Ryan365Apps/spotify-knob/design/Inspo/moodboard/README.md

# Moodboard — aesthetic references (2026-09-01)

What each reference contributes is captured in `../VISION.md` → "Aesthetic direction".

## In this folder ✔

| File | Reference | What it contributes |
|---|---|---|
| `kef-ls50-wireless-ii.jpg` | KEF LS50 Wireless II, mineral white ([source](https://www.richersounds.com/kef-ls50-wireless-ii-mineral-white/)) | Concentric machined ribs radiating from a circle (→ underside / speaker aperture); circle-in-a-box reads hi-fi, not gadget; luminous copper accent on mono body |
| `totem-machined-caps.jpg` | Totem Automobili GT Super — knurled machined reservoir caps ([source](https://totemautomobili.com/gt-super)) | The knurl + engraved-function attitude: machined jewellery that is all function-shapes. Closest stand-in for the pasted central-lock shot |
| `totem-steering-hub.jpg` | Totem GT Super — machined steering hub + gauges | Castellated/radial machining on a circular hub (→ top trim ring option) |
| `totem-gt-super-rear.jpg` | Totem GT Super rear, deep blue over black ([source](https://www.carscoops.com/2025/03/totems-alfa-romeo-gt-super-restomod-has-a-twin-turbo-670-hp-v6/)) | Restomod attitude: dark mass, minimal graphics, circular red lamp rings = luminous accent on monochrome body |
| `knurling-closeup.jpg`, `knurling-examples.jpg` | Knurling reference photos (Wikimedia Commons, free licence) | Diamond knurl pitch/depth reference for the knob's grip band |
| `saab-900-restomod.png` | Matt-black Saab 900 turbo restomod render, front + rear ("ETW" watermark) | **The attitude anchor.** Matt black mass, minimal graphics, one continuous red light bar = the halo ring, wrapped into a circle |
| `watch-chunky-bevel.png` | Skeleton watch, drilled chunky bezel, rose-gold dial accents | The wide 45° chamfer between texture and glass; drilled/castellated function-shapes; luminous warm accent on black |

## Still to drop in (originals not findable online — likely Instagram/AI renders)

| File | Reference | What it contributes |
|---|---|---|
| `knurled-thumb-nut.jpg` | Knurled aluminium thread protector (Amazon listing) | The knob's diamond knurl — watch-bezel coarseness, grip without aggression |
| `blue-spiral-puck.jpg` | Round-display desk gadget, blue anodise, spiral fluting | Proof of the round-screen-in-metal-ring form — and a warning: fluting + colour reads toy; we go knurl + monochrome |
| `watch-knurled-bezel.jpg` | Skeleton watch, knurled/clous-de-Paris bezel | Bezel texture + rose-gold accents living against matt black |
| `totem-alfa-central-lock.jpg` | Totem central-lock with Alfa badge (their Instagram) | Castellated radial machining; the exact "machined knob" hero shot |
