Ryan365Apps/spotify-knob/docs/v16/the60_v16/docs/V16-SPECIFICATION.md

# the 60 — version 16 specification

**Status: as-built specification for the v16 CAD.** This document describes every component and mechanism the v15 model contains, says which numbers are measured and which are assumed, grades every requirement, and separates what is true of the v10/v11 prototype only (Raspberry Pi 5) from what carries to production.

Revision: 8 September 2026 — **v16 = v15 plus the extra 5 mm of radius (Ø185.4, the rim 25 flat), bought V-groove bearings on a male V-ridge in the bore with the third wheel on a spring-loaded block (no eccentric bushes; the knob is fitted 2.4 off-centre and slid home), the halo as `HALO-OPTICS.md` (a 4 mm strip face down at a white floor behind a 3.9 mm machined opal ring standing 2 proud), a printed drive collar on the bell (the bell would otherwise cross the halo channel), the motion board replaced by bought breakouts on the plate and an ESP32-S3-Zero-class microcontroller on a tray over the audio board, every board on countersunk M2 studs from below with nuts above (Ryan's rule), the Pi powered through its header, the small parts of `SMALL-PARTS-SOURCING.md` (panel jack, Adafruit light-sensor breakout in a 56-wide port slot, Mill-Max spring-pin block, MT6701 module, Pololu converter), and the plate's ribs deleted.** v15 = v14 plus **the v15 brief** (`DESIGN-CHANGES.md` items 1–6, `THERMAL-PLAN.md` rules 5/7/8/10/11 as rewritten) and Ryan's rulings of 6 September: the plate re-proportioned to 2 web / 5 duct / 1 closing plate on piers; fins 5 tall; the stainless rim ring with 92 obround openings into an underside groove; **the blower fitted as a required part** (Delta BFB0305HA-C on the plate, the motion board on its saddle, a hood and a trench into the rear exhaust groove); the internal structure printed inverted on its flat seat, with dowel pins, a separate encoder shim and the bleed foot flat. Height unchanged. v14 = v13 plus **the design-changes list** (`the60-design-changes.md`): Pico-Lock connectors at 2.0 mm, the core's internal faces bare, the grounding features (chassis bond, rim-ring bond screw, motor bond lead, the knob's 1 MΩ bleed, the USB-C shell wire, the port face stated as an insulator), the halo current from the strip as built, the plain rim edge with the intake grooves opened to 514 mm², the vibration actuator's pogo-pin board and the rotor sensor lead's service loop. v13 was v12 plus **the encoder facing up at a code ring on the crown's underside** (Ryan, 6 Sep): no code band on the bore, no tower, the bell band back to its full contact, the wheels straight above it, the seat set by the adapter's HDMI socket at 26.0, height 35.9. v12 was v11 plus Ryan's deck-less layout: no mezzanine deck, every board on the plate, the display adapter's driver board on the Pi's standoffs, the code band and the wheels dropped to the bell band's limit, the seat 2.4 lower. Two facts from the adapter's datasheet (fetched this revision) are folded in: its holes are the Pi's 58 × 49 pattern, and the adapter is three parts (driver board, 150 mm flat cable, display connect board) — v10 and v11 wrongly had the panel flex reaching the driver board. Superseded text has been removed, not struck through. The v11 to v14 documents stay in `docs/v11/` to `docs/v14/` as delivered.

Tags, as in v9:

- **MEASURED** — taken from a CAD file by measuring it.
- **PUBLISHED** — stated by the manufacturer but not modelled here.
- **ASSUMED** — a number somebody chose. Reasonable or not, it is unverified.
- **GAP** — something the design needs that nothing currently provides.
- **v10-ONLY** — true of the desk prototype, not of the product. **PRODUCTION** — carries to the product.
- **MUST / SHOULD / COULD** — as v9.

---

## 0. What was measured for v10, and the three findings that shape it

New vendor files, now in `design/cad/bought-parts/vendor/`: the DisplayModule DM-TFTR50-413 panel STEP and datasheet, the Raspberry Pi 5 STEP and mechanical drawing, the Raspberry Pi Active Cooler product brief, the Raspberry Pi Compute Module 5 datasheet. Parts still **without a CAD body** (Ryan's rule: nothing is laid out around a part without one): the Active Cooler, the DisplayModule HDMI-to-DSI adapter board, the barrel jack, the internal HDMI ribbon cable and its plugs, the 12 V-to-5 V converter board, the cover lens, and the three boards the 60 makes (audio, motion, power). Each is drawn as a named `_ENVELOPE` body until its file exists.

**Finding 1 — the panel is not a circle, and that sets the diameter.** The DM-TFTR50-413 glass is a Ø132.2 disc with a **driver chin** at one edge: a 31.0 mm wide flat extension whose corners sit at **r 72.05 from the picture centre** (MEASURED from the STEP: the outline's furthest points are (±15.52, −70.36)). The knob rotates around the fixed panel, so the knob's bore must clear r 72.05 at every angle. With 0.45 mm clearance the bore is **Ø145.0**, and with the v9 knob wall of 4.5 mm the knob would be Ø154 (not Ø150; Ø150 needs an internal undercut, question 1, not recommended). **Ryan's ruling, 6 Sep: the knob's top must be a flat rim of at least 20 mm**, so the outside is set by the rim, not the wall; **8 Sep: the rim is 25** (the layout study: the plate needed the room, the display is fixed, so the whole 5 goes into the bezel): lip edge r 64.2 + 1.0 inner chamfer + 25.0 flat + 2.5 outer chamfer = **r 92.7, Ø185.4**. **This specification is written for Ø185.4**; the halo band stands 2.0 proud of it (Ø189.4). The top ring is 28.5 mm of metal, 29.2 mm from the picture edge to the knob edge.

**Finding 2 (v10) — superseded in v12.** v10 found that the Pi 5, the display adapter and the motor sector could not share one floor inside a Ø145 bore and built a mezzanine deck. Two things changed: the bore is Ø166.4 (finding 1), and the adapter's datasheet shows its mounting holes are the Pi's own 58 × 49 pattern, so **the driver board stands on the Pi on standoffs** and needs no floor of its own. v12 is **one level** (Ryan, 6 Sep): everything bolts to the plate; the adapter is the one part off that plane, on the Pi.

**Finding 3 (v10) — what still holds.** The Pi's tallest features are its stacked USB-A sockets at 16.2 above the board (MEASURED) and standing the Pi through a window in the plate is what removes height. **The cooler's fan is not fitted**; in v12 the adapter's underside is 1.2 mm over the heatsink's fins, so a fan has no room at all — the first print measures the passive Pi (section 6.9). **What sets v13's height is the adapter's HDMI socket** (23.68 + 0.3 + the 2.0 seat flange = 26.0). In v12 it was the wheels: their groove had to sit above the code band on the bore, and the code band above the bell band's contact zone, which starts at the knob skirt's bottom (14.9, over the halo's lip) — seat 28.0. With the code ring on the crown's underside the groove only has to clear the band, which would allow 24.2. Seat 26.0, knob top 34.4 — 4.8 below v11 (section 8.3).

---

## 1. What v10 is for

v10 is a printable object that lives on Ryan's desk while the software is written. It must hold the real DM-TFTR50-413 panel, a real Raspberry Pi 5 with its Active Cooler, the real knob mechanism from v9 (MY-3514C motor on its carriage, three 623ZZ wheels, AGFRC servo, AEDR-8300 encoder, LRA (linear resonant actuator, the click motor), speaker, halo), plug into a wall socket and into a PC by cable, and come apart again. It is not the product: the product runs a Compute Module 5 on a custom carrier, and every dimension that exists only to hold a full Pi 5, its cooler, the HDMI adapter and their cables is tagged v10-ONLY.

The first v10 print must prove (Ryan, brief): every part fits; everything can be secured; the knob turns; the Pi's heat has somewhere to go; the cables reach without fouling the mechanism.

---

## 2. Frame of reference and standing rules

**Coordinates.** Millimetres. **z** is height above the underside of the steel base plate; the rubber pad is below zero. **r** is radius from the picture centre. Azimuth is anticlockwise seen from above; **0° is the rear centre of the base, where the three sockets are, facing away from the user.**

**Standing rules carried from v9 unchanged:** the knob clears every static part by at least 0.40; running clearances 0.30; static fits 0.15; minimum printed wall 1.6; no overhang beyond 45° on a functional surface; M2.5 heat-set inserts; no glue but the pad; everything re-openable; connectors, never solder, between assemblies; every dimension in one parameter block, every number tagged; every check automated; the checker proves the assembly order. The part determines the design: nothing is laid out around a part that has no CAD body.

**Withdrawn by the v10 brief:** the 40 mm height limit (height is derived, section 8); the Ø135 diameter limit; the halo brightness cap.

---

## 3. The object — requirements in force

| Requirement | Value | Grade | Origin |
|---|---|---|---|
| Diameter | **Ø185.4** knob and plate (Ø189.4 at the halo band): the outside is set by the 25 mm top rim (Ryan, 8 Sep: the extra 5 mm bought the plate its room); Ø150 was the nominal and is not reached | MUST (ruling) | brief; 6 Sep; 8 Sep |
| Height | derived: **35.9** v13 with the pad (knob top 34.4; v12 37.9, v11 40.7); **34.1** production with the CM5 (the wheels' floor); the stack and what decides it are in section 8 | report | brief |
| Mass | more is better; the three-piece plate ≈ 498 g (steel rim ring 334 g at the largest radius) — see 4.16 | SHOULD | brief; 4.16 |
| Knob | one piece, no seam or screw; the majority of the visible side (v10: 62 % — the 5.5 mm halo band and the 8 mm plate both come out of the knob); diamond knurl; wide smooth 45° chamfer at the top outer edge; small smooth chamfer at the lens; touches nothing but its three wheels, never the display | MUST | brief; v9 |
| Top ring | a flat rim of **at least 20 mm** on the knob's top (Ryan, 6 Sep): 23.5 of metal from the lip edge — 1.0 inner chamfer, 20.0 flat, 2.5 outer chamfer — 24.2 from the picture edge to the knob edge; `v11_top_ring.png` | MUST | 6 Sep |
| Display | DM-TFTR50-413 bare panel, picture Ø127.0, behind a round cover lens carrying a bonded 10-point capacitive sensor, specified separately (4.2, 4.3) | MUST | brief |
| Computer | v10: Raspberry Pi 5 + the Active Cooler's heatsink (fan off, finding 3), powered through its 5 V header pins, its USB-C free for the PC. Production: Compute Module 5 on a custom carrier | MUST | brief |
| Sockets | three openings in the base wall at the rear, at plate level, below the halo: **12 V barrel inlet, USB-C data to the PC, 3.5 mm line out**; plug bodies drawn, not just sockets (section 6.8) | MUST | brief |
| Audio | own board (XMOS + converter, ~25 × 40); 3.5 mm is line out to powered speakers, no amplifier; speaker carried from v9 | MUST | brief |
| Motion | motor, encoder, LRA, servo and LED ring on their own microcontroller board (size proposed in 4.13) | MUST | brief |
| Halo | full 360°, on the fixed base, its bottom edge the plate edge; a bought LED strip face down under a ledge (HALO-OPTICS, 8 Sep) lighting a white floor in a 4.4 channel behind a 3.9 machined opal ring standing 2.0 proud of the Ø185.4 edge (4.8, 5.3); driven hard — see 4.8 for the watts | MUST | v9; brief |
| Perimeter port ring | stays; must also vent the computer's heat — adequacy in 6.9 | MUST (acoustic) / SHOULD (vent) | brief |
| Power | dedicated mains supply, external brick; proposal in 6.8 | MUST | brief |
| Assembly | upside down, knob → display → structure → plate → pad; no glue but the pad and the display's bonding tape (Ryan, 5 Sep); re-openable; connectors not solder | MUST | brief |
| Bench display | the Waveshare 5-inch HDMI round touch display (150 × 150 × 7) stays on the bench, not enclosed | — | brief |

---

## 4. Bought components

One entry per part: the body, where it sits, what the made parts must provide, gaps. Parts carried from v9 unchanged are listed with only what changes.

### 4.1 DisplayModule DM-TFTR50-413 — the panel (PRODUCTION)

Body: `vendor/DM-TFTR50-413.STEP`, MEASURED: a 1.98 mm glass, Ø132.2 disc, active picture Ø127.0 centred, borders 2.6 at the sides, 2.67 at the top; **driver chin** at the bottom: 31.0 wide flat at r 70.36, corners at r 72.05; **FPC tab** at the top: the outline is 20.0 wide there, and the flexible printed circuit (13.99 wide, 0.15 thick, PUBLISHED from the drawing) runs from the back-side component area up the back of the glass, over the top edge, and 45.84 mm beyond the outline to a 45-way 0.3 mm pitch gold-finger end with a 4.28 mm stiffener. Small 5 mm locating ears at the two side extremes of the horizontal centreline. Back-side component area 60.0 × 68.4, components up to **1.5 mm** proud of the glass back (PUBLISHED, drawing). Weight 70 g. No mounting holes; no touch. Controller HX8399-C, 4-lane MIPI-DSI (a serial display interface with four data lanes), 1.8 V logic, ±5 V analogue rails, backlight 12 white LEDs in series at 37.2 V, 20 mA (0.75 W) — all PUBLISHED.

Where it sits: glass back at **z 31.3** (section 8), picture centre on the axis, the chin at **180°** (toward the user, under the knob wall — invisible) and the FPC tab at **0°** (rear), ASSUMED, so the flex reaches the adapter over the rear crescent. Picture orientation is software.

What the made parts must provide:

| Provision | So what | Grade |
|---|---|---|
| A **seat** on top of the structure wall (r 62–82.8, top face z 26.0) that the display module **bonds to** with a 0.5 mm double-sided foam tape (ASSUMED) under the glass edge at r 62.5–65.6 — the glass never rests on a hard edge; the module comes off by peeling the tape | the panel has no holes; the knob must not hold it; glue is allowed for the display (Ryan, 5 Sep). A screwed carrier ring was designed and dropped: under the glass it can only be 1.5 mm thick and outside the glass the wall is 0.2 mm away, so it has nowhere for threads | MUST |
| A **32 × 2.5 mm slot** through the seat at 0° (offset 4 mm) for the panel flex and the touch tail, edges radiused 1.0 | the flex runs out past the glass edge and drops through here to the display connect board under it | MUST |
| Centring: three Ø2 nubs on the seat at 60/210/330° locate the Ø132.2 glass to ±0.15, under the lens overhang | the picture must be concentric with the knob within the 0.7 mm the lip hides | MUST |
| The knob's bore clears the chin corners by 0.45 (Ø145.0) | finding 1 | MUST |

**Gaps:** the exact chin outline is the STEP's; the datasheet's 66.10 dimension at the bottom does not match the STEP's 31.04 flat — the STEP is used, verify on the real glass (GAP). Whether the panel can be bought bare in ones (Ryan's question — see 4.4 for the fallback).

### 4.2 Cover lens with bonded touch sensor — specified separately (PRODUCTION)

**No CAD body. ASSUMED throughout:** round, **Ø140.0**, 2.5 mm thick, black-printed border from the picture edge outward, bonded to the panel's front face by its supplier (a perimeter adhesive gasket or full optical bonding — that bonding is part of a bought sub-assembly, not glue in the 60's assembly). The touch sensor's tail is a second FPC, ASSUMED 8 mm wide, exiting at the same edge as the panel's tab. The lens overhangs the Ø132.2 glass by 3.9 all round except at the chin, which stays exposed.

Why Ø140 and not 135: the seat's locating nubs sit under the lens overhang, and The lip hides everything outside Ø128.4, so the lens border (r 64.2 to 70) is invisible. Range acceptable: Ø135 to Ø140.5 (the structure wall's inner face is r 70.5).

**Gaps:** every number above. The lens is a question for its supplier; this specification only fixes what the knob and the structure need from it: outside diameter, thickness, border width, tail position.

### 4.3 DisplayModule HDMI-to-DSI adapter DM-ADTTR-014 (v10-ONLY)

**No CAD body; drawn from its datasheet** (`DM-ADTTR-014_datasheet.pdf`, section 1.5.1, fetched 6 Sep). PUBLISHED: a **kit of three parts** — "one driver board, one FPC cable, one display connect board". Driver board 65.0 × 64.0; four Ø2.8 holes 3.5 from the HDMI edge and from both sides, 11.5 from the flex-connector edge — **the Raspberry Pi's 58 × 49 pattern**; HDMI-A socket 15.7 wide × 10.5 deep, centred 0.5 off the board's middle on the HDMI edge, 0.8 proud of it, **7.3 tall**; micro-USB 5.5 × 5.7 beside it (20.25 over); 60-pin 0.5 mm flex connector 35 wide × 4.5 deep, 1.2 inside the opposite edge; two 3.6 × 6 buttons on the left edge (4.1 tall); 4.5–5.5 V supply. Flat cable 150 × 30.6 × 0.34. Connect board: photographed, not dimensioned — ASSUMED 30 × 46 × 1.2 with corner holes, CN2 for the panel's flex on one long edge, CN1 for the 60-pin cable on the other. ASSUMED on the driver board: 1.6 board, 2.5 of general parts, 1.0 of underside parts, the connector 2.0 tall.

Where: **the driver board on four M2.5 × 12 hex standoffs on the Pi's holes**, its left edge on the Pi's SD end (x −52..13), its HDMI edge over the Pi's HDMI edge (y −38, both sockets facing 270°), its flex-connector edge toward 90° overhanging the Pi's header edge by 8 (y 18–26, 0.28 above the servo's frame). Board 14.78–16.38; underside 1.2 over the heatsink's fins; HDMI socket top 23.68 — the tallest thing under the seat and, in v13, what sets it (26.0). The touch controller stacks on it at (−33, −17) on 3 mm standoffs. **The connect board** lies on a printed bracket over the port slot at (60.5, −4), r 45.5–75.5, z 13.0–14.2, its CN2 opening outward 8 mm from the panel flex's drop line at t −12 (the flex comes down at r 67.9, passes 1 mm over CN2, folds down at r 77 and enters it) and its CN1 opening inward; the flat cable runs inward at 15.2, up beside the Pi's USB-A shells, over them at 19.5, folds 45° toward 90° over the servo, Z-folds back toward 270° one width across and drops onto the driver board's connector — about 95 of the 150 mm used, the rest slack. **Why not flipped** (Ryan's suggestion): the socket would hang into the space over the Pi's SD end and the cable would have to enter a downward-facing connector. In v13 the socket does set the seat, so a flip would now buy 1.2 mm (the touch board on the adapter becomes the ceiling at 22.4, seat 24.8) — question 19, not built. **Gap:** measure the connect board and confirm its CN2 mates with this panel's 45-way 0.3 mm flex (GAP; the bracket's bosses move to its real holes).

### 4.4 If the bare panel cannot be bought

State it plainly rather than enlarge the object: v10 is built with a **dummy display disc** — a printed Ø132.2 × 1.98 plate with the same chin and FPC tab (from the STEP) and a Ø140 × 2.5 clear acrylic lens — so every mechanical proof in section 7 still happens, and software runs on the Waveshare bench display. The dummy is one line in the parameter block. Nothing else changes.

### 4.5 Raspberry Pi 5 (v10-ONLY)

Body: `vendor/rpi5/rpi-5b_no_graphics.step`, MEASURED: board 85 × 56 × 1.28; four Ø2.7 holes at (3.5, 3.5), (61.5, 3.5), (3.5, 52.5), (61.5, 52.5); two stacked USB-A pairs 16.2 above the board top at x 70–88 (overhanging the board edge by 3.1); Ethernet 13.3; SoC 16.9 × 16.9 at x 24.7–41.6, y 14.3–31.2, top 2.34 above the board; USB-C at x 6.7–15.7 on the y = 0 edge, 3.29 tall; two micro-HDMI on the same edge; 40-pin header along y 50–55, x 7–58, 8.5 tall; micro-SD slot 1.45 below the board. Where: in the plate window, long axis along 0°–180°, USB-A/Ethernet end toward **the rear (0°)**, USB-C/HDMI edge toward **270°**, header edge toward 90° (the motor side); **at (−52, −38)** — v12: 9.5 further from the ports and 10 toward 270° (Ryan's layout; his picture had it ~35 over, which puts its corner outside the wall), its far corner at r 64 inside the duct; board 1.5–2.78, **carried by four lands of the closing plate** (4.16) on 0.5 washers, M2.5 × 6 countersunk from below into the standoffs that carry the adapter (4.3).

Provisions: the plate window (with notches for the USB-C receptacle's own body — v16: no plug, the Pi is powered through its header — the HDMI plug and the audio board's USB-A plug in the **lower socket of the USB 3.0 stack**); the closing plate's four lands; four M2.5 × 12 standoffs (PUBLISHED, 5 across flats); a 2 × 5 crimp housing on header pins 1–10 (5 V, GND, UART — a plain two-wire serial link) for the microcontroller's tray (4.13) and the Pi's 5 V in, 9 tall on the header — the adapter's underside is 0.5 above it; the internal USB-C lead to its USB-C socket (6.8) — **an up-angled plug** (ASSUMED head 12 × 12.5 × 6.5 beyond the edge, lead straight up): a straight plug reaches r 75 through the ring at the new position and a right-angled one collides with the HDMI plug; the HDMI ribbon from its **HDMI1** socket (4.15; HDMI0 sits behind the USB-C plug's head); the audio board's USB in the upper rear USB-A socket through a right-angle plug (ASSUMED 9 mm protrusion). **Gap:** feeding 5 V on the header while the PC's USB-C is plugged in parallels two 5 V sources — see question 6 (VBUS (the USB cable's 5 V wire) cut in the internal cable, or an ideal-diode on the header feed).

### 4.6 Raspberry Pi Active Cooler — heatsink fitted, fan not (v10-ONLY)

**No CAD body.** PUBLISHED (product brief, verified this revision): 63.50 × 42.50 footprint, **13.70 total height** from the heatsink's underside to the fan's top, fan 30 × 30, 1.09 CFM (cubic feet per minute) (0.51 L/s) maximum, 8000 rpm, temperature-controlled from the Pi's fan header, push-pin mounted, not designed for removal. The brief's "30" that read as a height is the fan's footprint. ASSUMED: the heatsink underside sits 2.8 above the board (SoC 2.34 plus pad); the fins' top 7.0 above that (ASSUMED split of the 13.7) = **z 12.6**; the footprint from Pi x 2.5 to 66, between the USB-C edge region and the USB-A shells. **The heatsink is fitted and the fan is not** (finding 3): in v12 the adapter's underside is 1.2 mm above the fins (with 1.0 of underside parts assumed), so the fins' air leaves sideways under the board; the SoC cools by the fins into the cavity. Adequacy: V12.md bench item 1 — if it throttles, 15 mm standoffs (the seat allows 2.3 more) or option B (8.4).

### 4.7 Motor, drive collar, carriage, servo, wheels, sprung block, encoder, LRA, speaker

MY-3514C on its 4.2 mm carriage through the plate (motor z 4.2–18.2, bell from z 8.5 ASSUMED); AGFRC servo pushing the carriage, 2.4 mm lift; **three V623ZZ-class V-groove bearings on Ø3 dowel pins** (v16); AEDR-8300 on a 0.15 recessed code ring under the crown; Vybronics LRA with the Mill-Max contact block; Soberton SP-4005-1 cone-up; the **MT6701 module** (15 × 17, `SMALL-PARTS-SOURCING.md`) in the carriage's 17.4 × 15.4 pocket. What v16 changes with the bore at r 88.2:

| Item | v15 | v16 |
|---|---|---|
| Drive | the bell's own surface with a 0.6 band, motor at r 65.7 | **a printed drive collar** — ID 35 (0.05 interference) pressed on the bell's top 3.5, OD 39.4, PETG (POM in production), 0.3 lead-in — carries the band at z 14.9–17.8 and meets the bore over all of it; motor centre **r 68.5** engaged, 66.1 released. The bell itself reaches r 86.0: inside the wall's outer face (86.4) and 0.5 inside the halo channel's liner. Why: at the Ø176.4 bore a Ø35 bell on the bore reaches r 88.8 over z 8.5–18.2 — through the halo channel (r 86.4–90.8, z 8–13.5). Ratio bore/collar **4.48 : 1** (v15 4.75) |
| Wheels | 623ZZ in printed V-collars on eccentric bushes, a 90° V-groove in the bore | **V623ZZ class 3 × 12 × 4** (PUBLISHED class; the V's depth 1.2, root flat 0.4 and 90° ASSUMED until Ryan's listing is measured — question 36) straddling a **male V-ridge on the bore**: crest r 87.3 × 0.8 flat, 90° flanks to a 3.2 base on a 0.3 relief band (r 88.5, z 19.3–23.7), the ridge z 19.9–23.1; the crest is narrower than the V's root by 0.4 so the flanks meet with 0.2 between crest and root; the bearings' Ø12 rims run 0.2 inside the relief band and never touch the bore. Axis r 82.3, z 19.5–23.5. Two on **fixed Ø8 posts at 30 / 150** with Ø3 m6 × 10 pins pressed 5.5 deep and an M3 × 0.5 washer under the inner ring; the third on the block below. The wall gets a 14-wide window above each, open to the top; the seat flange is cut away above each |
| The third wheel | eccentric bush, hex-adjusted from below | **a sliding block at 270** (RULING 8 Sep, a slot rather than an arm): 13 × 8 × 5 printed, on the plate top in a printed channel that is part of the structure (walls 2, roof 0.8 with a 3.2 slot for the Ø3 × 16 axle pin — its ends are the stops, 4.0 in / 0.5 out — and an end wall at r 58–60), a Ø4 × 16 spring (ASSUMED 0.8 N/mm: **4.0 N seated**, 7.2 parked, 3.6 at the outer stop) on a **captive M2 × 18 release screw** through the end wall into an M2 nut in the block. Wound in, the screw pulls the block 4.0 toward the centre (the wheel then reaches r 84.3); backed off, the spring pushes the block home and the thread stays in the nut at every position. The screw's head is on the centre side of the end wall at r 56.7, reached with an L-key through the display opening before the display goes on — the crown covers everything at r > 64.2 once the knob is fitted, which is why the release cannot be from above (checker: a Ø4 lane) |
| Fitting the knob | bushes retracted 1.8 | **the knob goes on 2.4 off-centre toward az 90** (the fixed wheels' bisector: each is 60° off it, so the ridge moves 1.2 outward at both — 0.2 past their rims), descends to its final height, and slides to centre with the ridge entering the grooves flank on flank; the block is released last. On the far side the ridge's crest comes in to r 84.9 and the bore to 85.8, which is why the wall steps in above the halo ledge (5.2). Checked at five heights and three offsets |
| Motor azimuth | 90° | 90°; the servo lies on the plate at r 21.8–43.2 inboard of the carriage, in its floorless frame, pushing the 3 × 10 × 14.5 tab; 2.4 mm lift, 2.4 N |
| Code ring | r 72.5–79.5 under the crown, read at 310° | unchanged, read at **335°** (310 sat over the MCU tray's studs); 6,000 lines per turn |
| Speaker | (−36, 47) | unchanged |
| LRA | 258°, pogo board 7 × 8 in a clip at 252.5° | 258° on a pad from the upper wall's inner face (r 81.55) to the wall; **the Mill-Max 867-22-002-70-501010 two-position spring-pin block** on a 7 × 8 × 1 carrier in the v15 clip at 252.5° (ribs from r 74.5), its two pins (ASSUMED Ø1.5, 2.2 compressed) on the flex tail's pads at r 81.2, z 11.75 and 14.35 |
| Rotor sensor lead | to the motion board | as v15 out of the carriage, up beside the tab, its 12 mm loop over the servo frame — then a harness lead to the tray (no motion board) |

### 4.8 Halo — a bought addressable LED strip face down under a ledge, a machined opal ring (PRODUCTION; `HALO-OPTICS.md`, accepted 8 Sep)

**The v15 arrangement (a strip on the wall 0.2 from the diffuser) showed the LEDs as dots and the diffuser was 0.9 thick at its foot; HALO-OPTICS replaces it.** The strip (ASSUMED **4 mm wide, 1.2 thick**, 2020 top-firing parts, ~100 LEDs per metre) is stuck **face down to the underside of a ledge on the structure** at r 86.6–90.6, its emitting face at z 12.0, and fires at a **white floor** 3.6 below: a printed white PETG L-liner (0.4 floor on the ring's top, 0.6 wall up the structure's wall to z 11.4 — the channel's floor and inner wall are then white and diffuse; bare stainless is specular) in a **4.4-wide channel** (r 86.4–90.8, z 8–13.5). The diffuser is lit only by light returning from the floor; no LED is in its direct view (the ledge is between). The **opal ring** (5.3): r 90.8–94.7, **3.9 thick**, z 7.5–13.2, standing in a 0.5 rebate on a 0.8 shelf on the rim ring that stands **2.0 proud of the knob and plate (Ø189.4)**, clamped axially by the lip (z 13.5–14.3, out to r 92.7) through a 0.3 foam gasket, with **0.3 radial clearance** to the ledge (PMMA's expansion over Ø189 and 20 K is 0.2 on diameter — never an interference fit). The throw is 3.6 to the liner's floor (HALO-OPTICS asked 4.0 to a coated ring top — the coating is the alternative; bench). The motor's bell passes through the wall's window inside the channel 0.5 from the liner's wall (4.7). **The strip's two feeds** through notches in the wall's foot: the three-wire tail at its joint at **az 325** straight inward to the level shifter beside it (4.13); a two-wire 5 V feed for the far end at **az 190** from the converter 10° away (question 32 closed: nothing passes through a board).

**Driven hard, in watts** (`HALO-BRIGHTNESS.md`): 48 mA per LED at full white. As drawn, 557 mm at r 88.6 at 100/m = **55 LEDs, 2.64 A / 13.2 W** — HALO-OPTICS §5 wants 60 or 120 settled on the bench (120 = 5.76 A; the Pololu's 9 A covers it). No sustained cap: firmware limits a ten-minute rolling mean. The heat now lands on the printed ledge (HALO-OPTICS: an aluminium ledge or firing up at the stainless ring are the fallbacks if the bench objects).

### 4.9 Perimeter ports, port face, light sensor, USB-C receptacle, 3.5 mm jack, DAC (digital-to-analogue converter) — carried

Vents: **vertical slits** 1.0 wide × 4.5 tall (z 18.5–23.0, between the drive band and the seat) on a 2.5° grid all round the upper wall, 98 of 144 positions cut (the motor's relief, the pillars' and posts' webs, the block channel and the LRA pad take the rest): 441 mm², passive (6.9). Ryan's review, 5 Sep: slits, not round holes. GCT USB4520 mid-mount USB-C receptacle (CAD body exists) on its small board — **its shell goes to the chassis bond by a short wire** (modelled; `GROUNDING.md` 6); it is the **microcontroller's host link** (the Pi's USB-C carries no data). v16: a **panel-mount 3.5 mm jack** (`SMALL-PARTS-SOURCING.md`; bushing through a Ø6.3 hole in a 3 mm boss on the face's inner side, its nut outside, body ASSUMED Ø9 × 14; no jack board) — **its shell MUST stay isolated from the chassis**, which is why **the port face is, and must remain, an insulator — a printed plastic part; a metal port face is not permitted** (`GROUNDING.md` 6, a stated requirement). v16: the **Adafruit 4162 VEML7700 breakout** (PUBLISHED 16.6 × 16.5) standing vertically in a 5.3 mm slot holder on the face's inner side, its sensor (ASSUMED 3.0 from its bottom edge, from Ryan's photograph) at the face's Ø4.8 hole at z 4.0, the board rising free to z 17.5; a pocket through the holder takes the 6.8 × 2.4 × 3.0 package. For it the **port slot is 56 wide** (v15 44): barrel at t −18, USB-C −6, jack +6.5, light +19.5; the exhaust arcs and the two ring screws beside the slot moved with it (4.16).

### 4.10 Barrel power jack — CUI PJ-063AH (PRODUCTION, part proposed)

**No CAD body yet** (Same Sky offers one — fetch it before CAD). PUBLISHED: 2.0 mm centre pin (5.5 × 2.1 plug), **24 V 8 A** rated, right-angle through-hole. ASSUMED body 14.4 × 9.0 × 11.0, socket axis 6.5 above its board. Where: rear port slot, at 0° −15 mm tangential, on a small **vertical** board (tangential plane) so the barrel's axis height is free — axis at **z 3.5**, the plug body from z −0.75 to 7.75, under the halo's bottom edge (z 8.0) by 0.25 and into a through-pocket in the pad. Why a barrel and why 12 V: section 6.8. Plug body: a **right-angle 5.5 × 2.1 plug, Ø8.5 body** (ASSUMED) — a straight moulded plug on a 12 V brick is Ø10–11 and does not fit under an 8 mm plate's top edge; the cable leaves the object sideways along the rear wall.

### 4.11 12 V → 5 V converter — Pololu D24V90F5 (PRODUCTION as a function; v16 as the bought module)

**Pololu D24V90F5** (`SMALL-PARTS-SOURCING.md`): PUBLISHED 40.6 × 20.3; height ASSUMED 7.6 (its inductor); 9 A. **On the plate** (thermal plan rule 15) in the front crescent at az 180°, tangential (40.6 along the arc), r 57.35–77.65 — its inner edge 5.3 clear of the adapter's edge at x −52, its outer edge 7.2 inside the wall — on a 0.5 thermal gap pad (the one adhesive besides the pad and the display tape), **two countersunk M2 studs from below** through its holes (ASSUMED at ±16 on its centre line) with nuts above; r 67.5 puts the studs' islands at r 69.4, inside the intake tunnels. Feeds: the Pi's header (5 A peak; the header's 5 V pins are the input), the halo (2.64 A as drawn, up to 5.76 at 120 LEDs), the adapter, the audio board, the breakouts and the MCU. The motor driver stays on 5 V.

### 4.12 Audio board — XMOS USB audio + ES9219Q (PRODUCTION as a function)

**No CAD body.** Ryan's envelope: **25 × 40**; 1.6 board + **2.0 mm Molex Pico-Lock 1.50 right-angle connectors** (`CONNECTORS.md`) and the 4.0 mm moulded plug of its pre-made USB lead. Where (v16): **on the plate at az 297°, r 62**, tangential (40 along the arc), on 1.0 printed spacers over **four countersunk M2 studs** (its holes ASSUMED at ±12 × ±6.5 — 8 in from the short edges, 6 from the long: **the pattern is what keeps its outer studs at r 69.5, inside the intake tunnels' radius**, and its west edge 1.9 clear of the block channel's wall at 270, its inner edge 1.5 clear of the Pi's Ethernet shell; lay the board out to it), nuts above; **the MCU tray stands on the same four studs** (4.13). Connections: USB to the lower socket of the Pi's USB 3.0 stack (the plug on the board's west end); line out to the panel jack (three leads); the speaker (two). The lens's touch controller board stacks on the adapter at (−33, −17) on 3 mm standoffs, 4.12a: ASSUMED 30 × 20 × 3, USB to the Pi.

### 4.13 Motion electronics — bought breakouts on the plate, the microcontroller on a tray (v16; `FUNCTION-ALLOCATION.md`, `SMALL-PARTS-SOURCING.md`)

**The motion board is gone.** Its jobs: **TMC6300-BOB** motor-driver breakout (PUBLISHED 25.4 × 20.3; two M2 holes ASSUMED at its short ends — if the real board has none it goes in a pocket under a keeper like the MCU; 2.0 of parts, right-angle header strips 3.0 tall with the housings lying flat along both long edges) **on the plate** — it is the heat part — at az 250°, r 57, its long axis along y, centred (−19.5, −53.6): 3.1 from the block channel's wall, 3.3 from the haptic breakout, its outer end 1.9 inside the LRA clip's ribs, the HDMI ribbon 0.8 over its headers. **DRV2605L haptic breakout** (Adafruit 2305 class, 20 × 15 and two holes ASSUMED) on the plate at az 228°, r 64, its long axis along x, centred (−43, −47.5): 2.0 south of the adapter's edge, 2.6 off the Pi's corner standoff. **74AHCT125 level shifter** (Adafruit 1787 class, 20 × 15 ASSUMED; its two holes drawn across the board near its inner end — what keeps both studs inside r 69.8) on the plate at az 322°, r 69.5, parallel to the audio board's east edge: 1.5 from the audio board, 1.6 from the connect bracket's foot, 1.5 from the structure (the pillar moved from 320 to 328 to make its room); it takes the LED data from the Pi's header and the halo's tail comes to it through the notch at az 325. Each on 3.0 printed spacers over countersunk M2 studs from below, nuts above. **The microcontroller**: an **ESP32-S3-Zero-class board** (PUBLISHED 25 × 18, no mounting holes; USB-C ASSUMED 3.2 tall) lying across a printed **tray** (40 × 30 × 1.2 at z 16.6–17.8) that stands on the audio board's four studs on 4.4 tube spacers above the audio's nuts; the board sits in a 0.6 pocket between the four stud nuts and a printed **keeper** frame (1.2) clamped by the studs' top nuts holds it by its edges — no screw touches it; its USB-C faces inboard through the keeper's open end, top at z 21.3 (the seat flange is at 24). **RULING pending (question 33)**: Ryan has a Pico 2 with headers; the layout study's tray over the adapter is where the flat cable's Z-fold lives, and a bare Pico 2 (51 × 21, connectors 3.2 tall) over the audio board reaches the flange. Talks to the Pi over UART on the header; the external USB-C is its host link. The motor phases (about 100 mm), the rotor sensor lead, the servo, the encoder, the haptic breakout's I²C and the level shifter's data are harness leads (`SMALL-PARTS-SOURCING.md`: whatever is easy, cheap and fits).

### 4.14 Mezzanine deck — gone in v12 (Ryan, 6 Sep). See 5.4 for what replaced it.

### 4.15 Internal HDMI ribbon (v10-ONLY)

**No CAD body.** ASSUMED: a 20-way 0.5 mm pitch flat flexible HDMI cable, 200 mm, with a micro-HDMI **up-angle** plug board at the Pi end (12 × 8 × 5) and an HDMI-A plug board at the adapter end (21 × 12 × 6). Route as built (v12): from the Pi's **HDMI1** socket at z 2.8–7.8 on the 270° edge, up out of the micro plug, outward along 1 mm over the plate top to 3.5 beyond the A plug's tail, up to the adapter's socket height (20.0), and back into the A plug's tail — the two sockets face the same way 9 mm apart, so the ribbon is a loop of about 60 mm; three folds, all static, all modelled. A round moulded micro-HDMI cable needs a 25 mm bend radius and 12 mm plug bodies and does not route in this height; the ribbon is the design.

### 4.16 Base plate — the heatsink: aluminium core, stainless rim ring, closing plate (PRODUCTION; `THERMAL-PLAN.md` section 14 as rewritten for v15; Ryan's rulings: stainless ring, the blower required)

Three machined pieces, Ø185.4 flush with the knob (the ring's 0.8 shelf under the opal ring stands 2.0 proud at z 6.7–7.5), 8 mm at the rim, the object's height unchanged (rule 6).

**The aluminium core**, r < 78.8 (v15 75.2: +3.6 with the wall), 6082, **external faces black hard anodised; every internal face chromate-conversion coated or bare — no masked pads anywhere**; the closing plate's outer face stays black. In section (v15, rule 5): a **2 mm web** (z 6–8), a **5 mm duct** (z 1–6) and a **1 mm closing plate** flush in a recess (z 0–1) on a **0.2 die-cut gasket** (ASSUMED) in a groove of the recess floor — on the duct's outer wall and the walls round the three through-cuts — screwed on with **nine** M2.5 countersunk screws on full-depth Ø7 islands (the two in the channel bands, at (0, 45) and (0, −57), have cross-cuts either side so the channels they block are joined to their neighbours); the free span of the 1 mm plate is about 30 mm (v14: 60). **Every screw from the top lands on a Ø7 pier hanging 2.5 into the duct** (z 3.5–6): 4.5 of metal for a 3.5 tapped blind hole, 2.5 of duct left under it so the channel it stands in runs on — the thickening goes downward only, nothing above the web moves (rule 5): 6 × M2.5 (servo frame 2, connect bracket 2, speaker cradle 2 — v16: the boards no longer thread into the plate), 2 × M2 (the blower's through-bolts) and THE chassis bond's M2.5 at (48, 27) (`GROUNDING.md` 3; star washer, ring terminal; the production carrier's star point). A rebate r 75.8–78.8, z 5–8 takes the ring's flange on a 5 mm shoulder; seven M2.5 countersunk screws from below through the shoulder hold the ring at r 77.3 (v16: the two beside the port slot at 26 and 334 — the 56-wide slot's walls broke into the 22.5 / 337.5 heads); **the rim ring's dedicated bond screw** (`GROUNDING.md` 4.1) is tapped M2.5 3.0 into the shoulder's top face at az 67.5, r 77.3. **v16: twelve Ø2.2 holes through full-depth Ø7 islands for the boards' countersunk M2 studs from below** (audio 4, driver breakout 2, haptic breakout 2, level shifter 2, converter 2), the fin channels cross-linked round every island; every island lies inside r 73.3, where the intake tunnels start (the lands between tunnels are too narrow for one — this is what placed the boards). Through it: the Pi window (with notches for the USB-C receptacle's own body, the HDMI plug and the USB-A plug — v16: no plug-head notch, the Pi is powered through its header), the carriage hole, the port slot (56 wide) from r 55 — each with a 2.5 mm solid wall round it. **Its top face is flat: the two v15 ribs are deleted** (Ryan, 8 Sep: negligible stiffness, and they stopped the part being flipped). **Deflection under knob load: nil** — the knob's load never crosses the web: the knob rides on the wheels on the structure's wall, the structure stands on the plate at its wall foot and its pillars at r 80.8, all inside the solid rim (r ≥ 78.8); the web carries the boards and the servo. Mass: core ≈ 122 g + ring ≈ 251 g + closing plate ≈ 29 g ≈ **402 g** (v15 341: the 5 mm of radius).

**The duct** (rules 7–12): air enters through the ring's **92 edge-face openings and the 0.8 undercut** (below) into the ring's underside groove; from the groove through **18 intake passages 9 wide × 3.5** on the v14 grid at 11.25° (567 mm² of throat, inside the asked 500–700; the ring screws stay on the grid's lands; the two that would land on the motor's through-hole are omitted — v16 has no USB-C notch to avoid) — grooves across the ring's inner land closed by the pad, then **closed tunnels z 1–4.5 through the core's shoulder and the duct wall** (v14 cut them open to the underside, which joined the intake to the space under the plate); into a **collector** r 69.6–73.8 round the front and sides (az 61–310); through **21 straight fin channels 3 wide × 5 tall on a 4 mm pitch**, finned end to end — thirteen on the +y side and eight on the −y side of the off-centre Pi window, front to rear (item 2 asked for fins only over the compute module and the converter; neither sits over a channel: the Pi is in a window through the duct, the converter over the front collector; with a blower fitted the 8 Pa the full fins cost is not the constraint); into the **rear plenums** (r 58.6–73.8, az 22–66 and 308–338). **The +y side is fanned**: the plenum feeds the blower's inlet through a Ø22 hole in the web, and the blower discharges through the hood and a **trench cut from the top** — 18 wide, z 1–8 (126 mm²), from r 70.4 out through the duct wall and the shoulder, widening between az 37 and 56 through a notch in the ring's flange and its inner land into the ring's 21–60 exhaust groove (to r 83.0, 0.5 into the groove) — walled off from the suction side by 2 mm at r 68.4–70.4, every vertical corner of the trench rounded R2.5 (a Ø5 cutter's own corner — the turns cost less); a clear Ø26 pocket in the duct under the blower's inlet, no fins across it (Ryan's review: fins there earned about 5% of the surface and throttled the inlet); the duct is solid outside r 68.4 between az 40 and 61 so no channel end or the collector meets the trench, and the channels that ended there stop at r 68.4 in the plenum. **The −y side is pulled in reverse**: its two exhaust passages 10 wide at 310/318 (v15 three at 311/320/329: the pillar screw at 328 and the ring screw at 334 took the third's room) and the 300–339 openings become an intake under the blower's suction, so its eight channels see forced flow too. The checker requires the air to be exactly two bodies — suction and discharge — with the discharge never touching the inlet. No opening through the plate's top face but the two under the hood, both gasketed (rule 9).

**The stainless rim ring**, r 78.8–92.7 × 8 (with the 0.8 shelf to r 94.7 at z 6.7–7.5 and the 0.5 rebate from r 90.5 for the opal ring — HALO-OPTICS; the shelf sits 0.35 above the openings' chamfered tops and does not shadow them), 304 or 316, **finished bare — electropolished after machining (which gives every opening mouth and both edges their 0.3 × 45° polished chamfer), then brushed axially on the edge face** (design-changes item 5; `GROUNDING.md` 4.1 closed: no masking, the star washer cuts through). Its outer wall is 3.7 thick (r 89–92.7) and carries the decoration, which is the venting (item 3): **120 positions on 3°, az 1.5 + 3k, mirrored about 0–180 by construction**, with an obround opening 2.0 × 4.5 (z 1.55–6.05) at every position that has the groove behind it — **64 intake over 60–300 (521 mm²) and 26 exhaust over 21–60 and 300–339 (212 mm²)** — the exhaust arcs pulled in 3° at the port face for the 56-wide slot. Not cut: the twelve across the port face (342–18); the eight over the motor's carriage hole (79–101: the shoe's hole reaches r 85 and cuts through the groove, so openings there would look into the cavity — the groove and undercut are walled off either side of it); and the eight opposite (259–281) so the two side views are identical. No opening is blind. Behind them an **underside groove** — r 84.5–89 on the intake arc (two arcs, interrupted over the carriage hole), r 82.5–89 on the exhaust arcs (wider: they are fed from one end; v15 7.5 wide, 6.5 now so its end clears the slot's wall by 1.6), z 0–6.55, with 1.2° walls at 60 and 300, open at the bottom and closed by the pad; a Ø9 land stands in it round each of the structure's three plate screws (r 80.8, az 160/240/328) so their countersunk heads bear on metal — the brief's "optional plenum", which is what makes 120 openings machinable (1.8 wide plunges through a 3.7 wall instead of 12.5 mm of ring). The **0.8 undercut** under the outer wall (r 89–92.7) opens straight into the groove all round both arcs: the supplementary intake and the downward exhaust in one (rule 7 and 10); the pad needs no voids. The upper land above the openings is plain (no reeding — Ryan's review, 7 Sep: the brief's three grooves left 0.15 mm lands). The inner land r 78.8–84.5 carries the passages (above); an inward flange r 75.8–78.8, z 5–8 onto the core with seven M2.5 tapped holes, the Ø2.8 clearance for the bond screw at az 67.5, and two M2 taps 3 deep at az 35 and 58, r 78.1 for the hood lid; the blower trench's notch through the flange and the inner land between az 37 and 56 out to r 83, where the exhaust groove's roof is open under the lid (the lid to r 84.5, 0.3 inside the wall's foot); the structure's three plate screws at r 80.8 (countersunk from below); two Ø1.6 holes tapped M2 at r 81.8, t ±32 for the port face's rail; the 56-wide port slot.

**The closing plate**, 1 mm aluminium, laser-cut, its outer face anodised: a disc r 75.7 with the same three windows as the core, nine countersunk holes, **twelve Ø2.2 holes countersunk from below for the boards' M2 studs (DIN 7991 heads 0.2 proud — the core stands 1.5 off the desk on its pad)**, and the four 9.5 mm square lands reaching into the Pi window at the Pi's holes with Ø2.7 countersunk holes (the Pi and the adapter stack screw to these from below).

Why 8 mm at the rim: the plug bodies at the rear must sit between the pad's underside (z −1.5) and the halo's bottom edge (the plate top). Why the ring is stainless: Ryan, 6 September — heft traded for heat management, no masking, no corrosion at the bond.

### 4.17 Compute Module 5 (PRODUCTION only — not in v10)

PUBLISHED (datasheet, verified): 55 × 40, bare module 4.6 deep, PCB 1.24, SoC 2.2 tall, four M2.5 holes inset 3.5; mounted height 4.94 with the 1.5 mm Amphenol stacking connector or 7.44 with the 4.0 mm one; idle 0.4 A, load 0.9 A at 5 V; "less passive heat-sinking than a Pi 5 — any thermal solution must be designed". Section 8.5 uses it SoC-down on a plate boss with the 4.0 mm stacking.

### 4.18 Rubber pad — a **plain 1.5 mm ring under the rim ring**, r 78.6–89.7 (0.5 lean to the desk), cut away at the port slot and pocketed under the barrel plug only; it closes the ring's underside groove and the passages across the inner land from below. Screws, inserts, washers, standoffs, cables, code strip, display bonding tape, the LED strip's own adhesive, the converter's thermal gap pad, the four foam gaskets — the pad, the display tape and the gap pad are the only adhesives (Ryan, 5 Sep); the gaskets are compressed, not stuck. Hardware as built (v16): 4 × M2.5 × 12 hex standoffs and 4 × 0.5 washers (the Pi stack), 4 × M2.5 × 6 csk from below (Pi), 4 × M2.5 × 5 (adapter), 4 × 3 mm standoffs (touch board), 4 × M2 inserts + 4 × M2 × 4 (connect board on its bracket), **12 × DIN 7991 M2 countersunk studs from below** (4 × M2 × 22 for the audio board and its tray, 8 × M2 × 16 for the driver, haptic and level-shifter breakouts and the converter) with **16 × DIN 934 M2 nuts** and **14 printed spacers** (6 × 3.0, 4 × 1.0, 4 × 4.4 tubes), 6 × M2.5 × 4 into tapped blind holes on the plate's piers (servo frame 2, connect bracket 2 csk, speaker cradle 2), **2 × M2 × 16 pan** (saddle + blower into the piers), 2 × M2 × 5 (hood lid into the ring), 2 × M2 × 4 (port face rail into the rim ring), 3 × ISO 8734 Ø2 m6 × 8 dowel pins (display locating), **2 × ISO 8734 Ø3 m6 × 10 and 1 × Ø3 m6 × 16 dowel pins + 2 × M3 × 0.5 washers (the wheels), 3 × V623ZZ V-groove bearings, a Ø4 × 16 compression spring, 1 × M2 × 18 pan + 1 × M2 nut (the block's release)**, 2 × M2 inserts + 2 × M2 × 6 (encoder board through its shim), 1 × M2 insert + 1 × M2 × 4 + ring terminal (bleed foot), **3 × M2.5 inserts (Ø3.5 × 4.0) in the structure's pillars + 3 × DIN 7991 M2.5 × 8 csk (plate to the pillars), 7 × DIN 7991 M2.5 × 8 csk (rim ring to the core), 1 × DIN 7985 M2.5 × 8 pan + DIN 6798 star washer (ring bond, thread-locked), 1 × M2.5 × 6 pan + star washer + ring terminal (chassis bond)** (Ryan, 8 Sep: every M3 became M2.5 — one screw size with the Pi's; the Ø3 dowels and their washers are not screws), 9 × M2.5 × 4 csk (closing plate), the panel jack's nut; a JST SH 4-way housing + 2 crimps (the blower's leads); foam gaskets: OD 30 / ID 25 × 0.3 (blower inlet), the hood's die-cut 0.3, the closing plate's die-cut 0.2 (two pieces), **the opal ring's 0.3 ring under the lip**.

---

## 5. Made components

### 5.1 Knob (PETG prototype; CNC 6082 production)

One piece, v10's shape scaled to the rim. **Ø185.4** outside, a **4.5 wall** (1.0 knurl + 3.5 under the root), the **3 mm lip** 28.5 wide from its edge at r 64.2 to the bore; top rim 1.0 inner chamfer + **25.0 flat** + 2.5 outer chamfer. ≈ 82 cm³ (knurled 75): ≈ 104 g in PETG, ≈ 222 g in aluminium; inertia ≈ 2× v10's — re-tune the detents on the bench (section 7). Bore **Ø176.4** (the chin at r 72.05 is 16 mm inside it) straight from the skirt's bottom (z 14.9) to the lens level, with **the v16 V-ridge**: a 0.3 relief band cut into the bore (r 88.5, z 19.3–23.7) and, standing on it, a 90° ridge from a 3.2 base (z 19.9–23.1) to a 0.8 crest at r 87.3 — the three V-groove bearings straddle it (4.7); the 0.15 code ring's recess in the crown's underside at r 72.5–79.5; the lip on top: inner edge Ø128.4 (0.7 outside the picture), 3.0 thick, underside at z 31.38, top at **z 34.38**; skirt bottom at z 14.9; outer chamfer 2.5 at 45°, inner chamfer 1.0, skirt chamfer 1.2. Knurl: diamond, 1.0 deep, three whole rows (helix 33°), **82 starts** at Ø185.4 to keep the v9 7.1 mm pitch (question 13); the grooves run out downward through the skirt's 1.2 chamfer and stop 0.8 under the top chamfer. Wall under the knurl root 3.5. The knob touches only its three wheels (the ridge's flanks on the V's flanks) and the drive band: 0.4 to the lens and the structure, 0.45 to the chin. Printed top face down: the ridge's lower flank is a 45° overhang, the relief band's edges are 0.3 steps — no support.

### 5.2 Internal structure (printed; PA12 production)

One part, scaled to the bore, **with a wall in two radii (v16)**: r 84.8–86.4 from the plate top to z 13.8 (the halo ledge's top is 14.3), a 50° ramp inward to r 82.8–84.4 at 16.2, then up to the **seat flange** (r 62–84.4, z 24.0–26.0 — a 22 mm shelf; the glass bonds at r 62.5–65.6) with the 32 × 2.5 flex slot at 0°. The step exists because the knob is fitted 2.4 off-centre (4.7): on the far side its ridge crest comes in to r 84.9 and its bore to 85.8, and the wall above the ledge must be inside them; below the ledge the wall must be 4.4 inside the opal ring for the strip's channel. The flange's top face is flat — it is the print bed (v15): the three locating nubs are Ø2 H7 through-holes at 70/210/330°, r 67.25, in Ø5 bosses under the flange, with ISO 8734 Ø2 m6 × 8 dowels pressed from below; the encoder's two M2 inserts in bosses under the flange at **335°** (v15 310°: the MCU tray's studs are there now), r 76, the flange's holes radial slots ±0.5, its platform the separate shim; the bleed leaf's insert in a boss under the flange at 200°, r 74.5. **The halo ledge and lip** (HALO-OPTICS): a ring from the wall out to r 90.5 at z 13.2–14.3 whose underside carries the strip, stepping up to r 92.7 at z 13.5–14.3 as the lip that clamps the opal ring through its gasket. **Two fixed wheel posts** Ø8 at r 82.3, az 30/150, to z 19.0, with Ø2.9 press holes 5.5 deep for the Ø3 pins, webbed to the wall; **the sprung wheel's channel at 270** — two 2 mm walls at t ±4.2–6.2 from r 58 to the wall, z 8–14, a 0.8 roof at z 13.2–14.0 with a 3.2 × 7.7 slot for the axle pin (the block's stops), an end wall at r 58–60 with a Ø2.4 hole at z 10.5 for the release screw; a 14-wide window through the wall above each wheel from z 19.0, open to the top, the seat flange cut away entirely above each. The motor's window in the wall: 1.0 clear of the bell, 2.0 clear of the collar and band, open up to the flange. The LRA pad at 258° from the upper wall's inner face (r 81.55) to the wall, and the contact carrier's clip at 252.5° (ribs from r 74.5, 45° tops). **Three Ø7 pillars at r 80.8, az 160/240/328** (320 → 328 for the level shifter), webbed to the wall, M2.5 inserts at the bottom, 45° cones and webs on top. The perimeter slits 1.0 × 4.5 at z 18.5–23.0 on a 2.5° grid (98 cut). The halo's two notches through the wall's foot at az 325 (the tail, 4 wide) and 190 (the far-end feed, 3 wide). Every web, pad and rib that reaches the wall is trimmed to the wall's outer face so nothing pokes out through the ramp. **Printing**: inverted on the seat flange's top face; supports only under the halo ledge + lip (a 6.3 ring at 11.7–12.8 mm up, outside the wall — the face it marks is under the knob skirt) and the two Ø8 fixed-post tops (7 mm up); the channel's roof is an 8.4 mm bridge and its walls and end wall print up from it; the ramp is a 50° overhang on both faces; everything else is open at the bed, a cone, a web or steeper than 45° (`src/printcheck.py`).

### 5.3 Halo ring — machined opal acrylic (HALO-OPTICS §6), and the white liner

**The opal ring**: r 90.8–94.7 (3.9 wall), z 7.5–13.2, vertical faces, 0.3 chamfers on all four edges; CNC-routed from **6 mm cast opal sheet** — Perspex Opal 030 (~68 %) or PLEXIGLAS Satinice 0D010 DF (83 % at 3 mm, bulk-diffusing beads) — **annealed** 80 °C for two hours and slow-cooled after machining; **no isopropyl alcohol or acetone** in assembly or in the care instructions (crazing). It stands in the rim ring's 0.5 rebate (from r 90.5 outward, floor z 7.5) on the 0.8 shelf that stands 2.0 proud of the knob and plate, with 0.3 radial clearance to the rebate's wall and the ledge, and is clamped axially by the structure's lip through a 0.3 closed-cell foam ring (r 90.8–92.7) — never hard between two machined faces. Its outer 2.0 stands uncovered (Ø189.4). Not printed (the v15 print was 0.9 thick at its foot, and HALO-OPTICS §1 says why no print or material fixes a 0.2 mm LED gap). **The liner** (printed, white PETG): an L-section ring in the channel — a 0.4 floor on the ring's top from the wall to r 90.5 and a 0.6 wall up the structure's wall to z 11.4, cut at the two tail notches; it makes the channel's floor and inner wall white and diffuse and it is removable. A white coating on the ring instead gives 4.0 of throw (bench).

### 5.4 Connect-board bracket, and the Pi stack that replaced the deck (v10-ONLY)

The deck is gone (Ryan, 6 Sep). Two things do its jobs. **The Pi stack**: four lands of the closing plate (4.16) → 0.5 washers → the Pi → four M2.5 × 12 hex standoffs on its holes → the adapter driver board (4.3) → M2.5 × 5 pan heads; M2.5 × 6 countersunk screws from below through the lands into the standoffs. Every other board stands on printed spacers over countersunk M2 studs from below (4.11–4.13). **The connect-board bracket** (printed): a 1.5 mm slab at z 9.5–11 from r 49.6 to 81.6, t −29..+21, bridging the port slot; it rests on the port face's rail (z 9.5) at its outer end and stands on a 1.5 mm foot strip (r 49.6–51.6) and two countersunk ears (49.6, 17) and (49.6, −20) at its inner end (M2.5 × 4 into the web); four Ø6 bosses 2 mm tall with M2 inserts carry the connect board; its −y inner corner is cut back because the audio board's USB-A plug sits there. Prints standing on its straight −y edge (slab vertical, feet and bosses sideways), no supports.

### 5.5 Display seat (PRODUCTION) — the display module's interface to the structure

The seat flange of 5.2, with the bonding tape (4.1). No separate part. The display module (lens bonded to the panel by its supplier) is placed lens-down in the inverted knob and the structure is lowered onto it with the tape on its seat; the three dowel pins centre the glass. Cost in the stack: 0.5 mm of tape. Replacing the display means peeling it off the seat — acceptable for v10; production can revisit a clamp ring if a tool-free swap is wanted.

### 5.6 Carriage, drive collar, servo frame, speaker cradle, port face, sprung block, MCU tray and keeper, spacers — printed

The carriage as v15 with the **17.4 × 15.4 pocket for the MT6701 module**; its push tab 3 × 10 × 14.5 (PETG, 4 perimeters). **The drive collar** (4.7): ID 35 −0.05 × OD 39.4 × 3.5 with a 0.3 lead-in, pressed on the bell's top, the band on it; axis vertical, 0.12 layers; POM turned in production. The servo's floorless frame and the speaker cradle as v15 (M2.5 into the web). **The port face**: **56 wide** (v15 44), 1.5 thick at r 83.3–84.8, z −1.5 to 8; the USB-C shelf; a **5.3 mm slot holder** on its inner side for the Adafruit 4162 breakout (slot 1.8 × 17 from z 1.0, open under the board's middle for its pin rows, a pocket through to the face for the sensor package); a 3 mm boss round the panel jack's Ø6.3 hole; the 1.5 mm rail along its top screwed to the ring at t ±32 (cut away round the sensor's slot); prints lying on its outer face. **The sprung block** (4.7): 13 × 8 × 5, Ø2.9 press hole 1.7 from its outer end, a Ø2.2 hole from its inner face at z 10.5 with an M2 nut in a 4.2 slot from the top 3.0–4.6 behind the face; flat, 0.12 layers, 4 perimeters. **The MCU tray**: 40 × 30 × 1.2 on the audio board's stud pattern, a 0.6 pocket for the microcontroller across it; **the keeper**: the same outline 1.2 thick with a window over the board's parts and its USB-C end open, clamped by the top nuts. **The spacers**: Ø5 tubes, bore 2.2 — 3.0 × 6 under the breakouts, 1.0 × 4 under the audio board, 4.4 × 4 between the audio's nuts and the tray; axis vertical. The eccentric bushes and the V-collars are gone (bought bearings on pins).

### 5.9 Blower unit — saddle, hood lid, encoder shim (printed)

**Blower saddle** (PETG, one part): a 30 × 30 × 1.2 plate on the blower's top (z 18.3–19.5), its top flat (the print bed) — **v16: a plain clamp plate, no board on it** — with two Ø2.2 through-holes on the blower's 24 × 24 diagonal: M2 × 16 pan heads through the plate, the blower's own holes and the inlet gasket into the plate's piers (plate 1.2 + blower 10 + gasket 0.3 + 3.5 of thread). Joined to it, **the hood's neck**: a shell 24 wide × 1.2 walls from the blower's outer face (r 66) to r 73.2, from the plate top to the saddle's top, open at the bottom over the trench and toward the blower's 21 × 7 outlet, with a **turning vane** in its top outer corner (a concave R5.9 sweep from the roof at the blower's face down to the outer wall) so the outlet's horizontal jet is turned down into the trench rather than hitting a square corner — about 10 Pa saved at 0.5 L/s. Prints on its top face, no supports. **Hood lid** (PETG): a flat 2.5 mm lid over the trench's foot, az 33.5–59.5, r 75.8–84.5 (0.3 inside the wall's foot), butting the neck's outer wall with 0.15 clearance, two M2 × 5 into the ring's flange at az 35 and 58, r 78.1. Both sit on 0.3 closed-cell foam gaskets (ASSUMED) die-cut to their footprints; the blower's inlet face sits on a foam ring OD 30 / ID 25 × 0.3 over the Ø22 hole in the web. **Encoder shim** (PETG, 0.10 layers): 8.4 × 12.4 × 0.9 nominal with two Ø2.2 holes, between the seat flange and the encoder board; printed as a family 0.7 / 0.8 / 0.9 / 1.0 / 1.1 so the 2.0 optical gap is chosen on the bench (the checker verifies the gap for the fitted height). The bleed leaf's preload is its own bend; the same shims serve under its foot if the bench asks.

### 5.7 SoC boss (option B only, and production)

Aluminium, Ø26, height from the plate top to 0.5 below the SoC's face (v10 option B: 5.4; production: set by the CM5 stack), two M2.5 countersunk from below the plate, a 0.5 mm thermal pad on top. Not in v10 as built (A″); it is the fallback if the fanless heatsink runs hot (V10.md bench item 1).

### 5.8 Boards — 4.12 (audio), the USB-C board, the barrel jack's vertical board, the encoder breakout — outlines exported to `boards/`; the bought breakouts (4.11, 4.13), the light-sensor breakout and the MT6701 module are exported as their envelopes.

---

## 6. Mechanisms

### 6.1 Knob suspension — v16: the knob rides on three bought V-groove bearings straddling the ridge on its bore (4.7); two fixed, the third pressed home by the sprung block's 4.0 N, so the knob is located by the two fixed wheels and the ridge's flanks take its weight and any axial push — there is no adjustment and nothing to lock. 6.2 detent and drive, 6.3 clutch, 6.4 angle sensing, 6.5 commutation — as v9 with the radii in 4.7 and the drive on the collar. The drive ratio **4.48 : 1**: a 2.4 N band grip at r 88.2 is 0.21 N·m at the knob. The band's slip limit against the sprung wheel's preload (4 N × 0.2 × r 88) is about 70 mN·m — question 38 asks the bench whether the detent target (60–150 mN·m) wants a stiffer spring.

### 6.6 Display — how the panel is held and driven

Held: bonded to the structure's seat (4.1, 5.5), centred by the seat's three dowel pins; the knob never touches any of it. Driven (v10): Pi HDMI1 → ribbon (4.15) → adapter driver board (4.3) → 150 mm flat cable → display connect board → the panel's 45-way flex, which runs on the glass back to the tab edge at 0°, out 1 mm past it, down through the seat slot to z 15.7, 1 mm over the connect board's CN2 to r 77, down and back into it (bend radius 1.0, four static folds, total run about 27 of the 45.8 mm available; the slack loops in the cavity). Touch: the lens's sensor tail → its controller board on the adapter → Pi USB. Production: the CM5 carrier's DSI output straight to the flex, ±5 V and the 37 V backlight driver on the carrier, no adapter, no HDMI — that carrier needs a Linux panel driver with the HX8399-C initialisation sequence from DisplayModule (a software task that must happen for production regardless; question 3 asks whether to do it now and skip the adapter, which would take the mezzanine out of v10 and about 2 mm off its height — the fan's intake plenum then sets the height, not the boards).

### 6.7 Audio — speaker on the audio board's amplifier; 3.5 mm line out unamplified; both on the audio board; the jack carrier at the rear is passive.

### 6.8 Power and the three rear openings

**Proposal: a 12 V, 5 A external brick (**Class II, two-pin, double insulated**, with a stated leakage figure — `GROUNDING.md` 3: an earthed brick would give the object a second earth reference through the audio cable) into a 5.5 × 2.1 barrel jack, and a 5 V step-down inside sized from the measured budget. Preferred over a USB-C inlet feeding the Pi's 5 V pins.** Why:

1. The 5 V budget. Pi 5 up to 5 A (PUBLISHED supply rating; the board alone ~2.4 A under stress, ASSUMED), halo 2.54 A at full white (4.8, computed from the strip as built), adapter + panel 0.6 A, motor up to 2 A through the TMC6300 (PUBLISHED driver limit), servo 0.5 A, audio 0.3 A: **8–10 A worst case, ~2 A typical**. A 5 V 5 A USB-C brick (the 27 W one Ryan has) cannot cover the worst case, and a barrel pin is rated 5 A at any voltage, so 5 V cannot come in through a barrel either. 12 V in at 5 A is 60 W and covers everything with margin.
2. Two USB-C sockets side by side at the rear invite the wrong cable in the wrong hole; a barrel is unambiguous. A USB-C power inlet at 12–20 V needs a power-delivery negotiator board and still needs the step-down; it saves nothing.
3. A 12 V rail is available for anything that wants it later; the TMC6300 motor driver is not one of them (PUBLISHED maximum 11 V), so the motor stays on 5 V as in v9.

The Pi is fed on header pins 2/4/6 from the converter (v10-ONLY; production feeds the CM5 carrier directly). The Pi's USB-C stays for the PC (USB gadget mode). **Gap:** the PC's 5 V on that USB-C parallels the header feed — question 6.

The three openings, in the 44 × 30 slot through the plate at the rear, left to right seen from behind, all with their plug bodies drawn: **barrel** at −14 mm (right-angle plug, Ø8.5 body, cable leaving sideways along the wall), **USB-C** at 0 (GCT receptacle on its horizontal board; plug body 8.3 wide × 6.5 tall × 25 long, cable straight back), **3.5 mm** at +12 (Switchcraft jack; plug Ø6–8, straight). Plug axes at z 3.5 (barrel), 4.5 (USB-C), 4.0 (jack). Every plug body must lie between the desk (z −1.5) and the halo's bottom edge (z 8.0) where it passes under the diffuser at r 74.5–77: the barrel body spans −0.75 to 7.75 and needs a **15 × 20 through-pocket in the pad** under it (the plug hangs 0.75 above the desk); the USB-C body 1.25–7.75; the jack body 0–8.0 with a Ø8 plug, comfortable with Ø6. On a 5 mm plate none of the three closes without a notch in the halo. Alternatives to the pad pocket: notch the halo over ±8° at the barrel, or a 10 mm plate (1.4 kg). Question 5.

### 6.9 Cooling — the base plate is the heatsink, the blower is fitted; the perimeter slits are acoustic only

Replaces the v10 vent analysis (`THERMAL-PLAN.md`). The sustained load is 12–14 W; IEC 62368-1 caps a bare-metal knob at 48–51 °C in a 25 °C room; the knob is the largest surface and the one that may not be made hot, and it sits close to cavity temperature whatever the structure does. So the heat goes down, into the plate, and out under it — and v15 moves it with a blower (Ryan, 6 Sep: required).

**The forced path, entirely below the plate's web** (4.16): room air → the ring's 64 intake openings and its undercut → the underside groove (60–300) → 17 passages → the collector → the 12 +y channels → the +y plenum → up through the Ø22 hole into the blower → its outlet, the hood, down the trench → the 18–60 exhaust groove → 14 openings and the undercut, out at the rear. The −y side (7 channels, its 300–342 openings) is pulled in reverse by the same suction. The web has no opening except the two under the hood, both gasketed; the forced stream never enters the cavity, never passes the panel or the encoder. **The perimeter slits stay the speaker's acoustic port and nothing else**; the cavity breathes through them by buoyancy only. **The blower**: Delta BFB0305HA-C, 0.68 L/s free air and 71 Pa at no flow (datasheet P-Q curve in `vendor/`); through this duct — about 8 Pa in the fins, 3 in the intake, 7 in the trench and the blower's outlet, 5 in the groove and openings at 0.5 L/s — it lands near **0.5 L/s at ~25 Pa**: 0.6 W/K of air on top of the passive 0.5, about **1.0 W/K** — 13 W sustained is 13 K over room, **38 °C skin at 25 °C** (passive: 51). The plan's 1.1 W/K at 1 L/s is not reachable with one 30 mm blower through this duct; a second blower on the −y side was costed at ~2 K of margin for double the noise and another 0.65 W, and not taken. PWM from the Pi's fan header, so it idles unless the load calls for it; 0.65 W at full speed; 29 dB(A) free-field — the acoustic question (a moving part in a silent object with microphones) is decided on the bench, not here.

What the first print measures: the real load at the 12 V inlet through an hour of use; plate, knob and cavity temperatures with the blower at the PWM the Pi uses and at full; the pressure at the trench; noise at 1 m with the object closed; whether the reverse-flowing −y arc re-ingests the 18–60 exhaust (40 mm apart across the port face). The Pi keeps its heatsink (fan off; the adapter 1.2 mm over its fins is bench item 1).

### 6.10 Assembly order — every step reachable, proven by the checker

The knob side, upside down: 1. Knob upside down, lip down, the code ring stuck into the recess in its crown's underside; a 0.4 shim ring on the lip. 2. Display module (lens + panel, bonded by its supplier) lens-down onto the shim, chin at 180°, flex tab at 0° — a straight drop through the bore (checker). 3. Internal structure prepared: its three Ø2 dowels pressed from below; the two fixed wheels' Ø3 × 10 pins pressed into the posts with their washers and bearings on; **the block with its nut, its Ø3 × 16 pin and bearing slid into the channel from the wall end, the spring on the release screw, the screw through the end wall into the block's nut and wound in** (the wheel now reaches r 84.3); bonding tape on the seat; the encoder board on its chosen shim screwed to the flange from above; the bleed leaf's foot; the Mill-Max carrier dropped into its clip. **The structure enters the knob 2.4 off-centre toward az 90** (the ridge passes outside the two fixed wheels' rims) until its ridge is level with the wheels, then slides to centre — the ridge enters the fixed wheels' grooves flank on flank — with the flex and the touch tail led through the seat slot; the seat pressed onto the glass. 4. **The release screw backed off** with an L-key reached from the display opening (before the display goes in — in this order the display is already bonded, so this step is done with the structure held off the display; alternatively fit the structure to the knob first and bond the display through the bore afterwards: the checker proves the straight drop); the spring pushes the block home; shim out through the rim gap. 5. LRA onto its pad, the liner into the channel, the LED strip stuck face-down under the ledge with its tails through the notches, the opal ring with its gasket under the lip.

The plate side, the right way up: 6. The closing plate's gaskets into their grooves; rim ring to the core (7 × M2.5 csk), its bond screw from the top with its star washer, thread-locked; **the twelve M2 studs dropped through the closing plate's countersinks**, the closing plate into its recess (9 × M2.5 csk) — the studs stand up through the core; the chassis bond screw at (48, 27). 7. Pi with its heatsink onto the four lands on 0.5 washers, standoffs on, 4 × M2.5 csk driven from below. 8. Adapter driver board with the touch board stacked on it onto the standoffs, 4 × M2.5 × 5; header housing with the Pi's 5 V and UART; the ribbon from HDMI1 up to z 16.4, out and back into the adapter's socket; the audio board's right-angle USB-A plug. 9. Spacers over the studs: the converter on its gap pad (2 nuts); the audio board on its 1.0 spacers (4 nuts); the driver breakout, the haptic breakout and the level shifter on 3.0 spacers (2 nuts each); the tray's 4.4 tubes over the audio's nuts, the tray, the MCU into its pocket, the keeper, the 4 top nuts; speaker into its cradle; the servo into its frame with the carriage + motor (its collar pressed on, the band on the collar, the MT6701 module in the pocket) through the plate; the port face with the USB-C board, the barrel jack's board, the panel jack and the light-sensor breakout in its slot, its rail screwed (2 × M2); the connect bracket over the slot (2 × M2.5 csk) with the connect board on it (4 × M2); the flat cable from CN1 over the USB-A shells and the servo to the adapter's connector. 9b. The blower unit as v15 (inlet gasket, blower, hood gasket, saddle, 2 × M2 × 16 into the piers, the lid on its gasket, the fan lead to the Pi). 9c. The harness: motor phases and the sensor lead to the driver breakout and the tray, the haptic breakout to the LRA's carrier, the servo and the light sensor to the Pi's header, the halo's two feeds.

Together: 10. The plate assembly lowered onto the structure, the panel flex into the connect board's CN2; 3 × M2.5 countersunk into the pillars at 160/240/328°. 11. Pad ring on (its pocket at the barrel). Turn over.

Nothing is glued but the pad, the display's bonding tape, the converter's gap pad, the code strip and the LED strip's own backing; the four gaskets are compressed, not stuck. Everything reverses: the display by peeling, the opal ring by lifting the structure's lip off it, the knob by winding the block in again.

---

## 7. What the first v10 print must prove

Every part fits — the panel (or its dummy), the Pi on the closing plate's lands through the plate window with the adapter on its standoffs, the boards on the plate, the servo in its frame beside the carriage, the connect board on its bracket over the port slot, the motor mechanism, the three sockets — with nothing touching that should not (checker); the display module and the structure go in on straight paths; the Pi's screws from below and the adapter's from above are reachable; the flat cable and the ribbon route as drawn.

---

## 8. Diameter and height — derived, and what each part costs

### 8.1 Diameter

| Layer, from the axis outward | r | Why |
|---|---|---|
| Picture | 63.5 | panel |
| Lip inner edge | 64.2 | 0.7 hidden border, ASSUMED |
| Lens edge | 70.0 | ASSUMED Ø140 |
| Chin corners | 72.05 | MEASURED — 16 mm inside the bore |
| Core / ring joint | 75.8–78.8 | the ring's flange on the core's rebate; the duct and closing plate end at 75.8 |
| Rim ring | 78.8–92.7 | 3 inboard of the port face's holes (rule 4); the 0.8 shelf to 94.7 |
| Pillars, wheel posts | 80.8, 82.3 | 4 inside the wall; the bearings' axes |
| Port face | 83.3–84.8 | at the wall's inner face |
| Structure wall, lower | 84.8–86.4 | 1.6 printed wall, 4.4 inside the opal ring (the strip's channel) |
| Structure wall, upper (from z 16.2) | 82.8–84.4 | stepped in 2.0 so the knob can be fitted 2.4 off-centre |
| Bore ridge crest / relief band | 87.3 / 88.5 | the V-ridge the bearings straddle |
| Knob bore | 88.2 | **R_KNOB − 4.5**: the knob's wall sets it |
| Strip (face down under the ledge) | 86.6–90.6 | in the 4.4 channel |
| Ledge / lip | to 90.5 / 92.7 | 0.3 inside the opal ring / clamps it |
| Opal ring | 90.8–94.7 | 3.9 machined, standing 2.0 proud |
| Knurl root / outside | 91.7 / 92.7 | 3.5 under the root, 1.0 knurl |
| Top rim | 64.2 → 92.7 | 1.0 chamfer + **25.0 flat** + 2.5 chamfer (Ryan, 8 Sep) |
| Plate edge | 92.7 (shelf 94.7) | flush with the knob; 0.3 chamfers |

**Knob Ø185.4, plate Ø185.4, halo band Ø189.4** — set by the 25 mm rim; everything inside is derived from the bore by v10's rules. The wall gained 3.6 mm on its inner face, not 5: the halo channel takes 1.4 of it (HALO-OPTICS), which is why the layout study's margins shrank in the build.

### 8.2 Why one level now

v10's deck existed because the Pi, the adapter and the motor sector could not share a Ø141 floor. In v16 the floor inside the wall is r 84.8 (22,600 mm²), the adapter stands on the Pi (its holes are the Pi's), and the plate takes the Pi, the motor sector with the servo inboard of it, the speaker, the converter, the audio board, the three breakouts, the connect board over the port slot and the sockets. Above the plate: the adapter on the Pi, the touch board on the adapter, and the MCU tray on the audio board's studs. Nothing overlaps (checker); the nearest neighbours are 1.5–3.3 mm apart (`checks.txt` names them).

### 8.3 v16 stack as built — one level, adapter on the Pi, the MCU tray on the audio board, encoder reading the crown, display bonded to the seat

| z | What | Cost driver |
|---|---|---|
| −1.5–0 | pad ring | |
| 0–8.0 | plate (closing plate 0–1 with the Pi's lands, duct 1–6, web 6–8); the opal ring 7.5–13.2 on the shelf; the channel 8–13.5 with the strip face down at 12.0–13.2 under the ledge (13.2–14.3); lip to 14.3; skirt from 14.9 | plate 8 (4.16); the halo band (4.8) |
| 1.5–2.78 | Pi board on 0.5 washers on the lands | |
| 4.2–18.2 | motor on its carriage; the drive collar on its top 14.7–18.2 with the band 14.9–17.8, all of it on the bore | v9 case B, the collar (4.7) |
| 8–19.0 | on the plate: servo 8–14 (frame 14.5); the block 8–13 in its channel (roof to 14); the breakouts 11–12.6 with parts to 15.6; the audio board 9–10.6 with its nuts to 12.2; the converter to 16.1; the speaker to 17.05; the connect board 13.0–14.7 on its bracket; the HDMI ribbon 16.4; **the MCU tray 16.6–17.8, keeper to 19.0, top nuts to 20.6, the MCU's USB-C to 21.3** | |
| 14.78–16.38 | adapter on 12 mm standoffs; its parts to 18.9, flex connector 18.4, buttons 20.5, **HDMI socket to 23.68**; touch board on it to 22.4; flat cable to 20.8 | **the deciding part**: 23.68 + 0.3 + the 2.0 flange = 26.0 |
| 19.5–23.5 bearings on the bore's ridge (19.9–23.1); **24.0–26.0 seat flange** | the wheels alone would allow 25.2 | |
| 26.0–26.5 | bonding tape under the glass edge; the encoder's boss, board and sensor on the flange outside the lens (26.0–29.53, 2.0 under the crown's code ring) | +0.5 |
| 26.5–28.48 | panel glass 1.98 (its back components hang 1.5 below it inside r 34) | |
| 28.48–30.98 | lens 2.5 (ASSUMED) | |
| 31.38–34.38 | lip 3.0 after the 0.4 rim gap; the code ring's face 0.15 up in its underside | |
| **35.9** | **overall with the pad** (v12 37.9, v11 40.7) | |

What each part costs against the wheels' floor of 25.2: the adapter's HDMI socket **+0.8**; the bonding tape **+0.5**; the 8 mm plate and the 5.5 halo band **0** in height. Below the wheels' floor the limit is the motor stack: the band on the collar meets the bore from the skirt's bottom (14.9, over the lip) to 17.8, and the relief band starts 1.5 above it.

### 8.4 Option B — cooler deleted, Pi inverted, SoC on a boss to the plate

Pi inverted with its USB-A and Ethernet stacks standing on the pad through the plate window: component face at z 16.2, board 16.2–17.48, its back-side parts to 18.93; SoC face at 13.86; boss 5.4 tall on the 8 mm plate, 0.5 pad. Everything above is as built: **35.9 with the pad**, the same as v13 (the adapter sets the seat either way).

Thermal credibility at ~4 W (ASSUMED coefficients): pad 0.3 K/W, boss negligible, plate spreading 0.65 K/W (8 mm; 1.0 at 5 mm) → SoC ~4 K above the plate; the plate is ~10 K above the room at 4 W total (6.9) → **SoC ≈ room + 15 K: credible, and silent.** At 12 W stress the Pi throttles at 85 °C long before the object does; acceptable for a desk prototype. Cost: a machined boss, two plate holes, the Pi's sockets facing down (the micro-SD slot is then on the visible back face — convenient), and a thermal-pad thickness that must absorb the boss-to-SoC tolerance (use 1.0 mm, ASSUMED). Gain in height: **none**. A″ (the heatsink without its fan) is built because it needs no new parts; B is the fallback if the first print's temperature log says so, and production's principle.

### 8.5 Production — the same object with a Compute Module 5

CM5 SoC-down on a plate boss (4.17 numbers): plate top 8.0 → pad 0.5 → SoC 2.2 → module PCB 1.24 → 4.0 stacking connector → carrier 1.6 → carrier top-side parts 4.0 (ASSUMED) → carrier top at 21.5. No adapter, no ribbon, no Pi window; the boards mount to the plate as they already do in v12 (carrier flat to the aluminium with the compute module's boss through a masked pad, the converter and the motor driver on gap pads — thermal plan rule 15), and the structure gains the lid of rule 14. The carrier top at 21.5 would allow a seat at 23.8, but **the wheels set the floor at 24.2** (their groove over the drive band, 8.3): seat 24.2 → knob top 32.6, **overall 34.1 mm** — 1.8 below the Pi 5 prototype, which is the adapter's socket. A thinner carrier does not lower it; going under about 33.3 needs a narrower halo strip or the motor lower in the plate.

---

## 9. What is v10-only and what is production

| v10-ONLY | PRODUCTION |
|---|---|
| Raspberry Pi 5, the Active Cooler's heatsink, the plate window, the closing plate's lands and the Pi's standoffs, the HDMI adapter kit (driver board, flat cable, connect board and its bracket), the HDMI ribbon, the internal USB-C and USB-A cables, the header power housing, the bought converter module, the bought breakouts and the MCU tray (production: one carrier board), the touch-controller board as a separate item, height 35.9 | Ø185.4 knob and its lip/chamfers/knurl, bore Ø176.4, the panel and lens bonded to the seat, the wheel/motor/servo/encoder radii, the halo at r 86.6–94.7, the 8 mm plate and its rear slot, the three rear openings and the 12 V barrel choice, the perimeter ports and the vent answer, the audio and motion functions (on the carrier), the CM5 boss principle, height ≈ 34 |

---

## 10. Rules for building the v10 CAD once agreed — v9's ten rules, plus

11. Every plug body (barrel, USB-C, 3.5 mm, micro-HDMI, HDMI-A, USB-A, header housing) is a named `_ENVELOPE` body in the assembly, in its inserted position.
12. Every cable is a swept body along its modelled route with its bend radius as a parameter, and the checker tests it against the carriage sweep, the bell and the wheels at knob angles 0/17/45/73° and both clutch states.
13. The checker proves the display module's insertion path (a straight drop through the bore), the structure's entry from below, the encoder board's drop into its slot, the Ø6 driver paths to the Pi's screws from below and the adapter's from above, every top-face screw hole landing in the plate, every body under the seat below its underside, and both air circuits having an intake and an exhaust.
14. The parameter block carries `PLATE_T` and `COOLER_FAN_FITTED` as switches; the boards' placements are azimuth/radius pairs or (x, y) centres; the adapter follows the Pi (`ADAPTER_X0 = PI_X0`).
15. Drawings: A3, one sheet per made part, the first sheet listing every ASSUMED number.
