Ryan365Apps/spotify-knob/docs/BoughtPartDimensions.md

# Bought part dimensions

Envelope dimensions for every bought-in part, in millimetres. Envelope means the
space the part actually needs in the enclosure, including clearances called out
per part.

## A. Knob and support

| Part | Envelope (mm) |
| --- | --- |
| 623ZZ bearing ×3 | Ø10 × 4 — bore Ø3, chamfer 0.15 |

## B. Haptics

| Part | Envelope (mm) |
| --- | --- |
| iPower GM3506 gimbal motor | Ø40 × 17.8 — hollow shaft Ø12 outside, Ø8.6 bore, full height |
| TMC6300-LA-T driver | 3.0 × 3.0 × 0.85 — thermal pad 1.7 sq |
| MT6701CT-STD encoder | body 4.9 × 3.9, 6.0 across the leads, 1.62 tall |
| its diametric magnet | Ø6 × 2.5, sitting 0.5–2.0 above the chip |

## C. Clutch

| Part | Envelope (mm) |
| --- | --- |
| AGFRC C1.5CLS PRO servo | 21.4 × 15.2 × 6.0 — plus 9.0 of stroke clearance off one end |

## D. Display

| Part | Envelope (mm) |
| --- | --- |
| Waveshare ESP32-P4 3.4C | Ø115 disc × 6.0; 15.5 total front glass to the tallest rear part; board 85.5 × 65 × 1.6, offset 4.5 from the disc centre |

## E. Audio

| Part | Envelope (mm) |
| --- | --- |
| Soberton SP-4005-1 speaker | Ø40 × 9.05 — flange Ø40, front ring Ø38 with a Ø35.5 opening, rear boss Ø16.2 |
| ESS ES9219Q | 5.0 × 5.0 × 0.75 — thermal pad 3.79 sq |
| Switchcraft 35RAPC4BH3 jack | body 14.0 × 11.5 × 6.0; 17.5 long with the bushing; 8.5 tall with the pins below the board; bushing M6 × 0.5 out 3.5, axis 3.0 above the board |

## F. Feedback

| Part | Envelope (mm) |
| --- | --- |
| Vybronics VLV101040A | can 10 × 10 × 4.05; 4.37 installed with the cushion and tape; 13.9 long including the flex tail |
| TI DRV2605L | 3.0 × 3.0 body, 4.9 across the leads, 1.10 tall (ten-pin) — or 1.44 × 1.44 × 0.625 (nine-ball) |

## G. Sensing

| Part | Envelope (mm) |
| --- | --- |
| Broadcom AEDR-8300-1K2 | 5.12 × 3.96 × 1.63 — plus a 2.0 air gap to the code strip (range 1.0–2.5) |
| Vishay VEML7700-TR | 6.8 × 2.35 × 3.0 body, 3.2 across the leads — sensitive area 1.95 above the board, not mid-height |

## H. Power and ports

| Part | Envelope (mm) |
| --- | --- |
| GCT USB4520-03-0-A | 6.5 × 8.94 × 3.16, 11.24 across the solder legs — hangs 2.10 below the board, stands 1.06 above; needs a 9.24 × 6.20 notch cut in the board |
| Abracon AHCR-S04R0SA206Q ×2 | Ø8 × 12 each — leads Ø0.6 at 3.5 pitch |

## I. Halo

| Part | Envelope (mm) |
| --- | --- |
| OPSCO SK6812SIDE-A ×~90 | 4.0 × 1.6 footprint, 2.0 tall — emits from the 4.0 × 2.0 face |
