Ryan365Apps/spotify-knob/docs/boards/BOARD-AUDIO.md

# the 60 — board 2 of 3: the audio board

**Date: 5 September 2026. Status: design brief, not yet drawn.** Written to be handed to a contract electronics designer with no further conversation needed to start. Everything here is sourced; anything a vendor does not publish is marked **not published**, and anything I concluded rather than read is marked **judgement**.

Companion documents: `the60-board-carrier.md`, `the60-board-motion.md`, `the60-electronics-build-path.md`, `SOURCING-BOM.md`.

> **⚠ One caveat that colours the whole of section 2.** XMOS's website blocks automated access, so the XU316 figures below come from the 2021 datasheet text reproduced verbatim inside a publicly hosted addendum. The current datasheet is **v2.0.0, 13 January 2025**, and the 2021 text labels its operating-conditions and clock tables **"preliminary"**. **The contractor must re-check every rail voltage, current and timing figure against v2.0.0 before layout.** This is the single largest caveat in this document.

---

## 1. What this board is

It presents itself to the computer as a sound card: a stereo output feeding a 3.5 mm **line output** to powered desk speakers, and a stereo input from two microphones for dictation. It also runs the equaliser and the spectrum analysis, because the audio samples are already here, and sends only the resulting numbers to the compute module over a serial link.

It sits behind the internal USB hub, alongside the compute module and the motion board, and it is **self-powered** — it takes 5 V from the product's own supply, not from the computer.

**There is no headphone amplifier and no speaker drive on this board.** The 3.5 mm socket is a line output at consumer level. That ruling simplifies the output stage to almost nothing (section 6).

---

## 2. The processor: XMOS XU316-1024-QF60B-C24

A sixteen-core processor in a 7 x 7 mm 60-pin package that does the USB audio device, the microphone decimation and the signal processing in one part. It is what Topping, SMSL and most of the current converter market ship.

### 2.1 Power rails

| Rail | Min | Typ | Max | Current |
|---|---|---|---|---|
| **VDD** (core) | 0.855 | **0.900** | 0.945 V | 5 mA quiescent, **300 mA typical, 1000 mA maximum** |
| **VDDIOL / VDDIOT / VDDIOR** | 2.97 | 3.30 | 3.63 V | 126 mA absolute maximum per domain |
| **VDDIOB18** | — | **1.8** | 1.98 V | 126 mA maximum |
| **USB_VDD33** | 3.0 | 3.3 | 3.6 V | 0.8-1 mA at high speed |
| **USB_VDD18** | 1.62 | 1.80 | 1.98 V | 30-36 mA at high speed |
| **PLL_AVDD** | 0.855 | 0.90 | 0.945 V | 0.2-5 mA |

**On this package the I/O voltages are not a choice:** *"The left, right, and top IO domains are 3.3V only, the bottom domain is 1.8V only."* Other packages allow programmable domains; this one does not.

**Design the 0.9 V regulator for 1 A** even though typical is 300 mA. XMOS's own schematic checklist item G.1 says so explicitly.

### 2.2 Sequencing is mandatory

Because the package forces 3.3 V on three domains and 1.8 V on the fourth, the "single 1.8 V supply" shortcut in the datasheet is unavailable. XMOS: *"You must ensure that the VDDIOL, VDDIOT, and VDDIOR domains are valid before the device is taken out of reset, as the boot pins are on VDDIOL."* Their own multichannel board does it as: **3.3 V and 1.8 V up first, then 0.9 V last.** Chain the power-good outputs of each regulator into the next one's enable, as their evaluation board does.

Reset pulse minimum 5 µs. Time from reset release to boot start: 295 µs typical, 480 µs maximum.

### 2.3 Decoupling — quoted, because these are requirements not suggestions

- **VDD:** *"Place many (at least eight) 100 nF low inductance multi-layer ceramic capacitors close to the chip."*
- **VDDIO:** one 100 nF 0402 low-inductance capacitor **on each supply pin**.
- **PLL_AVDD:** *"should be separated from the other noisier supplies… a low pass filter (for example, a 1 µF multi-layer ceramic capacitor and a ferrite of 600 ohm at 100MHz and DCR < 1 ohm, eg, **Taiyo Yuden BKH1005LM601-T**) is recommended."*
- **Bulk:** at least 10 µF on VDD and on VDDIO.
- **Vias:** *"Typical designs could use 16 vias in a 4 x 4 grid, equally spaced across the ground paddle. In addition, you should aim to have four VDD vias underneath each of the VDD paddles."* And: other than ground vias, few or no vias under or close around the device.

### 2.4 Clock and boot

**Crystal: 24 MHz ±500 ppm.** With USB the frequency must be 12 or 24 MHz. XMOS recommend 12 pF load, ESR ≤ 60 Ω, fundamental mode, with **Rf = 1 MΩ, Rd = 680 Ω, CL1 = CL2 = 22 pF**. Named parts include Seiko Epson **FA-238 24.0000MD30X-W5** and IQD **LFXTAL032813**. An oscillator may be used instead, but then it must be a **1.8 V** clock into XIN with monotonic edges and jitter under 2 % of the clock period.

**The on-chip memory cannot boot the application.** Boot is from external quad-SPI flash, and **the pinout is hardcoded in the boot ROM and cannot be changed**: X0D01 = select, X0D04-07 = data, X0D10 = clock. The flash must be ready within 300 µs of power-up or the chip must be held in reset. Choose a part already supported by the tools — **Renesas AT25FF321A** is safest because XMOS's own application ships its specification.

**Debug:** the xSYS2 header is 1.27 mm, 2x10, **Amphenol ICC 20021521-00020T4LF**. It is a **1.8 V** interface and needs a 1.8 V debug adapter (**XA-XTAG4**, about $28) — older 3.3 V adapters will not work. Link outputs need 43 Ω series resistors close to the device. A Tag-Connect TC2030 pad set is the smaller alternative. For 60 units, keep one of them: you will reflash.
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
