Ryan365Apps/spotify-knob/Claude outputs/board_room.png

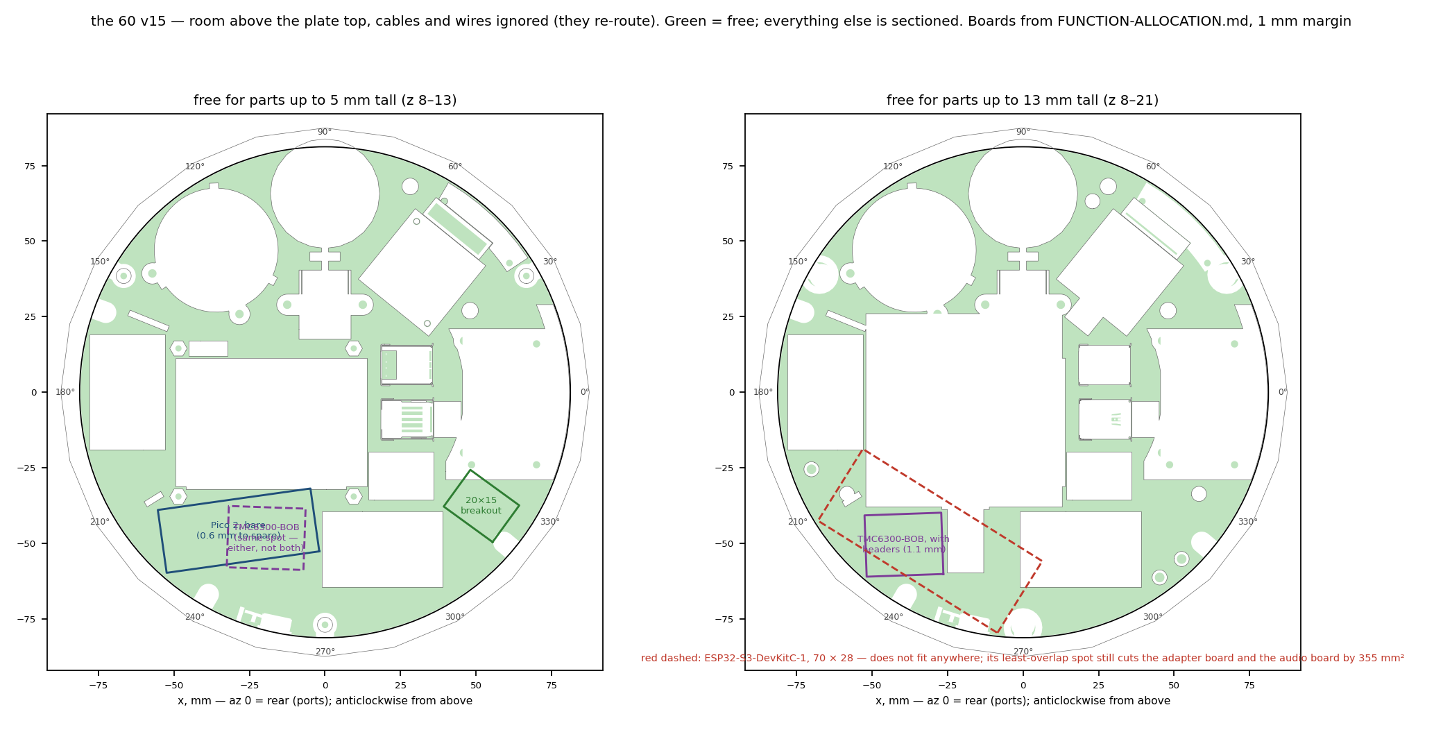
Claude outputs/board_room.png
