Ryan365Apps/spotify-knob/Claude outputs/halo_section.png

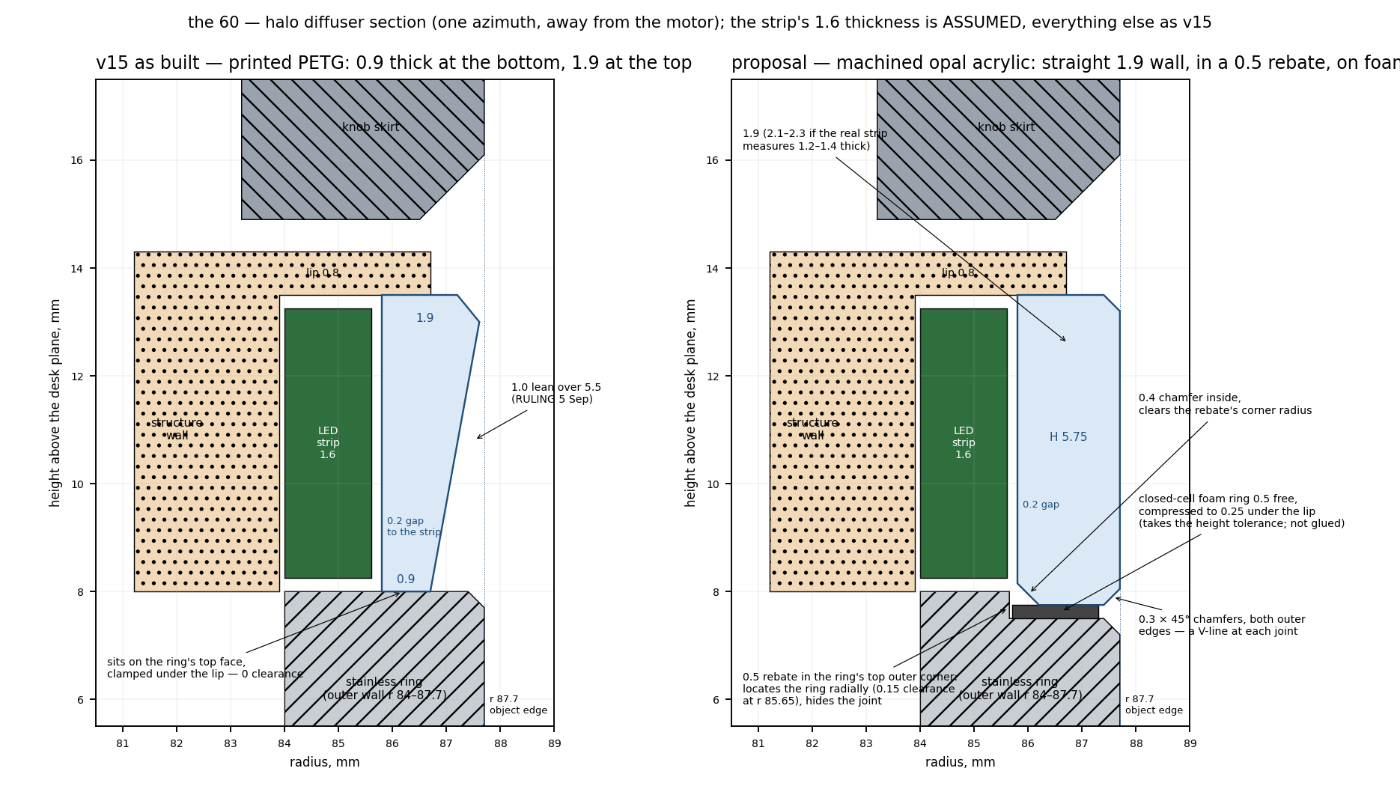
Claude outputs/halo_section.png
