Ryan365Apps/spotify-knob/Claude outputs/rim-options.png

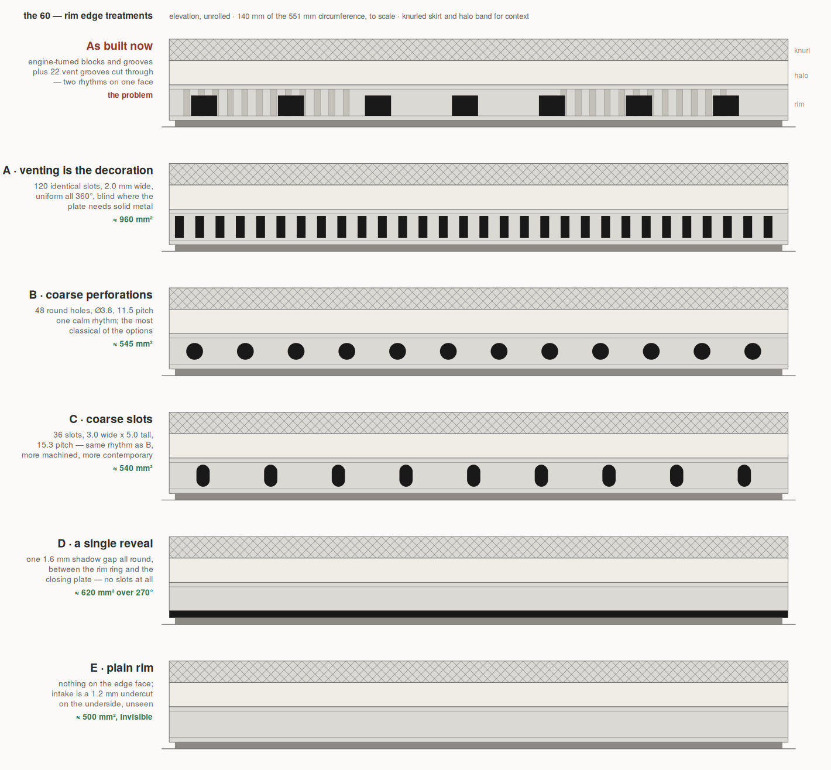
Claude outputs/rim-options.png
