Ryan365Apps/spotify-knob/Claude outputs/sprung_wheel.png

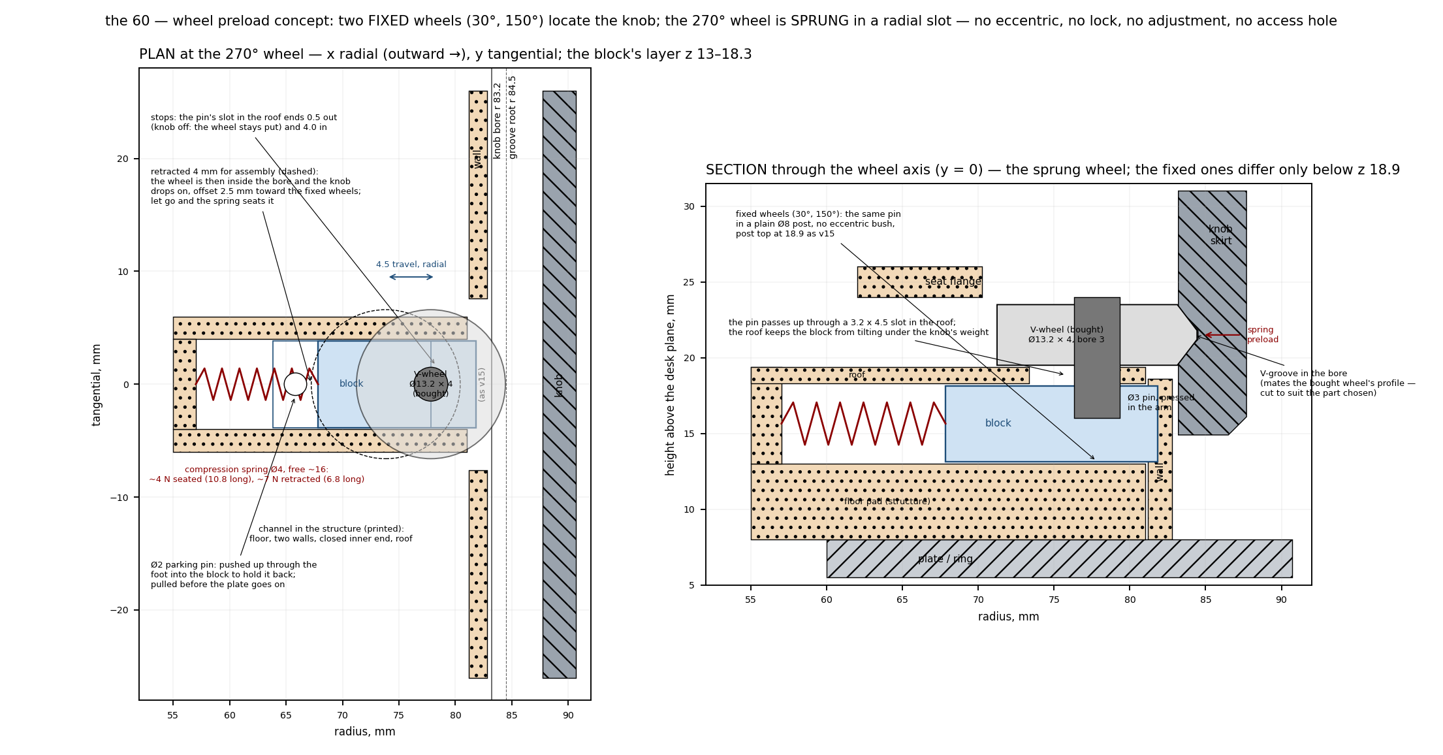
Claude outputs/sprung_wheel.png
