Ryan365Apps/spotify-knob/Claude outputs/v16_ga.png

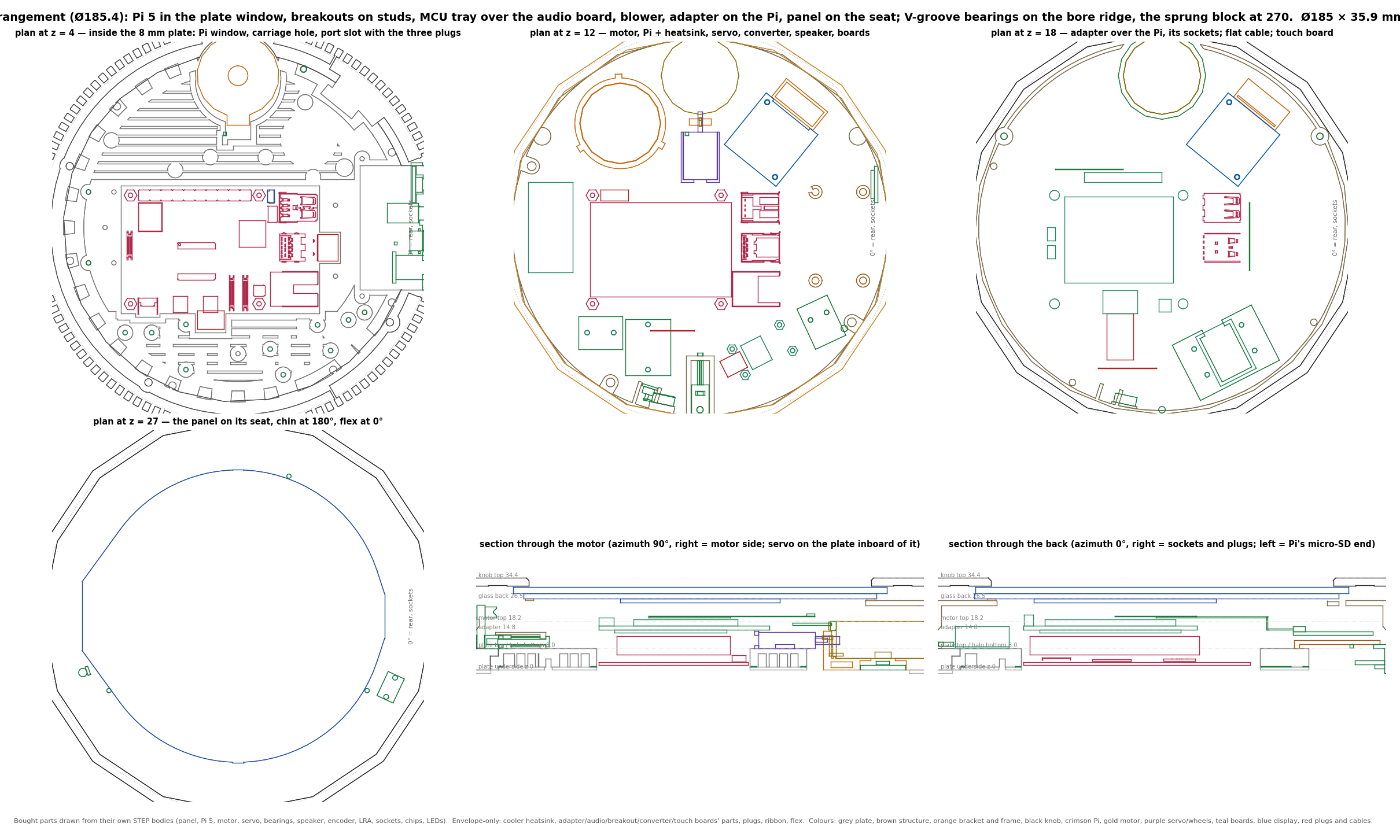
Claude outputs/v16_ga.png
