Ryan365Apps/spotify-knob/design/artwork/_thumbs/frames_exploded_studio_frame_0100.png

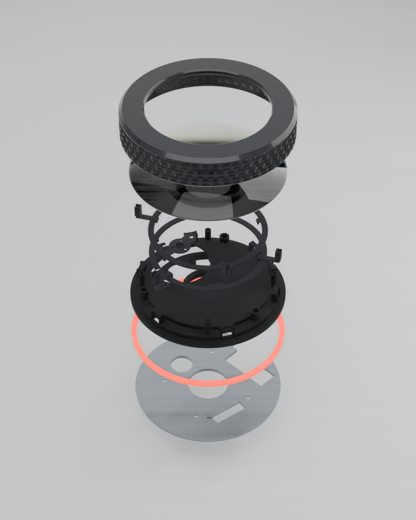
design/artwork/_thumbs/frames_exploded_studio_frame_0100.png
