Ryan365Apps/spotify-knob/design/artwork/_thumbs/frames_halo_volume_frame_0100.png

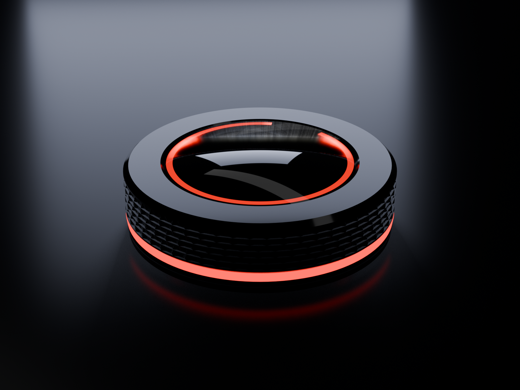
design/artwork/_thumbs/frames_halo_volume_frame_0100.png
