Ryan365Apps/spotify-knob/design/artwork/_thumbs/styles_the60_style_exploded_studio.png

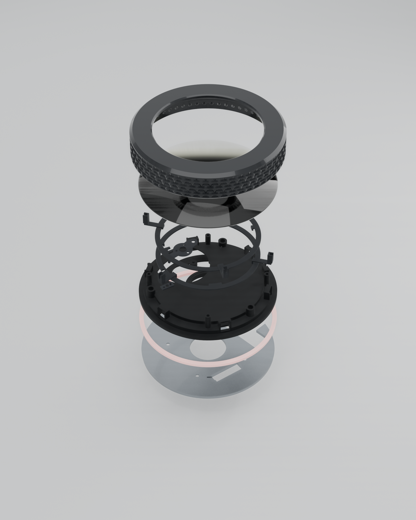
design/artwork/_thumbs/styles_the60_style_exploded_studio.png
