Ryan365Apps/spotify-knob/design/artwork/_thumbs/styles_the60_style_restomod_dark_rear.png

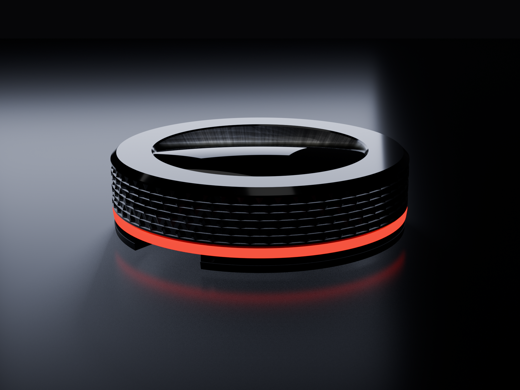
design/artwork/_thumbs/styles_the60_style_restomod_dark_rear.png
