Ryan365Apps/spotify-knob/design/artwork/cooling/the60_v15_cooling_f1_outside.png

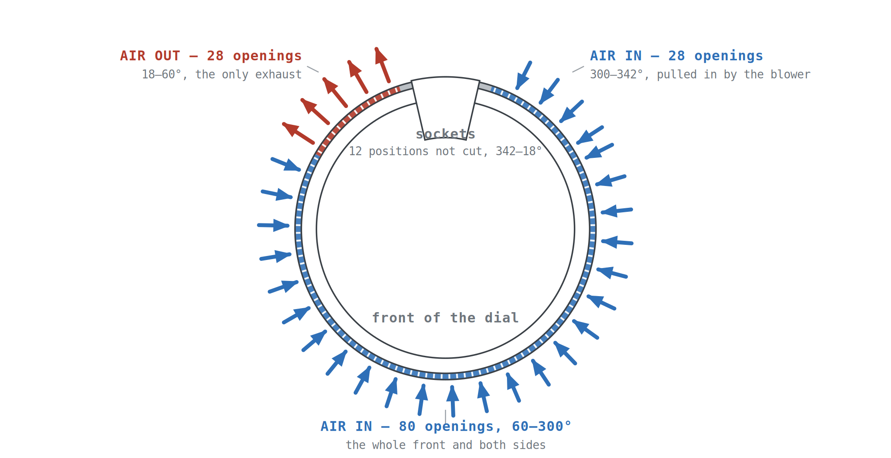
design/artwork/cooling/the60_v15_cooling_f1_outside.png
