Ryan365Apps/spotify-knob/design/artwork/cooling/the60_v15_cooling_f2_inside.png

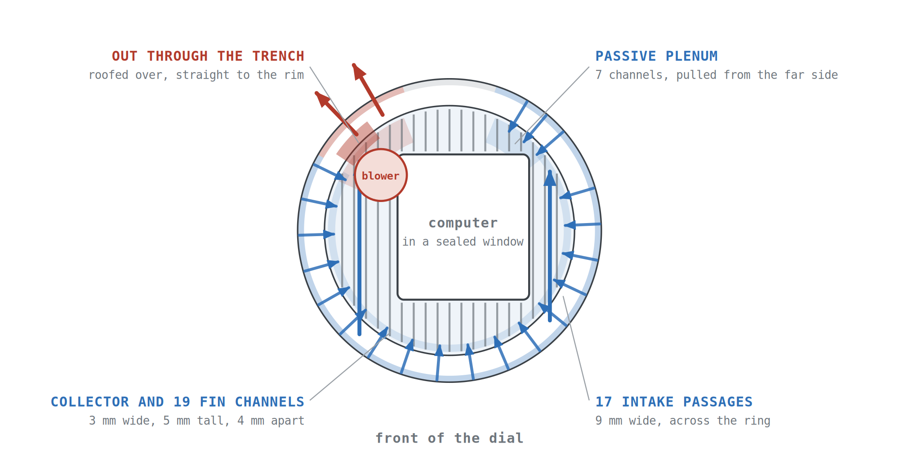
design/artwork/cooling/the60_v15_cooling_f2_inside.png
