Ryan365Apps/spotify-knob/design/artwork/cooling/the60_v15_cooling_f3_front.png

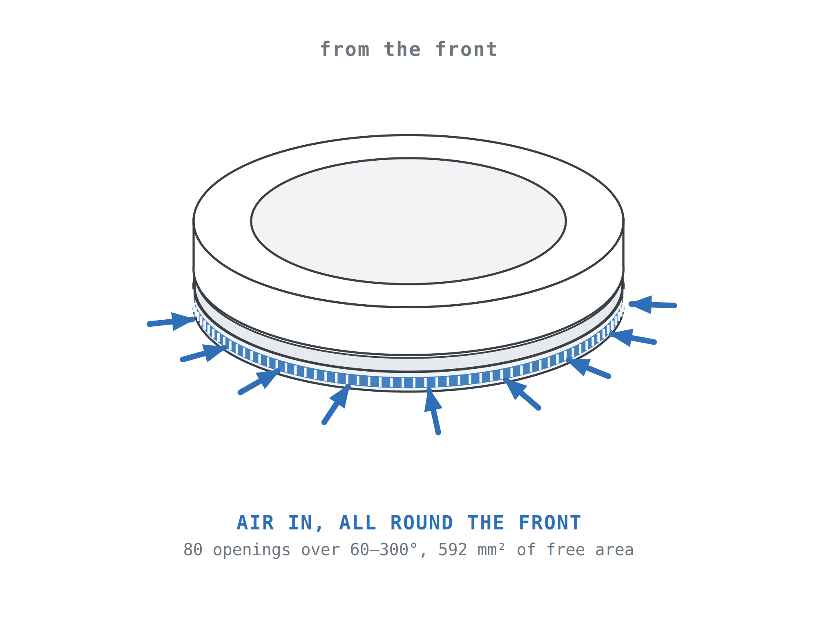
design/artwork/cooling/the60_v15_cooling_f3_front.png
