Ryan365Apps/spotify-knob/design/artwork/cooling/the60_v15_cooling_f4_back.png

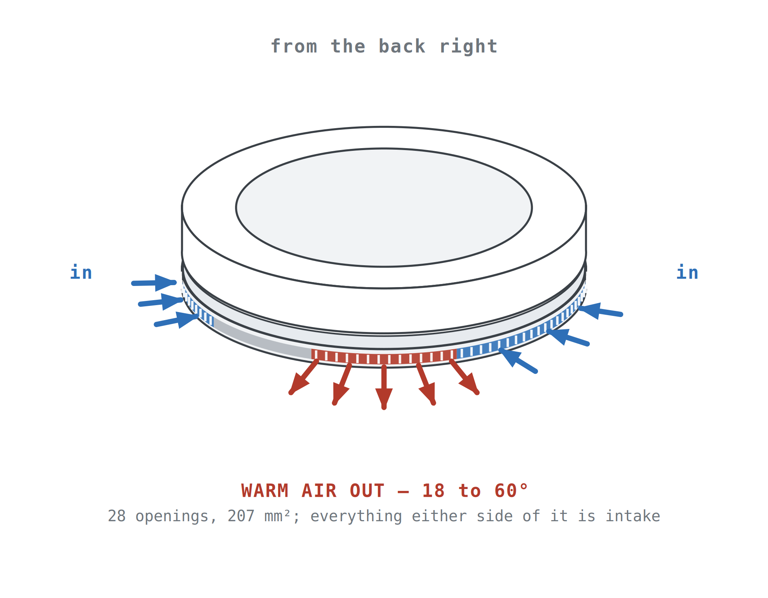
design/artwork/cooling/the60_v15_cooling_f4_back.png
