Ryan365Apps/spotify-knob/design/artwork/cooling/the60_v15_cooling_f5_section.png

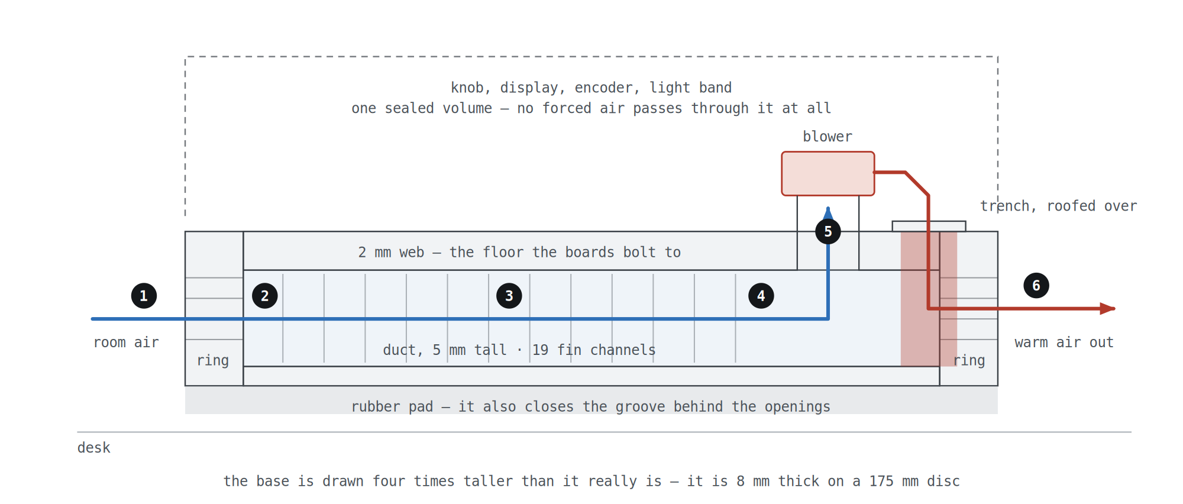
design/artwork/cooling/the60_v15_cooling_f5_section.png
