Ryan365Apps/spotify-knob/design/artwork/drawings/the60_v9_D02_light_display_encoder.png

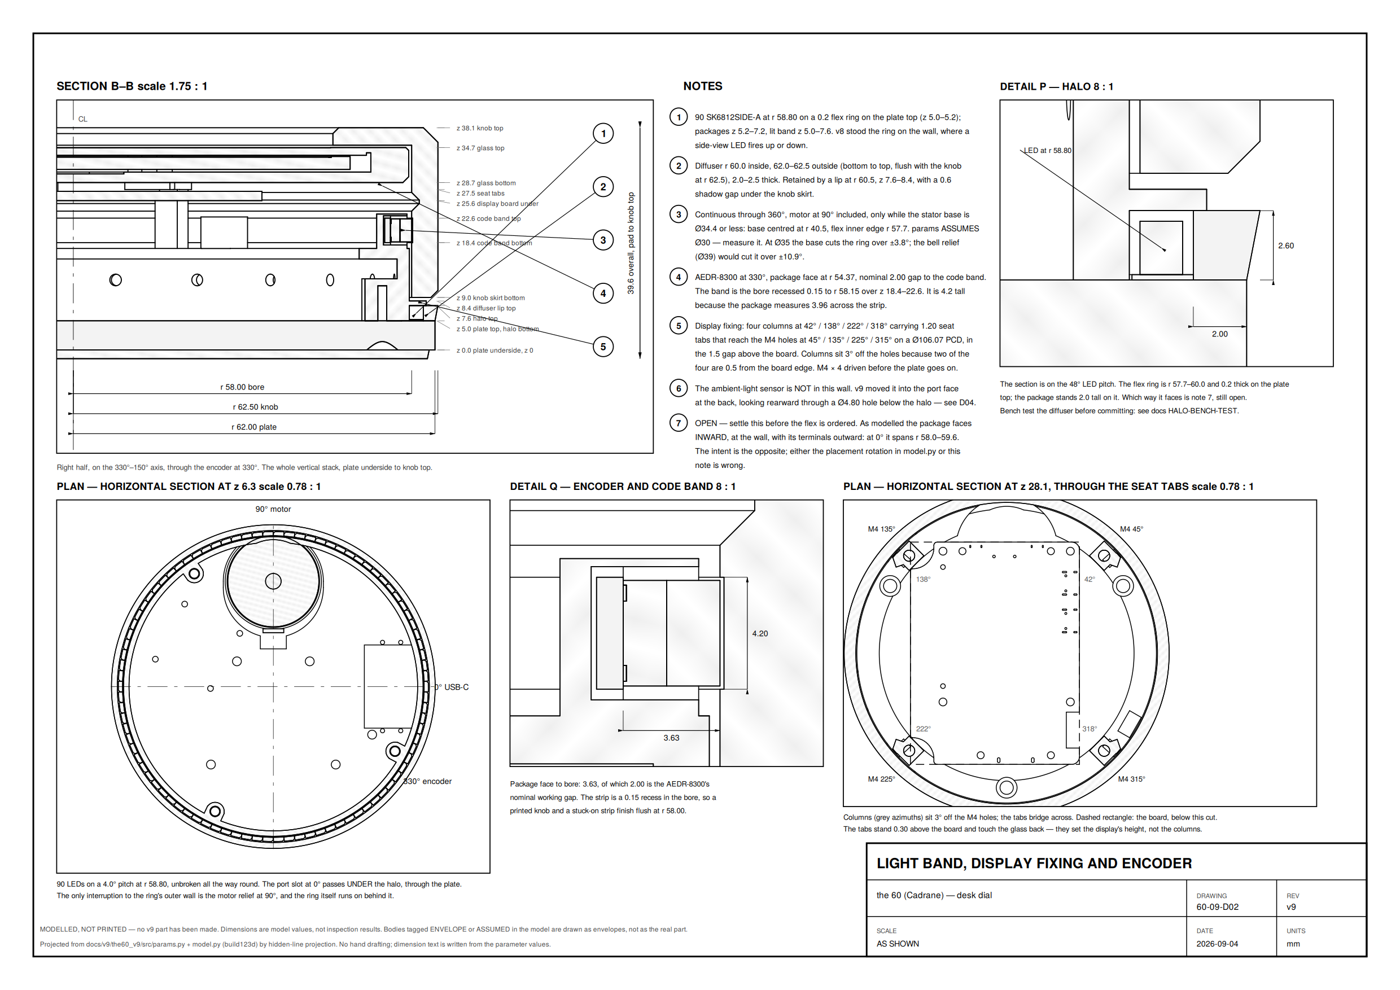
design/artwork/drawings/the60_v9_D02_light_display_encoder.png
