Ryan365Apps/spotify-knob/design/artwork/drawings/the60_v9_D04_plate_floor_ports.png

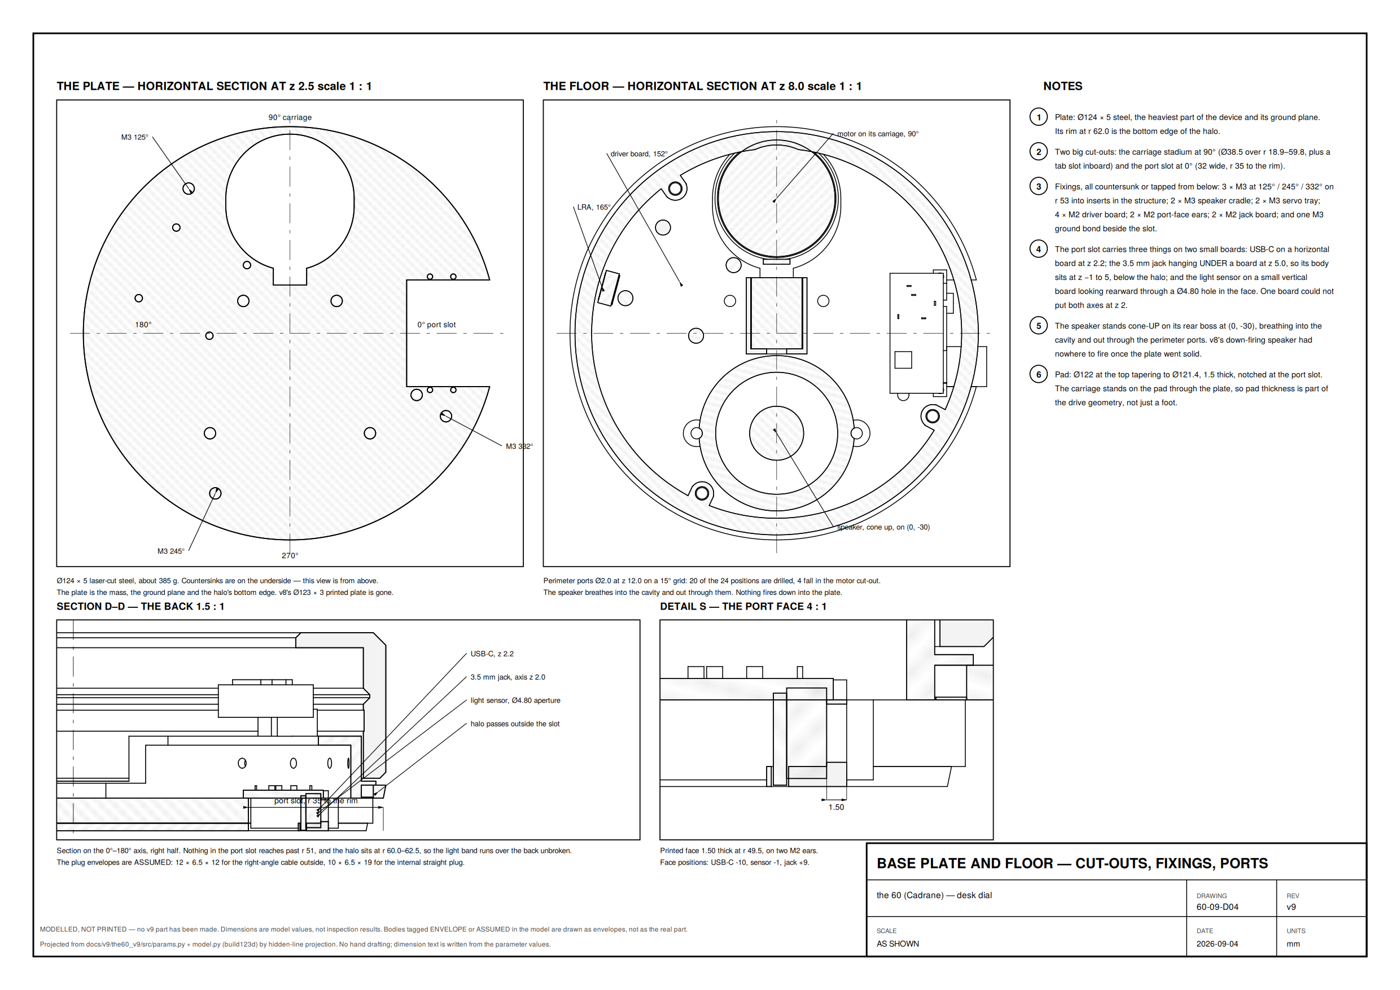
design/artwork/drawings/the60_v9_D04_plate_floor_ports.png
