Ryan365Apps/spotify-knob/design/artwork/drawings/the60_v15_D01_knob_support.png

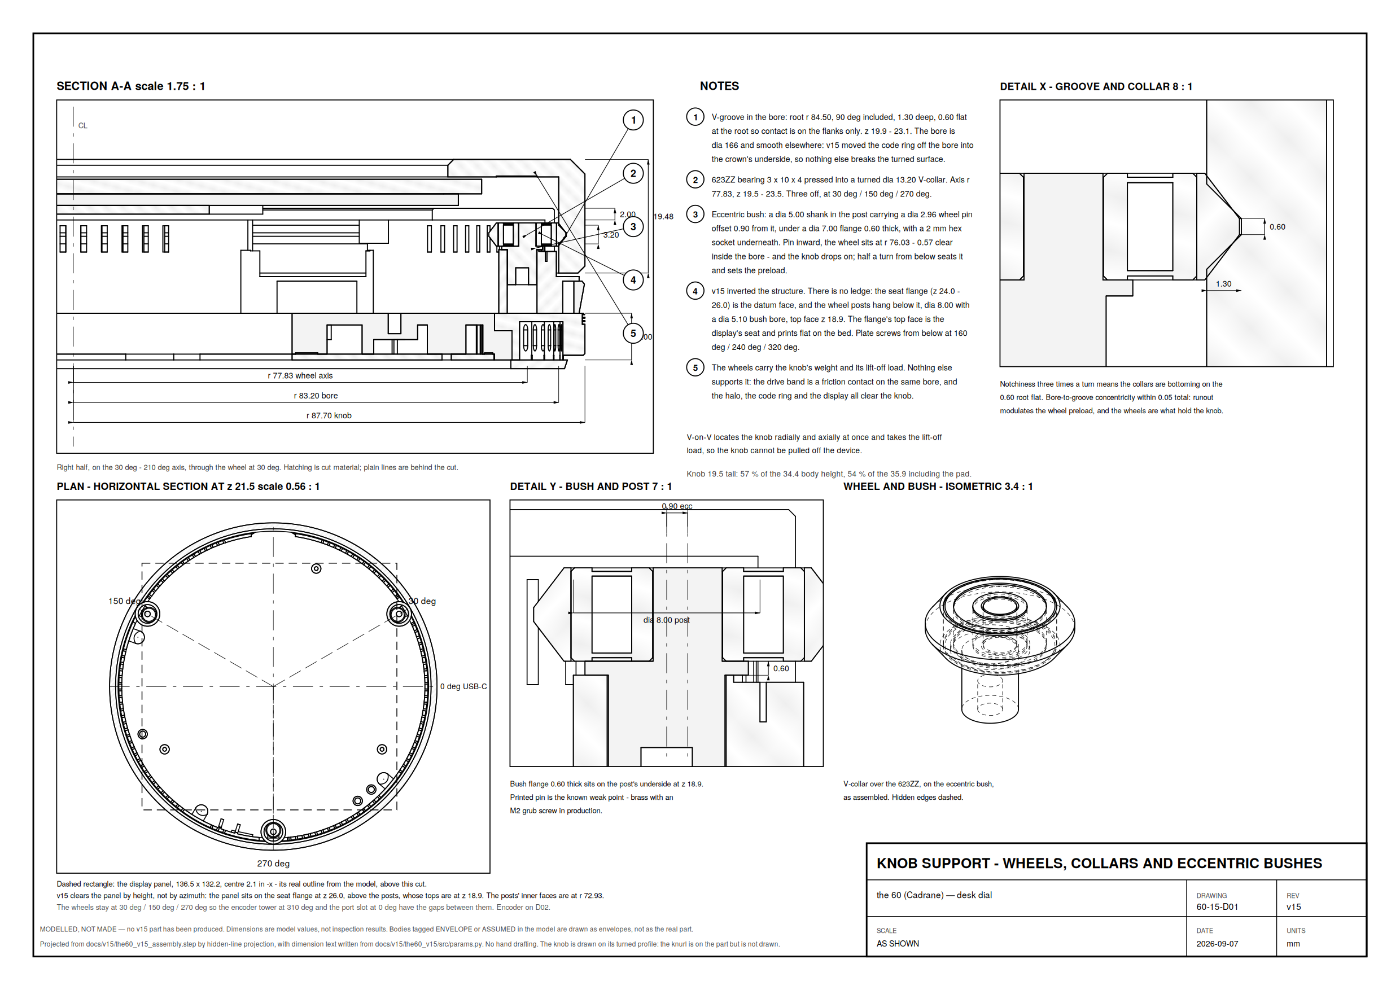
design/artwork/drawings/the60_v15_D01_knob_support.png
