Ryan365Apps/spotify-knob/design/artwork/drawings/the60_v15_D03_drive_clutch.png

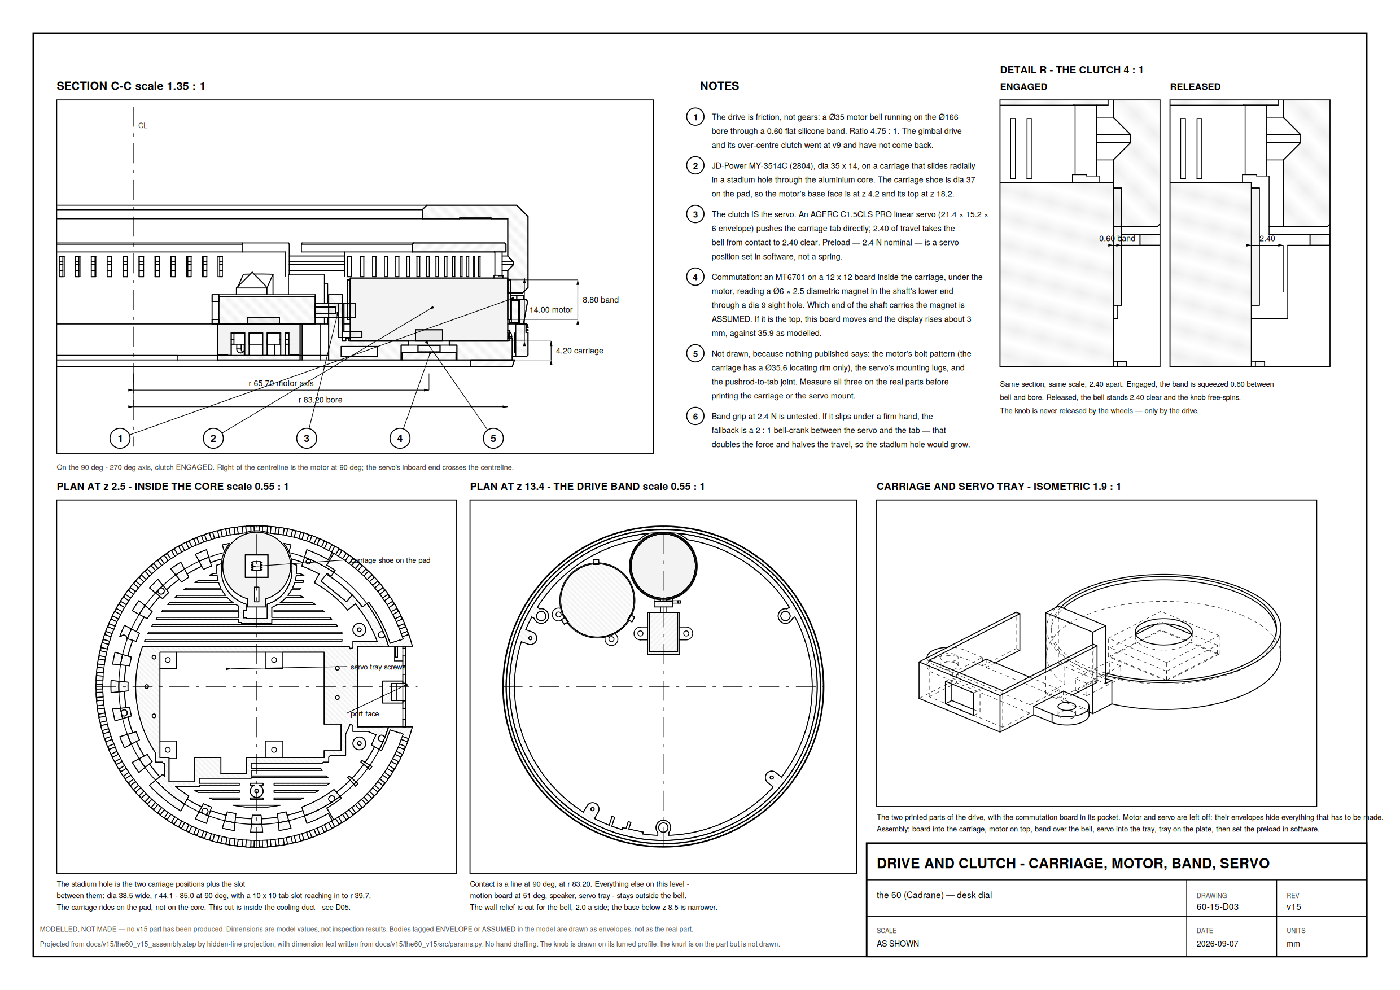
design/artwork/drawings/the60_v15_D03_drive_clutch.png
