Ryan365Apps/spotify-knob/design/artwork/drawings/the60_v15_D04_core_rim_ports.png

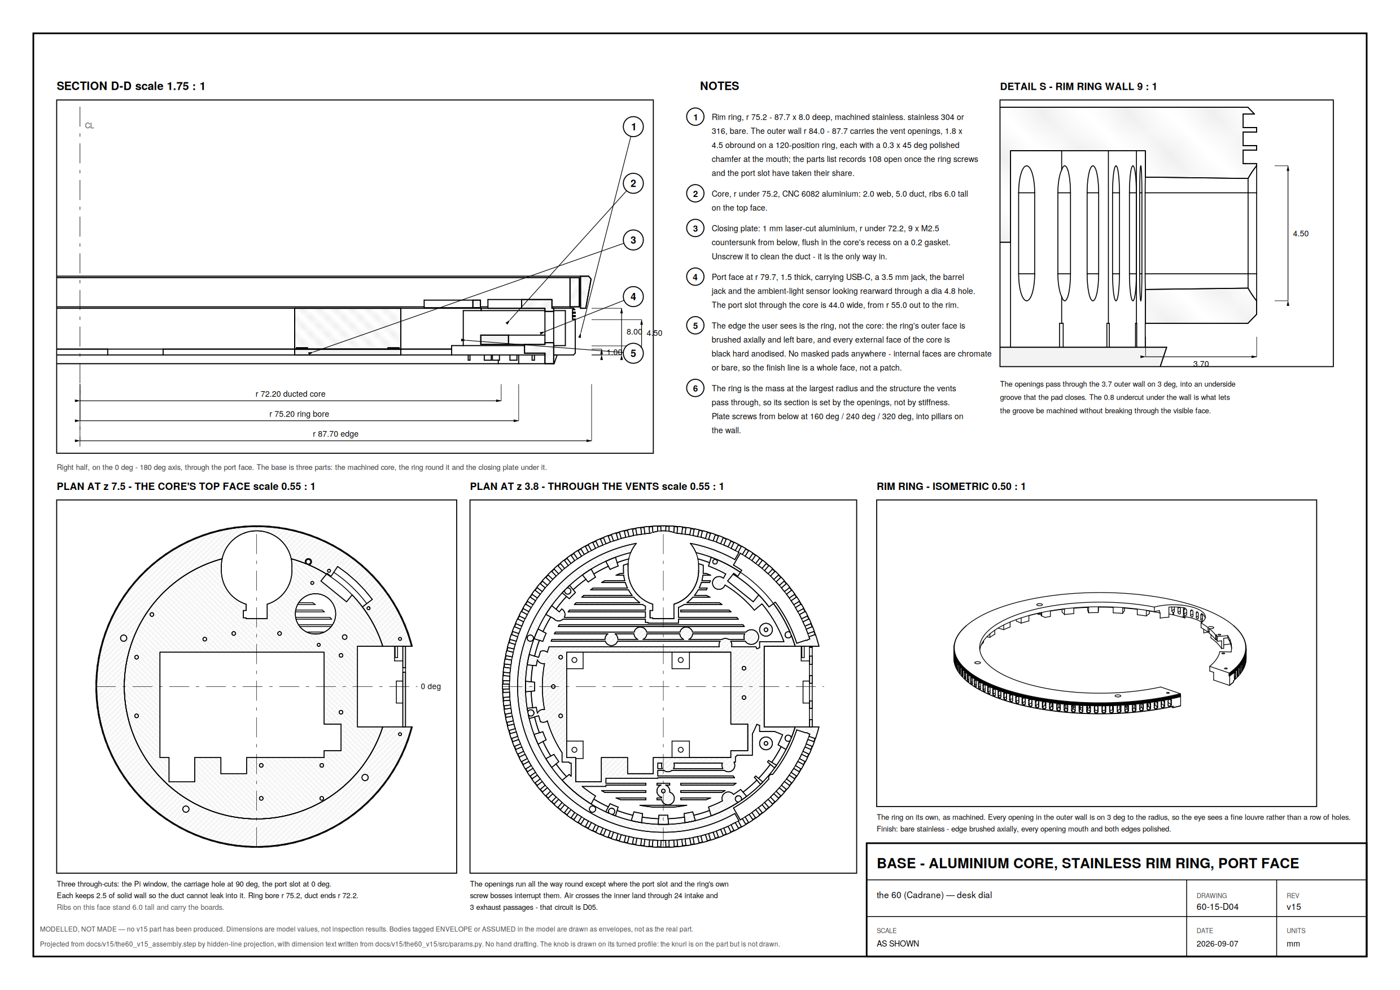
design/artwork/drawings/the60_v15_D04_core_rim_ports.png
