Ryan365Apps/spotify-knob/design/artwork/drawings/the60_v15_D05_cooling.png

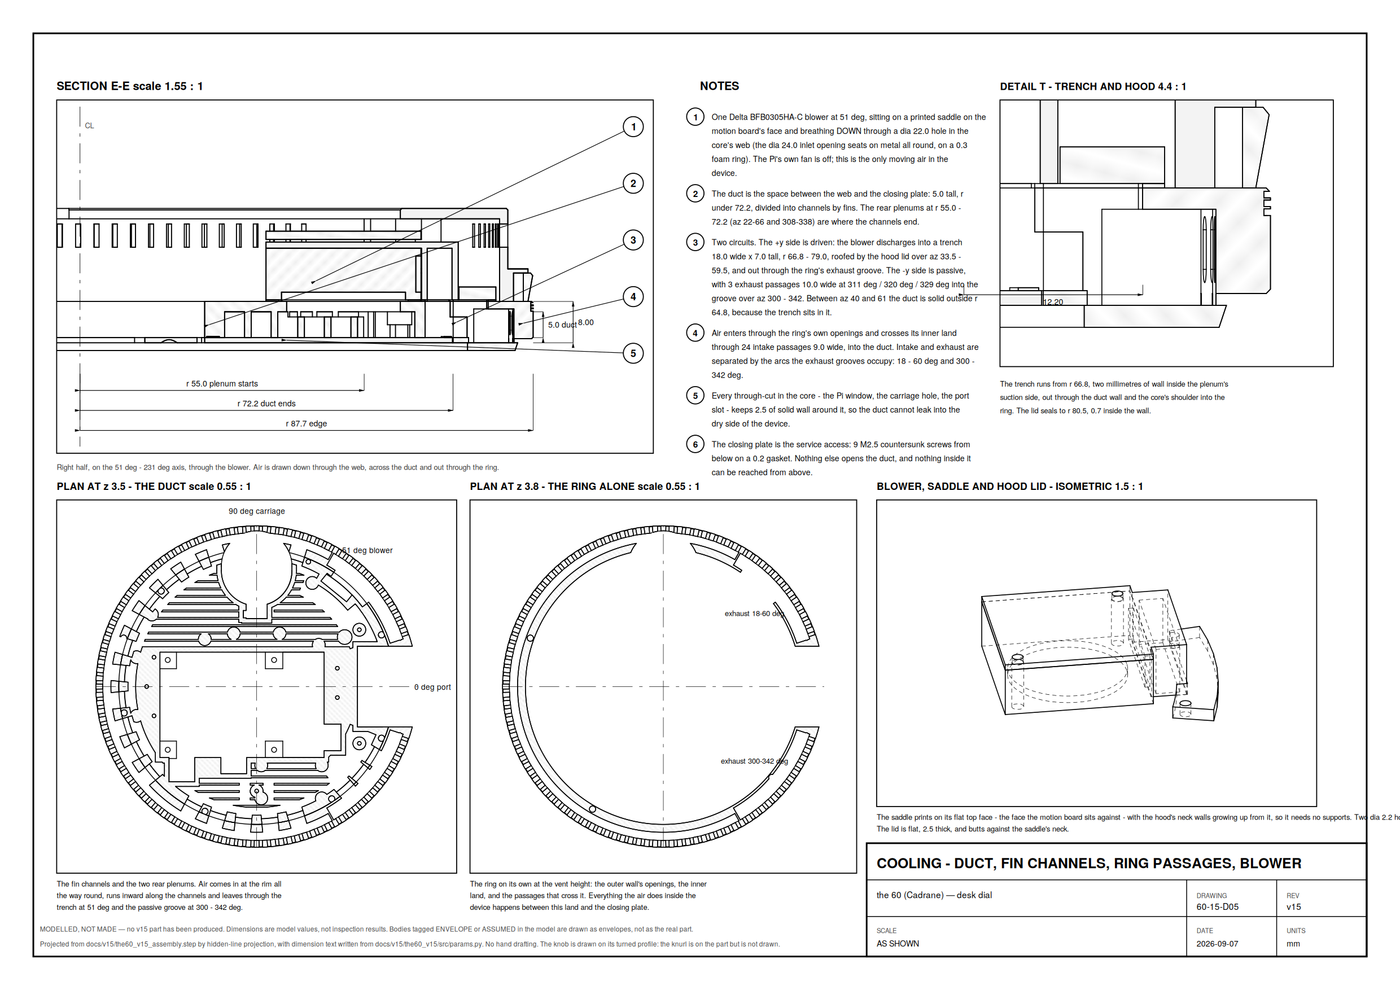
design/artwork/drawings/the60_v15_D05_cooling.png
