Ryan365Apps/spotify-knob/design/artwork/examples/backgrounds/bg_blueprint.png

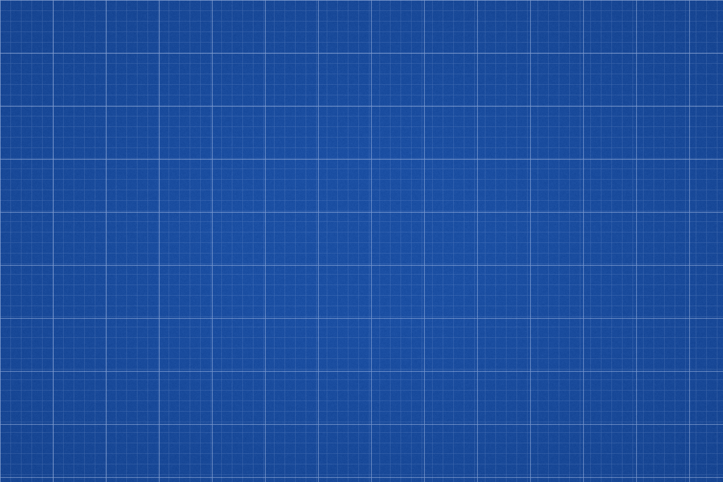
design/artwork/examples/backgrounds/bg_blueprint.png
