Ryan365Apps/spotify-knob/design/artwork/examples/backgrounds/bg_blueprint_reel.png

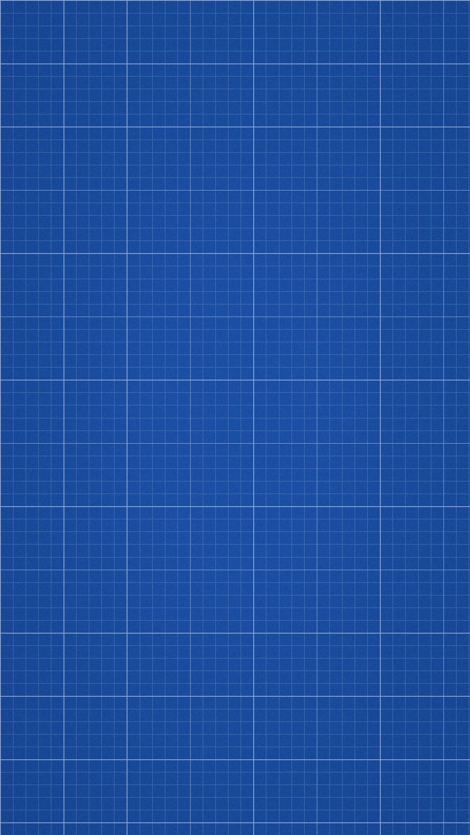
design/artwork/examples/backgrounds/bg_blueprint_reel.png
