Ryan365Apps/spotify-knob/design/artwork/examples/backgrounds/bg_neonhex.png

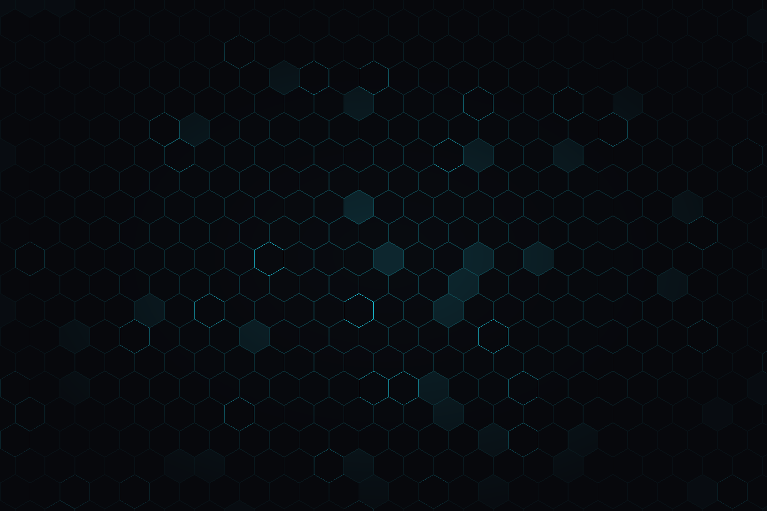
design/artwork/examples/backgrounds/bg_neonhex.png
