Ryan365Apps/spotify-knob/design/artwork/examples/mechanisms/00-plan-floor.png

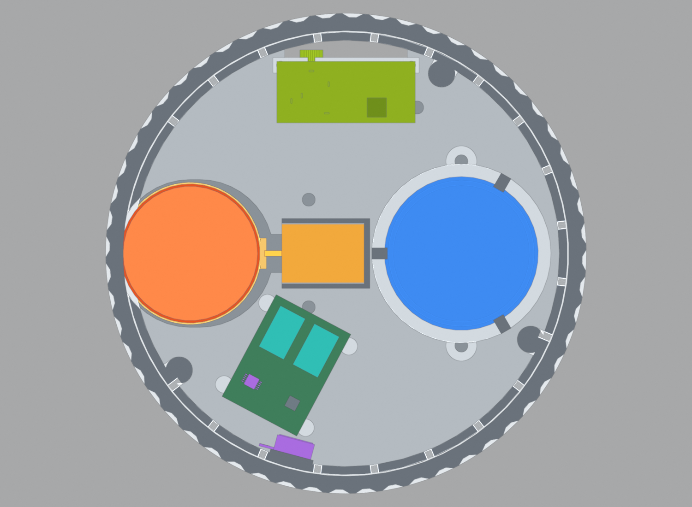
design/artwork/examples/mechanisms/00-plan-floor.png
