Ryan365Apps/spotify-knob/design/artwork/examples/mechanisms/00b-plan-board.png

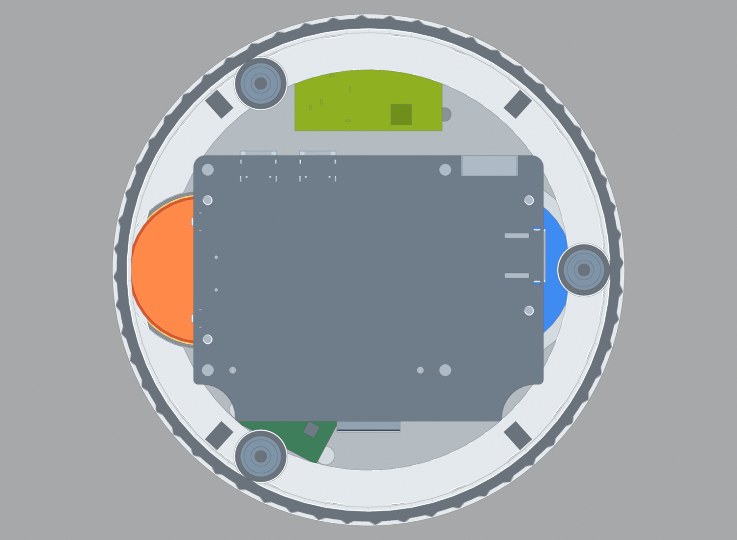
design/artwork/examples/mechanisms/00b-plan-board.png
