Ryan365Apps/spotify-knob/design/artwork/examples/mechanisms/01-drive.png

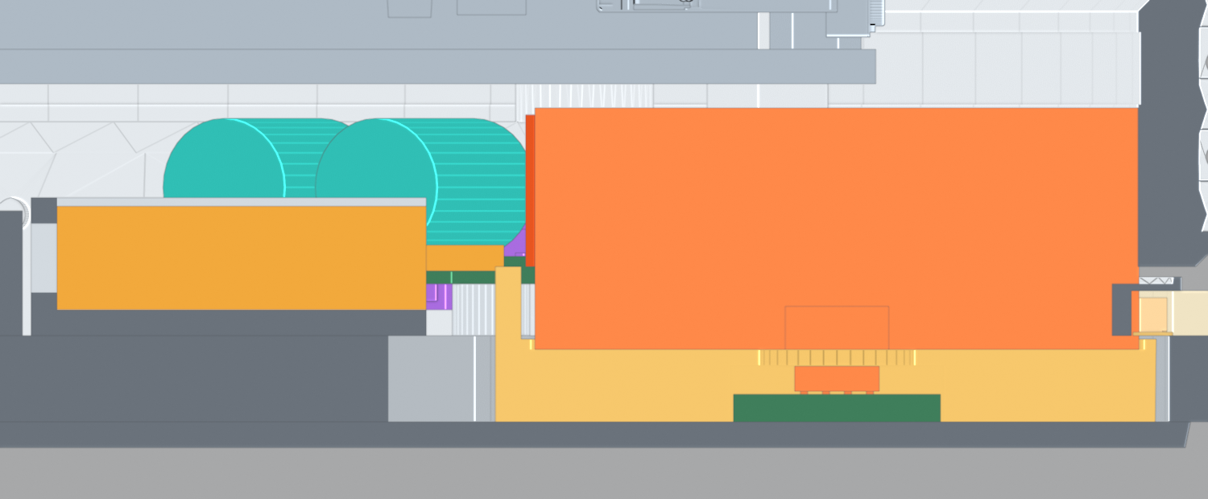
design/artwork/examples/mechanisms/01-drive.png
