Ryan365Apps/spotify-knob/design/artwork/examples/mechanisms/02-encoder.png

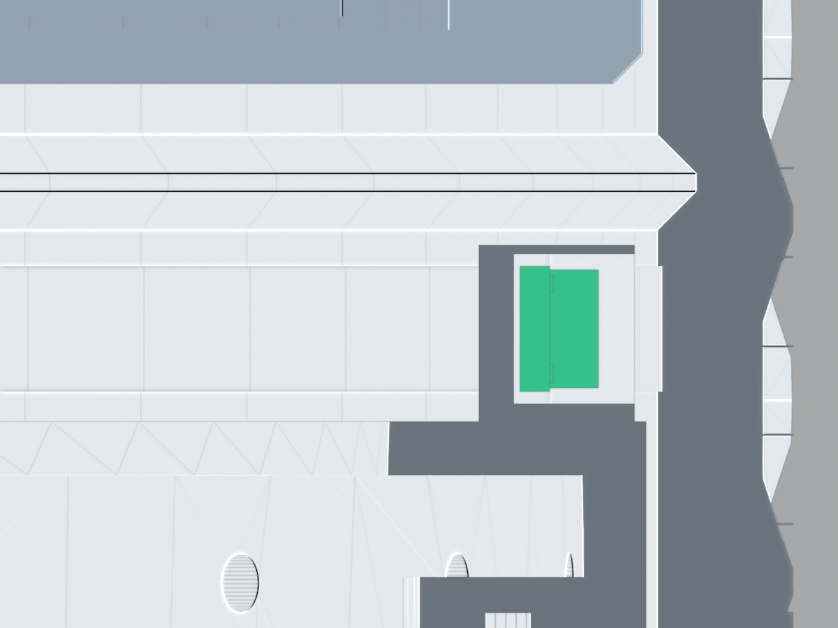
design/artwork/examples/mechanisms/02-encoder.png
