Ryan365Apps/spotify-knob/design/artwork/examples/mechanisms/03-wheels.png

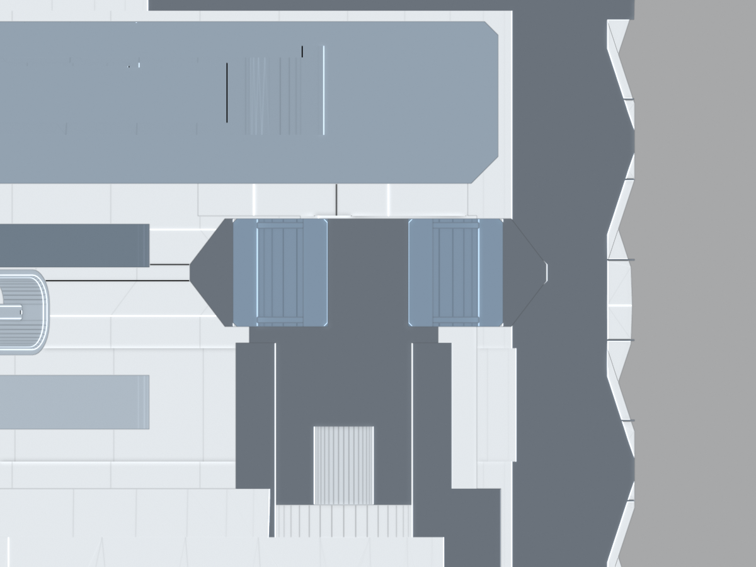
design/artwork/examples/mechanisms/03-wheels.png
