Ryan365Apps/spotify-knob/design/artwork/examples/mechanisms/04-ports.png

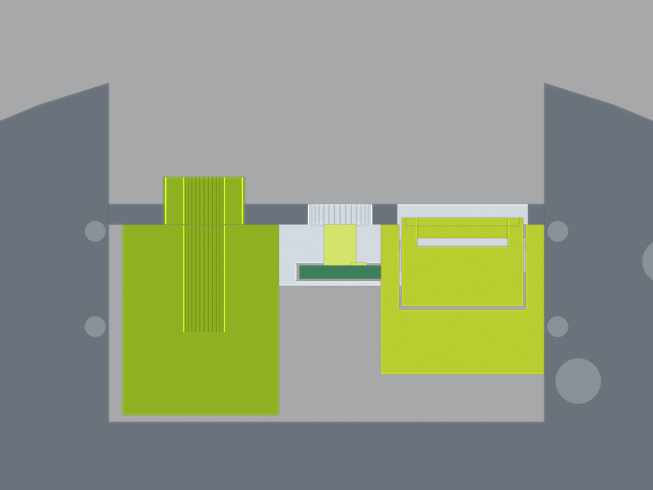
design/artwork/examples/mechanisms/04-ports.png
