Ryan365Apps/spotify-knob/design/artwork/examples/mechanisms/05-halo.png

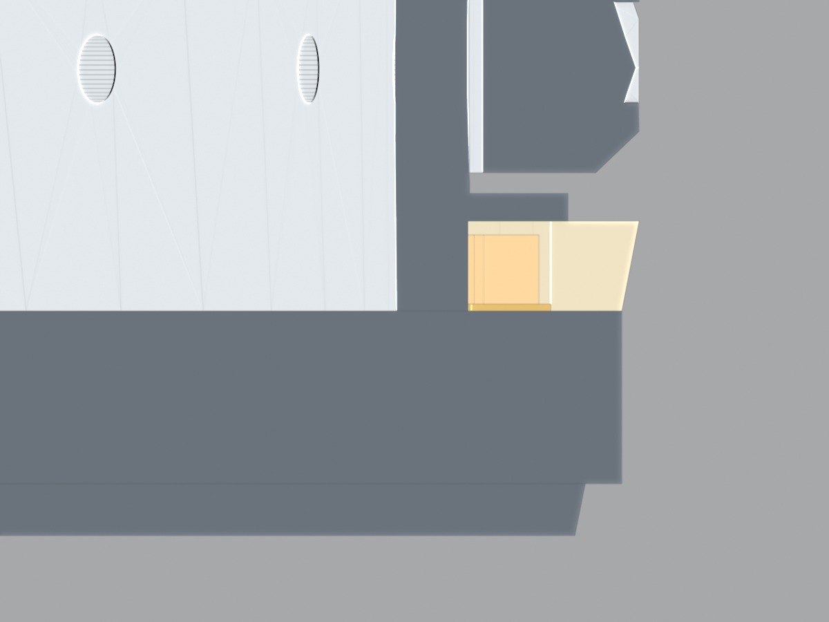
design/artwork/examples/mechanisms/05-halo.png
