Ryan365Apps/spotify-knob/design/artwork/examples/mechanisms/06-bay.png

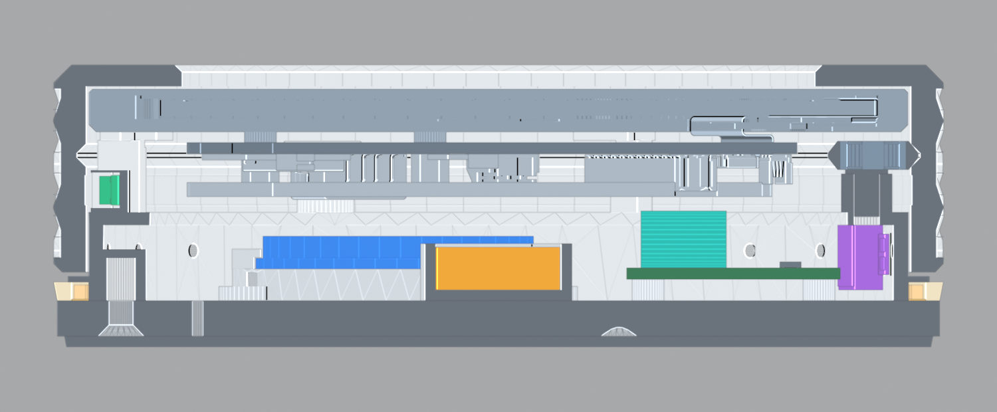
design/artwork/examples/mechanisms/06-bay.png
