Ryan365Apps/spotify-knob/design/artwork/examples/mechanisms/07-speaker.png

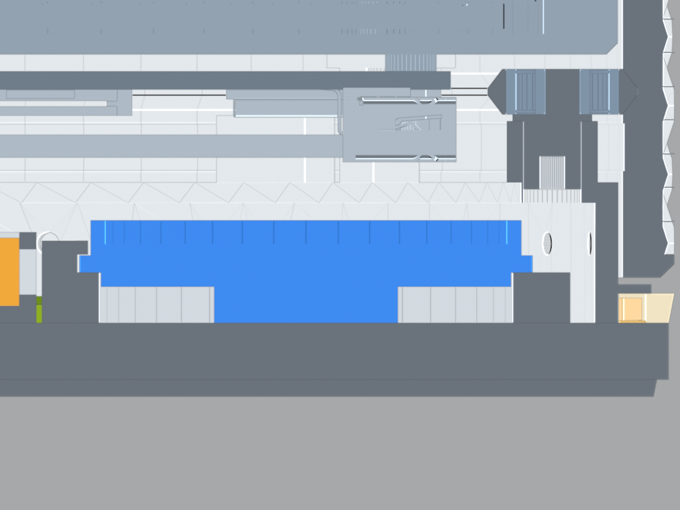
design/artwork/examples/mechanisms/07-speaker.png
