Ryan365Apps/spotify-knob/design/artwork/examples/mechanisms/08-display.png

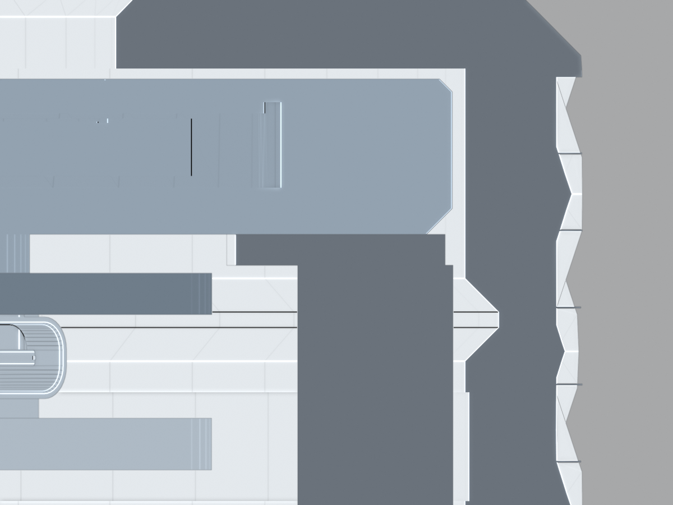
design/artwork/examples/mechanisms/08-display.png
