Ryan365Apps/spotify-knob/design/artwork/examples/styles/bg_drafting.png

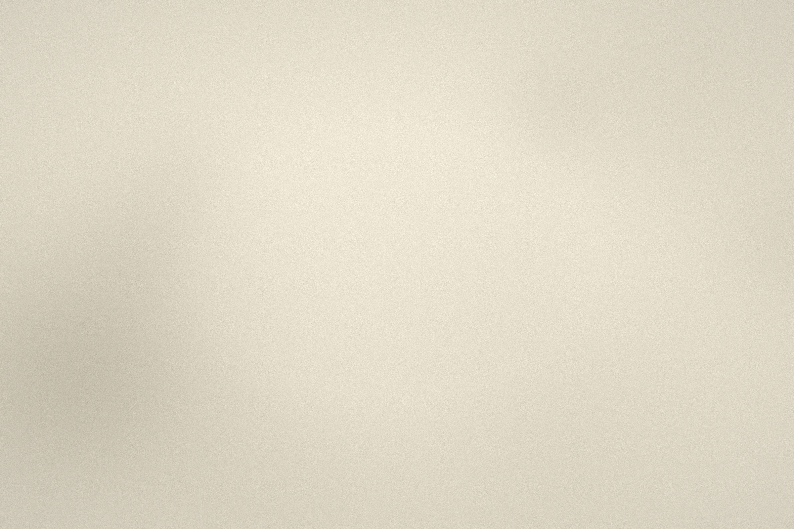
design/artwork/examples/styles/bg_drafting.png
