Ryan365Apps/spotify-knob/design/artwork/examples/styles/bg_topo.png

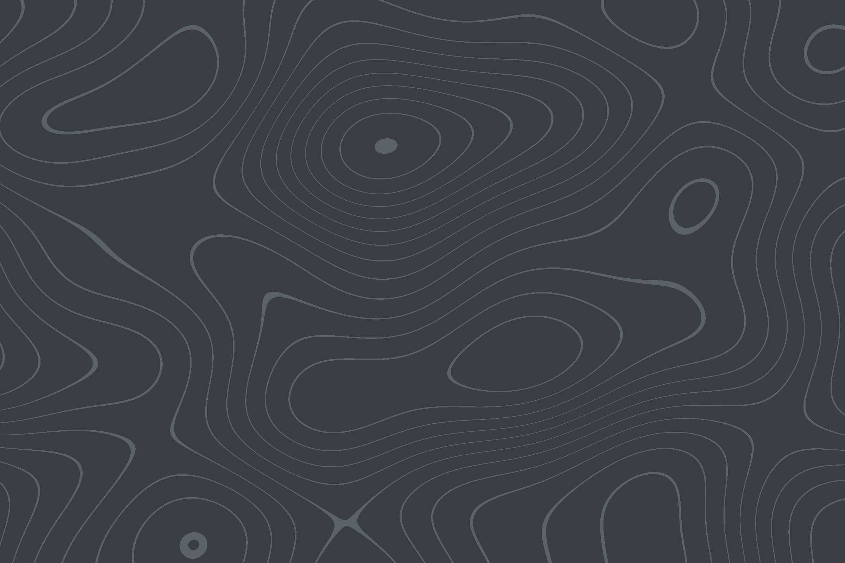
design/artwork/examples/styles/bg_topo.png
