Ryan365Apps/spotify-knob/design/artwork/examples/styles/the60_halo_dark_red_high.png

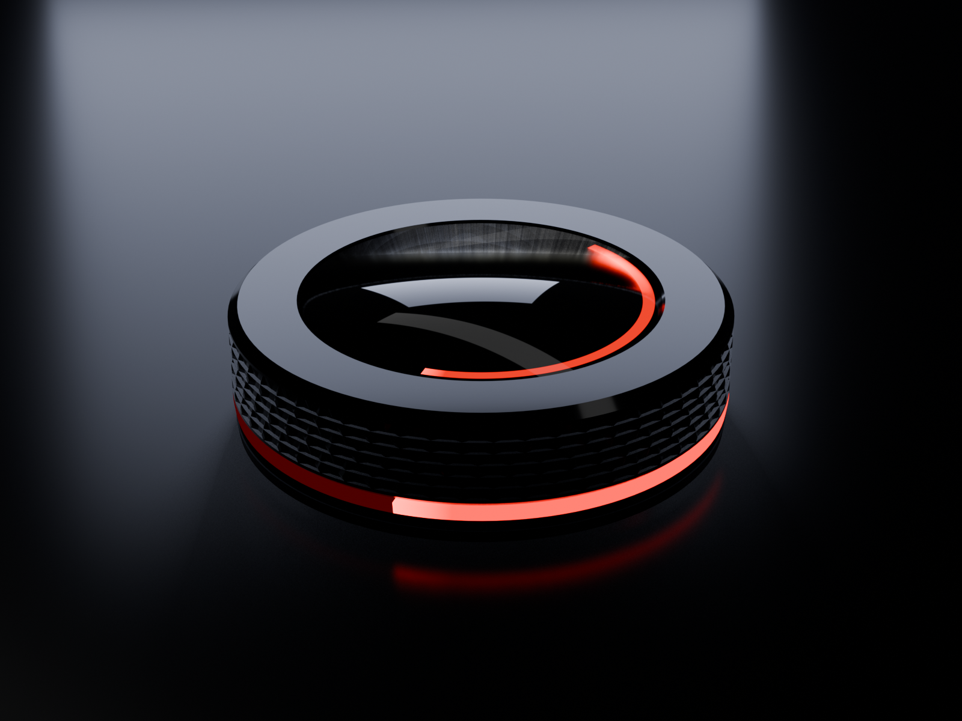
design/artwork/examples/styles/the60_halo_dark_red_high.png
