Ryan365Apps/spotify-knob/design/artwork/examples/styles/the60_style_drafting.png

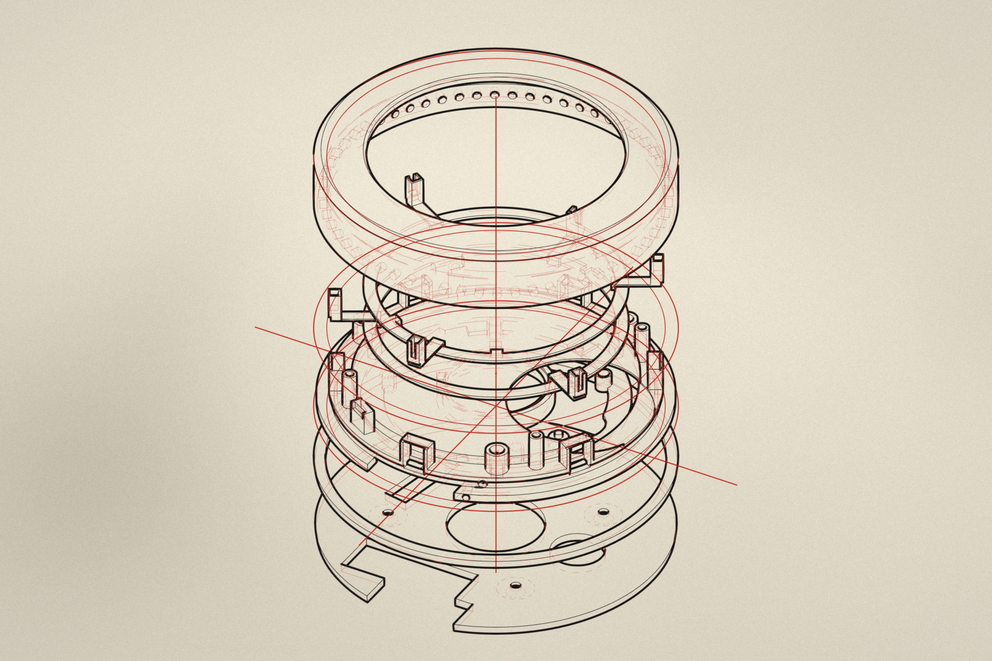
design/artwork/examples/styles/the60_style_drafting.png
