Ryan365Apps/spotify-knob/design/artwork/examples/styles/the60_style_restomod.png

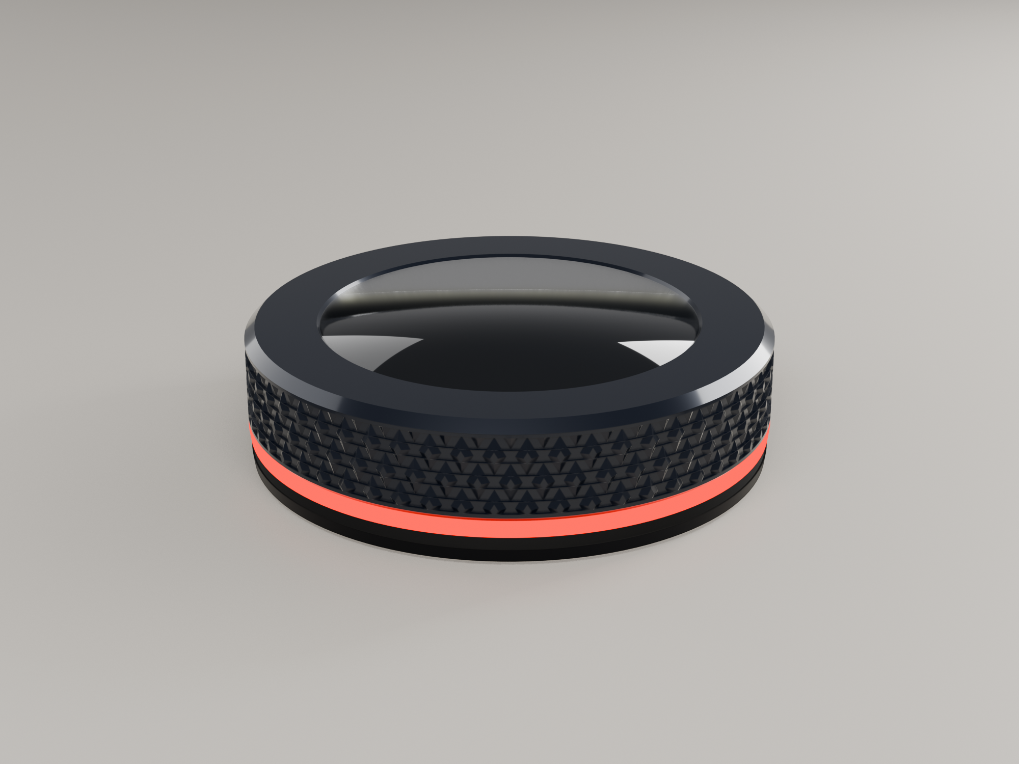
design/artwork/examples/styles/the60_style_restomod.png
