Ryan365Apps/spotify-knob/design/artwork/examples/styles/the60_style_voidcyan.png

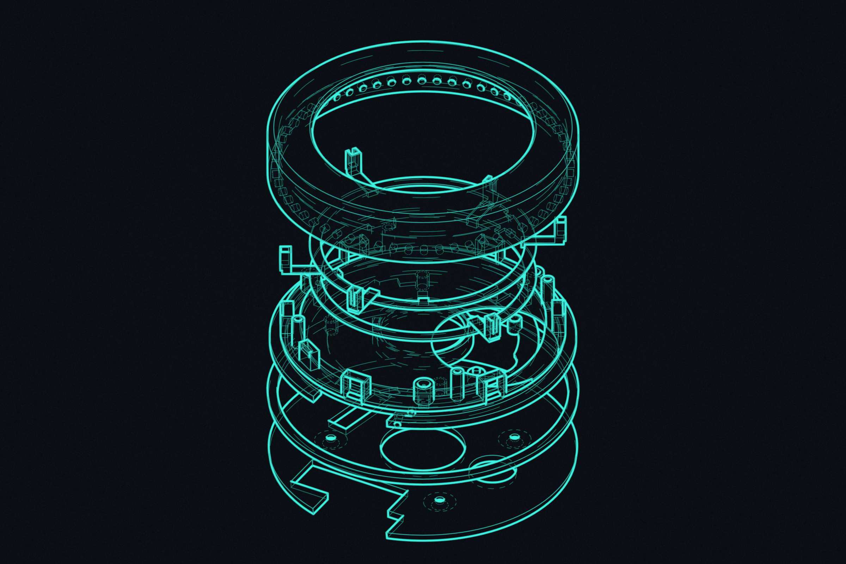
design/artwork/examples/styles/the60_style_voidcyan.png
