Ryan365Apps/spotify-knob/design/artwork/examples/the60_style_blueprint.png

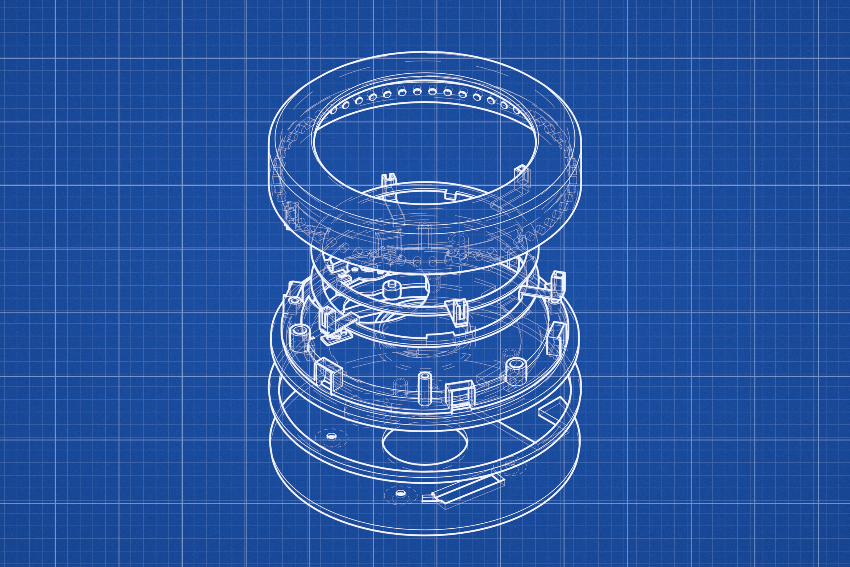
design/artwork/examples/the60_style_blueprint.png
