Ryan365Apps/spotify-knob/design/artwork/examples/the60_style_neon.png

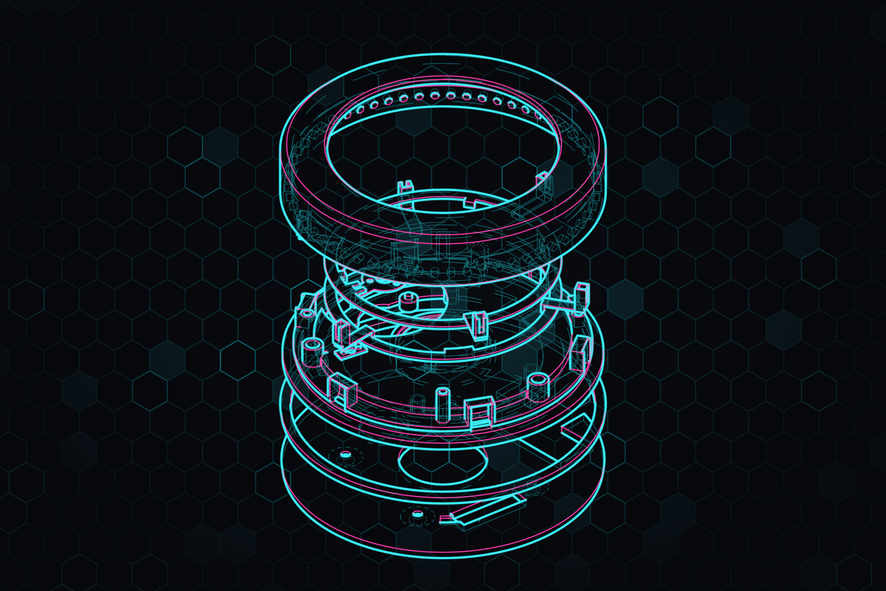
design/artwork/examples/the60_style_neon.png
