Ryan365Apps/spotify-knob/design/cad/Screenshot 2026-09-04 134900.png

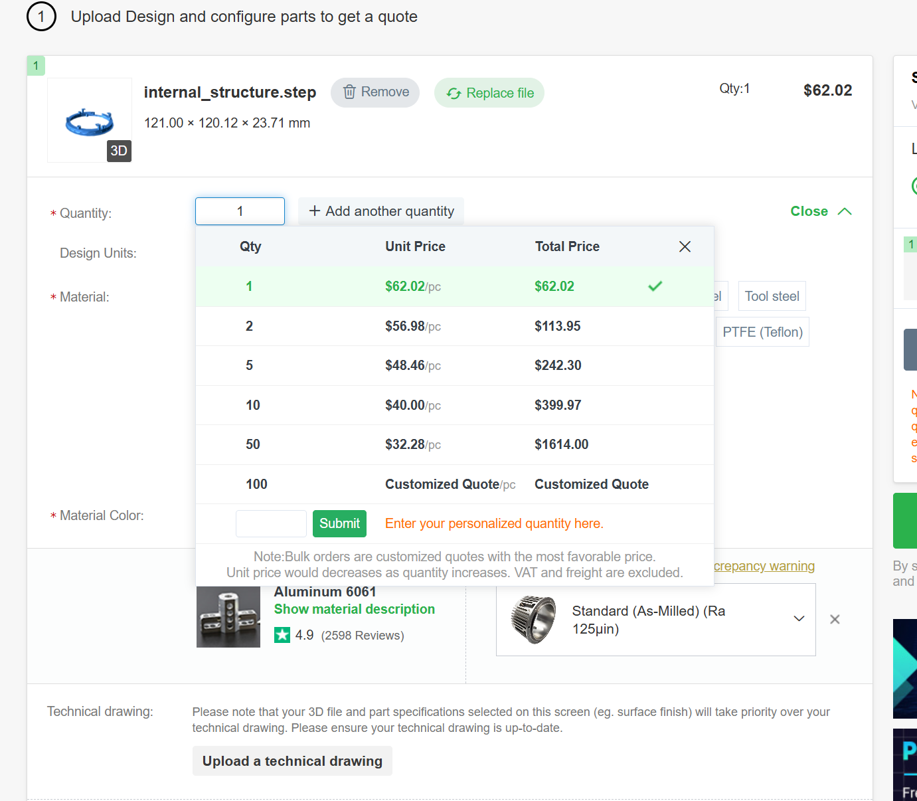
design/cad/Screenshot 2026-09-04 134900.png
