Ryan365Apps/spotify-knob/design/cad/Screenshot 2026-09-04 135155.png

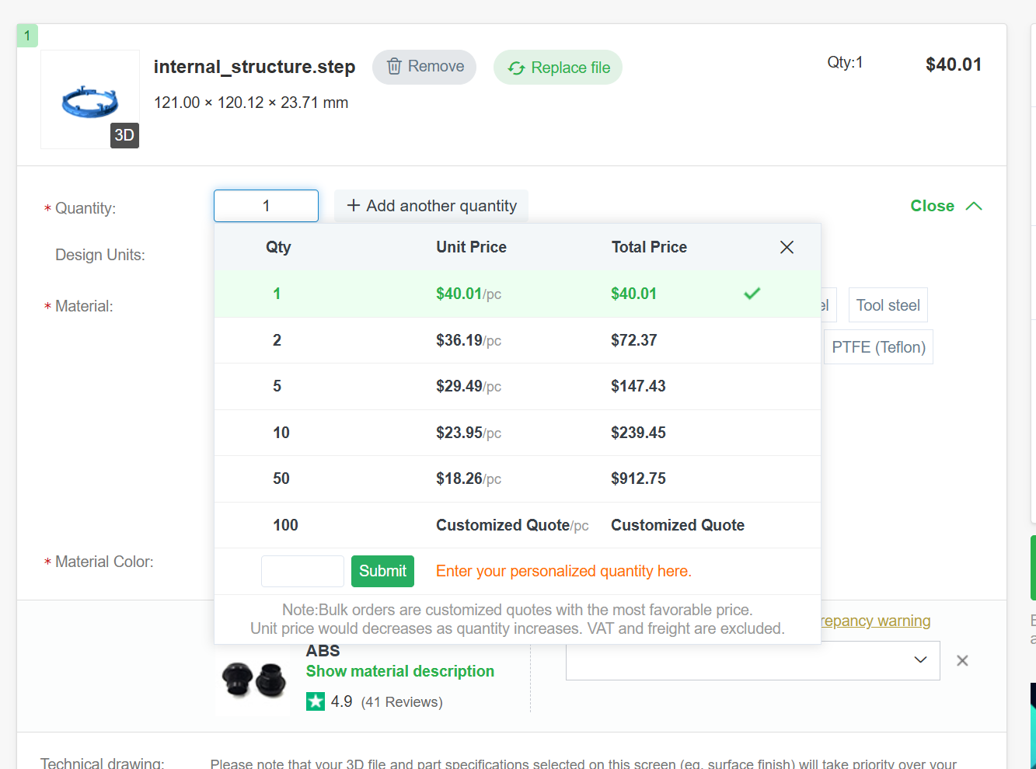
design/cad/Screenshot 2026-09-04 135155.png
