Ryan365Apps/spotify-knob/design/Inspo/520185365_18395897497142578_2249028449429294466_n.jpg

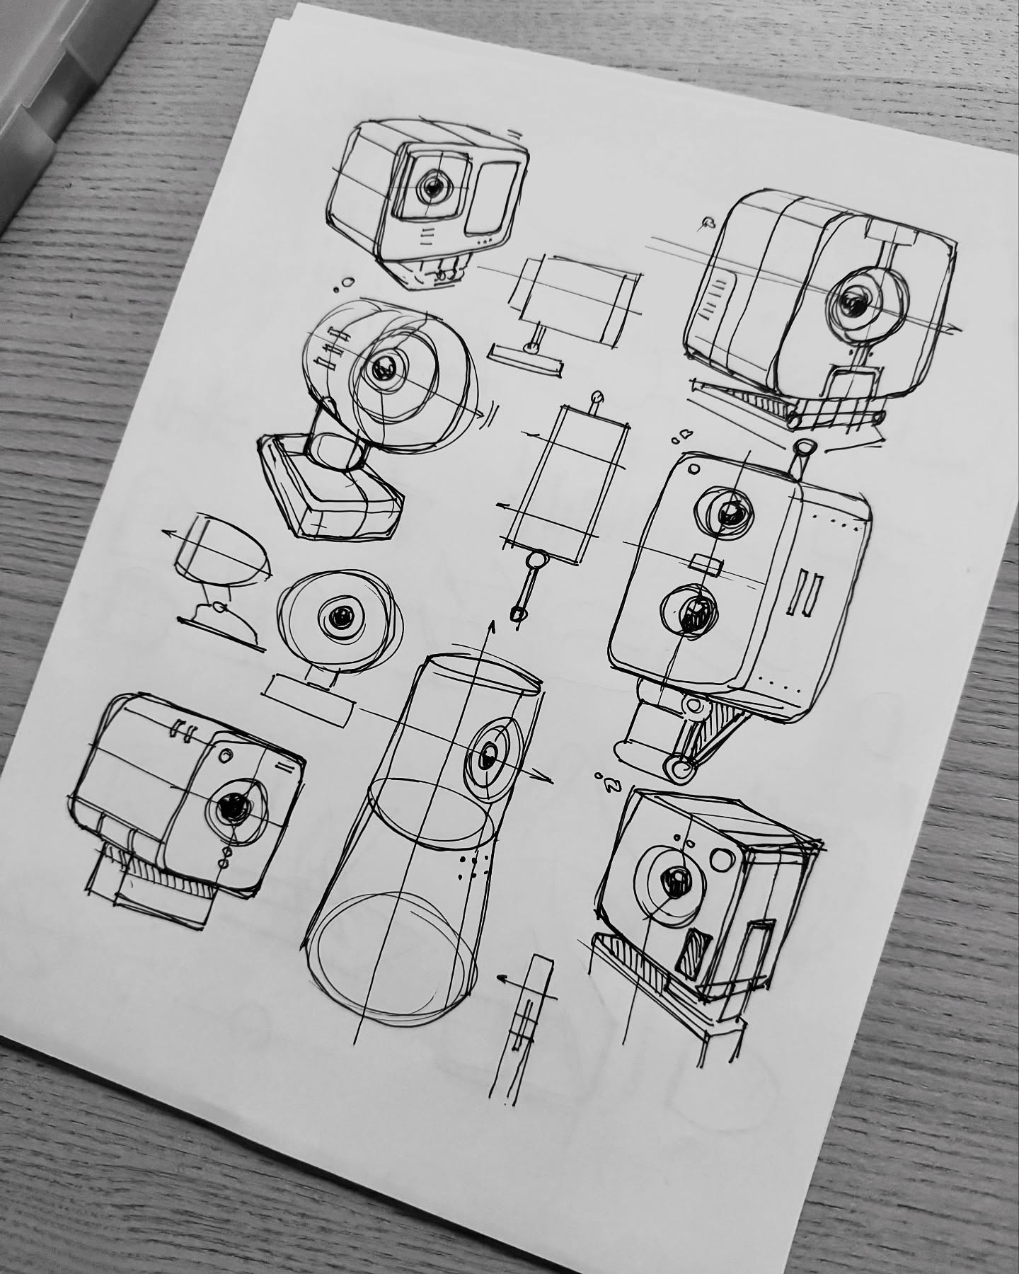
design/Inspo/520185365_18395897497142578_2249028449429294466_n.jpg
