Ryan365Apps/spotify-knob/design/Inspo/574552094_18541368268051372_2986126245315958307_n.jpg

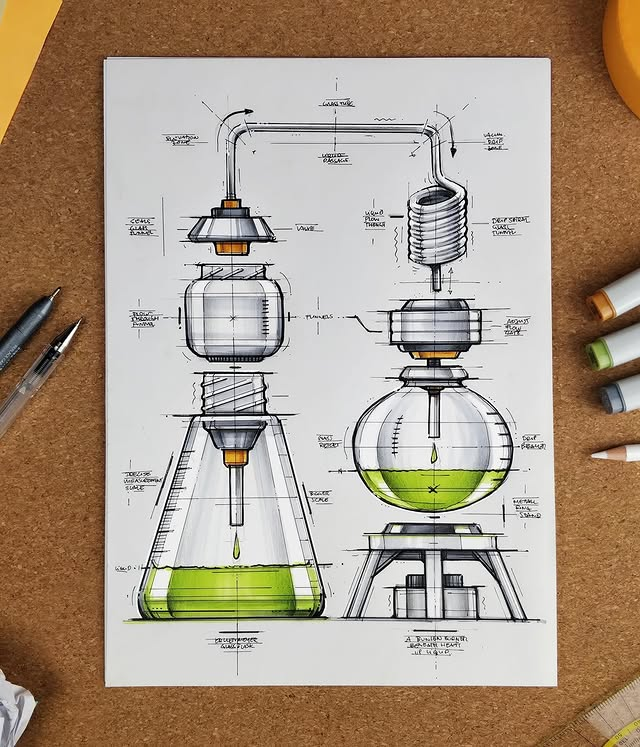
design/Inspo/574552094_18541368268051372_2986126245315958307_n.jpg
