Ryan365Apps/spotify-knob/design/Inspo/625957120_18087348311114973_8390351734927605885_n.jpg

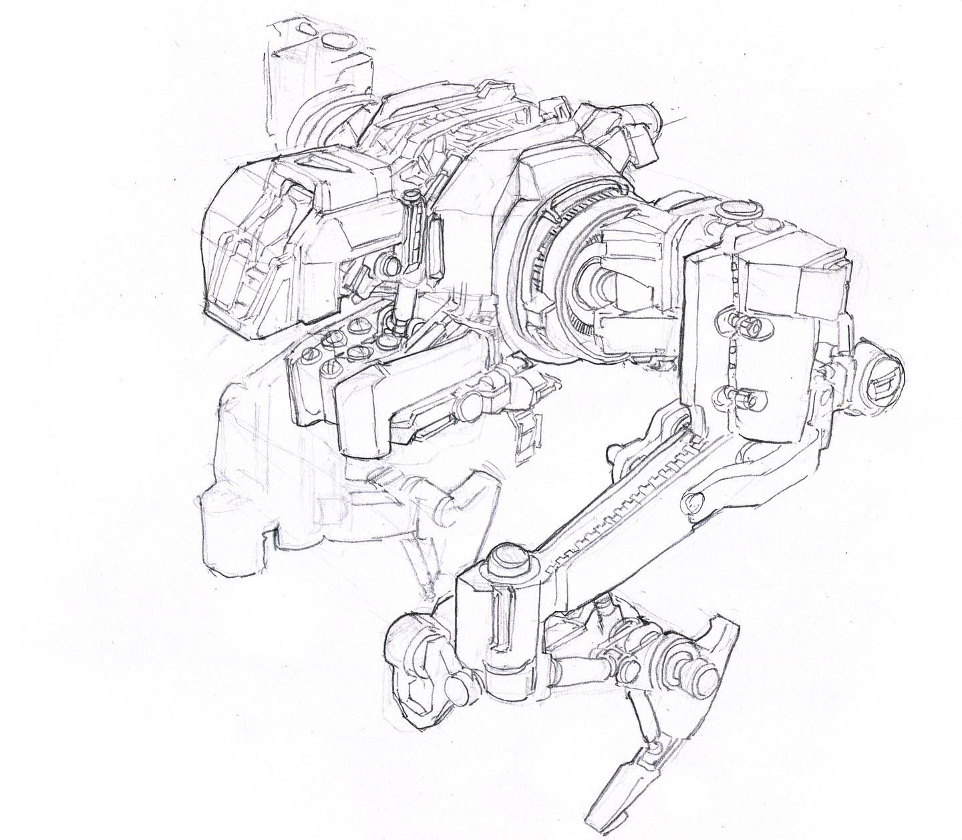
design/Inspo/625957120_18087348311114973_8390351734927605885_n.jpg
