Ryan365Apps/spotify-knob/design/Inspo/654204351_18124506049519743_8417315467332372778_n.jpg

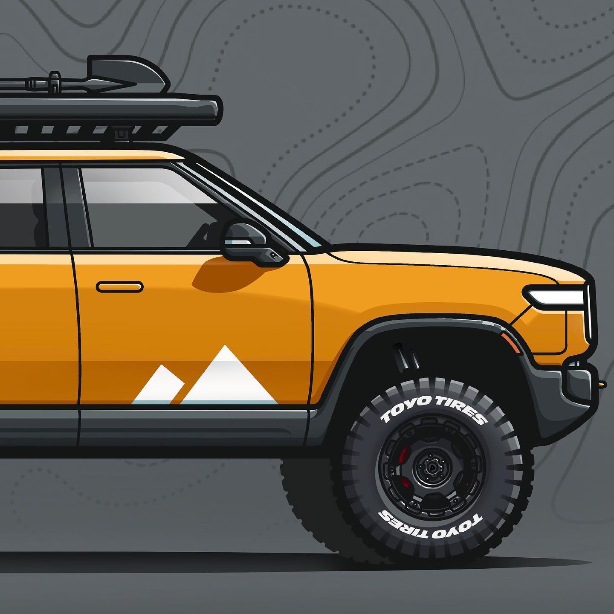
design/Inspo/654204351_18124506049519743_8417315467332372778_n.jpg
