Ryan365Apps/spotify-knob/design/Inspo/download.webp

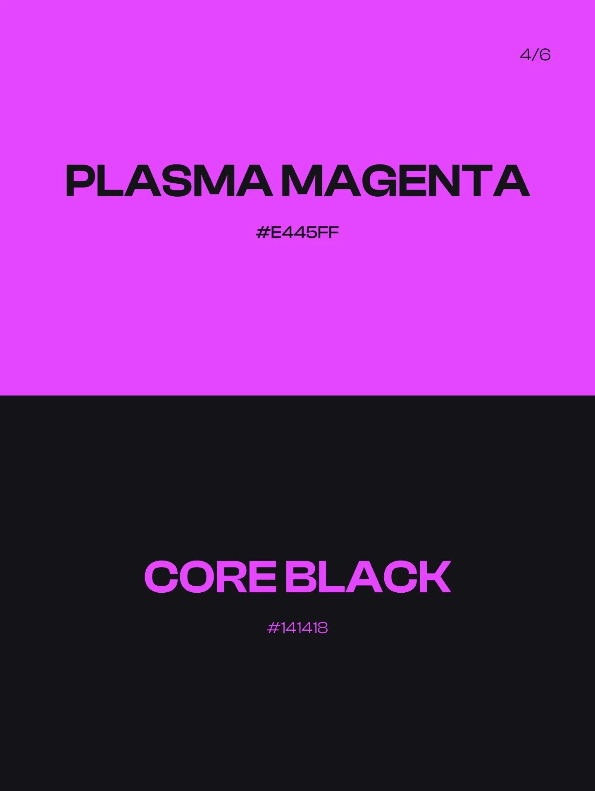
design/Inspo/download.webp
