Ryan365Apps/spotify-knob/design/Inspo/moodboard/ig_audif1fans_DRfJU7bjFib_20260902T225554_01.jpg

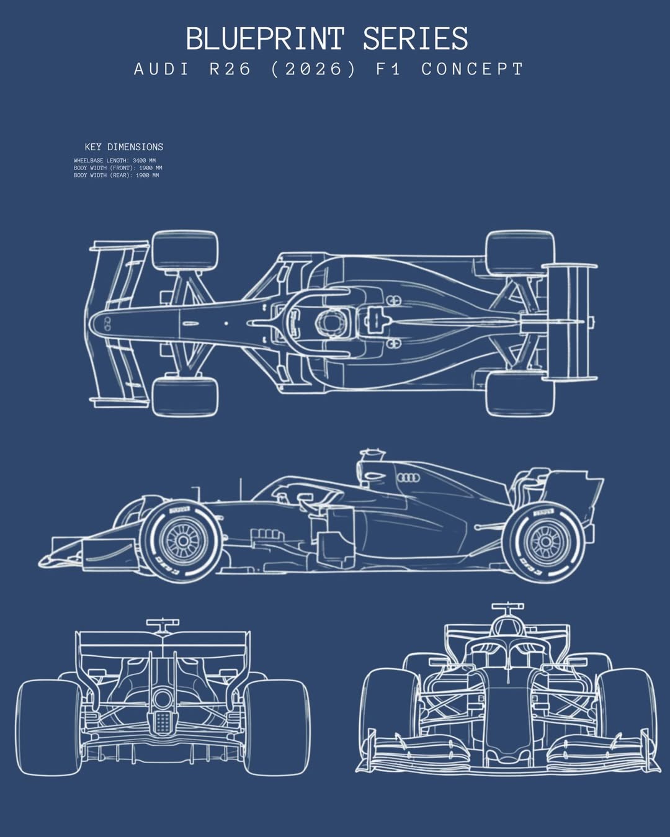
design/Inspo/moodboard/ig_audif1fans_DRfJU7bjFib_20260902T225554_01.jpg
