Ryan365Apps/spotify-knob/design/Inspo/moodboard/ig_browncarguy_DXiRGCZiLv-_20260902T225618_01.jpg

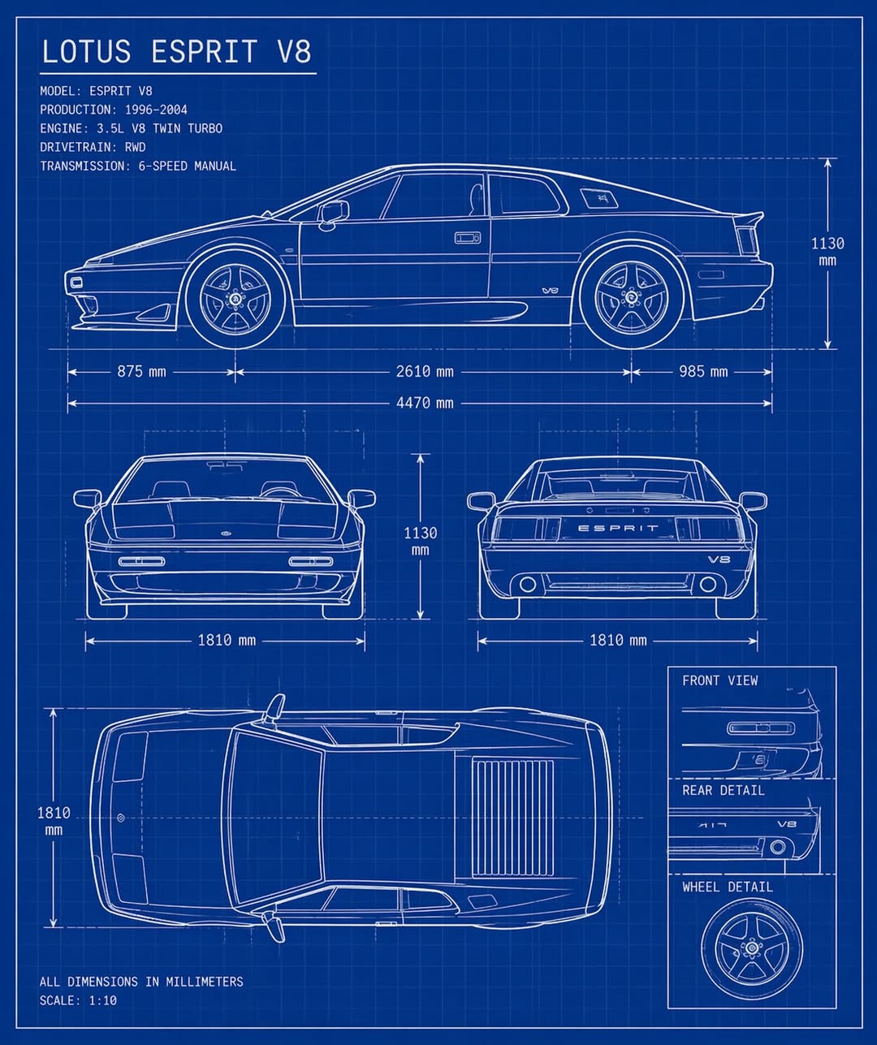
design/Inspo/moodboard/ig_browncarguy_DXiRGCZiLv-_20260902T225618_01.jpg
