Ryan365Apps/spotify-knob/design/Inspo/moodboard/ig_g16bgarage_DYw1BkwD0gM_20260902T225559_01.jpg

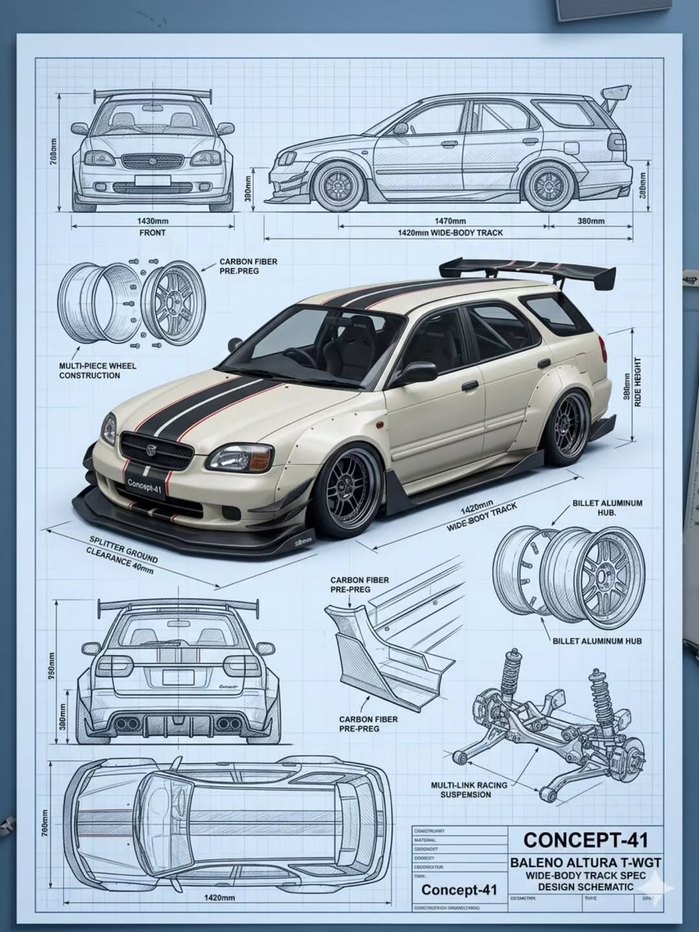
design/Inspo/moodboard/ig_g16bgarage_DYw1BkwD0gM_20260902T225559_01.jpg
