Ryan365Apps/spotify-knob/design/Inspo/moodboard/ig_ig_BsvkTHJj5Rv_20260902T225551_01.jpg

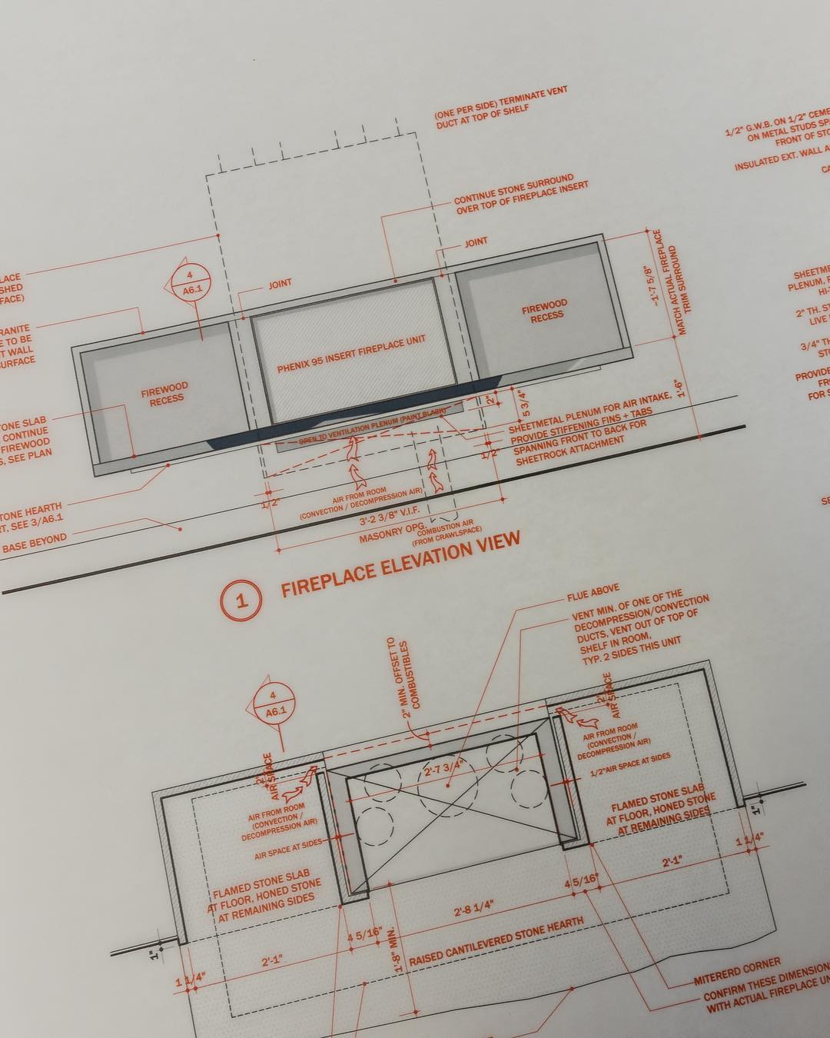
design/Inspo/moodboard/ig_ig_BsvkTHJj5Rv_20260902T225551_01.jpg
