Ryan365Apps/spotify-knob/design/Inspo/moodboard/ig_ig_C--U0DEIdG4_20260902T225328_01.jpg

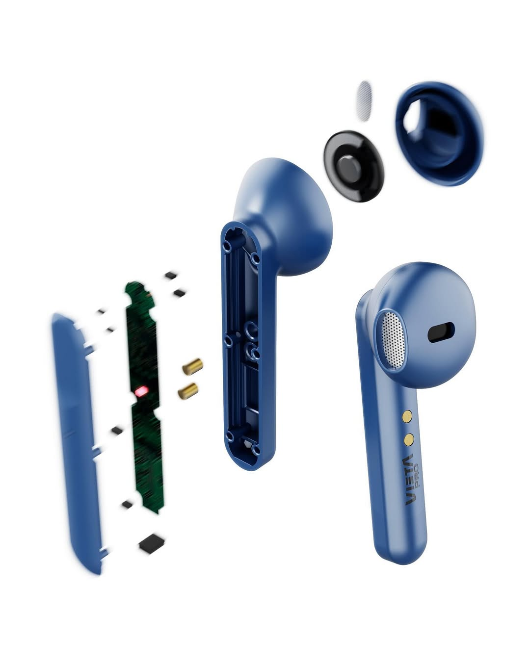
design/Inspo/moodboard/ig_ig_C--U0DEIdG4_20260902T225328_01.jpg
