Ryan365Apps/spotify-knob/design/Inspo/moodboard/ig_ig_CFkVx9nglE-_20260902T225548_02.jpg

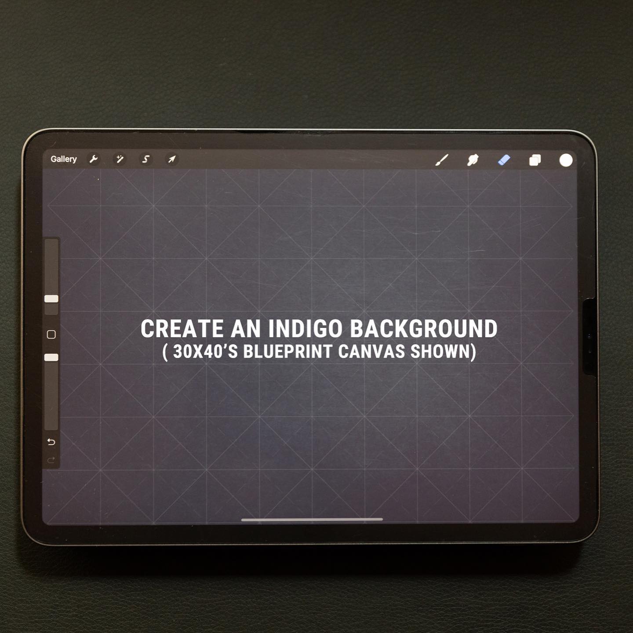
design/Inspo/moodboard/ig_ig_CFkVx9nglE-_20260902T225548_02.jpg
