Ryan365Apps/spotify-knob/design/Inspo/moodboard/ig_ig_CGwGWCzHAHn_20260902T225443_02.jpg

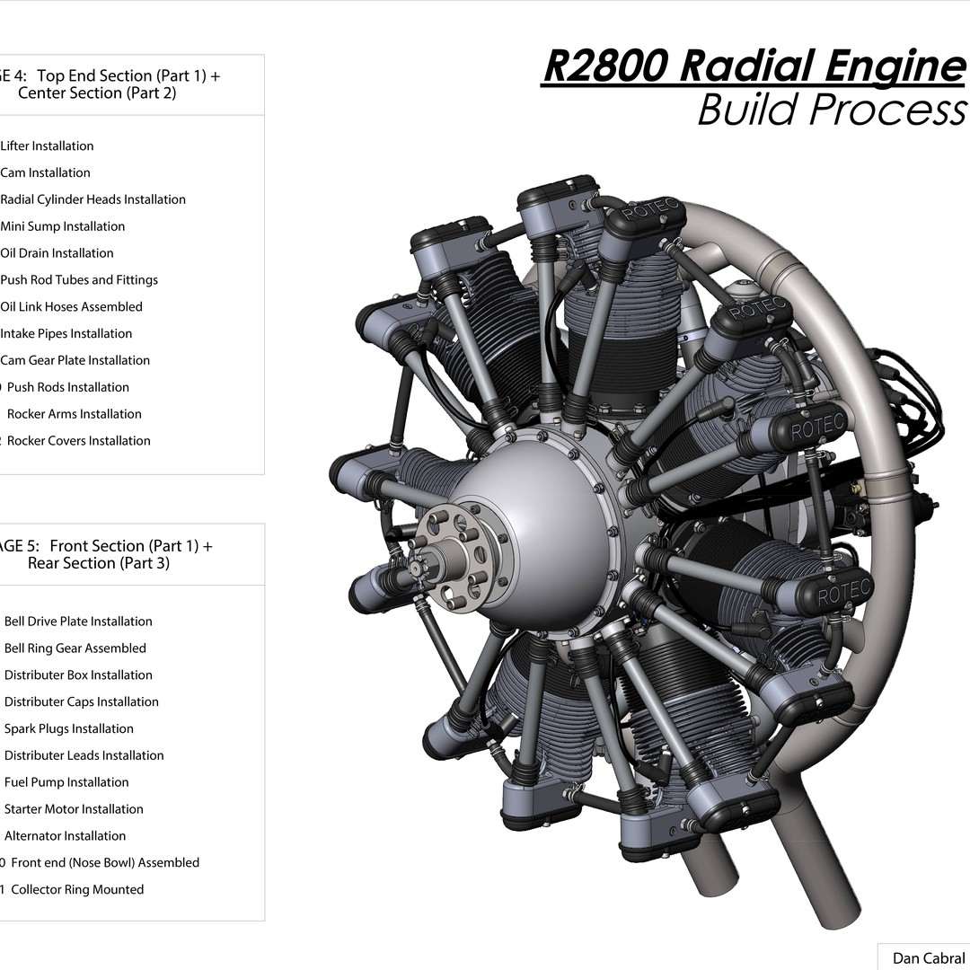
design/Inspo/moodboard/ig_ig_CGwGWCzHAHn_20260902T225443_02.jpg
