Ryan365Apps/spotify-knob/design/Inspo/moodboard/ig_ig_CMZOPVmnMik_20260902T225354_01.jpg

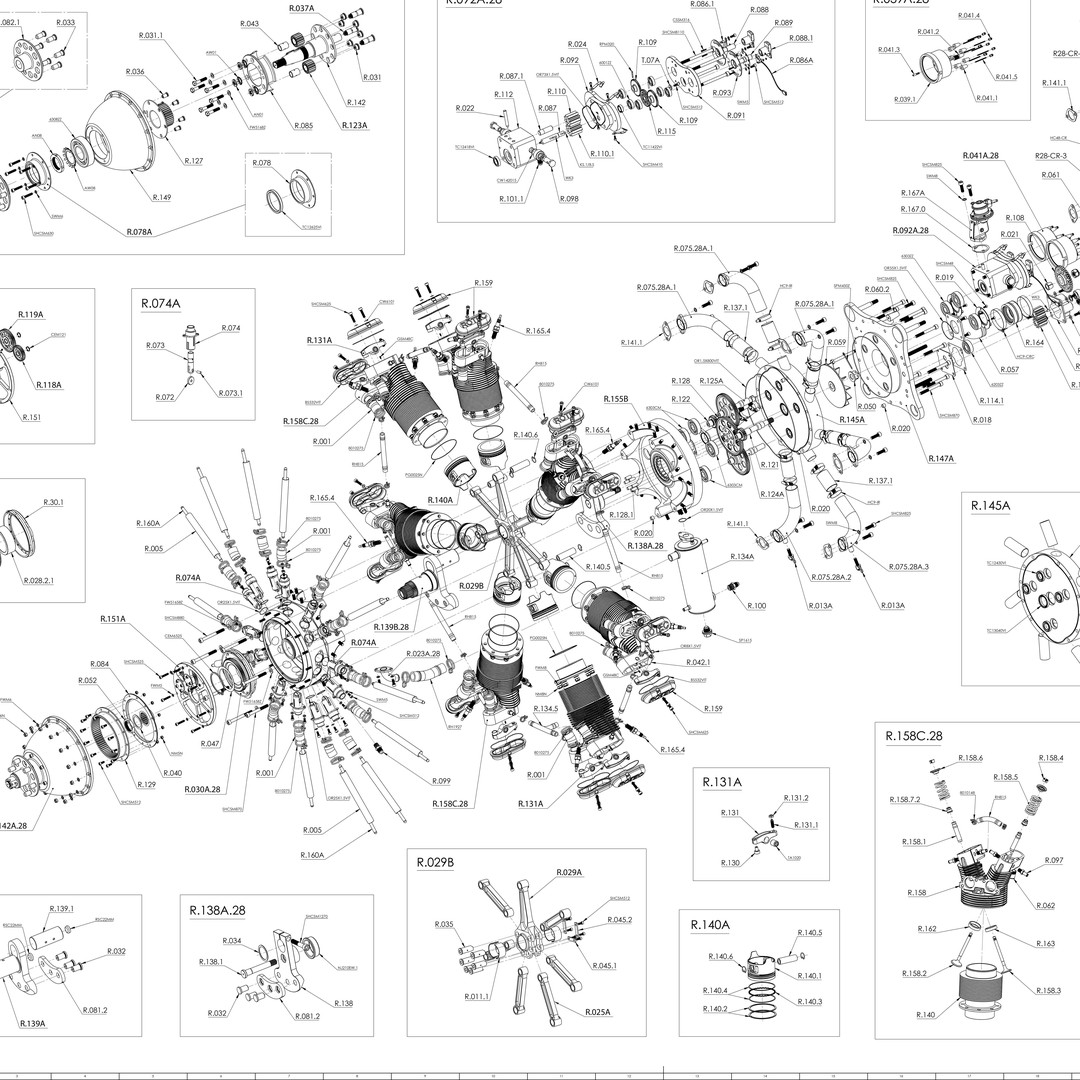
design/Inspo/moodboard/ig_ig_CMZOPVmnMik_20260902T225354_01.jpg
