Ryan365Apps/spotify-knob/design/Inspo/moodboard/ig_ig_DAsZlOSIkoH_20260902T225320_01.jpg

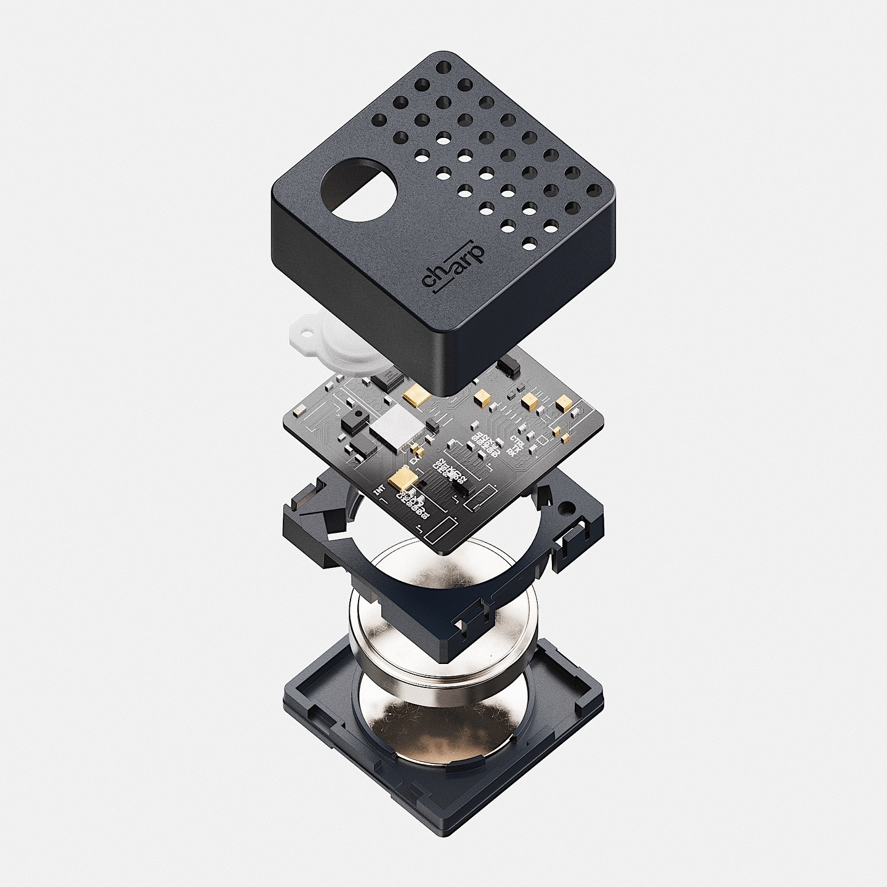
design/Inspo/moodboard/ig_ig_DAsZlOSIkoH_20260902T225320_01.jpg
