Ryan365Apps/spotify-knob/design/Inspo/moodboard/ig_ig_DbFfs-PiCyC_20260902T225433_02.jpg

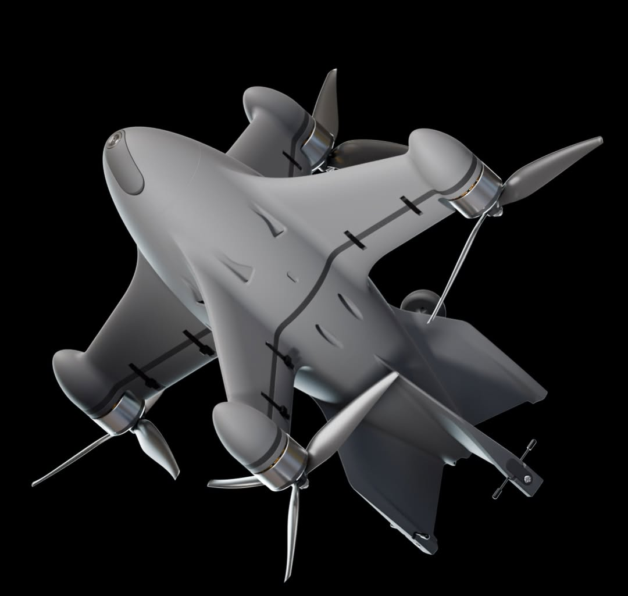
design/Inspo/moodboard/ig_ig_DbFfs-PiCyC_20260902T225433_02.jpg
