Ryan365Apps/spotify-knob/design/Inspo/moodboard/ig_ig_DbRwC3TmweL_20260902T225601_01.jpg

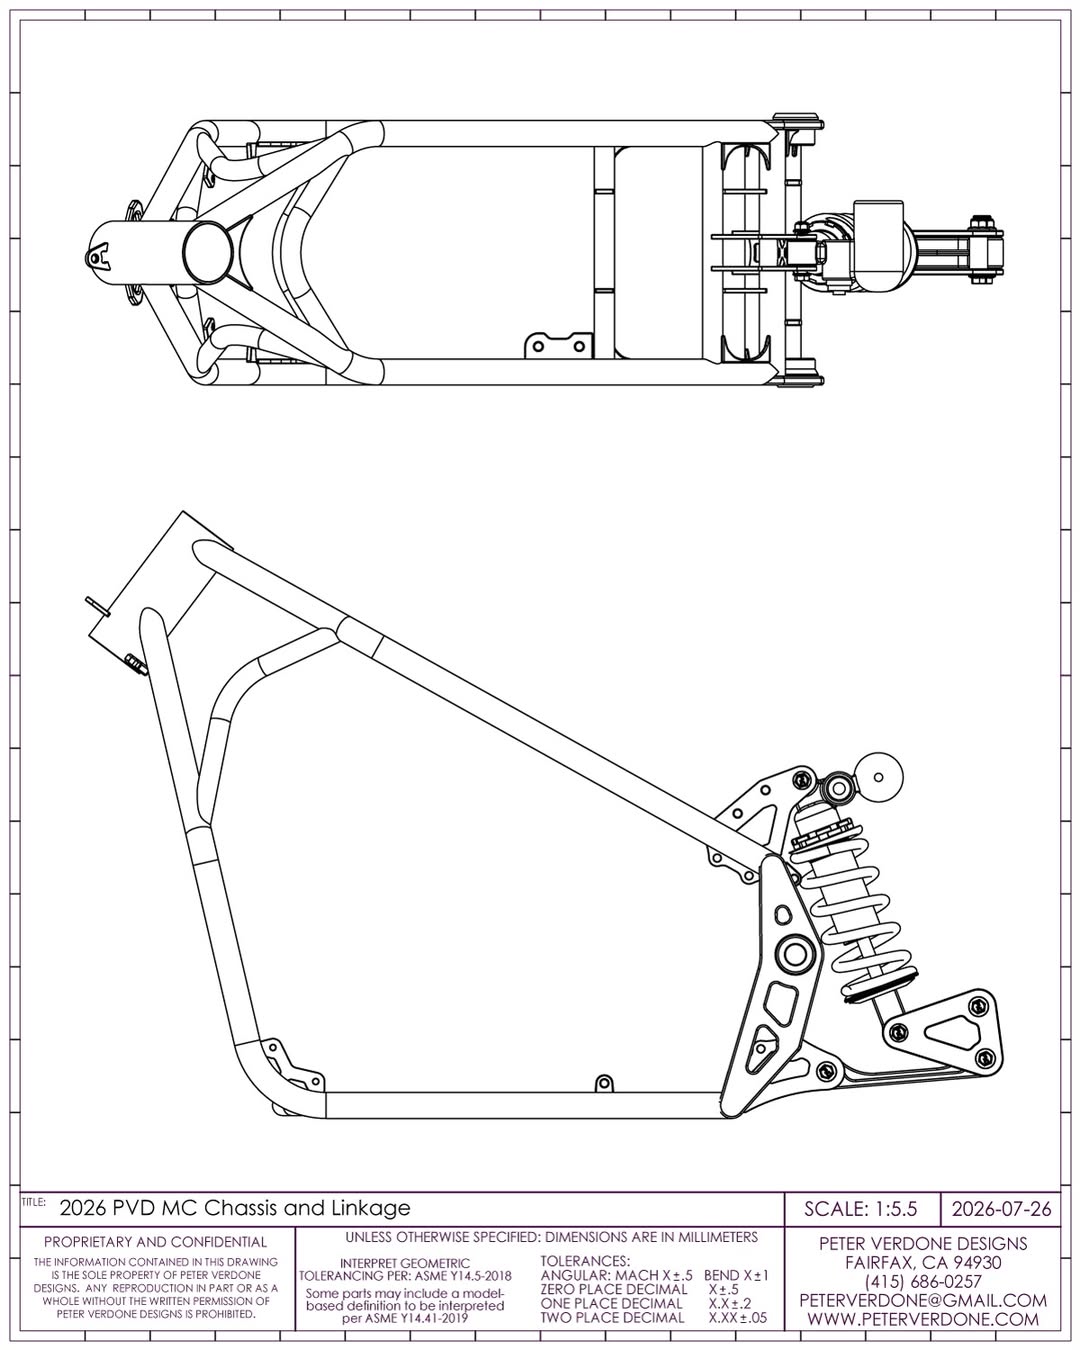
design/Inspo/moodboard/ig_ig_DbRwC3TmweL_20260902T225601_01.jpg
