Ryan365Apps/spotify-knob/design/Inspo/moodboard/ig_ig_DUZ2N08DP7e_20260902T225752_01.jpg

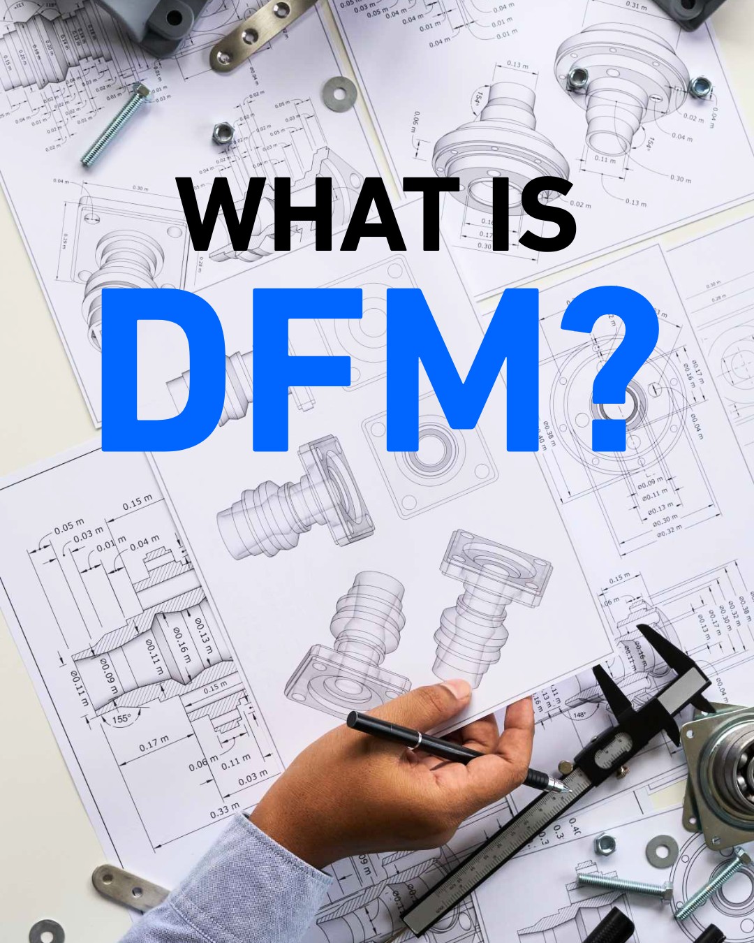
design/Inspo/moodboard/ig_ig_DUZ2N08DP7e_20260902T225752_01.jpg
