Ryan365Apps/spotify-knob/design/Inspo/moodboard/ig_ig_DXuOysmEmAi_20260902T225450_01.jpg

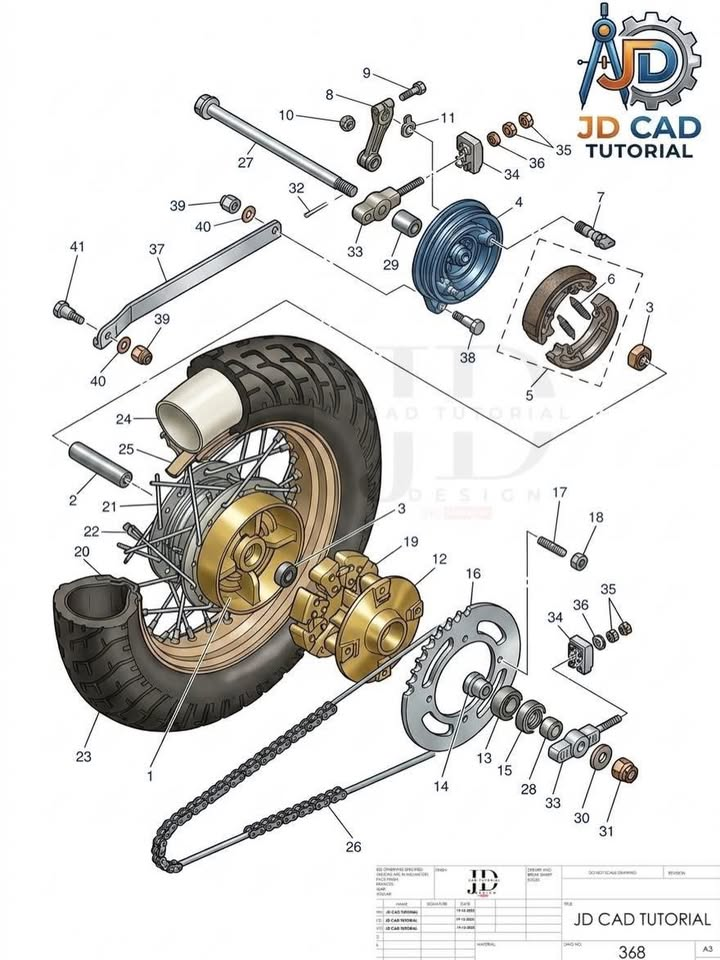
design/Inspo/moodboard/ig_ig_DXuOysmEmAi_20260902T225450_01.jpg
