Ryan365Apps/spotify-knob/design/Inspo/moodboard/ig_ig_DZ-mO_PGgVq_20260902T225717_02.jpg

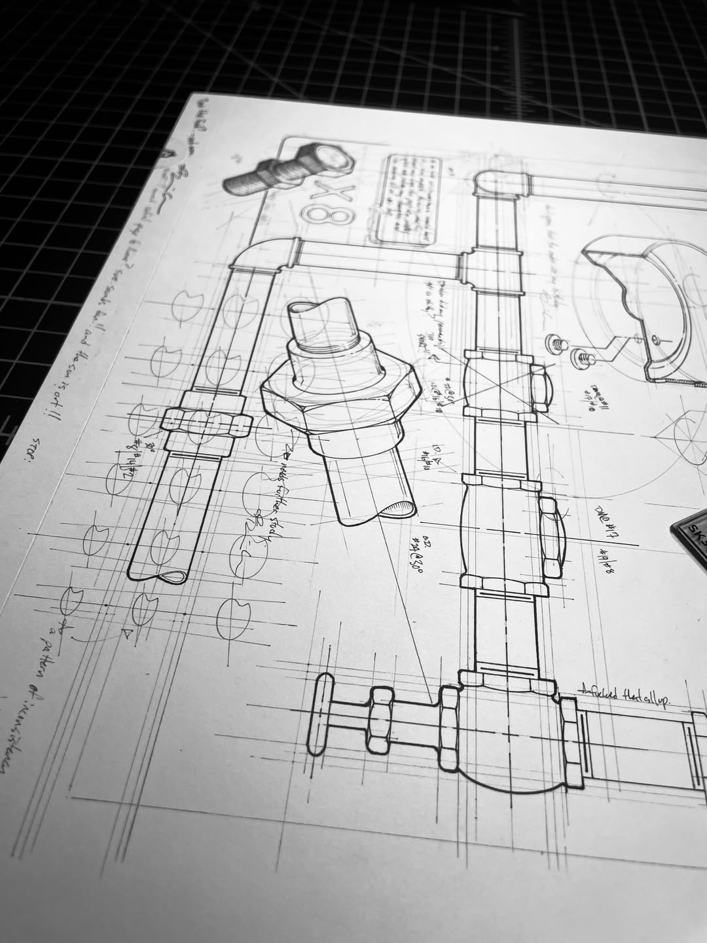
design/Inspo/moodboard/ig_ig_DZ-mO_PGgVq_20260902T225717_02.jpg
