Ryan365Apps/spotify-knob/design/Inspo/moodboard/ig_ig_DZgIt9oDIvz_20260902T225339_01.jpg

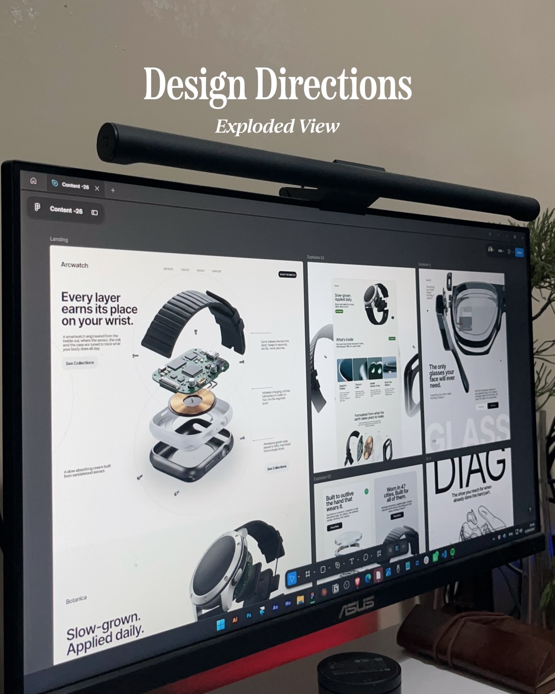
design/Inspo/moodboard/ig_ig_DZgIt9oDIvz_20260902T225339_01.jpg
