Ryan365Apps/spotify-knob/design/Inspo/moodboard/ig_product.notion_DOgZXNLiuT8_20260907T221949_05.jpg

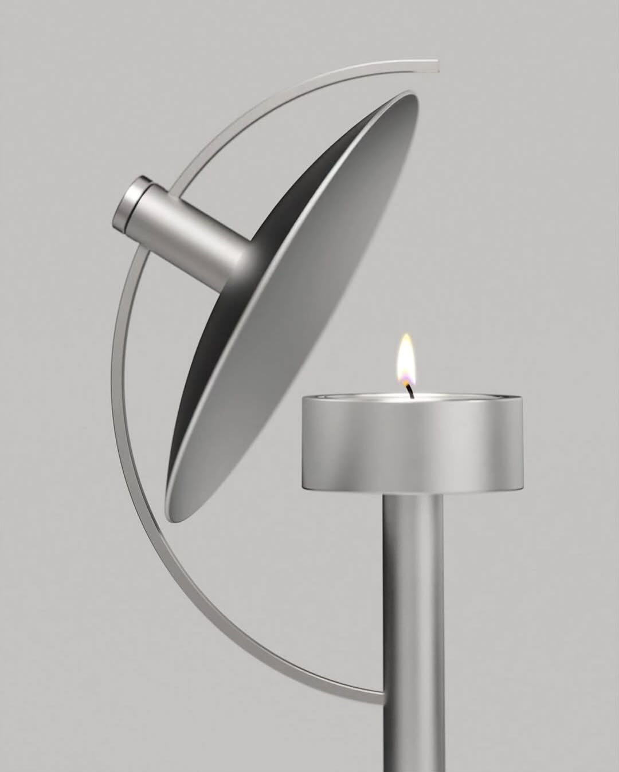
design/Inspo/moodboard/ig_product.notion_DOgZXNLiuT8_20260907T221949_05.jpg
