Ryan365Apps/spotify-knob/design/Inspo/moodboard/ig_samsundstrom1_Caknit8vXUT_20260902T225512_02.jpg

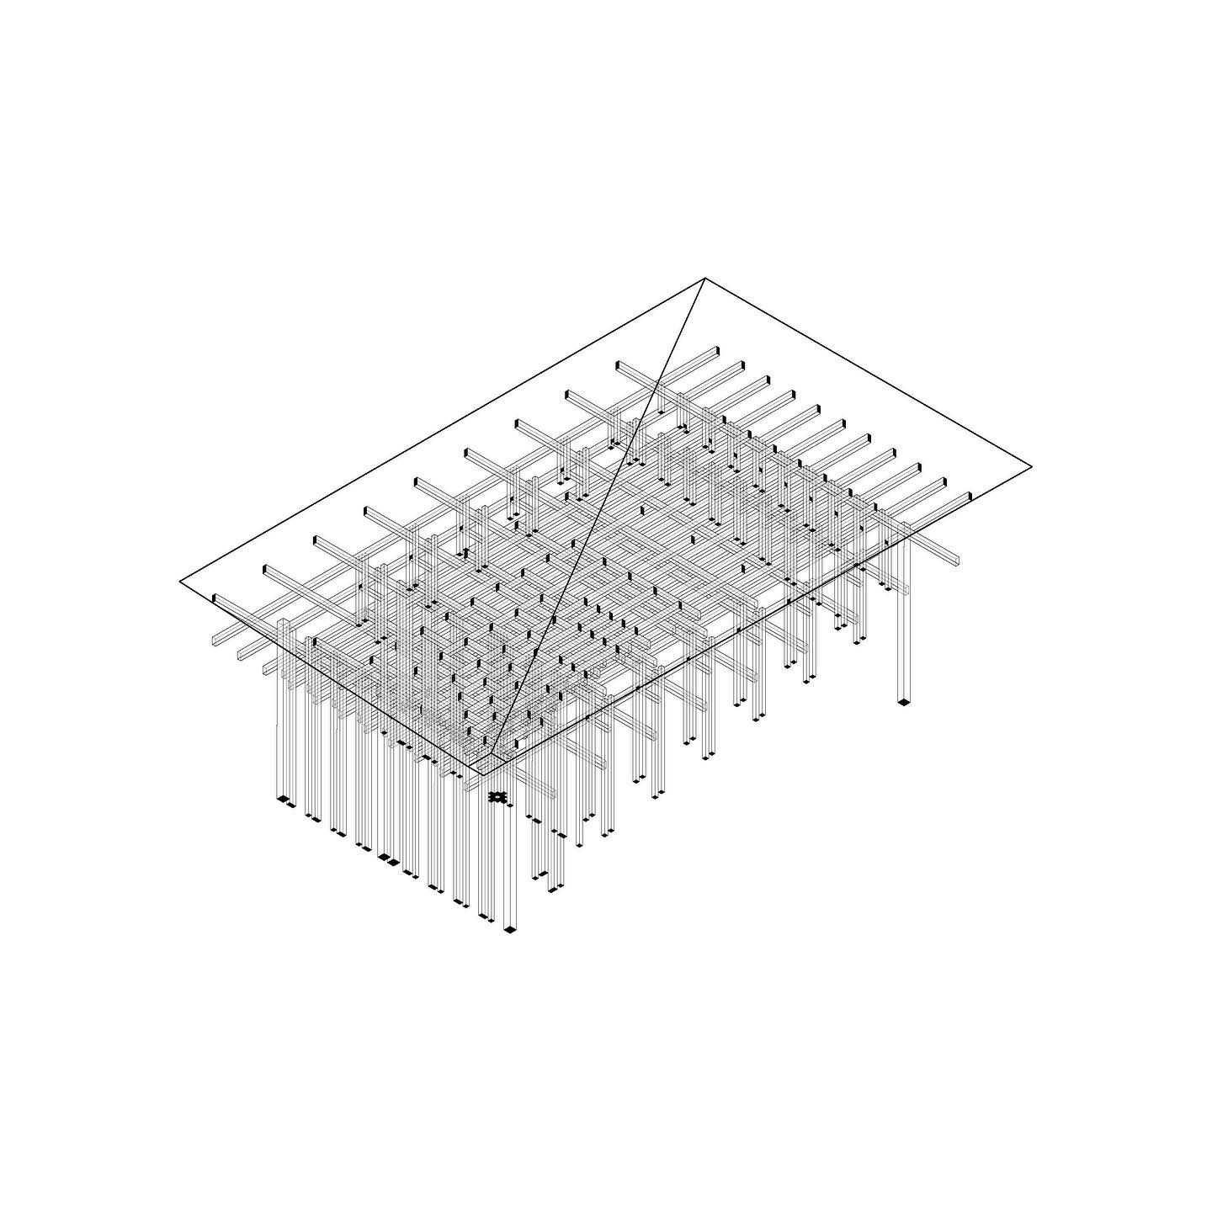
design/Inspo/moodboard/ig_samsundstrom1_Caknit8vXUT_20260902T225512_02.jpg
