Ryan365Apps/spotify-knob/design/Inspo/moodboard/kef-ls50-wireless-ii.jpg

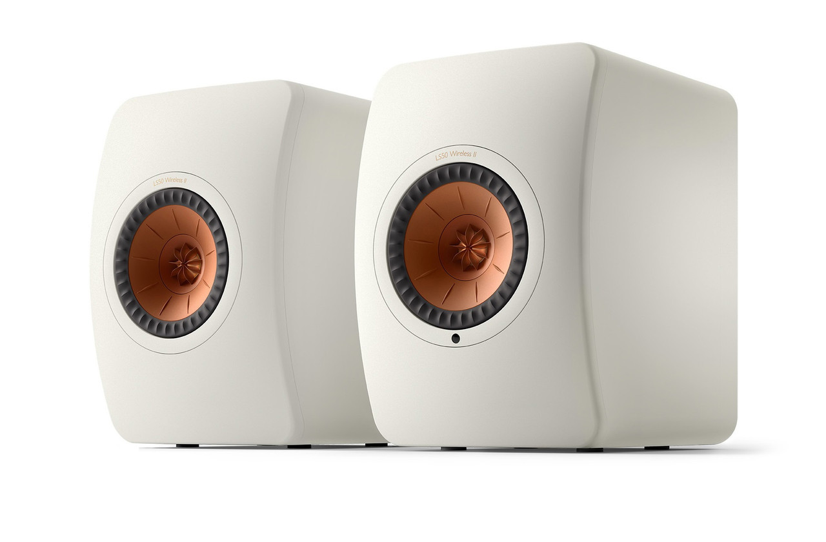
design/Inspo/moodboard/kef-ls50-wireless-ii.jpg
