Ryan365Apps/spotify-knob/design/Inspo/moodboard/knurling-examples.jpg

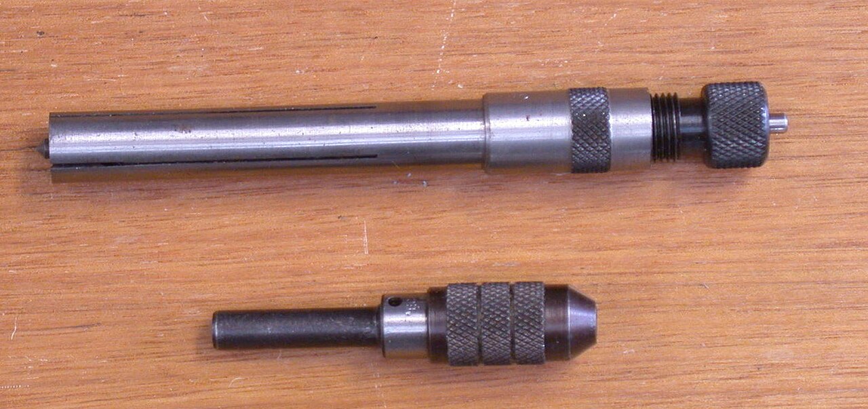
design/Inspo/moodboard/knurling-examples.jpg
