Ryan365Apps/spotify-knob/design/Inspo/moodboard/saab-900-restomod.png

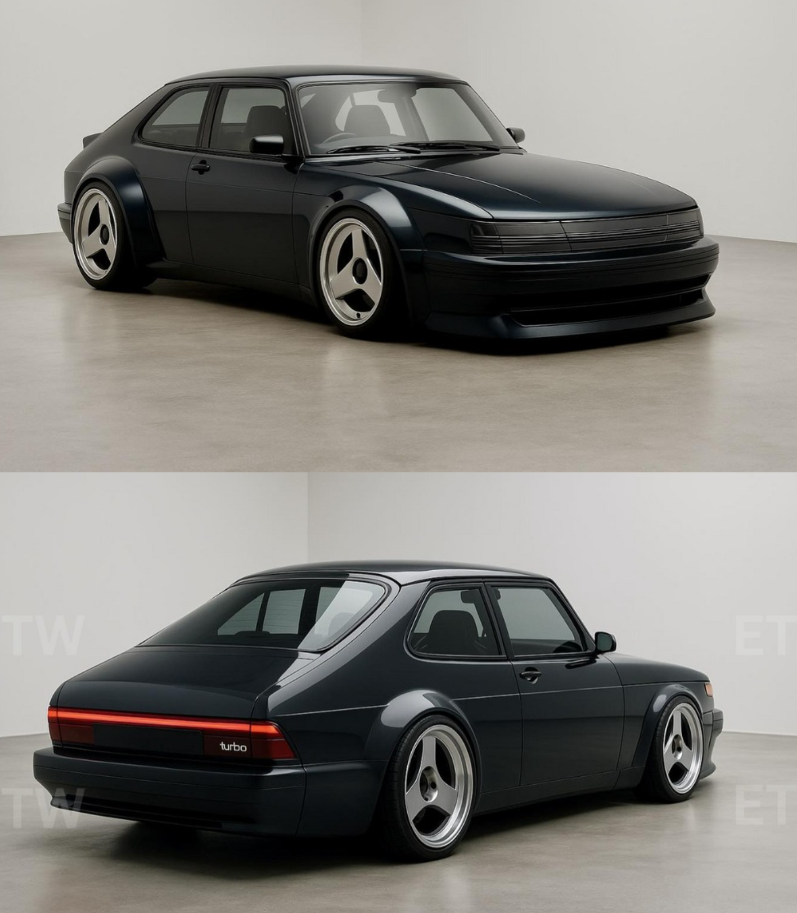
design/Inspo/moodboard/saab-900-restomod.png
