Ryan365Apps/spotify-knob/design/Inspo/moodboard/totem-gt-super-rear.jpg

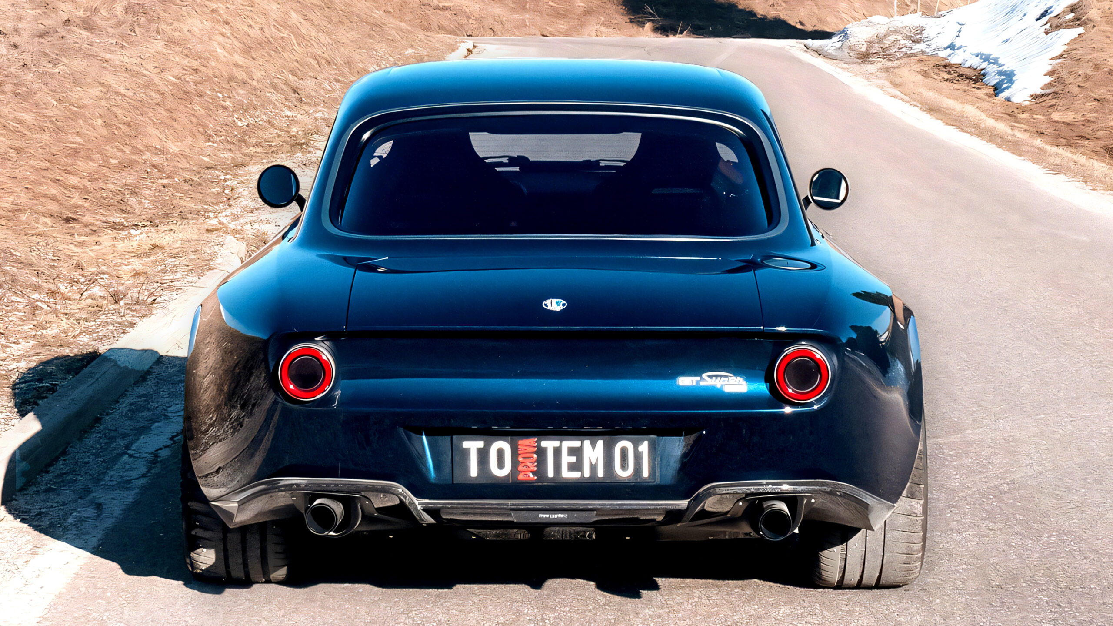
design/Inspo/moodboard/totem-gt-super-rear.jpg
