Ryan365Apps/spotify-knob/design/Inspo/moodboard/totem-machined-caps.jpg

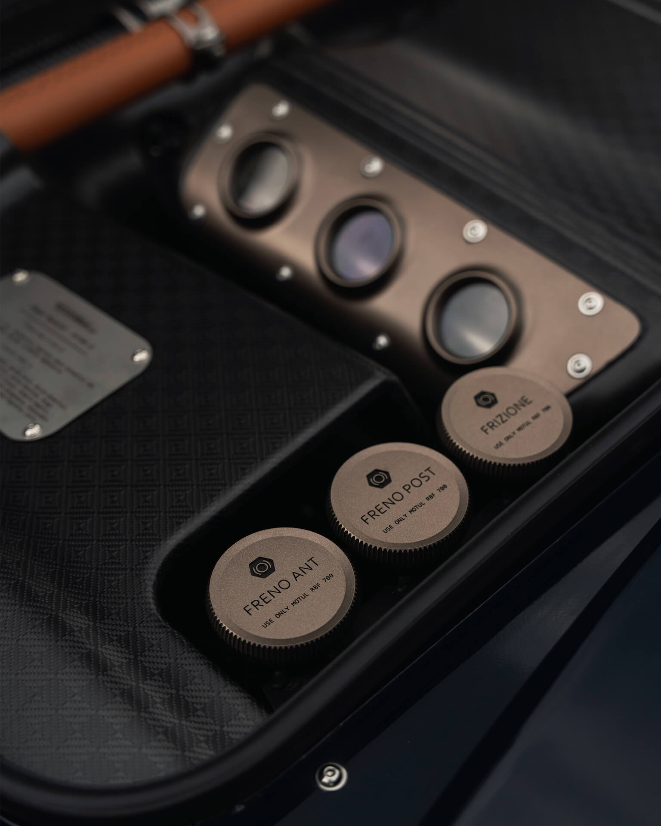
design/Inspo/moodboard/totem-machined-caps.jpg
