Ryan365Apps/spotify-knob/design/Inspo/moodboard/totem-steering-hub.jpg

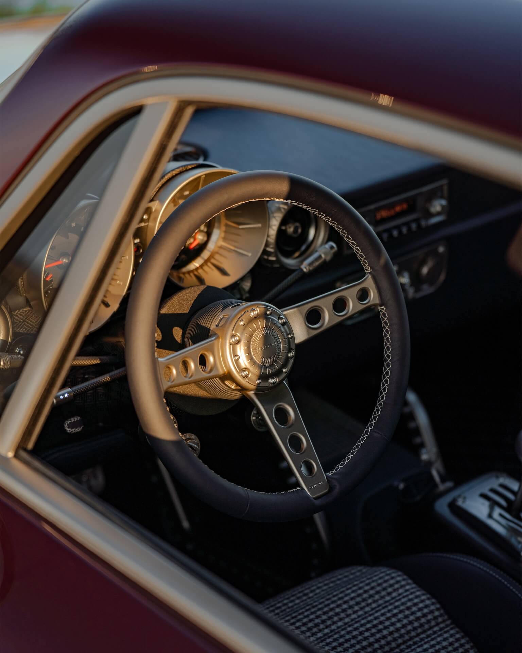
design/Inspo/moodboard/totem-steering-hub.jpg
