Ryan365Apps/spotify-knob/design/Inspo/moodboard/watch-chunky-bevel.png

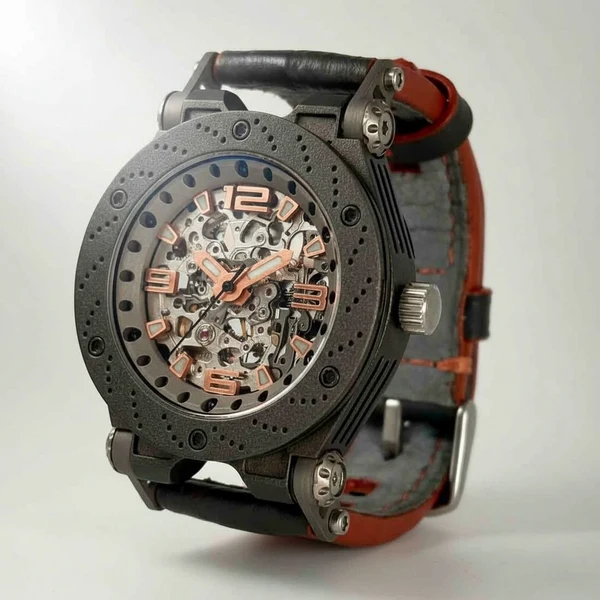
design/Inspo/moodboard/watch-chunky-bevel.png
