Ryan365Apps/spotify-knob/design/Inspo/Screenshot 2026-09-02 231106.png

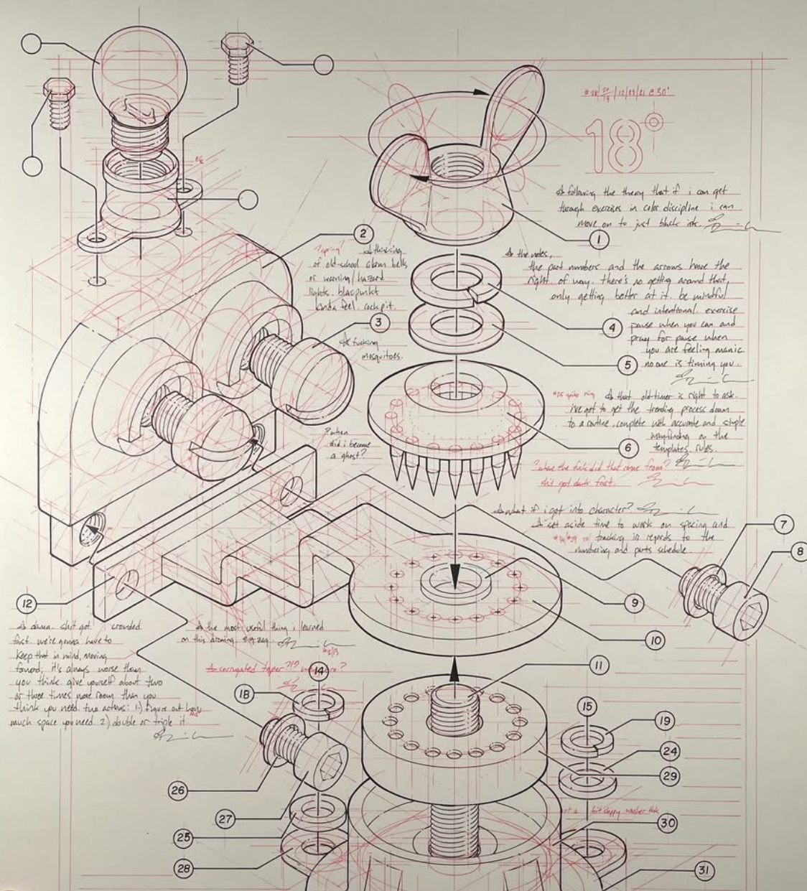
design/Inspo/Screenshot 2026-09-02 231106.png
