Ryan365Apps/spotify-knob/design/Inspo/Screenshot 2026-09-02 231149.png

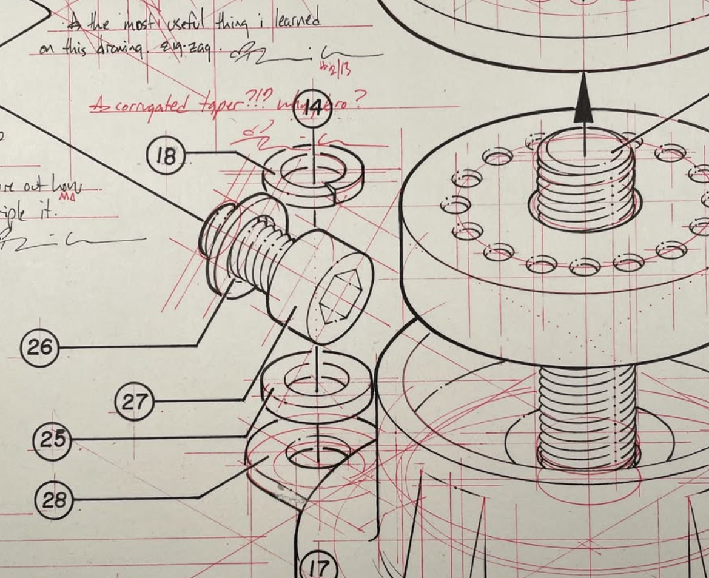
design/Inspo/Screenshot 2026-09-02 231149.png
