Ryan365Apps/spotify-knob/design/Inspo/z.webp

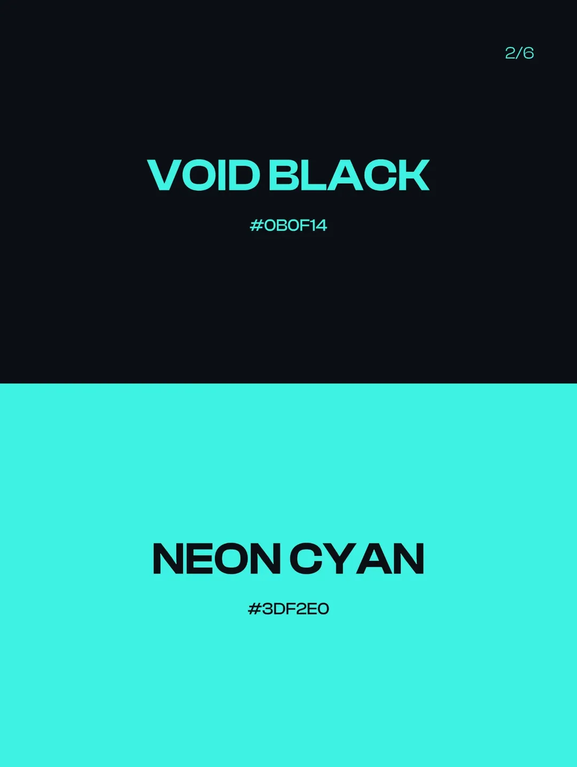
design/Inspo/z.webp
