Ryan365Apps/spotify-knob/docs/Claude outputs/bay_layout.png

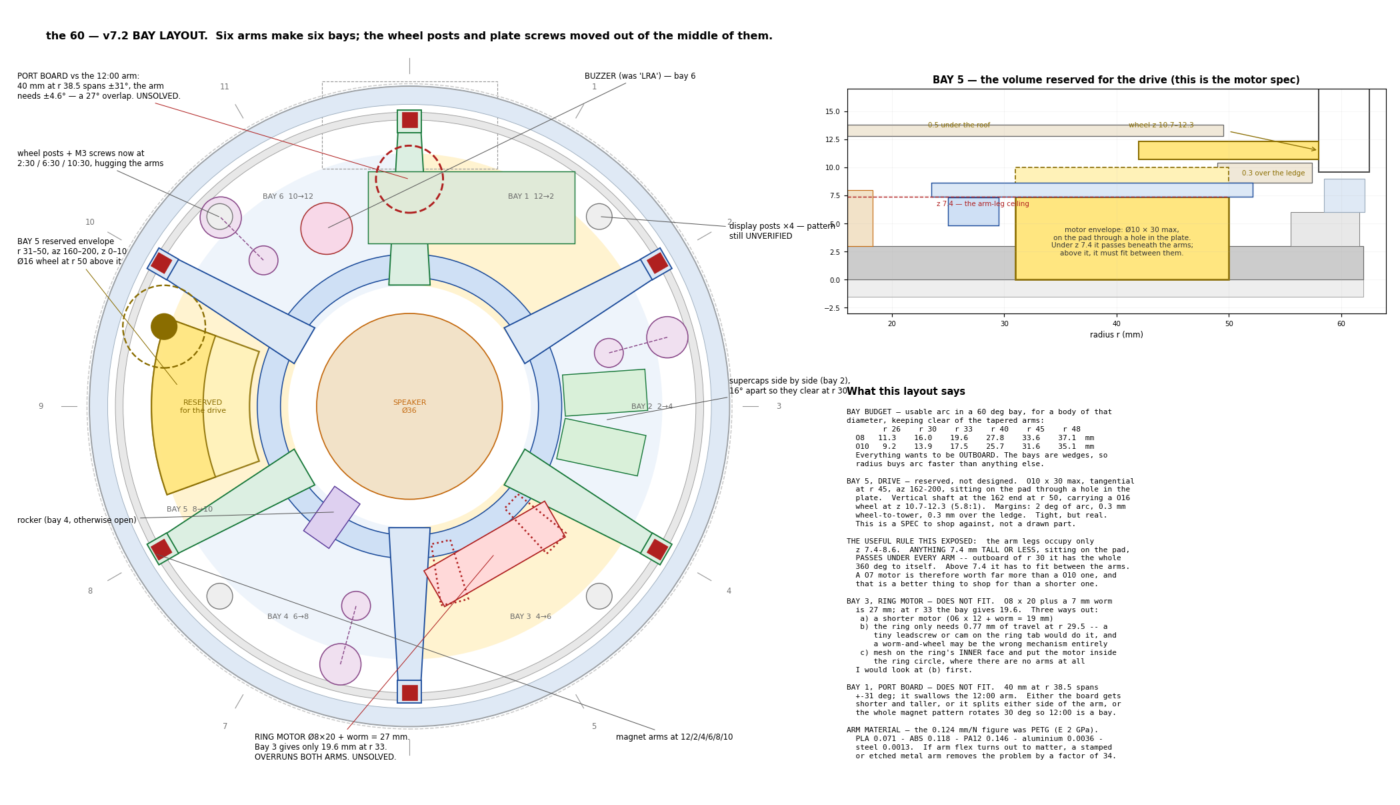
docs/Claude outputs/bay_layout.png
