Ryan365Apps/spotify-knob/docs/Claude outputs/detent_switching.png

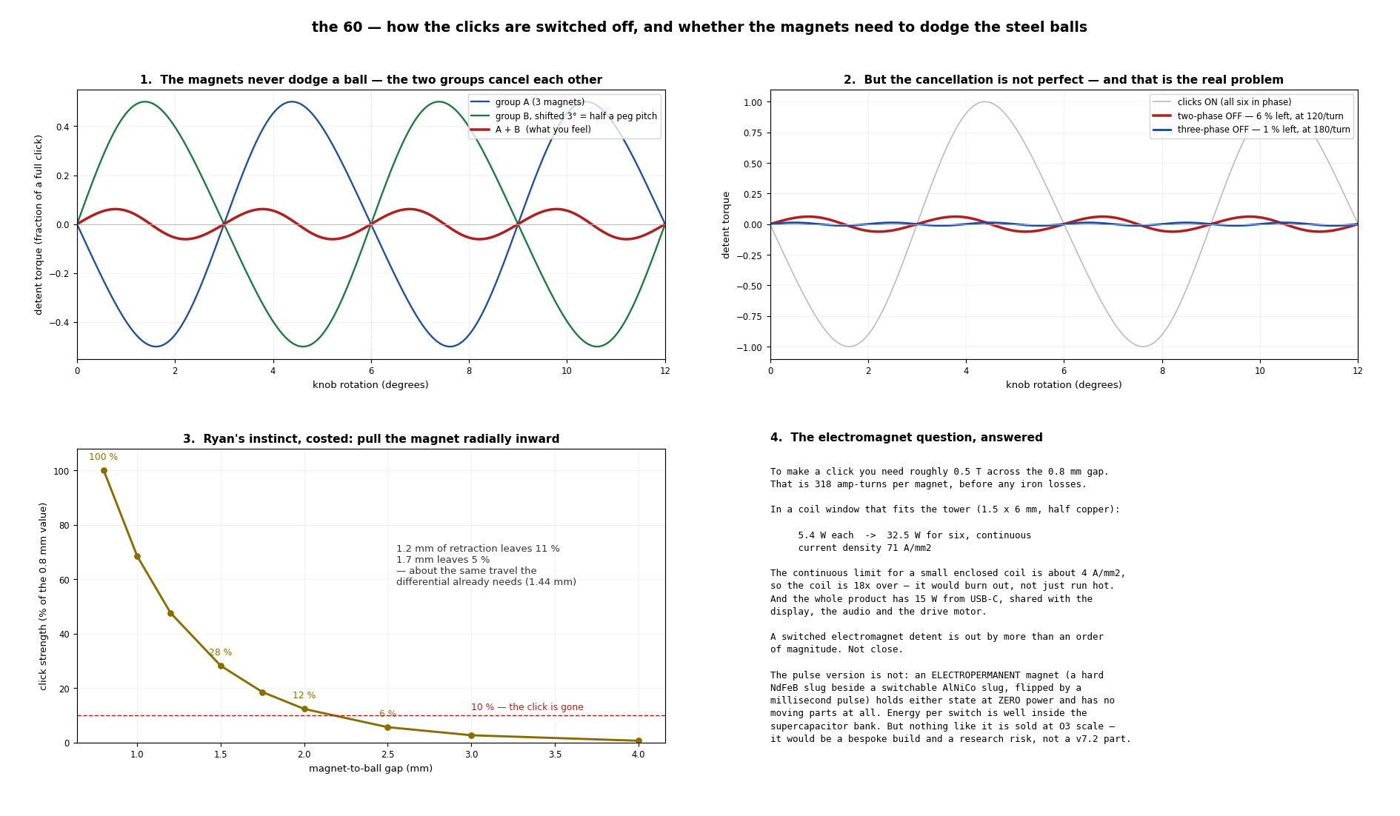
docs/Claude outputs/detent_switching.png
