Ryan365Apps/spotify-knob/docs/Claude outputs/drive_wheel_explained.png

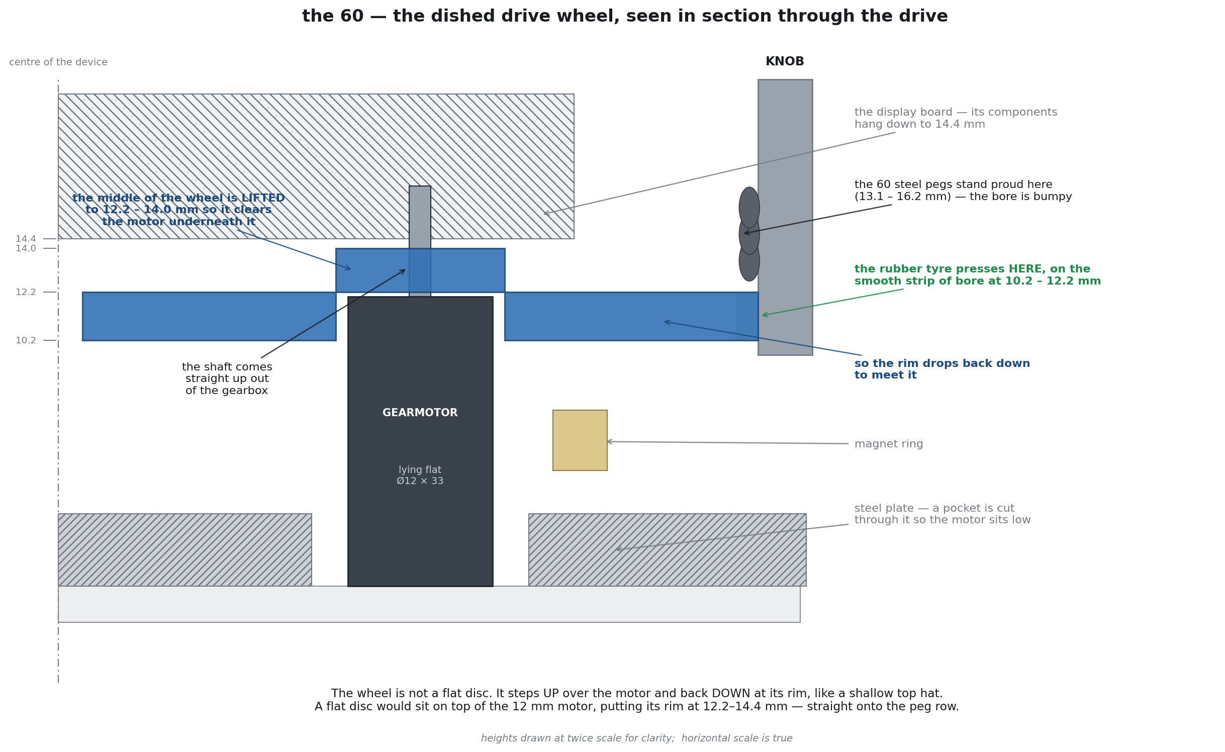
docs/Claude outputs/drive_wheel_explained.png
