Ryan365Apps/spotify-knob/docs/Claude outputs/epm_option.png

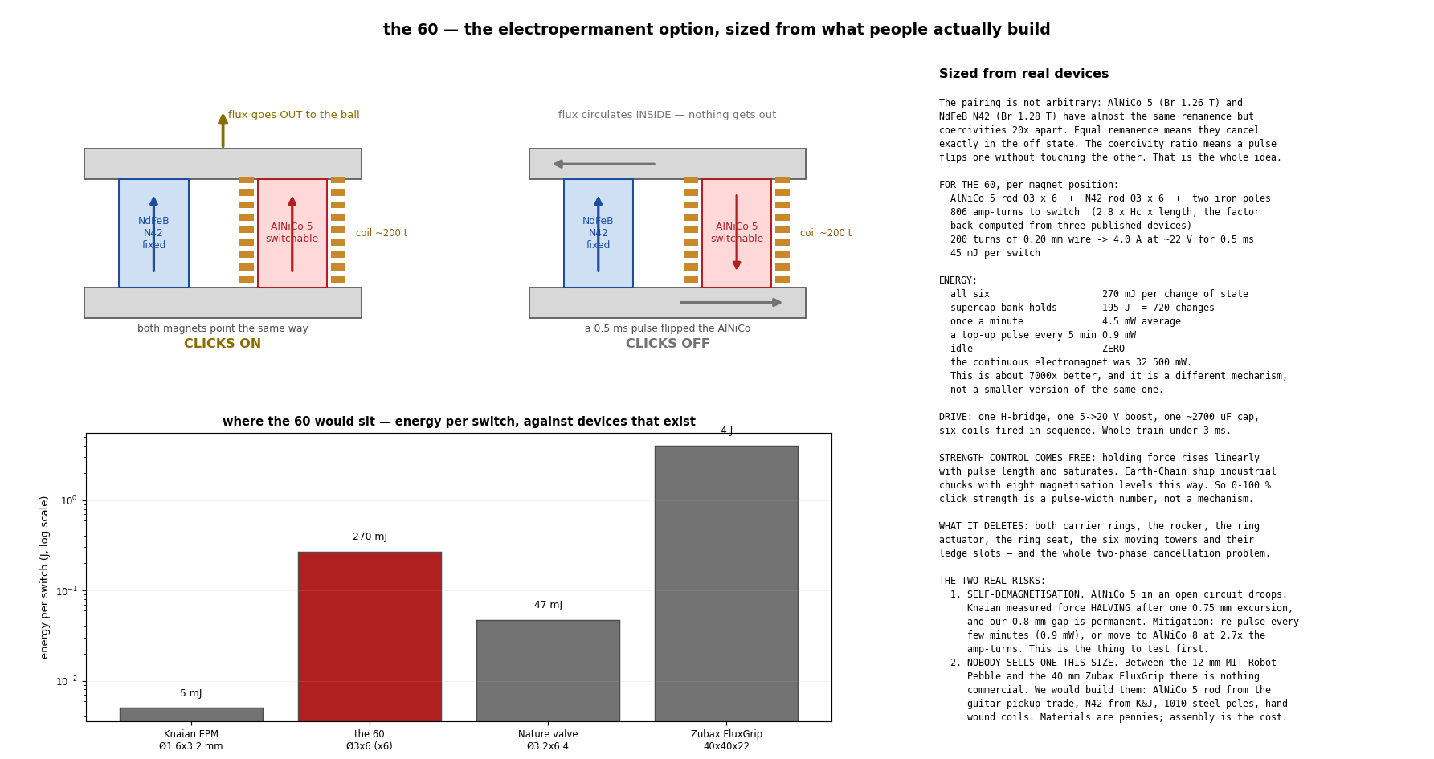
docs/Claude outputs/epm_option.png
