Ryan365Apps/spotify-knob/docs/Claude outputs/floorplan.png

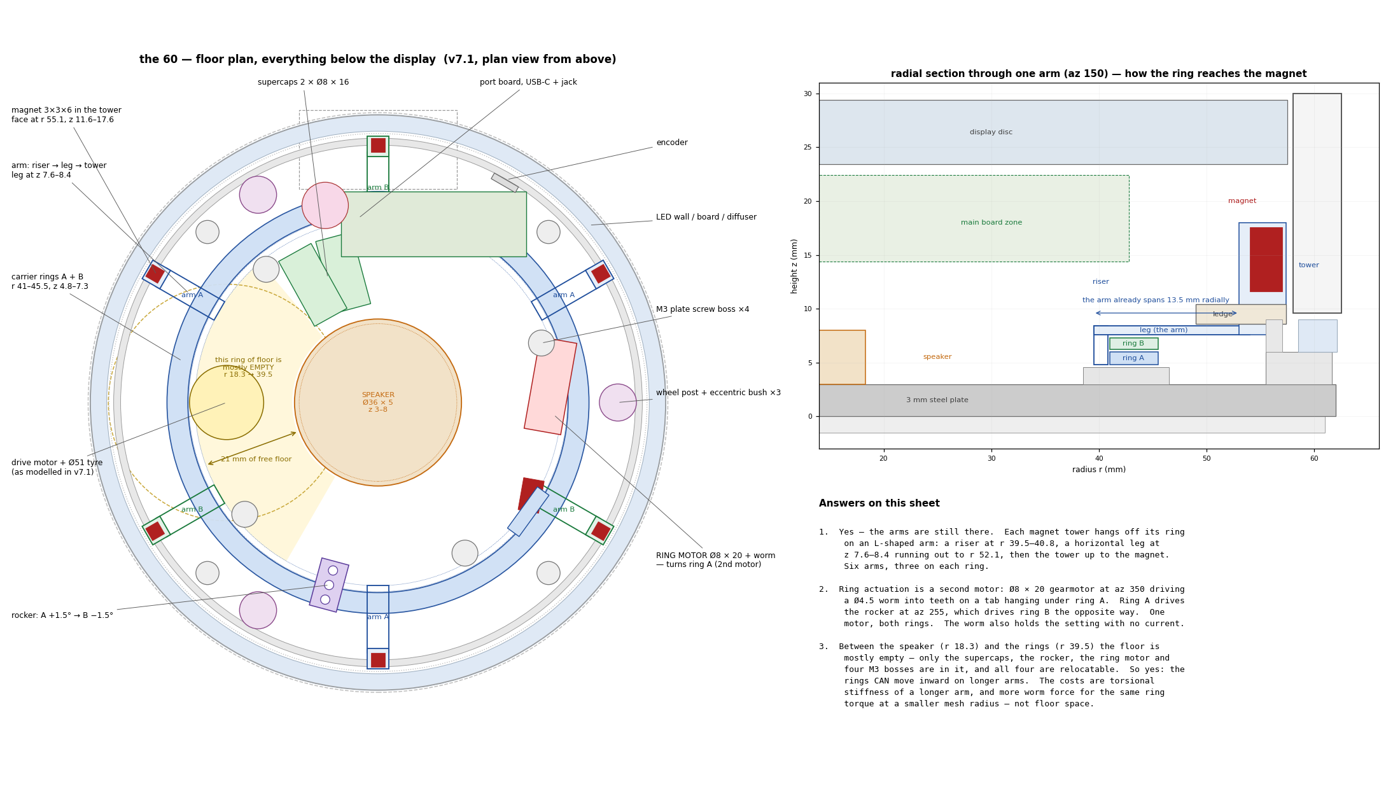
docs/Claude outputs/floorplan.png
