Ryan365Apps/spotify-knob/docs/Claude outputs/proposal_v72.png

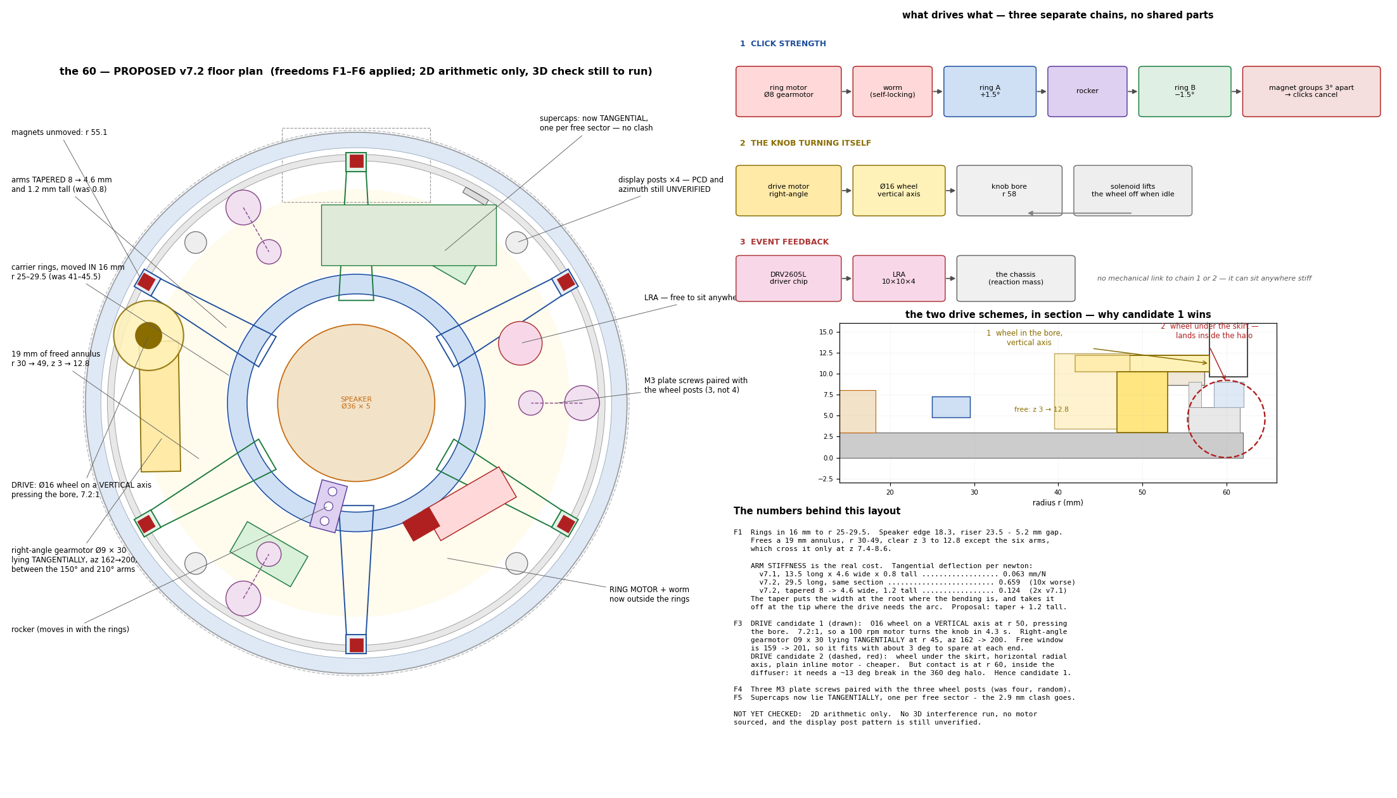
docs/Claude outputs/proposal_v72.png
