Ryan365Apps/spotify-knob/docs/Claude outputs/reluctance_synthesis.png

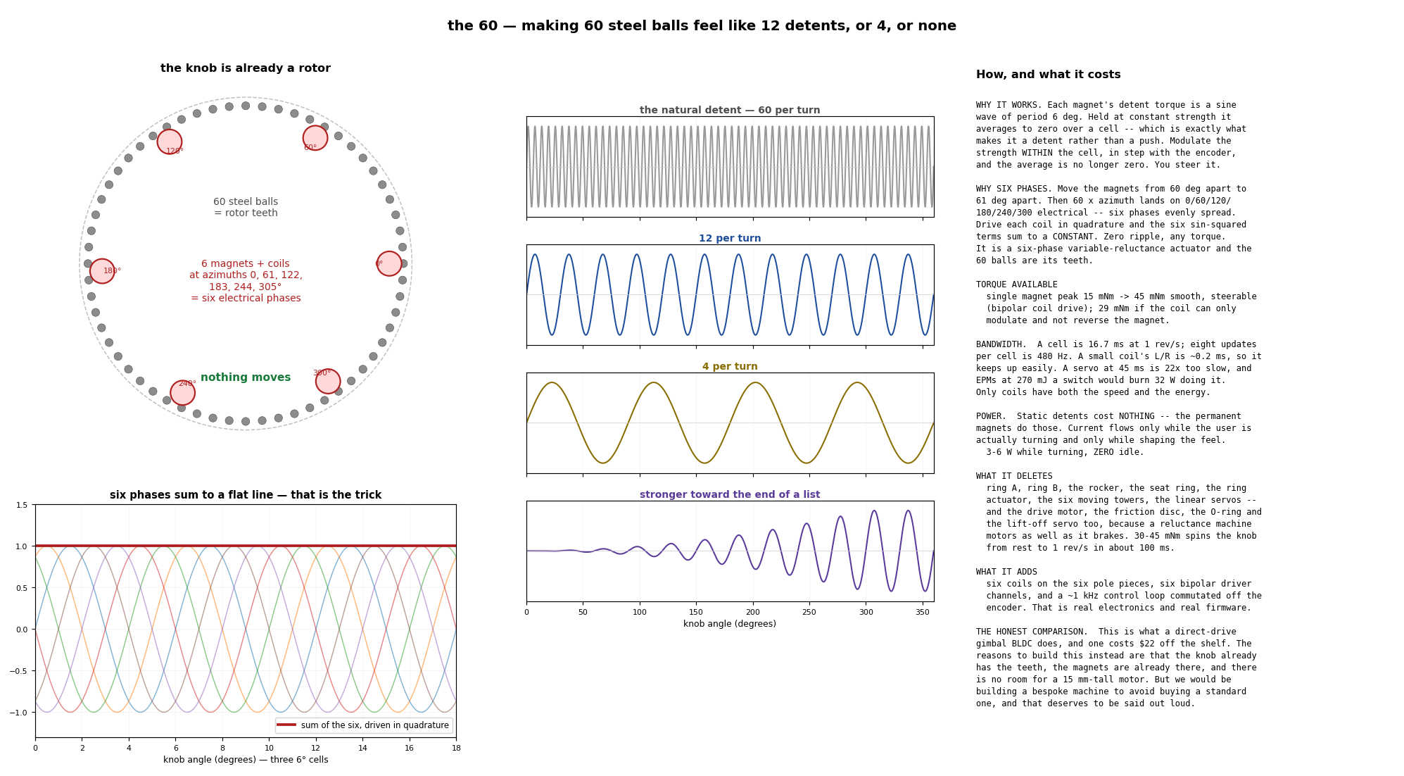
docs/Claude outputs/reluctance_synthesis.png
