Ryan365Apps/spotify-knob/docs/Claude outputs/rim_ring.png

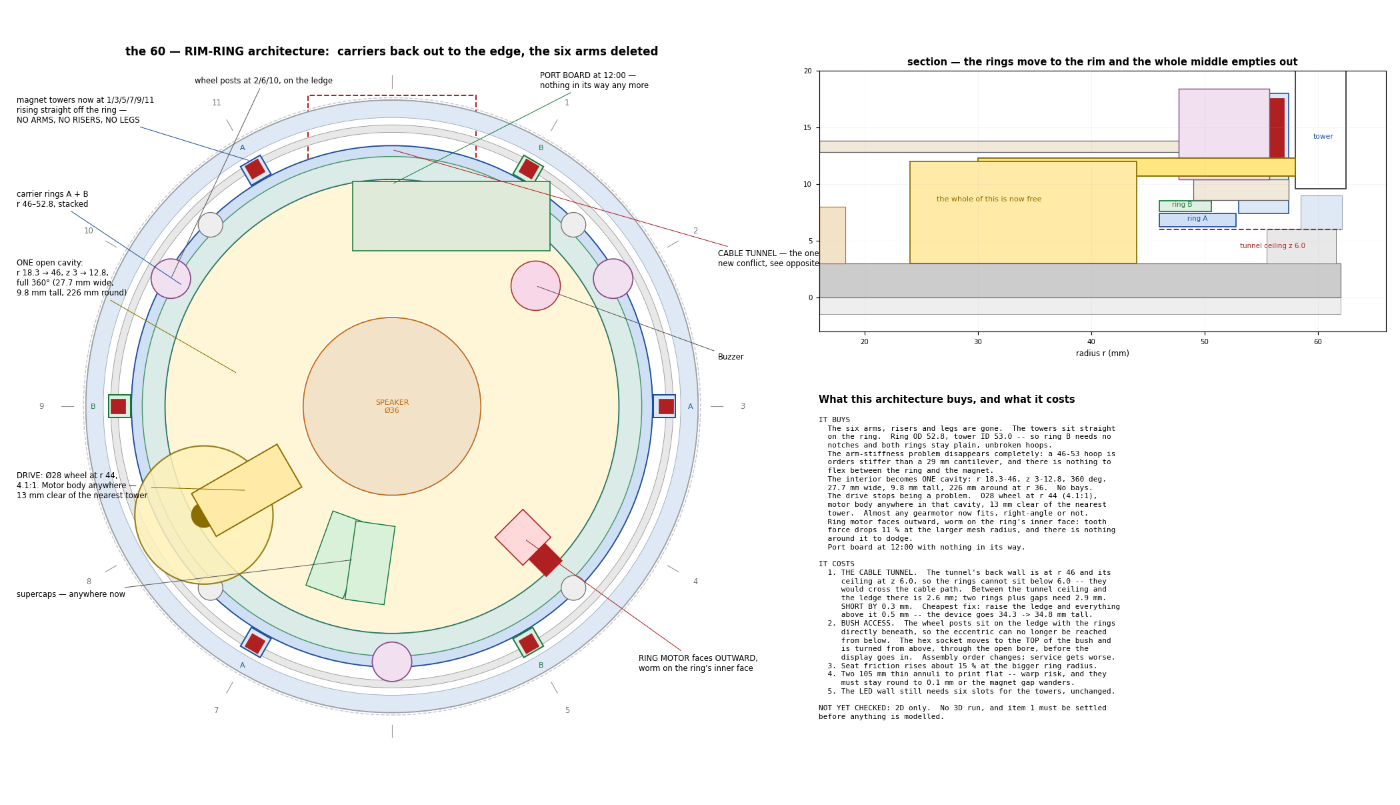
docs/Claude outputs/rim_ring.png
