Ryan365Apps/spotify-knob/docs/Claude outputs/v8_ga.png

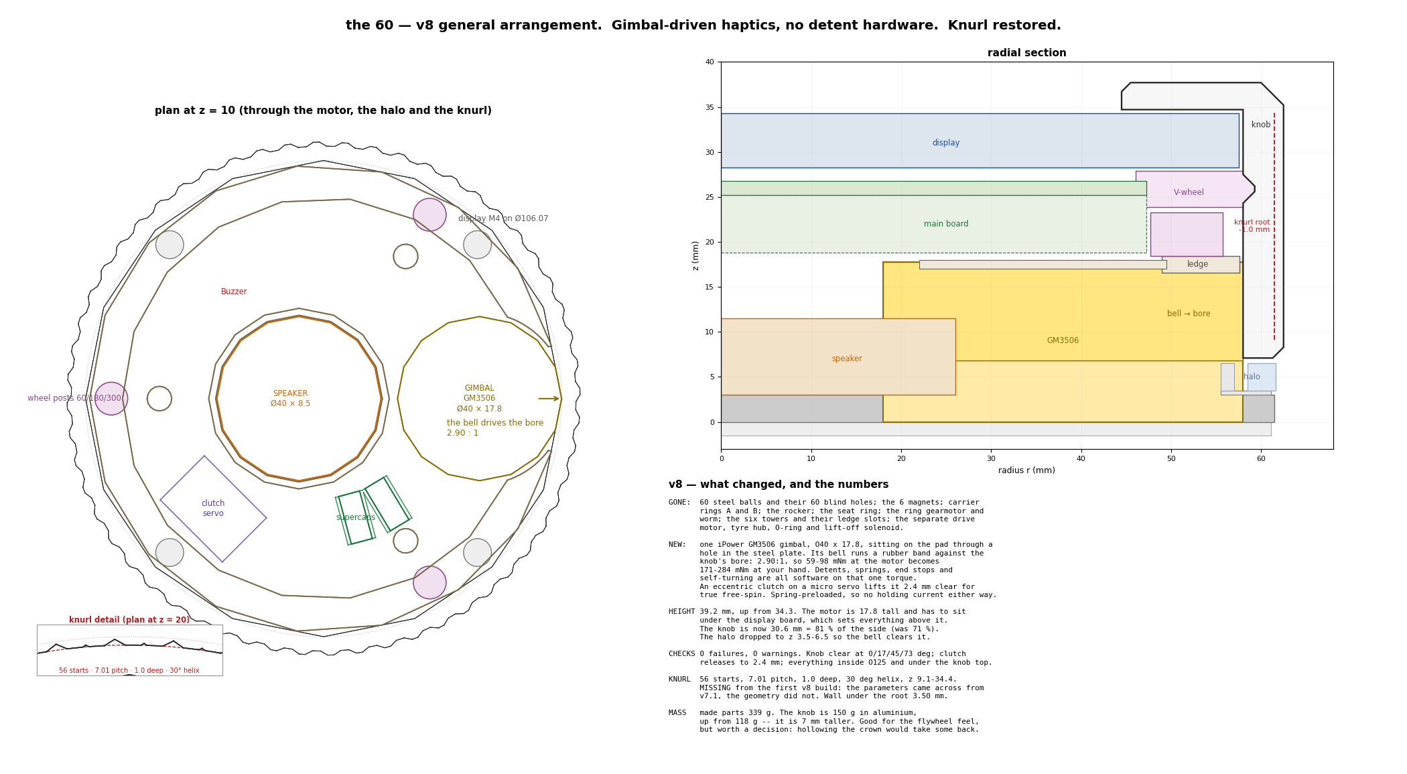
docs/Claude outputs/v8_ga.png
