Ryan365Apps/spotify-knob/docs/Claude outputs/v72_signoff.png

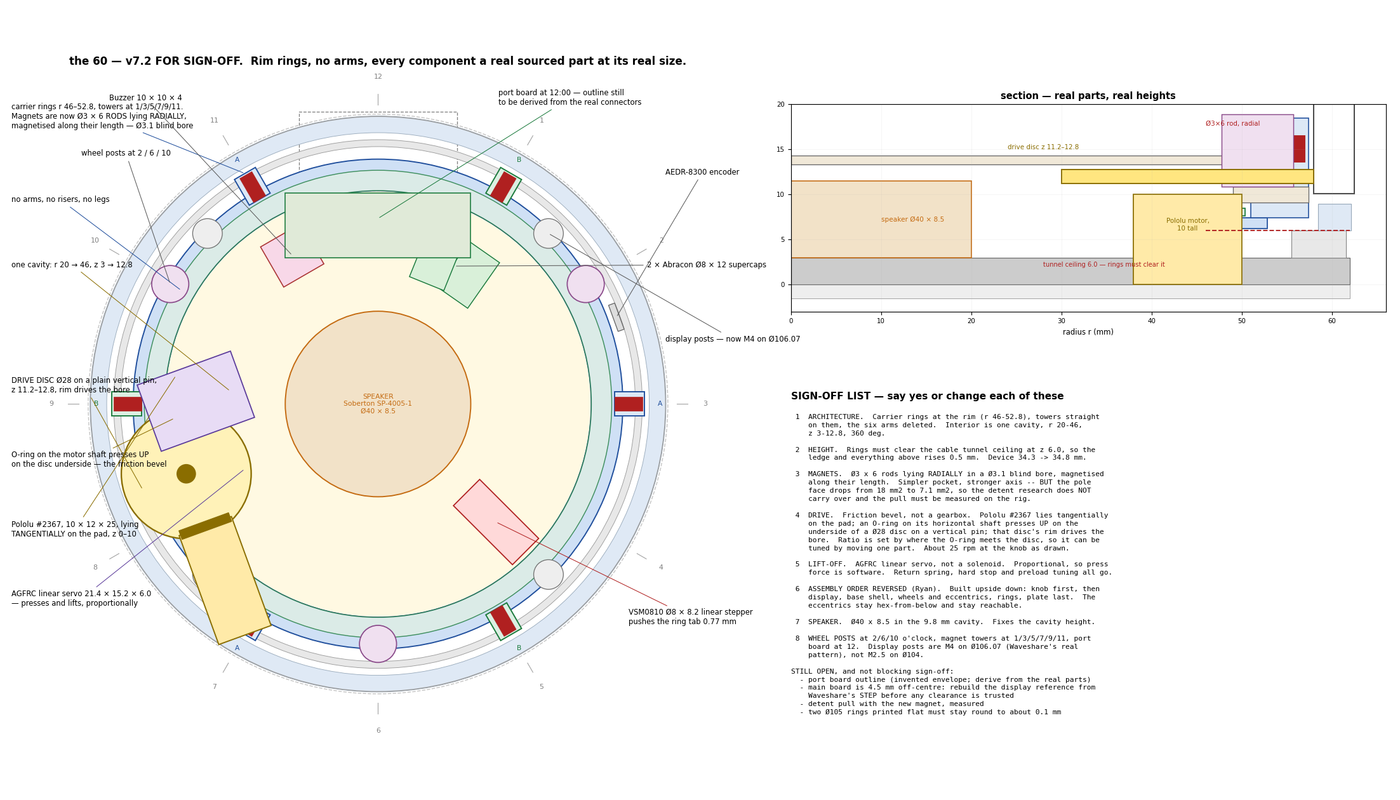
docs/Claude outputs/v72_signoff.png
