Ryan365Apps/spotify-knob/docs/layout/layout_study.png

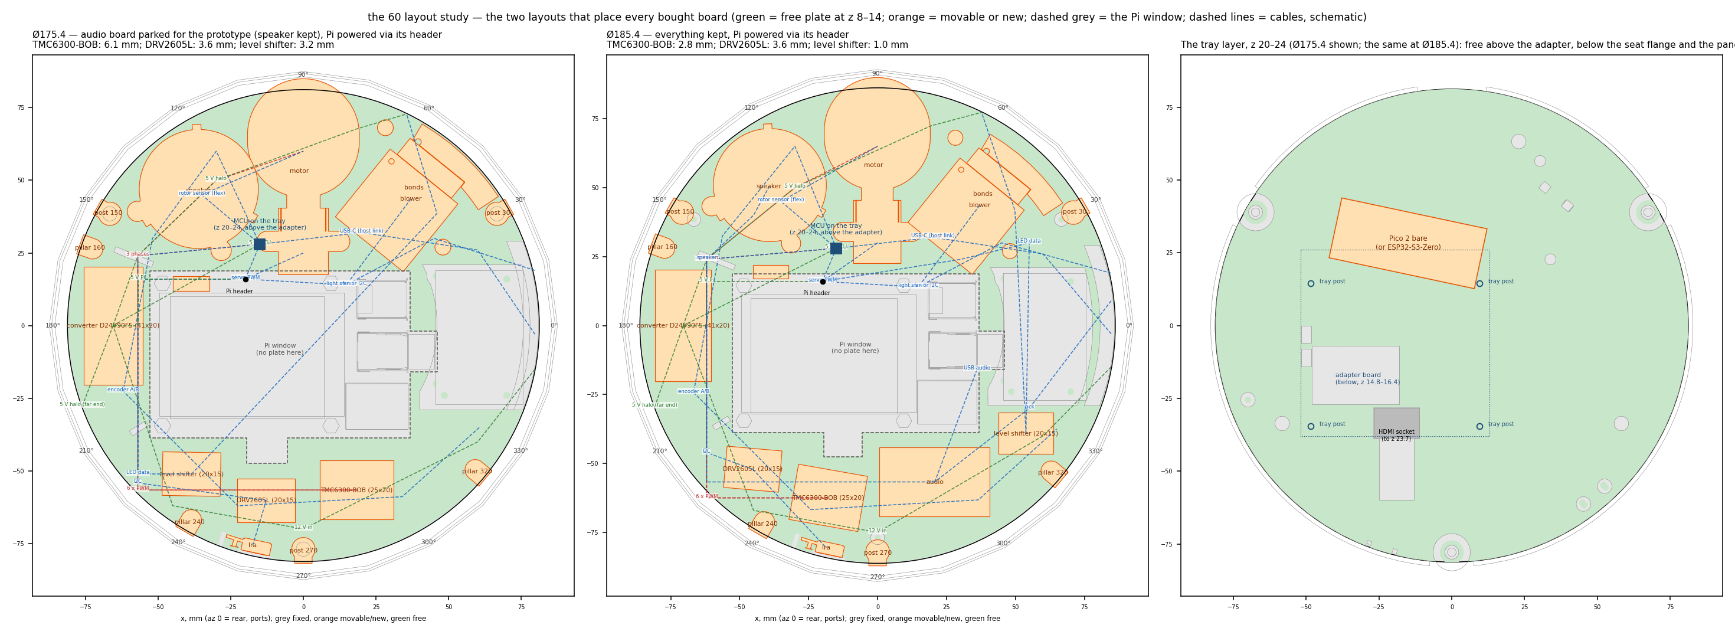
docs/layout/layout_study.png
