Ryan365Apps/spotify-knob/docs/v6c_figure.png

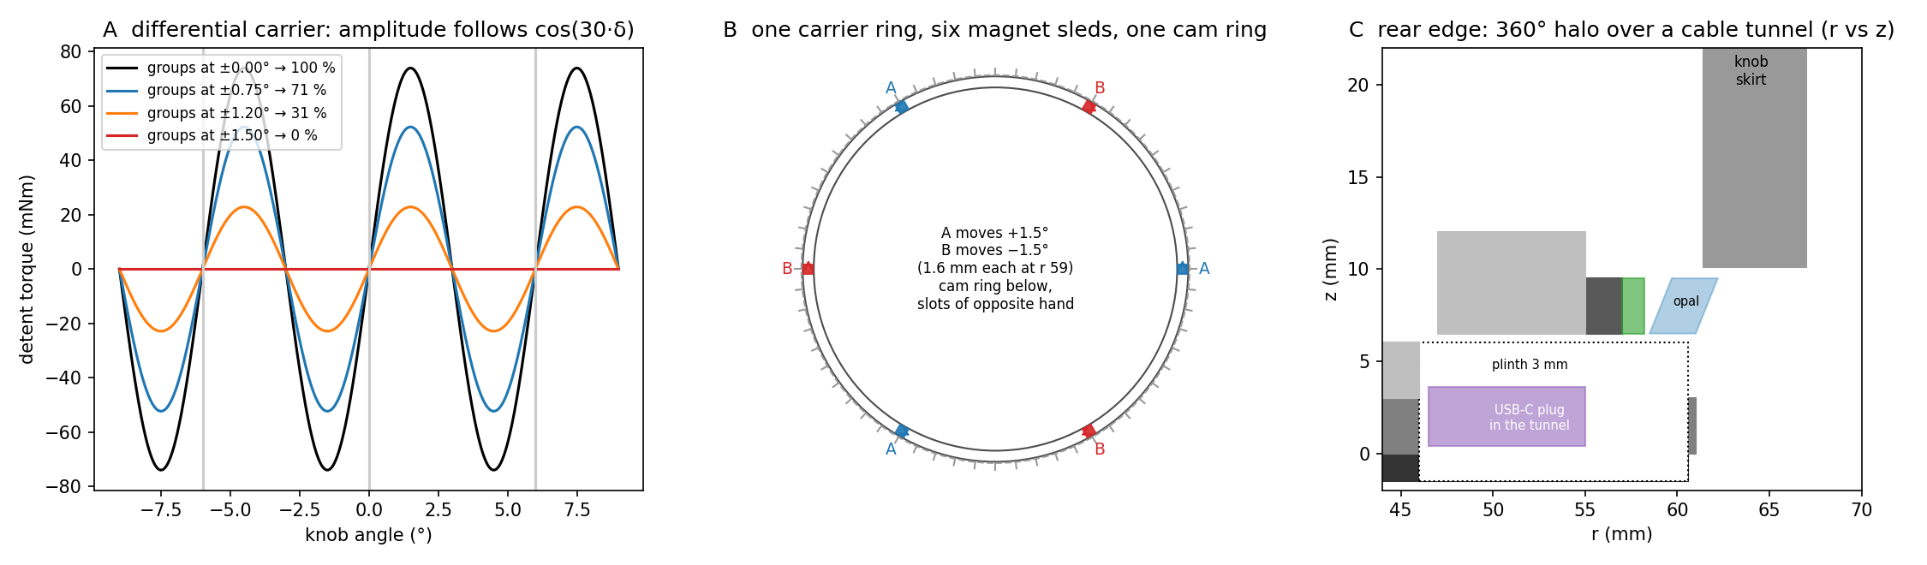
docs/v6c_figure.png
