Ryan365Apps/spotify-knob/docs/PREMIUM-BOM.md

# Retired — see `SOURCING-BOM.md`

This file was the bill of materials for the **ESP32-P4 3.4 inch concept** of 31 August 2026. That product no longer exists: the processor, the display, the detent mechanism, the audio path, the power architecture and the enclosure have all changed.

**The current bill of materials is [`docs/SOURCING-BOM.md`](SOURCING-BOM.md).**

The old content is in git history if it is ever wanted.
