Ryan365Apps/spotify-knob/docs/SOURCING-BOM.md

# the 60 — bill of materials

**Parts to buy. Nothing else.** Reasoning lives in the documents that made each decision; this file is the shopping list and is rewritten in place.

**Run:** 60 units. **Buy column** is what to order including spares. **Buyer:** UK. Prices ex-VAT, read on the date in the last column. China and USA lines carry roughly 25 % on top for import VAT, duty and handling.

**Status key:** ✅ specified and in stock · ⏳ specified, supply or lead time to confirm · ❓ not yet specified — cannot be ordered

---

## 1 · Display

| Part | Description | Per unit | Buy | Supplier | Price | Status |
|---|---|---|---|---|---|---|
| `DM-TFTR50-413` | 5 in round panel, 1080×1080, bare, 136.5 × 132.2 × 1.98 mm, active Ø127.0, HX8399-C driver, 4-lane display interface | 1 | 65 | DisplayModule | $119 ea, 20 % off at 500+ | ⏳ 3-week factory lead. Order all in one lot for one brightness bin |
| `TTG050BRT-01` | Same panel class, second source | — | — | Tailor Pixels | $40–61 | ⏳ verify same part and bin before switching |
| Cover lens with bonded touch | Round lens to drawing, optically bonded, 10-point capacitive, controller part number required | 1 | 65 | Chinese module house | quote | ❓ **no supplier engaged. Longest lead item in the product** |
| `FH12-22S-0.5SH` | 22-way 0.5 mm display flat-flex connector, carrier end | 1 | 70 | Hirose, via Mouser/DigiKey | ~$1 | ✅ |

## 2 · Computer

| Part | Description | Per unit | Buy | Supplier | Price | Status |
|---|---|---|---|---|---|---|
| `CM5104032` | Raspberry Pi Compute Module 5, 4 GB memory, 32 GB storage, wireless | 1 | 70 | Okdo / Farnell / RS for quantity; Pi Hut retail | £112 | ⏳ **supply risk — ask distribution for a real lead time before committing to a build date** |
| `10164227-1004A1RLF` | Compute module board-to-board connector, 4.0 mm stack (or `-1001A1RLF` for 1.5 mm) | 2 | 145 | Amphenol | ~$2 ea | ✅ not the Hirose part used on the CM4 |
| CR1220 + holder | Real-time clock backup cell | 1 | 70 | any | <£1 | ✅ |
| USB-C data/power splitter | Separates power-delivery negotiation from the data pair, so the computer can be mains-powered **and** be a USB device at the same time. **The Pi 5's USB-C socket is both its power inlet and its only device port** | 1 | 5 | 8086 Consultancy, via The Pi Hut | £3.00 inc VAT | ✅ bench part; on the production carrier this becomes a wiring rule, not a component |

## 3 · Made boards

| Board | Description | Per unit | Buy | Supplier | Price | Status |
|---|---|---|---|---|---|---|
| Carrier | 6-layer. Compute module, hub, USB-C, display connector, light sensor, power distribution, panel rails and backlight driver | 1 | 65 | PCBWay turnkey | ~£35–75 across all three boards | ❓ design not started |
| Audio | 6-layer | 1 | 65 | PCBWay turnkey | — | ❓ design not started |
| Motion | 4-layer, thermal vias under the driver | 1 | 65 | PCBWay turnkey | — | ❓ design not started — **and challenged, see §6** |
| Small boards | Jack carrier, USB-C carrier, light sensor, commutation, encoder breakout, actuator contact bracket | 6 | 6 × 65 | panelise together | — | ❓ no briefs written |

## 4 · Carrier board parts

| Part | Description | Per unit | Buy | Supplier | Price | Status |
|---|---|---|---|---|---|---|
| `USB2514B` | 4-port USB 2.0 hub, QFN-36, strap-configurable | 1 | 70 | Microchip | ~$2.50 | ✅ |
| 24 MHz crystal | For the hub | 1 | 70 | any | <£1 | ✅ |
| `USB4520-03-0-A` | USB-C receptacle, mid-mount, 3.16 mm | 1 | 70 | GCT | $0.52 @100 | ✅ |
| `VEML7700-TR` | Ambient light sensor | 1 | 70 | Vishay | $1.02 @100 | ✅ needs its own aperture, not behind the diffuser |
| Panel supply set | +5 V / −5 V analogue, 1.8 V logic, and a 37 V 20 mA constant-current backlight driver with dimming | 1 | 65 | — | — | ❓ **not designed. The prototype adapter does this today** |
| 5.1 kΩ 1 % | CC pull-downs, one per pin, never shared | 2 | 200 | any | — | ✅ |

## 5 · Audio board parts

| Part | Description | Per unit | Buy | Supplier | Price | Status |
|---|---|---|---|---|---|---|
| `XU316-1024-QF60B-C24` | XMOS 16-core USB audio controller, 7 × 7 mm | 1 | 70 | DigiKey | $7.53 @25, $6.85 @100 | ✅ 719 in stock, 12-week factory lead |
| `A316-Mini-V1` | Alternative: the above plus crystal and flash in a 13 × 13 mm module | 1 | 70 | Phaten | quote | ⏳ no published price or minimum order — ask |
| `ES9219Q` | Digital-to-analogue converter, QFN-40 5 × 5 mm | 1 | 70 | Mouser | $9.91 @100 | ⏳ **170 in stock, its sibling is obsolete — buy the whole run now** |
| `IM72D128V` | Digital microphone, 72 dB(A), 4 × 3 × 1.2 mm, bottom port. **Fit one, lay out two.** The second only earns its place if something does array processing — nothing in the design does today | 1 | 100 | Infineon | ~$2 ea | ⏳ enclosure needs one acoustic port, and it is not designed yet |
| `ASDLJ-E-49.152MHZ-L-R-T` | Master clock oscillator, 54 fs jitter | 1 | 70 | Abracon | $2.01 @1 | ✅ |
| `ASDLJ-E-45.1584MHZ-L-R-T` | Second master clock | 1 | 70 | Abracon | ~$2 | ✅ |
| `AT25FF321A` | Boot flash, quad-SPI | 1 | 70 | Renesas | ~$1 | ✅ part XMOS's own application ships |
| 24 MHz crystal | 12 pF load, ESR ≤ 60 Ω | 1 | 70 | Epson FA-238 or IQD | <£1 | ✅ omit if the module is used |
| `TPS62822` | 0.9 V core regulator, design for 1 A | 1 | 70 | TI | ~$1 | ✅ also used for the 3.3 V rail |
| `TPS7A20` | Low-noise analogue 3.3 V regulator | 1 | 70 | TI | ~$1 | ✅ |
| `SP3012-03UTG` | 3-channel line protection, 0.5 pF | 1 | 70 | Littelfuse | <£1 | ✅ |
| `35RAPC4BH3` | 3.5 mm line-output jack, threaded nickel bushing | 1 | 70 | Switchcraft | £2.39 @100 | ✅ shell must be isolated from chassis |
| `20021521-00020T4LF` | Debug header, 1.27 mm 2×10 | 1 | 5 | Amphenol | ~£2 | ✅ keep one, not per unit |

## 6 · Motion board parts

> **⚠ 7 September 2026 — this board is challenged, not cancelled.** `the60-function-allocation.md` finds that **one prototype needs no custom board at all**: a bought microcontroller board and a bought driver breakout cover the motor, both angle sensors, the vibration actuator and the keyboard-and-mouse job, while the ninety LEDs and the clutch servo move onto the computer, where both are handled by hardware peripherals. If that holds on the bench, what remains of this board is a microcontroller, the driver, two level shifters and connectors — the halo level shifter, the servo drive and this board's own USB device role all leave, and with them the strongest argument for the RP2350. **Do not commission this board until the bench tests in §14 have run.** The parts below stand as the production specification in the meantime.

| Part | Description | Per unit | Buy | Supplier | Price | Status |
|---|---|---|---|---|---|---|
| `RP2350B` | Microcontroller, 80-pin, 48 pins out | 1 | 70 | Raspberry Pi | $0.90 | ⏳ **reopened** — the halo was reason one for this chip and the halo may move to the computer |
| Flash + 12 MHz crystal | External boot flash and crystal | 1 | 70 | any | ~£1 | ✅ |
| `TMC6300-LA-T` | Three-phase motor driver, QFN 3 × 3 mm | 1 | 70 | Analog Devices | ~$4 | ✅ 1.0 A continuous per bridge — set the stall limit in firmware |
| `MT6701CT-STD` | Motor rotor angle sensor, serial mode | 1 | 70 | MagnTek | ~$2 | ✅ **no reputable breakout of this part exists — not stocked by Mouser, DigiKey, Farnell or RS in any form. Bench modules are unbranded only** |
| Ø6 × 2.5 magnet | Diametrically magnetised, for the above | 1 | 70 | — | <£1 | ⏳ the motor maker may fit it |
| `AEDR-8300-1W2` | Knob encoder, reflective, 212 lines per inch, 3.0–5.5 V | 1 | 70 | Broadcom, via Farnell UK | £8.10 @1 ex VAT | ✅ **confirmed: 2,016 in stock at Farnell UK, but a 14-week manufacturer lead time once they go. The `-1K2` is confirmed no longer stocked.** Being 3.3 V native, this part also deletes the encoder level shifter |
| Code ring | Chrome on polyester, reflective ≥60 %, dark <10 %, bonded into the crown's underside recess | 1 | 70 | MELTEC, PWB Encoders, Laser Lab or Optry Tech | quote | ❓ **the longest pole in the electronics.** No off-the-shelf reflective code ring exists for this sensor from any supplier, and no bought alternative measures a 150 mm circle — the largest standard magnetic ring on the market is 100 mm and its vendor does not ship to the UK. Thickness and substrate unsourced; 0.15 mm assumed |
| `DRV2605L` | Haptic driver, I²C address 0x5A | 1 | 70 | TI | $1.22 @100 | ✅ stays on the microcontroller — its trigger is computed there, and the computer's worst-case scheduling delay is tens of milliseconds |
| `VLV101040A` | Linear resonant actuator, 10 × 10 × 4 mm, 170 Hz | 1 | 70 | Vybronics | ~$5 | ✅ **must not be soldered — spring contacts only** |
| `SN74AHCT1G125DBVR` | 5 V level shifter for the halo data line | 1 | 70 | TI | <£1 | ⏳ **still required, but probably not on this board** — it follows the halo to whichever processor drives it. Must be HCT or AHCT, not HC/AHC |
| `USBLC6-2SC6` | USB port protection | 1 | 70 | ST | <£1 | ✅ |
| `MAX98357A` | Class-D amplifier for the notification speaker | 1 | 70 | Analog Devices | £1.30 @100 | ⏳ **which board carries it is unresolved — not the audio board** |
| `INA240A1` + 50 mΩ 2512 | In-line current sense, **footprints only, do not fit** | 0 | 10 | TI / Susumu | — | ✅ 0 Ω links fitted instead |

## 7 · Motor and mechanism

| Part | Description | Per unit | Buy | Supplier | Price | Status |
|---|---|---|---|---|---|---|
| Gimbal motor, 2804 frame | Drives the knob's bore through a silicone band and renders the detents | 1 | 70 | JD-Power MY-3514C, or a generic 2804/2805 | £8–56 | ⏳ **almost nothing published — buy three now and measure them.** The MY-3514C is £56 and its hollow shaft is inherited from the old centre-mounted layout; the motor is now off-axis with nothing passing through it, so test whether a generic gimbal motor qualifies. **Nothing on the bench works without one — this is the item that stops the build.** SmartKnob's own maintainer warns most cheap gimbal motors have moderate to severe cogging, which fights virtual detents directly; his debugged alternative is SparkFun ROB-20441 at $45.95 |
| Silicone friction band | ~0.6 × 8 mm, Shore 40–70, stretched onto the bell | 1 | 100 | — | <£1 | ❓ hardness chosen on the bench |
| 1.5 g linear servo | Clutch actuator. **2.4 mm of travel is all the mechanism needs**; the 2.4 N figure is the AGFRC's published output, not a measured requirement | 1 | 70 | see note | £8–47 | ⏳ **AGFRC C1.5CLS PRO is £47 and is the premium badge on a commodity class.** Spektrum SPMAS2000 £11.95, Hobbypower/Flash Hobby GS-1502 cheaper. Buy all three and measure the force the clutch actually needs. AGFRC publish no current draw, pulse range, frame rate or dead band, so a UK-stocked equivalent is worth having on the bench first |
| `623ZZ` | Wheel bearing, 3 × 10 × 4 | 3 | 200 | Simply Bearings | £1.92 @99 | ✅ |
| V-collar | Turned, pressed onto the bearing | 3 | 200 | knob machinist | quote | ⏳ POM in production |
| Eccentric bush | Turned brass, sets wheel preload | 3 | 200 | knob machinist | quote | ⏳ |

## 8 · Halo and light

| Part | Description | Per unit | Buy | Supplier | Price | Status |
|---|---|---|---|---|---|---|
| Addressable LED strip | 5 mm wide, ~100 LEDs per metre, WS2812B-2020 or SK6812 class, adhesive backed. **≈53 LEDs per unit** — recompute from the strip radius as built | ~0.55 m | 40 m | LCSC or a strip house | ~£3 per metre | ⏳ **buy two candidate strips and bench-test before committing.** One reel and one date code for the whole run |
| Opal diffuser ring | Perspex 1TL1 (36 %) or 1TL2 (48 %), cut to the L-section | 1 | 70 | Simply Plastics | £3–8 | ⏳ printed PETG for prototypes only |

## 9 · Enclosure

| Part | Description | Per unit | Buy | Supplier | Price | Status |
|---|---|---|---|---|---|---|
| Knob | One-piece CNC 6082-T6 cup, milled diamond pattern, V-groove in the bore, code-ring recess in the crown | 1 | 65 | JLCCNC, Xometry UK, Hubs UK, Penta Precision | quote | ⏳ groove-to-bore concentricity 0.05 total — say so on the request |
| Knob finish | Bead blast, Type II matte black anodise | 1 | 65 | Parallel Precision | £4 @50, £2.80 @100 | ✅ |
| Knob bright chamfer | Diamond-cut after anodise, second setup, then protection | 1 | 65 | machining shop | quote | ⏳ sample lacquer and clear anodise on two parts first |
| Base plate, aluminium core | 6082, ducted: 2 mm web with local thickening at every tapped hole, 3 × 5 mm fin channels, top-face ribs, Ø7 piers under the top screws | 1 | 65 | CNC shop | quote | ⏳ 341 g as built. **Re-cutting is now expected** — the bought boards are roughly three times the 30 × 30 mm area budgeted for the motion board |
| Base plate finish | **Black hard anodise external faces only. Internal faces chromate conversion or bare** | 1 | 65 | anodiser | quote | ✅ no masking required |
| Closing plate | 1 mm, closes the duct, outer face black anodised, 9 screws | 1 | 65 | CNC or laser | quote | ✅ |
| Duct gasket | 0.2 mm, between the closing plate and the plate core | 1 | 70 | die-cut | ~£1 | ⏳ material to choose |
| Stainless rim ring | Outer band, 8 mm tall × 8 mm thick, ~205 g. **92 obround openings 2.0 × 4.5** (64 intake, 28 exhaust), 0.3 mm polished chamfer at every opening, **no reeding** | 1 | 65 | CNC | quote | ⏳ **brushed axially.** Bond screw needs bare metal or a star washer that cuts through |
| Rubber pad | Ring, non-marking, adhesive backed. Natural rubber or nitrile, not silicone | 1 | 70 | Delta Rubber | £2–5 | ✅ no tooling, no minimum |

## 10 · Power

| Part | Description | Per unit | Buy | Supplier | Price | Status |
|---|---|---|---|---|---|---|
| Mains supply | **12 V, 5 A, Class II two-pin, double insulated.** Require the touch-current / leakage figure on the datasheet | 1 | 65 | Mean Well, XP Power or similar | £15–25 | ❓ **part not chosen** |
| `PJ-063AH` | Barrel inlet, 5.5 × 2.1 mm, right angle | 1 | 70 | CUI / Same Sky | ~£1 | ⏳ fetch the CAD model |
| 12 V → 5 V converter | ~7 A. Bought module for prototypes; on the carrier for production | 1 | 70 | — | £5–10 | ⏳ **check the derating curve — a module rated 10 A is rated 10 A with airflow** |
| `BFB0305HA-C` | Radial blower, 30 × 30 × 10 mm, 0.68 L/s free air, 71 Pa. **Required and fitted** | 1 | 70 | Delta | ~£10 | ✅ mounts on the plate under the motion board's saddle |
| Thermal gap pads | Under the compute module boss, the converter and the motor driver | 3 | 250 | Bergquist or similar | ~£1 | ✅ |

## 11 · Connectors, cable and harness

| Part | Description | Per unit | Buy | Supplier | Price | Status |
|---|---|---|---|---|---|---|
| Pico-Lock 1.50, right angle | **The connector family for every crimped joint.** 2.00 mm mated, 30 mating cycles, AWG 24–28, 2–6 A, positive lock. Circuit counts follow the interface list | ~18 | — | Molex | ~£0.50 ea | ✅ exact part numbers once the interface list is fixed |
| Internal USB assemblies | Pre-made twisted pair, under 150 mm, hub to audio and hub to motion | 2 | 150 | harness house | quote | ⏳ **not a crimped connector — a crimp and a loose wire is not a 90 Ω transmission line** |
| Wiring harness | ~20 assemblies. One runs to the moving carriage and needs flex-rated cable | 1 set | 65 | harness house | quote | ❓ **have it made. Hand-crimping is where solo builds go wrong** |
| Spring contacts | Pogo pins for the vibration actuator, on their own small board in a clip | 2 | 150 | Mill-Max | ~£1 | ✅ |
| Knob bleed contact | Sprung phosphor-bronze leaf or spring pin, plus a 1 MΩ resistor | 1 | 70 | — | <£1 | ❓ form and mounting not designed |
| USB-C cable | Detachable, braided, right angle | 1 | 70 | ByteCable / WJW custom, MOQ 100 | $1.30–2.80 | ⏳ or an Anker retail cable at ~£12 |

## 12 · Fasteners and small parts

As built in v16 (`docs/v16/the60_v16/docs/V16-SPECIFICATION.md` 4.18 is the full count). One screw size above M2: **every former M3 is M2.5** (Ryan, 8 Sep).

| Part | Description | Per unit | Buy | Supplier | Price | Status |
|---|---|---|---|---|---|---|
| DIN 7991 M2.5 × 8 countersunk | Plate to the structure's pillars (3) and rim ring to the core (7) | 10 | 800 | Accu | — | ✅ |
| M2.5 heat-set inserts, Ø3.5 × 4.0 | In the structure's three pillars | 3 | 250 | Ruthex / CNC Kitchen | — | ✅ |
| DIN 7985 M2.5 pan (× 8 and × 6) | Ring bond (× 8, thread-locked) and chassis bond (× 6) | 2 | 200 | Accu | — | ✅ |
| DIN 6798 A M2.5 external-tooth star washers | Under both bond screws | 2 | 200 | any | — | ✅ |
| M2.5 ring terminal, 22–24 AWG | The chassis bond wire | 1 | 100 | any | — | ✅ |
| DIN 7991 M2 countersunk studs (4 × M2 × 22, 8 × M2 × 16) + DIN 934 M2 nuts | Every plate board and the MCU tray: studs from below, nuts above | 12 + 16 | 1,000 + 1,200 | Accu | — | ✅ |
| M2.5 × 12 hex standoffs, M2.5 × 6 csk, M2.5 × 5, 0.5 washers | The Pi and adapter stack | 4 + 4 + 4 + 4 | 300 each | Accu | — | ✅ |
| M2.5 × 4 | Servo frame, connect bracket (csk), speaker cradle, closing plate (9, csk) | 15 | 1,200 | Accu | — | ✅ |
| M2 × 16 pan | Blower saddle + blower into the piers | 2 | 200 | Accu | — | ✅ |
| M2 × 4, × 5, × 6 + M2 inserts | Port face rail (2), hood lid (2), encoder board (2 + 2 inserts), connect board (4 + 4 inserts), bleed foot (1 + 1 insert) | 11 + 7 | 900 + 600 | Accu / Ruthex | — | ✅ |
| M2 × 18 pan + M2 nut | The sprung block's captive release screw | 1 + 1 | 100 | Accu | — | ✅ |
| V623ZZ V-groove bearings | The three knob wheels (V depth ASSUMED 1.2 — measure before the ridge is cut) | 3 | 250 | bearing supplier | — | ⏳ V to confirm |
| ISO 8734 Ø3 m6 × 10 and × 16 dowel pins + M3 × 0.5 washers | The wheels' axles (2 fixed, 1 in the block) and the fixed posts' washers | 2 + 1 + 2 | 250 each | Accu | — | ✅ |
| Ø4 × 16 compression spring, ~0.8 N/mm | The sprung block | 1 | 100 | Lee Spring / Accu | — | ⏳ rate to confirm on the bench |
| Ø2 m6 × 8 dowel pins | Display centring, in bosses under the seat flange | 3 | 250 | Accu | — | ✅ |
| Display bonding tape | 0.5 mm double-sided foam, under the glass edge | 1 | 70 | 3M | — | ✅ |
| Foam gaskets | Blower inlet (0.3), hood (0.3), closing plate (0.2, two pieces), opal ring (0.3) | 5 | 400 | die-cut | — | ✅ |
| Thread lock | For the bonding screws | — | 1 | Loctite | — | ✅ |

**No screws anywhere on the knob.** Deleted, do not buy: grub screws (there are no eccentric bushes), M3 anything.

## 13 · Packaging

| Part | Description | Per unit | Buy | Supplier | Price | Status |
|---|---|---|---|---|---|---|
| Rigid box, insert, certificate | Black, magnetic closure, foil or blind deboss, foam or pulp insert | 1 | 120 | Packhelp (MOQ 120) or Tiny Box Company | £6–16 all in | ⏳ **re-quote at the current diameter.** Foil or deboss block £50–150 one-off |

---

## 14 · Prototype and bench — the current buy list

**Read 7 September 2026.** This section is rewritten in place; it is not a history. It buys the electronics needed to prove the whole of the object's behaviour on a bench **without commissioning a single circuit board** — the case for which is in `the60-function-allocation.md`. Prices as shown by each supplier: The Pi Hut, Pimoroni, eBay and Amazon include VAT; Farnell excludes it.

### Order today

| Supplier | Part | Why | Qty | Price |
|---|---|---|---|---|
| The Pi Hut | **ESP32-S3-DevKitC-1** | The real-time core: motor, both angle sensors, the vibration actuator, and the keyboard-and-mouse job. Hardware quadrature counter, native USB, and the microcontroller family SmartKnob's own firmware is written for. **70 × 28 mm** | 1 | £28.90 |
| The Pi Hut | **DRV2605L breakout** (Pimoroni-badged) | Drives the vibration actuator on headers. Adafruit's own board is sold out here | 1 | £14.10 |
| The Pi Hut | **AS5600 magnetic angle sensor** | Stand-in second angle sensor, so the two-angle control problem can be proved before the code ring exists | 1 | £5.40 |
| The Pi Hut | **USB-C data/power splitter** | Lets the computer be mains-powered and a USB device at once. Needed whatever is decided about the keyboard-and-mouse job, because the companion application's data link uses the same port | 1 | £3.00 |
| The Pi Hut | **74AHCT125 quad level shifter** | Mandatory for the halo at 5 V. Correct logic family | 1 | £1.30 |
| Farnell UK | **`TMC6300-BOB`** | The exact driver from §6, on headers. **Only four in stock — buy two today** | 2 | £19.96 ea ex VAT |
| Farnell UK | **`AEDR-8300-1W2`** | 212 lines per inch, 3.3 V native. **14-week lead time once the current 2,016 are gone** | 3 | £8.10 ea ex VAT |
| Pimoroni | **Raspberry Pi Pico 2** | The fallback core, and probably the production one. **51 × 21 × 1 mm** — the only option that plausibly fits the current plate | 1 | £3.60 |
| eBay / Amazon UK | **MT6701 module** | No reputable breakout exists. Buy two, expect one to be poor | 2 | ~£6 ea |
| eBay UK | **1.5 g linear servo, UK stock** | Proves pulse range and current draw, which AGFRC do not publish, while the real part is in transit from China | 1 | £20.99 |

**≈ £166 including VAT.** Everything except the MT6701 modules is UK next-day.

### Check the drawer before ordering

| | Note |
|---|---|
| **Gimbal motor** | Nothing on the bench works without one — see §7. If three are not already on order, this is the item that stops the build |
| **Addressable LED strip** | §8. The 144-per-metre side-emitting strip is what tests the ninety-LED path on the computer, which is the first evening's work |
| **Linear resonant actuator** | To plug into the DRV2605L. Precision Microdrives are UK-based and catalogue several; their site would not return a price, so ring them |
| **Bench basics** | Jumper leads, breadboard, and a 5 V supply good for a few amps |

### Already held, from earlier orders

Raspberry Pi 5 · Waveshare 5 in HDMI round touch display · `DM-TFTR50-413` bare panel and `DM-ADTTR-014` adapter · compute module and IO board.

### Optional

| Part | Why | Price |
|---|---|---|
| Makerfabs MaTouch SmartKnob, assembled | A hand-feel benchmark that arrives working, in stock | $69.00 |
| ~~SeedLabs SmartKnob DevKit~~ | **Corrected: £329, not ~£100.** It is a different board from the original — 72 LEDs, ESP32-S3, added load cell and proximity sensor — its store publishes no shipping policy or delivery estimate, and **its licence is not Apache 2.0: commercial use requires a partnership agreement with royalties.** The Makerfabs unit does the same job for a tenth of the price | £329 |

### The five bench tests, in order

1. **Ninety LEDs off the computer, under load.** The SPI route first (no kernel module, no programmable-I/O block), the official programmable-I/O example second. Run a heavy interface scene at the same time and watch for flicker. **This is the one genuine unknown — nobody has published ninety LEDs on a Pi 5 under load.** If it fails, the halo returns to the microcontroller and the RP2350 argument in §6 comes back.
2. **Computer as a USB keyboard, mains-powered, through the splitter.** Hand-written composite-device configuration; every published example targets a Pi Zero.
3. **Motor spinning under SimpleFOC** with the driver breakout and the MT6701, then detents. **The day that matters — everything else is subordinate to whether the feel is right.**
4. **The two-angle problem**, with the AS5600 on a friction-coupled second shaft. The genuinely novel work; no prior art helps.
5. Servo pulse range and current from the computer's hardware PWM; vibration actuator from the microcontroller.

### Send today, costs nothing

**The code-ring enquiry** to MELTEC, PWB Encoders, Laser Lab and Optry Tech. It is the only item in the electronics with a multi-week clock and it has not started.

---

## Deleted — do not buy

The Waveshare ESP32-P4 board · detent magnets and the sixty steel balls · the brass mass ring · the magnet carrier gearmotor · the ring motor, drive tyre and solenoid · the headphone amplifier stage · **the supercapacitors** (the Abracon part cannot supply the current; the Eaton replacement does not fit the cavity) · **the custom flexible LED ring** (a bought strip replaces it) · the steel base plate.

## Roll-up

| | Low £ | High £ |
|---|---|---|
| Bought parts and made boards, per unit, landed, ex-VAT | **≈ 400** | **≈ 780** |

Middle of the range with a Chinese knob: **roughly £500–580 per unit.** Not a quote.

**Excluded:** board layout contract (£4,000–8,000 one-off), assembly labour, and compliance testing (£6,000–12,000 plus a retest — see `docs/SYSTEM-REVIEW.md` 4.2). **The board layout figure is now the one to challenge** — with the halo, the servo and the USB device role moved off, the motion board shrinks to a microcontroller, a driver, two level shifters and connectors, which is a materially cheaper thing to have designed.

## Cannot be ordered until specified

The cover lens and touch sensor · the panel's rails and backlight driver · the mains supply · the code ring · the wiring harness · the knob's bleed contact · the six small boards · which board carries the speaker amplifier · the duct gasket material.
