Ryan365Apps/spotify-knob/docs/v9/the60_v9/parts/README.txt

the 60 - v9 - printable parts (print orientation; they will not assemble as exported)

knob_body            0.16 mm  ONE PIECE. top face down, no supports. bore smooth except the 0.15 code-band recess and the V-groove
internal_structure   0.20 mm  upright on the wall foot; SUPPORT the ledge underside, the lip and the four 1.2 mm seat tabs
halo_diffuser        0.20 mm  on its underside; natural / translucent PETG
carriage             0.16 mm  flat; Ø37 shoe, sensor pocket underneath, push tab; slides in the plate hole
servo_mount          0.20 mm  flat; tray for the AGFRC servo envelope, open toward the carriage
speaker_cradle       0.20 mm  flat; ring under the speaker flange with three snap fingers
port_face            0.16 mm  standing as modelled; USB-C opening, jack hole, light-sensor aperture
collar_0             0.12 mm  x3, axis vertical; press over a 623ZZ
bush_0               0.12 mm  x3, pin up; brass in production
base_plate_STEEL      laser-cut 5 mm mild steel, powder-coated; Ø124

Bought: JD-Power MY-3514C gimbal (envelope only); AGFRC C1.5CLS PRO servo (envelope);
3x 623ZZ; Waveshare ESP32-P4-WIFI6-Touch-LCD-3.4C (PMMA back plate off); Soberton SP-4005-1;
2x Abracon AHCR-S04R0SA206Q; TMC6300; MT6701 + D6x2.5 magnet; AEDR-8300 + 0.15 code strip;
DRV2605L + VLV101040A; ES9219Q; Switchcraft 35RAPC4BH3; GCT USB4520; VEML7700; 90x SK6812SIDE-A.

Open the60_v9_assembly.step (every body named, assembled position) in Fusion, not the parts.
