Ryan365Apps/spotify-knob/design/artwork/blender/v9/the60_v9_assembly.obj

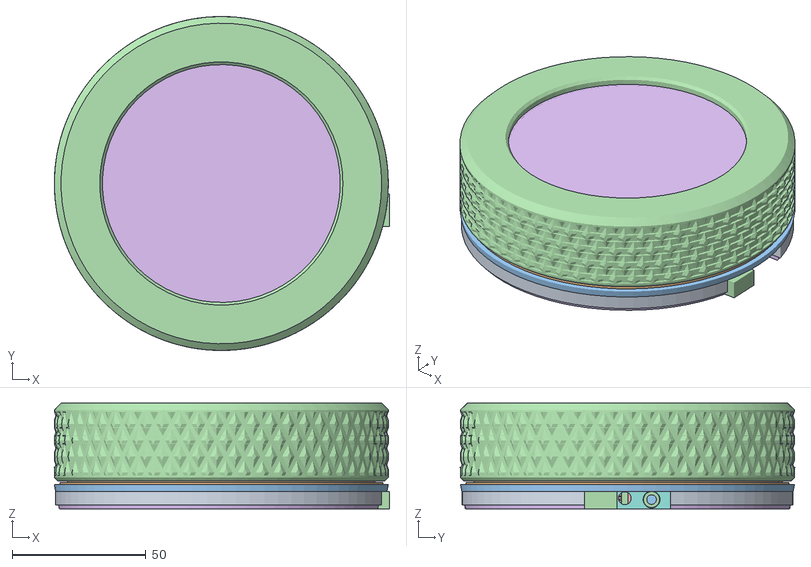
[picture p203: CAD file, 2026-09-04]
design/artwork/blender/v9/the60_v9_assembly.obj
125.5 x 125.0 x 39.6
base_plate
internal_structure
halo_diffuser
knob_body
carriage
servo_mount
speaker_cradle
port_face
driver_board
encoder_board
usbc_board
jack_board
light_board
commutation_board
led_flex
collar_0
bush_0
collar_1
bush_1
collar_2
bush_2
display_case
display_pcb
display_part_000_86x65x2.0
display_part_001_51x7x5.1
display_part_002_12x13x7.0
display_part_003_10x10x2.0
display_part_004_15x16x2.5
display_part_005_13x17x0.8
display_part_006_9x8x5.6
display_part_007_19x5x2.0
display_part_008_19x5x1.0
display_part_012_5x5x8.0
display_part_012_5x5x8.0__2
display_part_012_5x5x8.0__3
display_part_012_5x5x8.0__4
display_part_013_19x5x0.8
display_part_015_8x7x3.6
display_part_015_8x7x3.6__2
display_part_017_10x8x4.2
display_part_017_10x8x4.2__2
display_part_019_4x5x3.8
display_part_019_4x5x3.8__2
display_part_020_19x2x1.6
display_part_021_6x8x0.8
display_part_022_4x4x2.0
display_part_023_4x4x2.0
display_part_025_5x3x4.2
display_part_025_5x3x4.2__2
display_part_026_12x10x1.6
display_part_027_2x5x2.3
display_part_028_2x5x2.3
display_part_029_3x5x2.1
display_part_033_4x4x4.0
display_part_033_4x4x4.0__2
display_part_033_4x4x4.0__3
display_part_033_4x4x4.0__4
motor_motor_ENVELOPE
motor_band
motor_magnet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
