Ryan365Apps/spotify-knob/design/cad/bought-parts/step/Abracon_AHCR-S04R0SA206Q_supercap_20F.step

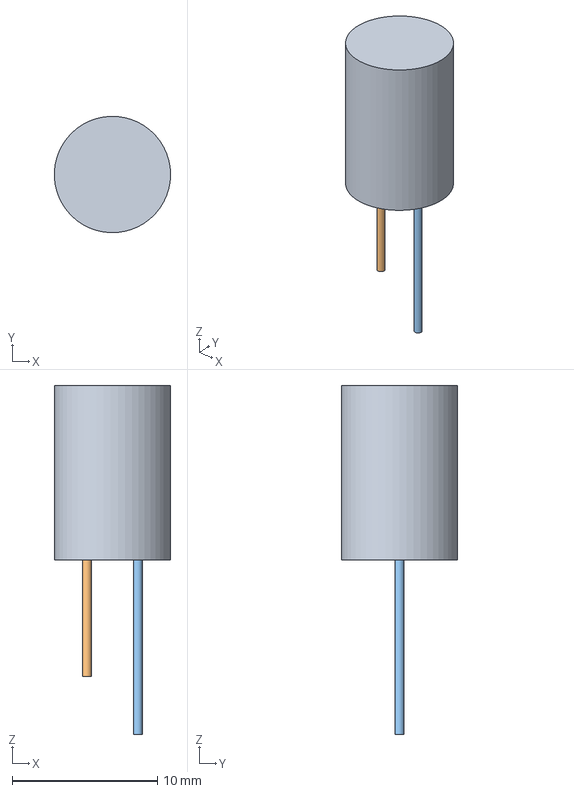
[picture p204: CAD file, 2026-09-04]
design/cad/bought-parts/step/Abracon_AHCR-S04R0SA206Q_supercap_20F.step
7.99 x 8.00 x 24.0 mm
can_with_sleeve
lead_short_cathode_side
lead_long_anode_side
