Ryan365Apps/spotify-knob/docs/v16/boards/usbc_board.step

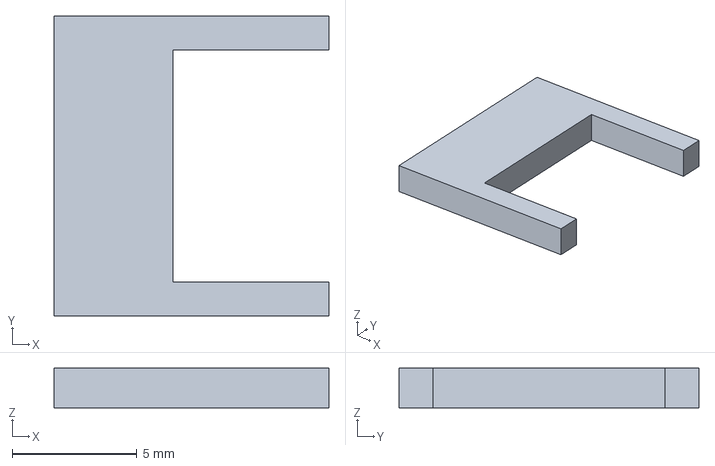
[picture p205: CAD file, 2026-09-08]
docs/v16/boards/usbc_board.step
11.0 x 12.0 x 1.60 mm
