Ryan365Apps/spotify-knob/docs/v16/parts/internal_structure.step

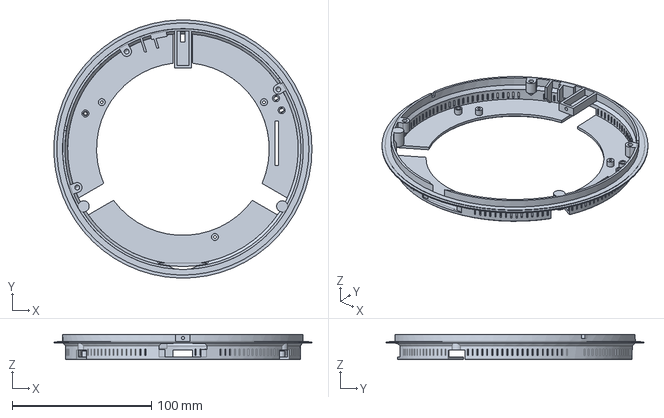
[picture p206: CAD file, 2026-09-08]
docs/v16/parts/internal_structure.step
185.3 x 185.3 x 18.0 mm
