Ryan365Apps/spotify-knob/design/cad/bought-parts/step/Vybronics_VLV101040A_LRA.step

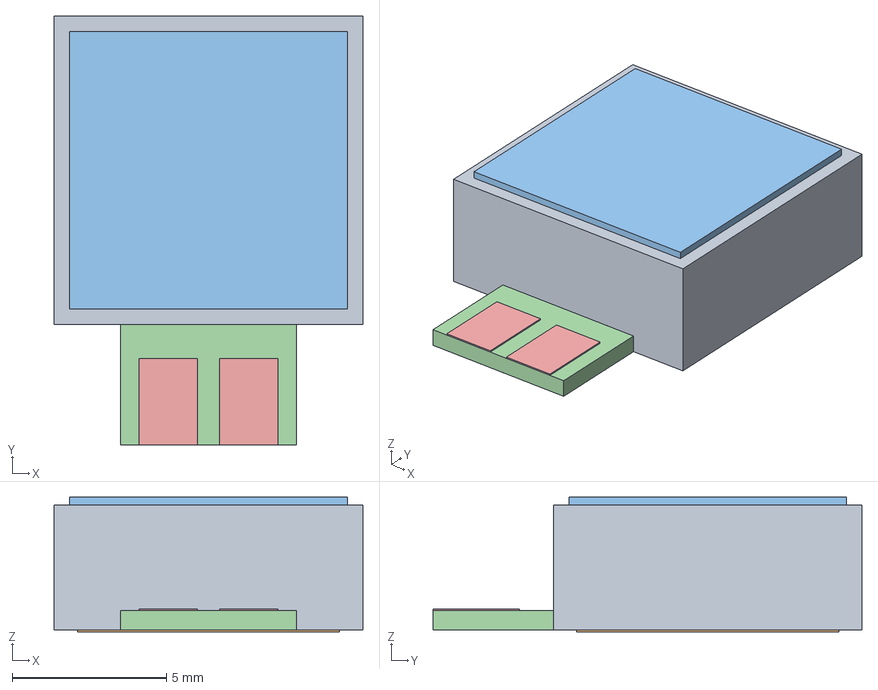
[picture p207: CAD file, 2026-09-04]
design/cad/bought-parts/step/Vybronics_VLV101040A_LRA.step
10.0 x 13.9 x 4.37 mm
can
adhesive_tape
poron_top
fpc_tail
