Ryan365Apps/spotify-knob/docs/v16/boards/ls_board.step

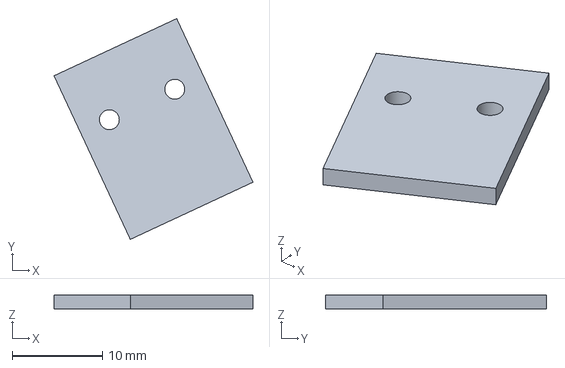
[picture p208: CAD file, 2026-09-08]
docs/v16/boards/ls_board.step
22.0 x 24.5 x 1.60 mm
