Ryan365Apps/spotify-knob/docs/v16/parts/base_plate_AL.step

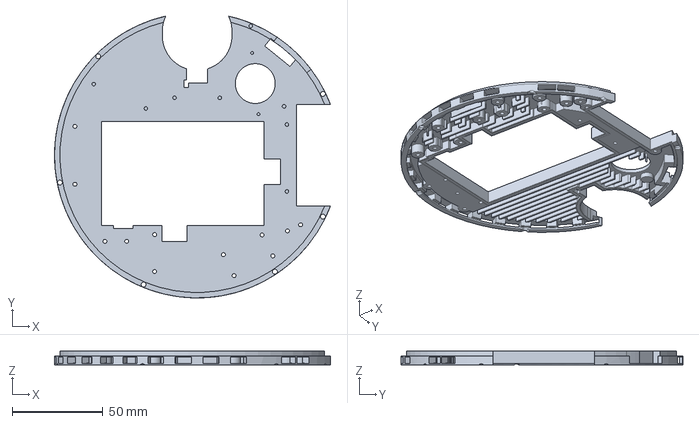
[picture p209: CAD file, 2026-09-08]
docs/v16/parts/base_plate_AL.step
152.5 x 155.6 x 8.00 mm
