Ryan365Apps/spotify-knob/design/cad/bought-parts/step/AGFRC_C1p5CLS_PRO_linear_servo.step

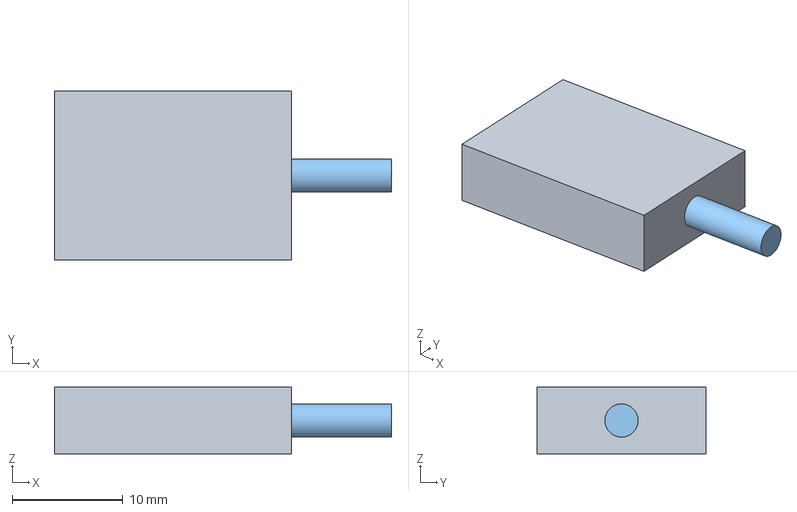
[picture p210: CAD file, 2026-09-04]
design/cad/bought-parts/step/AGFRC_C1p5CLS_PRO_linear_servo.step
30.4 x 15.2 x 6.00 mm
body_ENVELOPE
pushrod_ASSUMED
stroke_keepout_9mm_ASSUMED
