Ryan365Apps/spotify-knob/docs/v16/boards/adapter_board.step

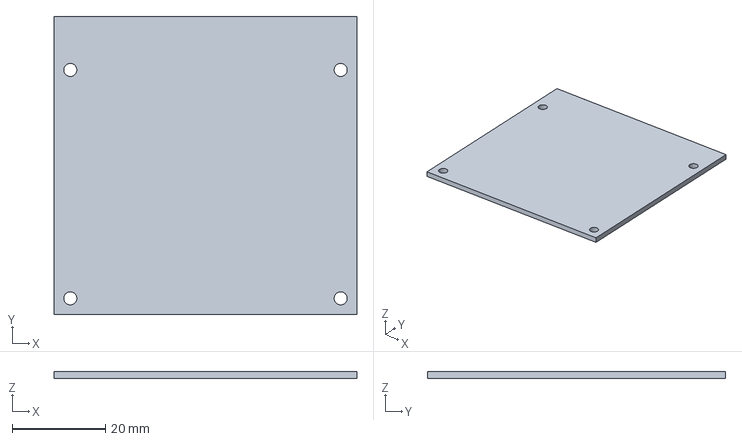
[picture p211: CAD file, 2026-09-08]
docs/v16/boards/adapter_board.step
65.0 x 64.0 x 1.60 mm
