Ryan365Apps/spotify-knob/docs/v16/parts/rim_ring_STEEL.step

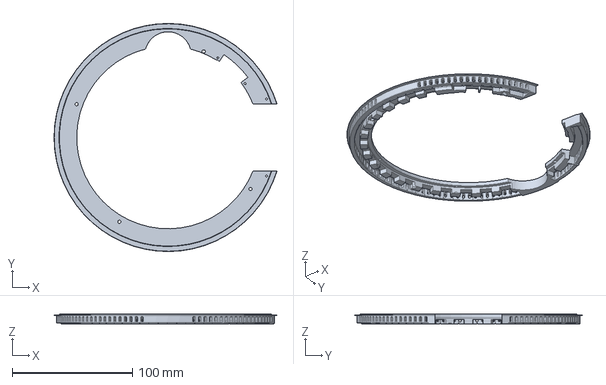
[picture p212: CAD file, 2026-09-08]
docs/v16/parts/rim_ring_STEEL.step
185.2 x 189.4 x 8.00 mm
