Ryan365Apps/spotify-knob/design/cad/bought-parts/step/Broadcom_AEDR-8300-1K2_encoder.step

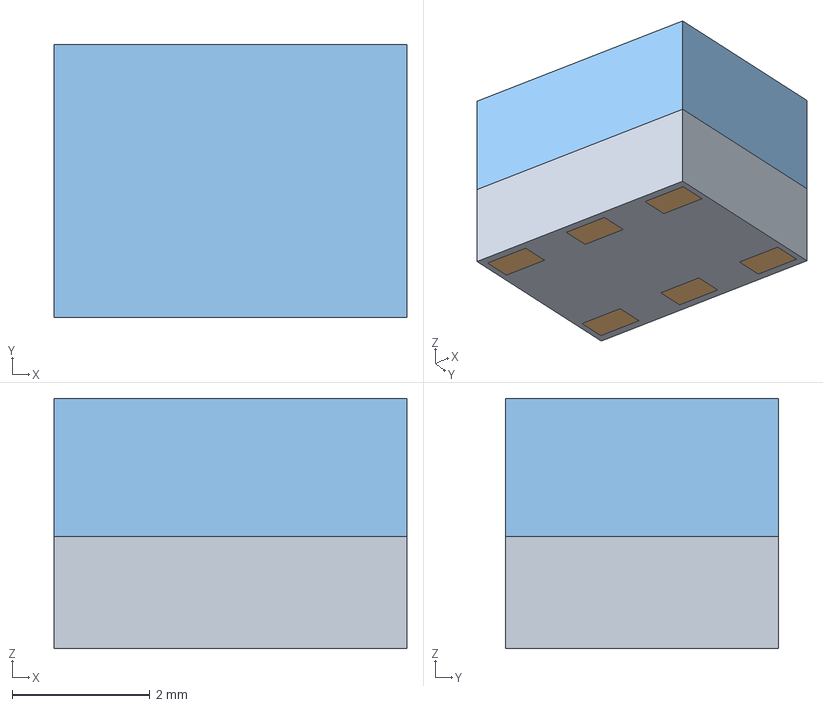
[picture p213: CAD file, 2026-09-04]
design/cad/bought-parts/step/Broadcom_AEDR-8300-1K2_encoder.step
5.12 x 3.96 x 3.63 mm
package
terminals_6x
reflective_gap_2mm_typ
