Ryan365Apps/spotify-knob/docs/v16/boards/audio_board.step

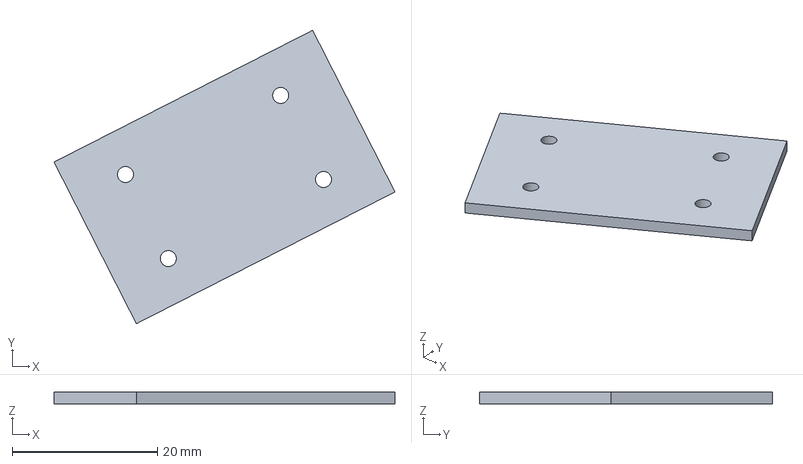
[picture p214: CAD file, 2026-09-08]
docs/v16/boards/audio_board.step
47.0 x 40.4 x 1.60 mm
