Ryan365Apps/spotify-knob/docs/v16/parts/board_spacer.step

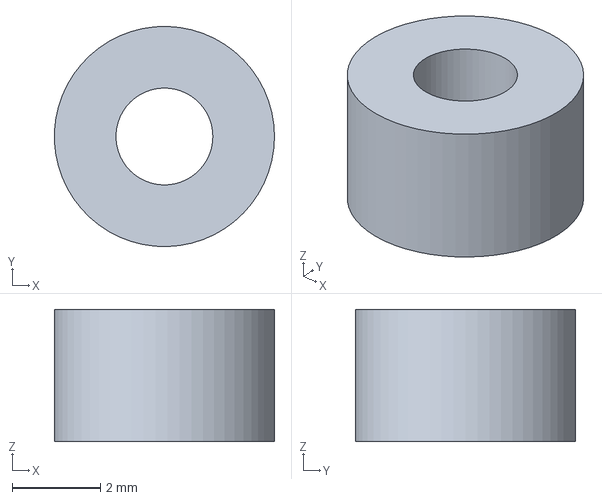
[picture p215: CAD file, 2026-09-08]
docs/v16/parts/board_spacer.step
5.00 x 5.00 x 3.00 mm
