Ryan365Apps/spotify-knob/design/cad/bought-parts/step/Vishay_VEML7700-TR_ambient_light_sensor.step

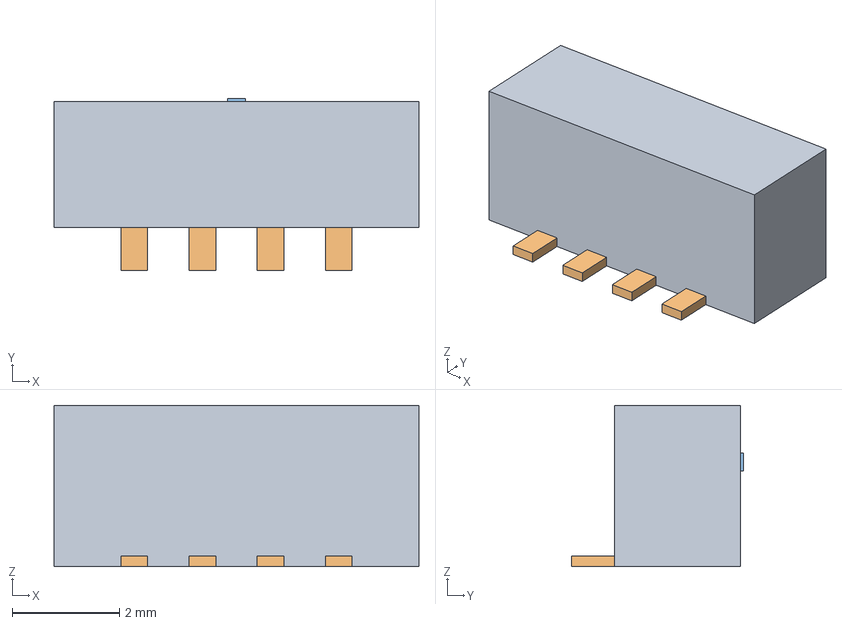
[picture p216: CAD file, 2026-09-04]
design/cad/bought-parts/step/Vishay_VEML7700-TR_ambient_light_sensor.step
6.80 x 3.20 x 3.00 mm
package
leads_4x
sensitive_area_0p336sq
