Ryan365Apps/spotify-knob/docs/v16/boards/drv_board.step

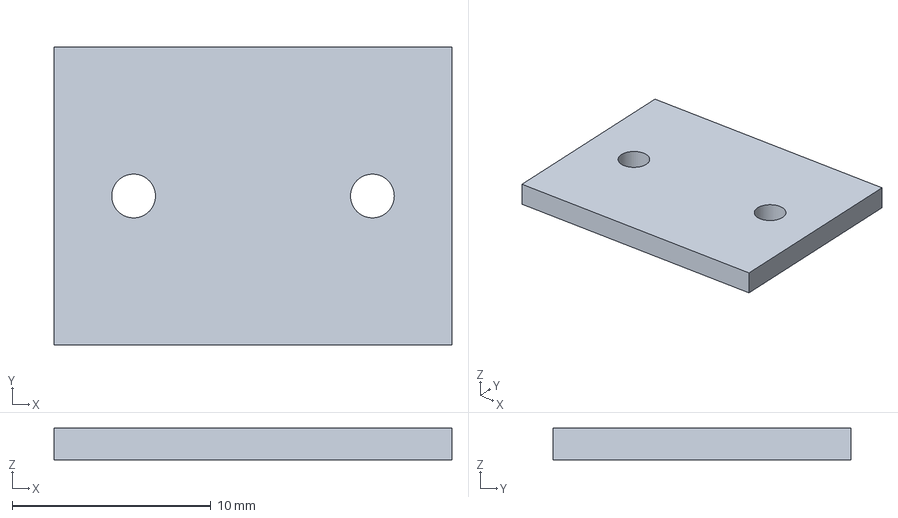
[picture p217: CAD file, 2026-09-08]
docs/v16/boards/drv_board.step
20.0 x 15.0 x 1.60 mm
