Ryan365Apps/spotify-knob/docs/v16/parts/halo_diffuser_OPAL.step

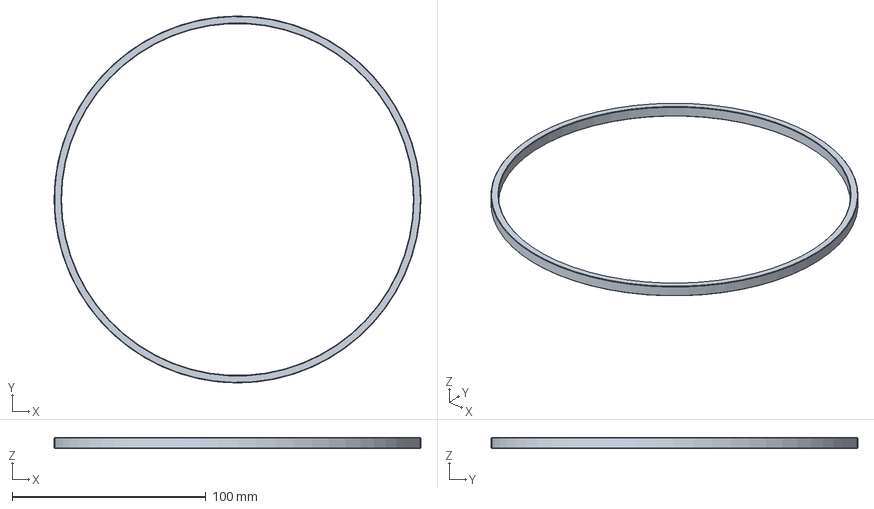
[picture p218: CAD file, 2026-09-08]
docs/v16/parts/halo_diffuser_OPAL.step
189.4 x 189.4 x 5.70 mm
