Ryan365Apps/spotify-knob/design/cad/bought-parts/step/JD-Power_MY-3514C_2804_gimbal_motor.step

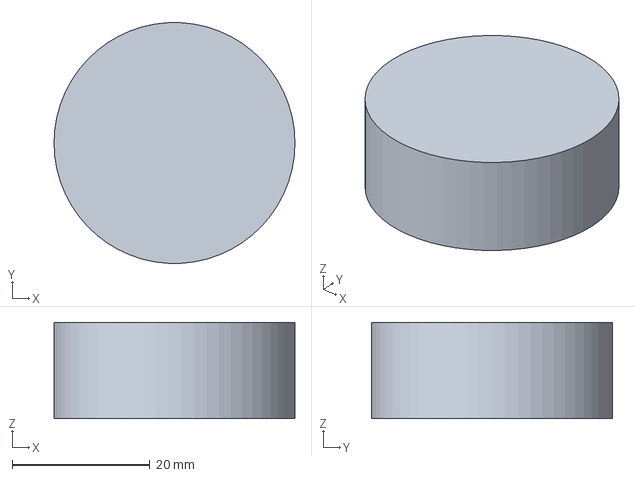
[picture p219: CAD file, 2026-09-04]
design/cad/bought-parts/step/JD-Power_MY-3514C_2804_gimbal_motor.step
35.0 x 34.9 x 14.0 mm
