Ryan365Apps/spotify-knob/docs/v16/boards/bob_board.step

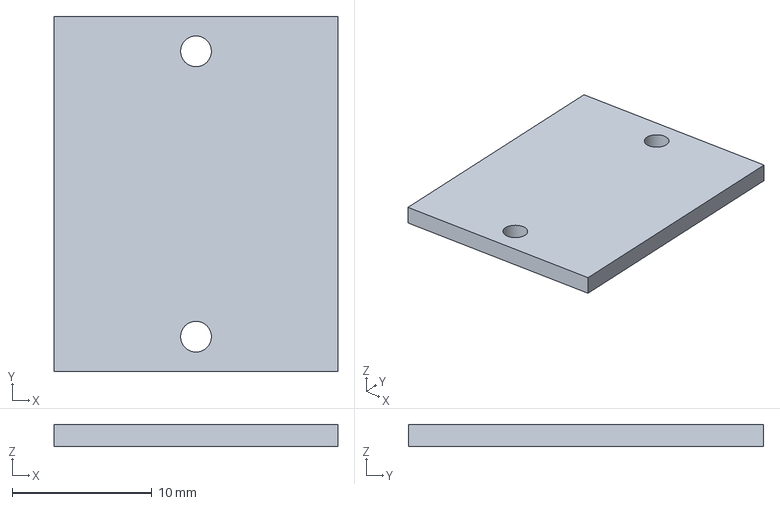
[picture p220: CAD file, 2026-09-08]
docs/v16/boards/bob_board.step
20.3 x 25.4 x 1.60 mm
