Ryan365Apps/spotify-knob/docs/v16/parts/tray_keeper.step

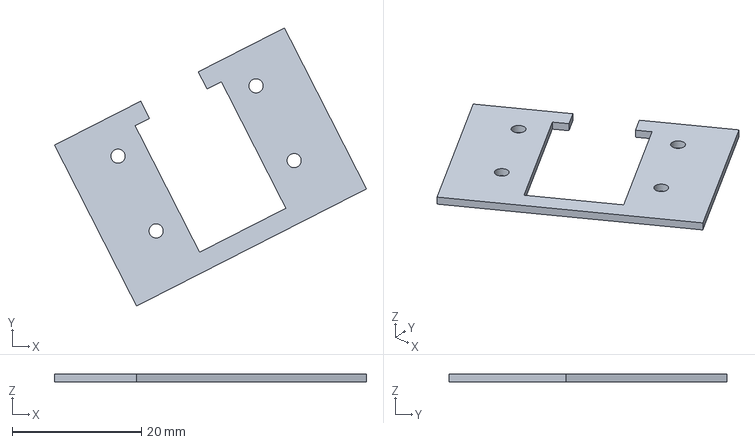
[picture p221: CAD file, 2026-09-08]
docs/v16/parts/tray_keeper.step
48.4 x 43.1 x 1.20 mm
