Ryan365Apps/spotify-knob/design/cad/bought-parts/step/TMC6300-LA-T_QFN20_3x3.step

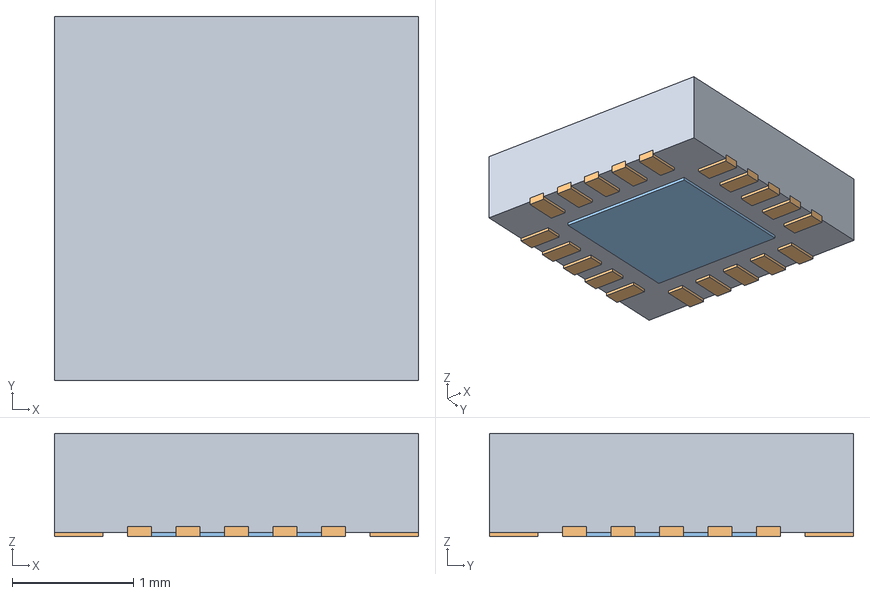
[picture p222: CAD file, 2026-09-04]
design/cad/bought-parts/step/TMC6300-LA-T_QFN20_3x3.step
3.00 x 3.00 x 0.85 mm
leads_20x
thermal_pad
