Ryan365Apps/spotify-knob/docs/v16/boards/barrel_board.step

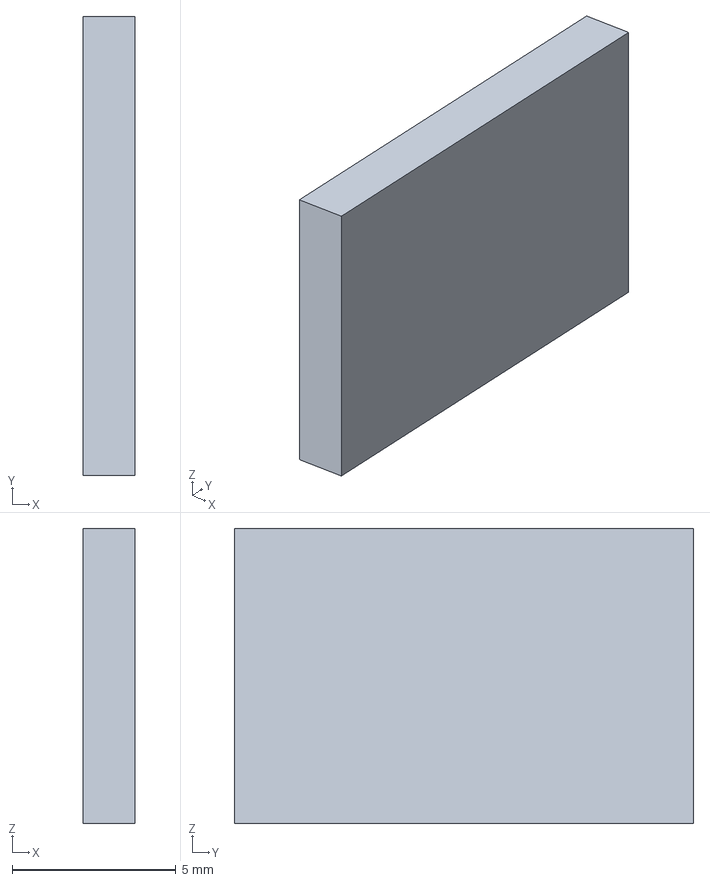
[picture p223: CAD file, 2026-09-08]
docs/v16/boards/barrel_board.step
1.60 x 14.0 x 9.00 mm
