Ryan365Apps/spotify-knob/docs/v16/parts/halo_liner.step

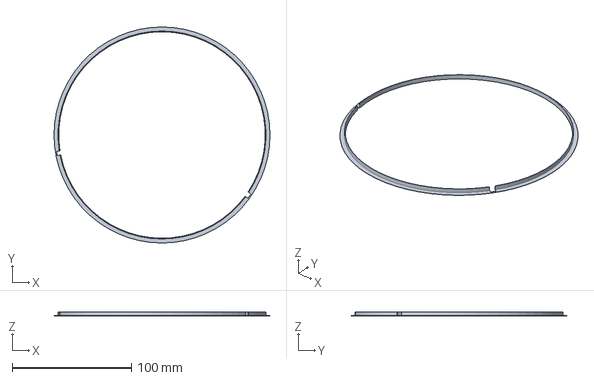
[picture p224: CAD file, 2026-09-08]
docs/v16/parts/halo_liner.step
181.0 x 181.0 x 3.40 mm
