Ryan365Apps/spotify-knob/design/cad/bought-parts/step/MT6701CT-STD_SOP8.step

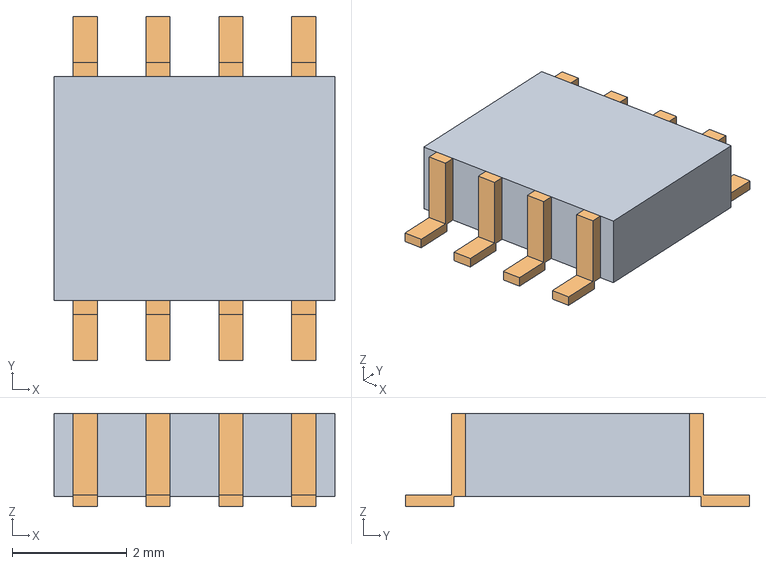
[picture p225: CAD file, 2026-09-04]
design/cad/bought-parts/step/MT6701CT-STD_SOP8.step
4.90 x 6.00 x 1.62 mm
leads_8x
