Ryan365Apps/spotify-knob/docs/v16/boards/connect_board.step

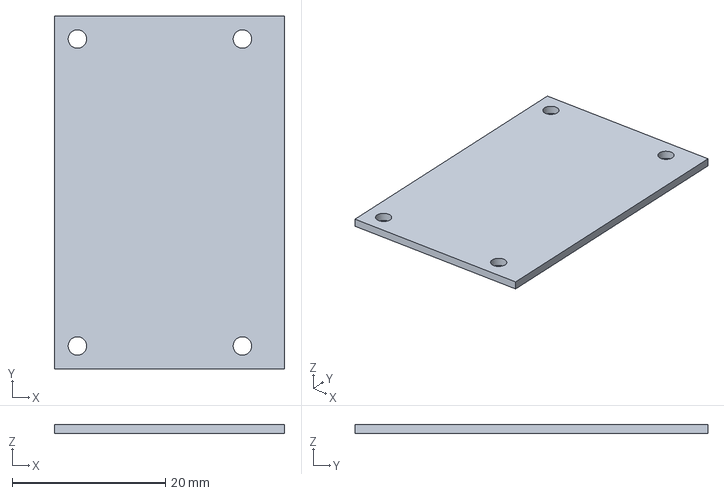
[picture p226: CAD file, 2026-09-08]
docs/v16/boards/connect_board.step
30.0 x 46.0 x 1.20 mm
