Ryan365Apps/spotify-knob/docs/v16/parts/knob_body.step

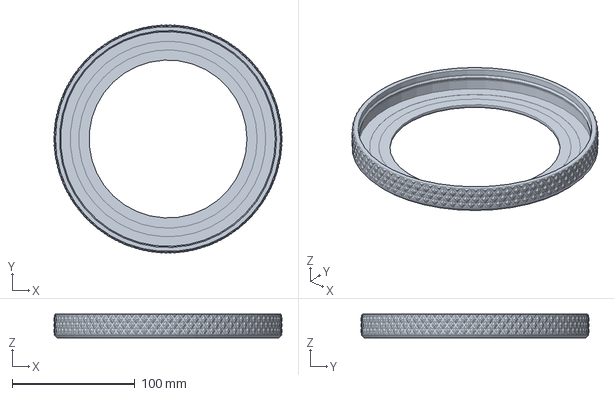
[picture p227: CAD file, 2026-09-08]
docs/v16/parts/knob_body.step
185.4 x 185.4 x 19.5 mm
