Ryan365Apps/spotify-knob/design/cad/bought-parts/step/TI_DRV2605L_VSSOP10_DGS.step

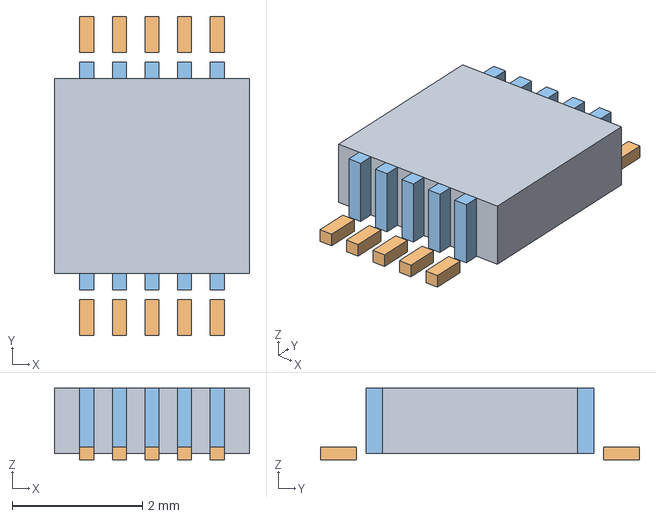
[picture p228: CAD file, 2026-09-04]
design/cad/bought-parts/step/TI_DRV2605L_VSSOP10_DGS.step
3.00 x 4.90 x 1.10 mm
leads_10x
