Ryan365Apps/spotify-knob/docs/v16/boards/encoder_board.step

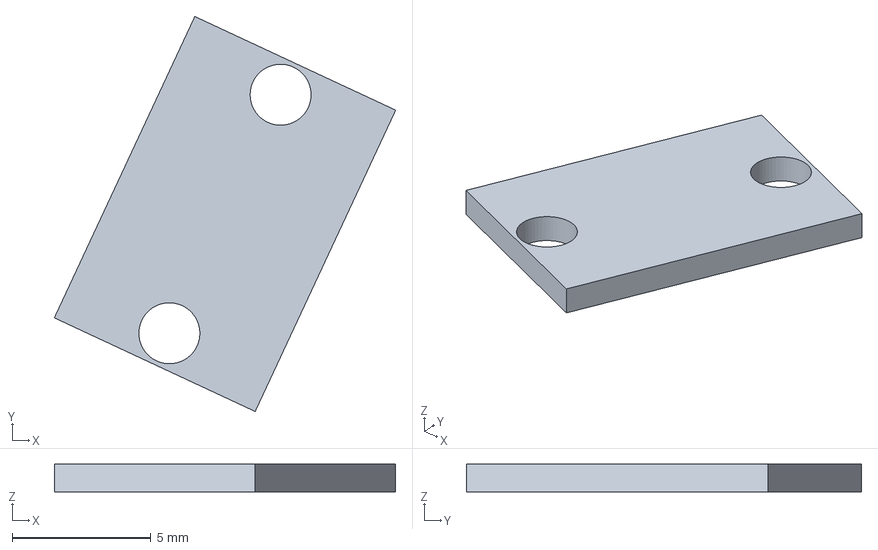
[picture p229: CAD file, 2026-09-08]
docs/v16/boards/encoder_board.step
12.3 x 14.3 x 1.00 mm
