Ryan365Apps/spotify-knob/docs/v16/parts/speaker_cradle.step

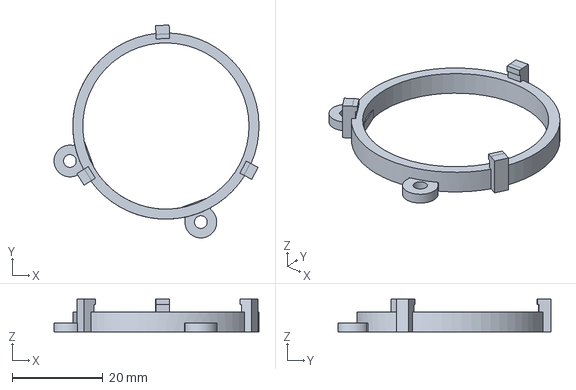
[picture p230: CAD file, 2026-09-08]
docs/v16/parts/speaker_cradle.step
45.1 x 46.9 x 7.25 mm
