Ryan365Apps/spotify-knob/design/cad/bought-parts/step/MT6701_diametric_magnet_D6x2p5.step

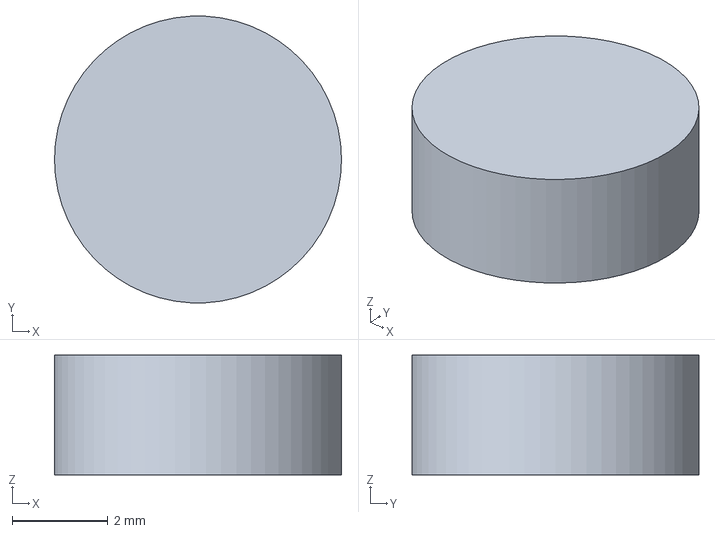
[picture p231: CAD file, 2026-09-04]
design/cad/bought-parts/step/MT6701_diametric_magnet_D6x2p5.step
6.00 x 5.99 x 2.50 mm
