Ryan365Apps/spotify-knob/docs/v16/parts/encoder_shim.step

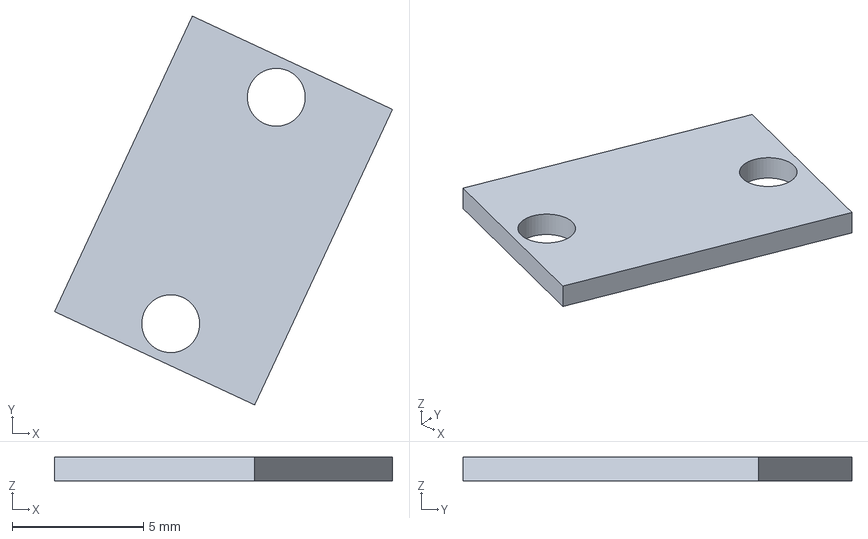
[picture p232: CAD file, 2026-09-08]
docs/v16/parts/encoder_shim.step
12.9 x 14.8 x 0.9 mm
