Ryan365Apps/spotify-knob/design/cad/bought-parts/step/TI_DRV2605L_DSBGA9_YZF.step

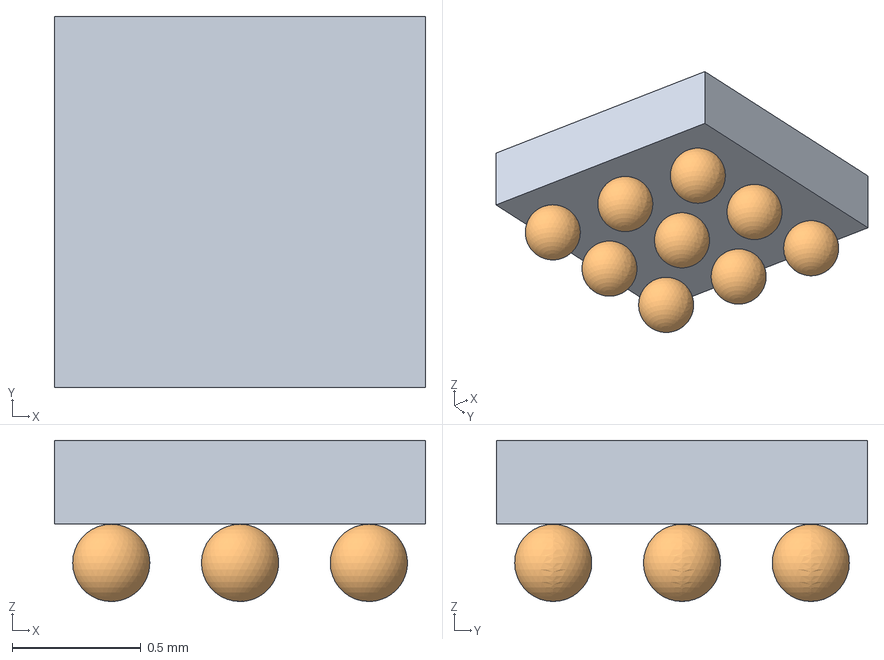
[picture p233: CAD file, 2026-09-04]
design/cad/bought-parts/step/TI_DRV2605L_DSBGA9_YZF.step
1.44 x 1.44 x 0.625 mm
die
balls_9x
