Ryan365Apps/spotify-knob/docs/v16/parts/hood_lid.step

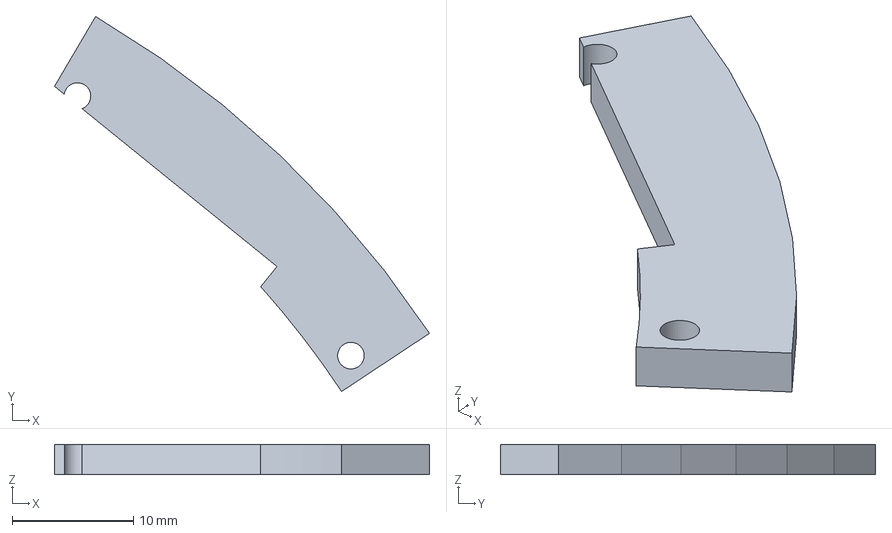
[picture p234: CAD file, 2026-09-08]
docs/v16/parts/hood_lid.step
31.0 x 31.0 x 2.50 mm
