Ryan365Apps/spotify-knob/design/cad/bought-parts/step/Switchcraft_35RAPC4BH3_jack_3p5mm.step

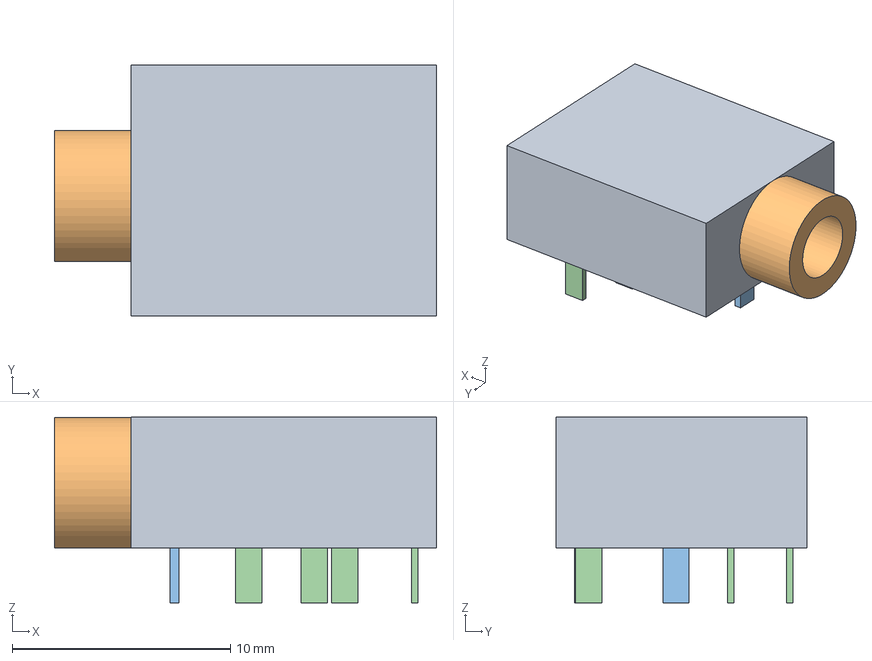
[picture p235: CAD file, 2026-09-04]
design/cad/bought-parts/step/Switchcraft_35RAPC4BH3_jack_3p5mm.step
17.5 x 11.5 x 8.50 mm
bushing_M6x0p5
pins_5x
