Ryan365Apps/spotify-knob/docs/v16/parts/carriage.step

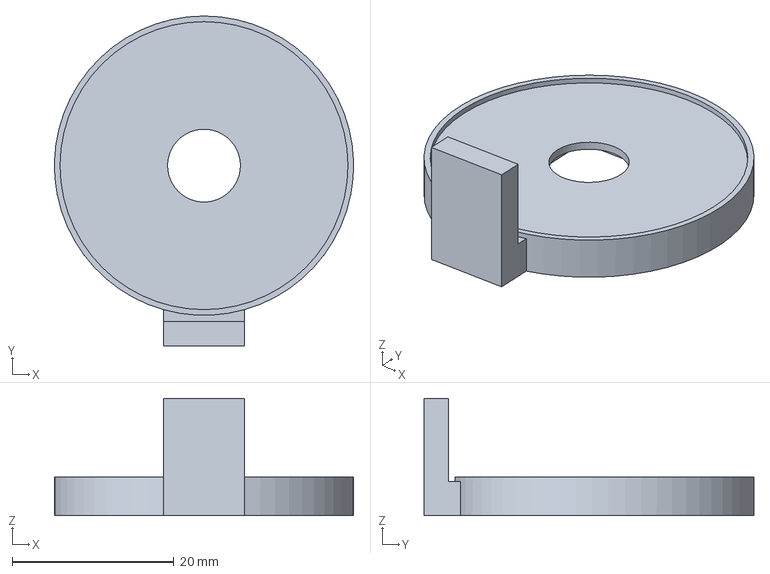
[picture p236: CAD file, 2026-09-08]
docs/v16/parts/carriage.step
37.0 x 40.8 x 14.5 mm
