Ryan365Apps/spotify-knob/design/cad/bought-parts/step/623ZZ_bearing_3x10x4.step

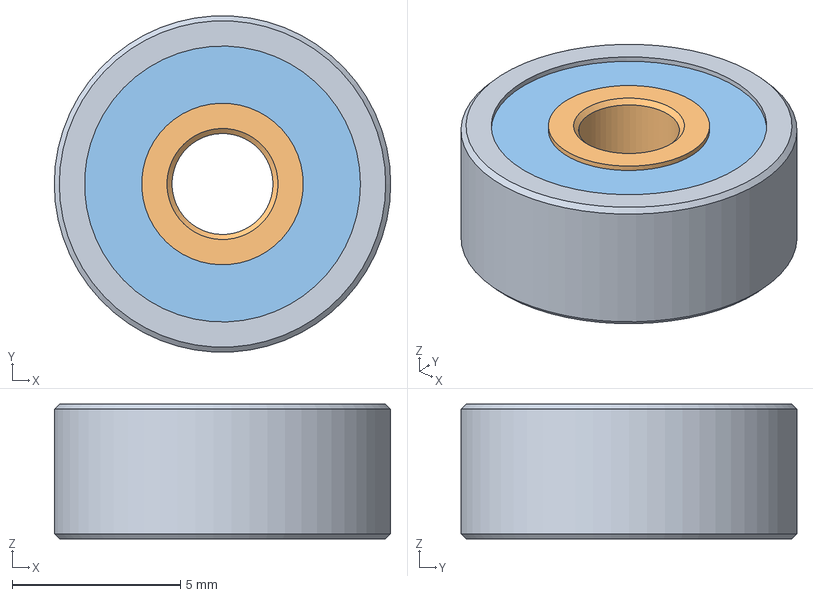
[picture p237: CAD file, 2026-09-04]
design/cad/bought-parts/step/623ZZ_bearing_3x10x4.step
10.0 x 9.99 x 4.00 mm
outer_ring
inner_ring
shield_top
shield_bottom
