Ryan365Apps/spotify-knob/docs/v16/parts/servo_mount.step

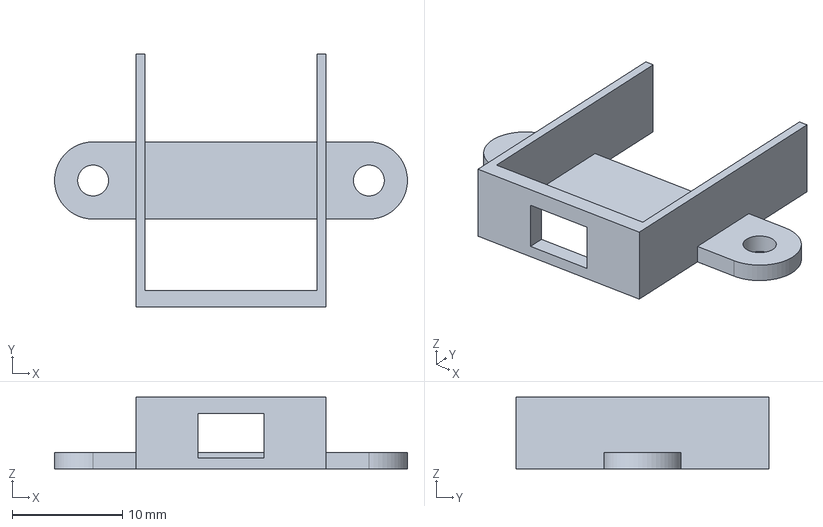
[picture p238: CAD file, 2026-09-08]
docs/v16/parts/servo_mount.step
32.0 x 22.9 x 6.50 mm
