Ryan365Apps/spotify-knob/design/cad/bought-parts/step/Soberton_SP-4005-1_speaker_D40.step

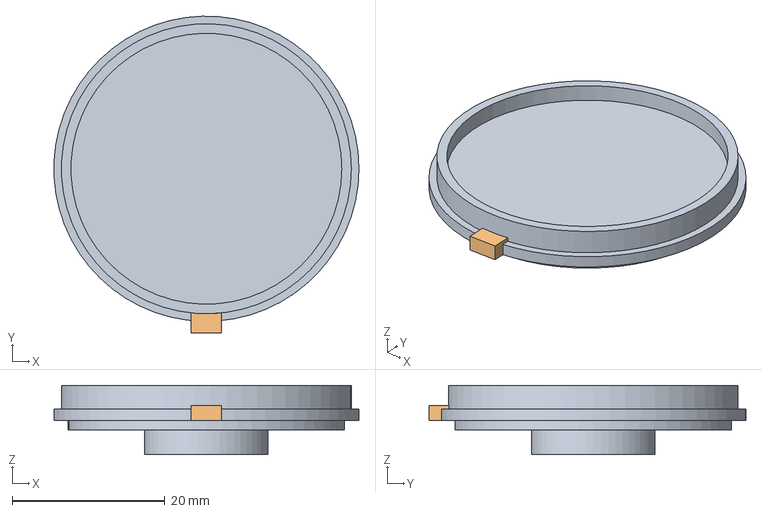
[picture p239: CAD file, 2026-09-04]
design/cad/bought-parts/step/Soberton_SP-4005-1_speaker_D40.step
40.0 x 41.5 x 9.05 mm
speaker
lead_exit_keepout_ASSUMED
