Ryan365Apps/spotify-knob/docs/v16/parts/connect_bracket.step

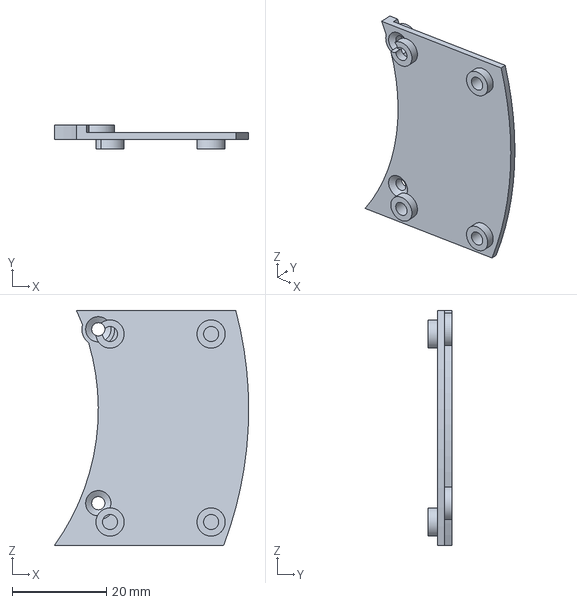
[picture p240: CAD file, 2026-09-08]
docs/v16/parts/connect_bracket.step
41.4 x 5.00 x 50.0 mm
