Ryan365Apps/spotify-knob/design/cad/bought-parts/step/GCT_USB4520-03-0-A_usbc_midmount.step

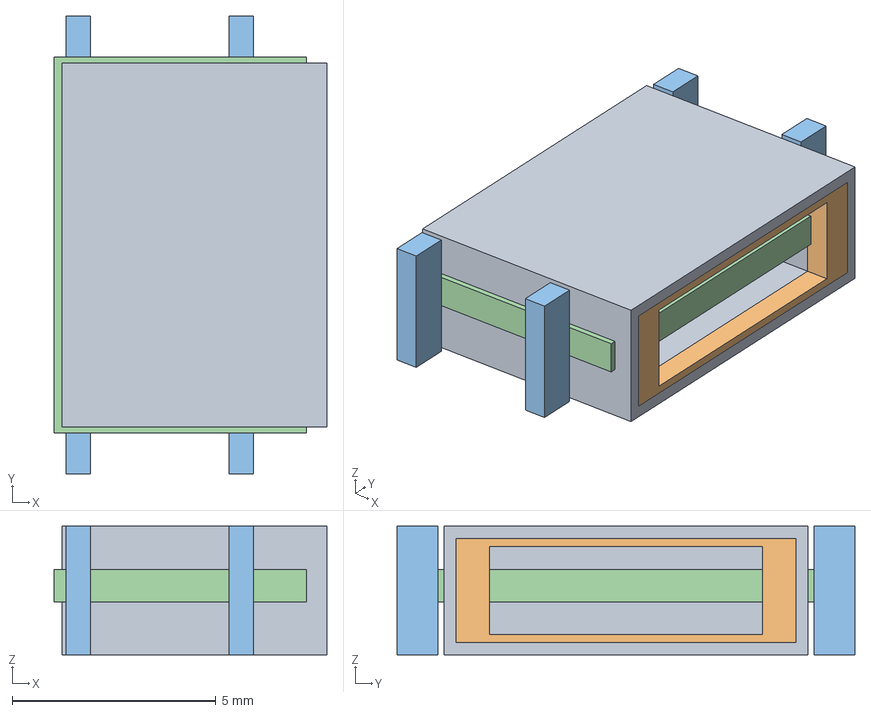
[picture p241: CAD file, 2026-09-04]
design/cad/bought-parts/step/GCT_USB4520-03-0-A_usbc_midmount.step
6.70 x 11.2 x 3.16 mm
shell_mating_face
solder_legs_4x
board_cutout_REQUIRED
