Ryan365Apps/spotify-knob/docs/v16/parts/closing_plate_AL.step

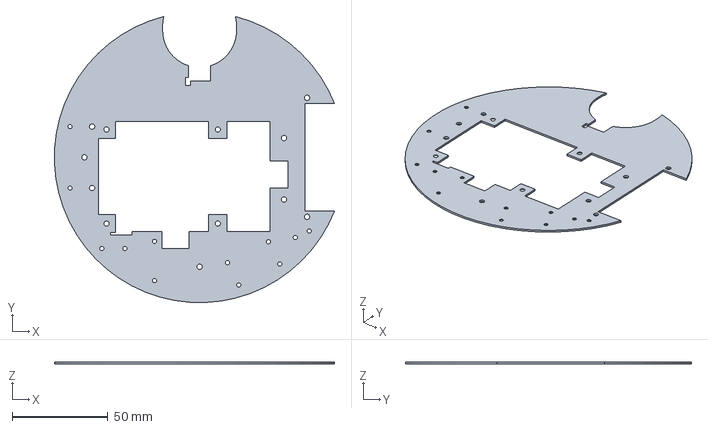
[picture p242: CAD file, 2026-09-08]
docs/v16/parts/closing_plate_AL.step
146.0 x 149.0 x 1.00 mm
