Ryan365Apps/spotify-knob/design/cad/bought-parts/step/ESS_ES9219Q_WQFN40_5x5.step

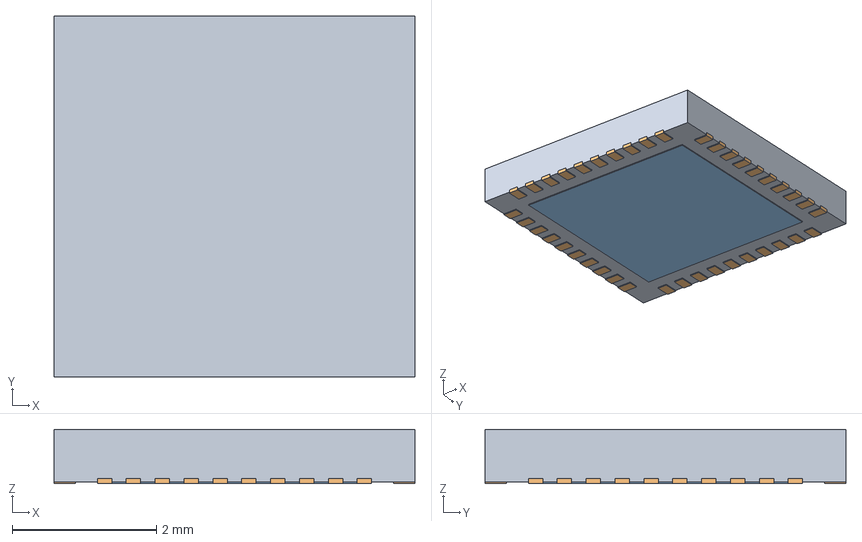
[picture p243: CAD file, 2026-09-04]
design/cad/bought-parts/step/ESS_ES9219Q_WQFN40_5x5.step
5.00 x 5.00 x 0.75 mm
leads_40x
thermal_pad
