Ryan365Apps/spotify-knob/docs/v16/parts/wheel_block.step

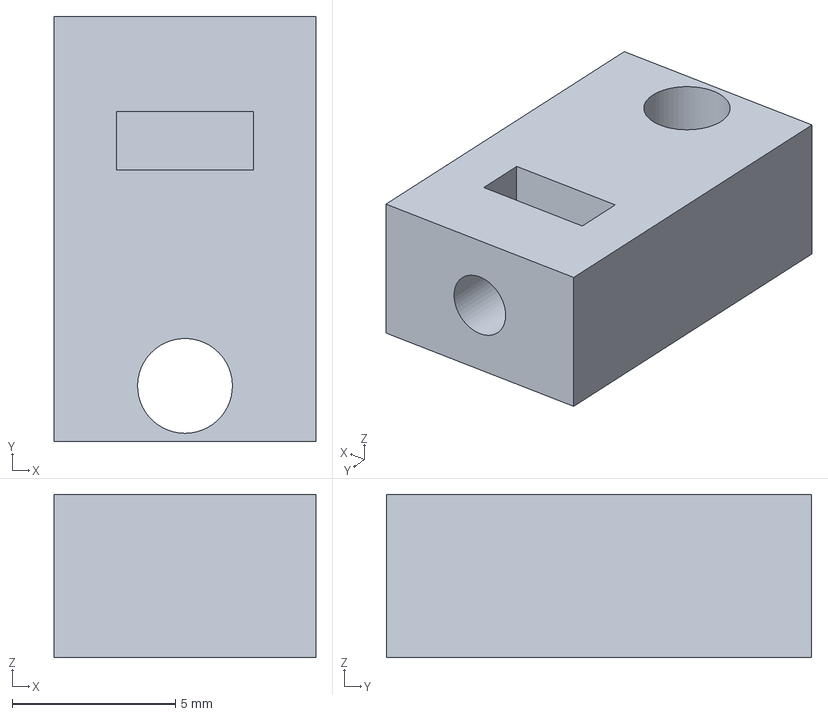
[picture p244: CAD file, 2026-09-08]
docs/v16/parts/wheel_block.step
8.00 x 13.0 x 5.00 mm
