Ryan365Apps/spotify-knob/design/cad/bought-parts/step/OPSCO_SK6812SIDE-A_led_4020.step

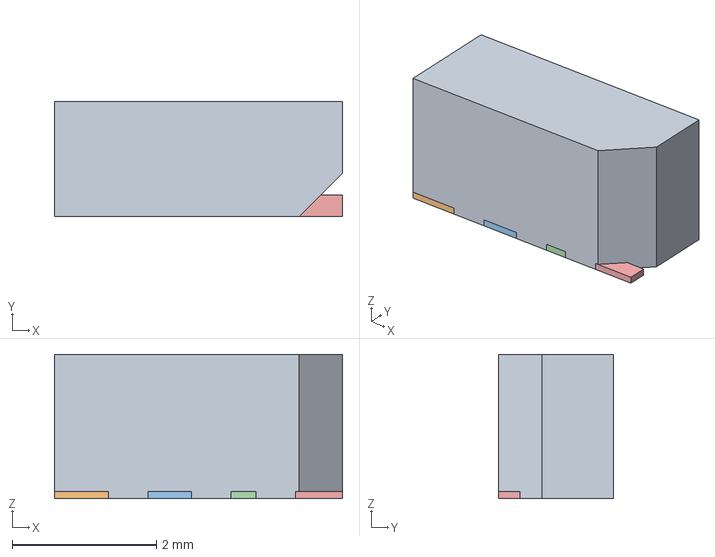
[picture p245: CAD file, 2026-09-04]
design/cad/bought-parts/step/OPSCO_SK6812SIDE-A_led_4020.step
4.00 x 1.60 x 2.00 mm
package
terminals_4x
