Ryan365Apps/spotify-knob/docs/v16/parts/mcu_tray.step

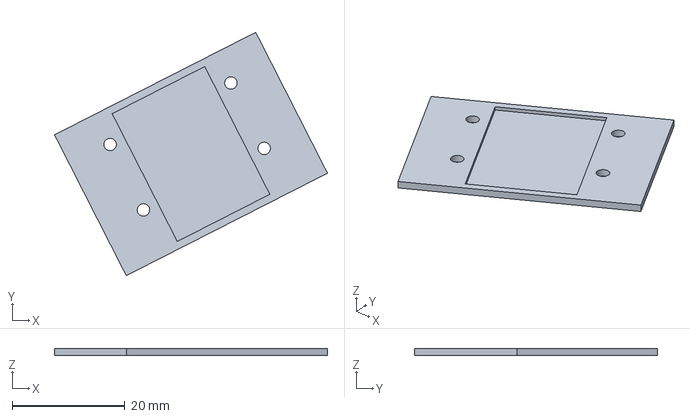
[picture p246: CAD file, 2026-09-08]
docs/v16/parts/mcu_tray.step
48.4 x 43.1 x 1.20 mm
