Ryan365Apps/spotify-knob/docs/v16/parts/blower_saddle.step

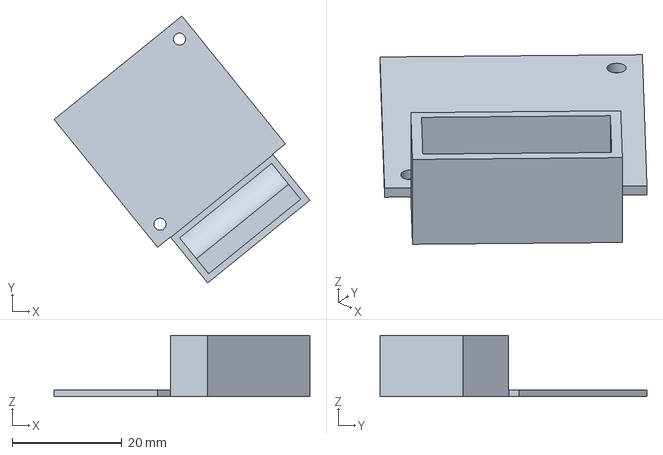
[picture p247: CAD file, 2026-09-08]
docs/v16/parts/blower_saddle.step
46.7 x 48.7 x 11.2 mm
