Ryan365Apps/spotify-knob/docs/v16/parts/drive_collar.step

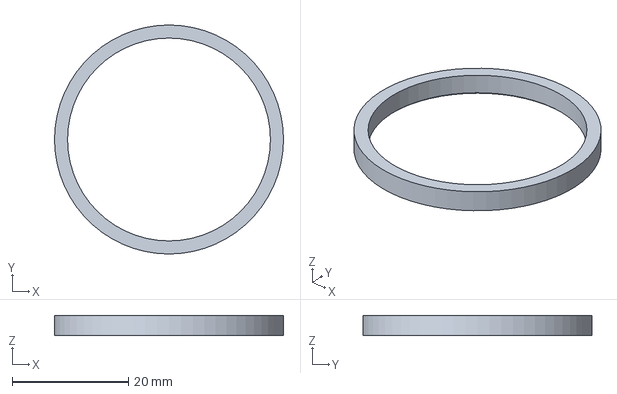
[picture p248: CAD file, 2026-09-08]
docs/v16/parts/drive_collar.step
39.4 x 39.4 x 3.50 mm
