Ryan365Apps/spotify-knob/docs/v16/parts/port_face.step

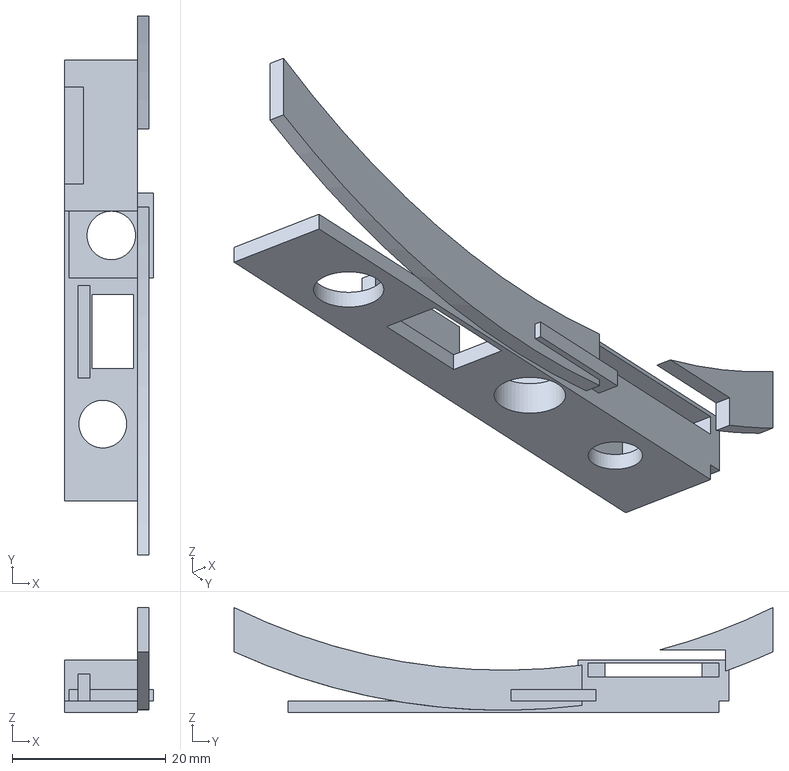
[picture p249: CAD file, 2026-09-08]
docs/v16/parts/port_face.step
11.6 x 70.0 x 13.6 mm
