Ryan365Apps/spotify-knob/(list of files, cad)

Other CAD files:
design/artwork/blender/v9/the60_v9_free_spin.obj
design/artwork/blender/the60_lineart.blend
design/artwork/blender/the60_teaser_v15.blend
design/artwork/blender/the60_teaser_v9.blend
design/cad/bought-parts/step/_superseded/iPower_GM3506_gimbal_motor.step
docs/v10/the60_v10/boards/adapter_board.step
docs/v10/the60_v10/boards/audio_board.step
docs/v10/the60_v10/boards/barrel_board.step
docs/v10/the60_v10/boards/commutation_board.step
docs/v10/the60_v10/boards/encoder_board.step
docs/v10/the60_v10/boards/jack_board.step
docs/v10/the60_v10/boards/led_flex.step
docs/v10/the60_v10/boards/light_board.step
docs/v10/the60_v10/boards/motion_board.step
docs/v10/the60_v10/boards/usbc_board.step
docs/v10/the60_v10/parts/base_plate_STEEL.step
docs/v10/the60_v10/parts/base_plate_STEEL.stl
docs/v10/the60_v10/parts/bush_0.step
docs/v10/the60_v10/parts/carriage.step
docs/v10/the60_v10/parts/carriage.stl
docs/v10/the60_v10/parts/collar_0.step
docs/v10/the60_v10/parts/deck.step
docs/v10/the60_v10/parts/deck.stl
docs/v10/the60_v10/parts/halo_diffuser.step
docs/v10/the60_v10/parts/halo_diffuser.stl
docs/v10/the60_v10/parts/internal_structure.step
docs/v10/the60_v10/parts/internal_structure.stl
docs/v10/the60_v10/parts/knob_body.step
docs/v10/the60_v10/parts/knob_body.stl
docs/v10/the60_v10/parts/port_face.step
docs/v10/the60_v10/parts/port_face.stl
docs/v10/the60_v10/parts/servo_mount.step
docs/v10/the60_v10/parts/servo_mount.stl
docs/v10/the60_v10/parts/speaker_cradle.step
docs/v10/the60_v10/parts/speaker_cradle.stl
docs/v10/the60_v10/the60_v10/boards/adapter_board.step
docs/v10/the60_v10/the60_v10/boards/audio_board.step
docs/v10/the60_v10/the60_v10/boards/barrel_board.step
docs/v10/the60_v10/the60_v10/boards/commutation_board.step
docs/v10/the60_v10/the60_v10/boards/encoder_board.step
docs/v10/the60_v10/the60_v10/boards/jack_board.step
docs/v10/the60_v10/the60_v10/boards/led_flex.step
docs/v10/the60_v10/the60_v10/boards/light_board.step
docs/v10/the60_v10/the60_v10/boards/motion_board.step
docs/v10/the60_v10/the60_v10/boards/usbc_board.step
docs/v10/the60_v10/the60_v10/parts/base_plate_STEEL.step
docs/v10/the60_v10/the60_v10/parts/base_plate_STEEL.stl
docs/v10/the60_v10/the60_v10/parts/bush_0.step
docs/v10/the60_v10/the60_v10/parts/carriage.step
docs/v10/the60_v10/the60_v10/parts/carriage.stl
docs/v10/the60_v10/the60_v10/parts/collar_0.step
docs/v10/the60_v10/the60_v10/parts/deck.step
docs/v10/the60_v10/the60_v10/parts/deck.stl
docs/v10/the60_v10/the60_v10/parts/halo_diffuser.step
docs/v10/the60_v10/the60_v10/parts/halo_diffuser.stl
docs/v10/the60_v10/the60_v10/parts/internal_structure.step
docs/v10/the60_v10/the60_v10/parts/internal_structure.stl
docs/v10/the60_v10/the60_v10/parts/knob_body.step
docs/v10/the60_v10/the60_v10/parts/knob_body.stl
docs/v10/the60_v10/the60_v10/parts/port_face.step
docs/v10/the60_v10/the60_v10/parts/port_face.stl
docs/v10/the60_v10/the60_v10/parts/servo_mount.step
docs/v10/the60_v10/the60_v10/parts/servo_mount.stl
docs/v10/the60_v10/the60_v10/parts/speaker_cradle.step
docs/v10/the60_v10/the60_v10/parts/speaker_cradle.stl
docs/v11/the60_v11/boards/adapter_board.step
docs/v11/the60_v11/boards/audio_board.step
docs/v11/the60_v11/boards/barrel_board.step
docs/v11/the60_v11/boards/commutation_board.step
docs/v11/the60_v11/boards/encoder_board.step
docs/v11/the60_v11/boards/jack_board.step
docs/v11/the60_v11/boards/light_board.step
docs/v11/the60_v11/boards/motion_board.step
docs/v11/the60_v11/boards/usbc_board.step
docs/v11/the60_v11/parts/base_plate_AL.step
docs/v11/the60_v11/parts/base_plate_AL.stl
docs/v11/the60_v11/parts/bush_0.step
docs/v11/the60_v11/parts/carriage.step
docs/v11/the60_v11/parts/carriage.stl
docs/v11/the60_v11/parts/closing_plate_AL.step
docs/v11/the60_v11/parts/closing_plate_AL.stl
docs/v11/the60_v11/parts/collar_0.step
docs/v11/the60_v11/parts/halo_diffuser.step
docs/v11/the60_v11/parts/internal_structure.step
docs/v11/the60_v11/parts/internal_structure.stl
docs/v11/the60_v11/parts/knob_body.step
docs/v11/the60_v11/parts/knob_body.stl
docs/v11/the60_v11/parts/port_face.step
docs/v11/the60_v11/parts/rim_ring_STEEL.step
docs/v11/the60_v11/parts/rim_ring_STEEL.stl
docs/v11/the60_v11/parts/servo_mount.step
docs/v11/the60_v11/parts/servo_mount.stl
docs/v11/the60_v11/parts/speaker_cradle.step
docs/v11/the60_v11/parts/speaker_cradle.stl
docs/v11/the60_v11/the60_v11/boards/adapter_board.step
docs/v11/the60_v11/the60_v11/boards/audio_board.step
docs/v11/the60_v11/the60_v11/boards/barrel_board.step
docs/v11/the60_v11/the60_v11/boards/commutation_board.step
docs/v11/the60_v11/the60_v11/boards/encoder_board.step
docs/v11/the60_v11/the60_v11/boards/jack_board.step
docs/v11/the60_v11/the60_v11/boards/light_board.step
docs/v11/the60_v11/the60_v11/boards/motion_board.step
docs/v11/the60_v11/the60_v11/boards/usbc_board.step
docs/v11/the60_v11/the60_v11/parts/base_plate_AL.step
docs/v11/the60_v11/the60_v11/parts/base_plate_AL.stl
docs/v11/the60_v11/the60_v11/parts/bush_0.step
docs/v11/the60_v11/the60_v11/parts/carriage.step
docs/v11/the60_v11/the60_v11/parts/carriage.stl
docs/v11/the60_v11/the60_v11/parts/closing_plate_AL.step
docs/v11/the60_v11/the60_v11/parts/closing_plate_AL.stl
docs/v11/the60_v11/the60_v11/parts/collar_0.step
docs/v11/the60_v11/the60_v11/parts/halo_diffuser.step
docs/v11/the60_v11/the60_v11/parts/internal_structure.step
docs/v11/the60_v11/the60_v11/parts/internal_structure.stl
docs/v11/the60_v11/the60_v11/parts/knob_body.step
docs/v11/the60_v11/the60_v11/parts/knob_body.stl
docs/v11/the60_v11/the60_v11/parts/port_face.step
docs/v11/the60_v11/the60_v11/parts/rim_ring_STEEL.step
docs/v11/the60_v11/the60_v11/parts/rim_ring_STEEL.stl
docs/v11/the60_v11/the60_v11/parts/servo_mount.step
docs/v11/the60_v11/the60_v11/parts/servo_mount.stl
docs/v11/the60_v11/the60_v11/parts/speaker_cradle.step
docs/v11/the60_v11/the60_v11/parts/speaker_cradle.stl
docs/v12/the60_v12/boards/adapter_board.step
docs/v12/the60_v12/boards/audio_board.step
docs/v12/the60_v12/boards/barrel_board.step
docs/v12/the60_v12/boards/commutation_board.step
docs/v12/the60_v12/boards/connect_board.step
docs/v12/the60_v12/boards/encoder_board.step
docs/v12/the60_v12/boards/jack_board.step
docs/v12/the60_v12/boards/light_board.step
docs/v12/the60_v12/boards/motion_board.step
docs/v12/the60_v12/boards/usbc_board.step
docs/v12/the60_v12/parts/base_plate_AL.step
docs/v12/the60_v12/parts/bush_0.step
docs/v12/the60_v12/parts/carriage.step
docs/v12/the60_v12/parts/closing_plate_AL.step
docs/v12/the60_v12/parts/collar_0.step
docs/v12/the60_v12/parts/connect_bracket.step
docs/v12/the60_v12/parts/halo_diffuser.step
docs/v12/the60_v12/parts/internal_structure.step
docs/v12/the60_v12/parts/internal_structure.stl
docs/v12/the60_v12/parts/knob_body.step
docs/v12/the60_v12/parts/knob_body.stl
docs/v12/the60_v12/parts/port_face.step
docs/v12/the60_v12/parts/rim_ring_STEEL.step
docs/v12/the60_v12/parts/servo_mount.step
docs/v12/the60_v12/parts/speaker_cradle.step
docs/v13/the60_v13/boards/adapter_board.step
docs/v13/the60_v13/boards/audio_board.step
docs/v13/the60_v13/boards/barrel_board.step
docs/v13/the60_v13/boards/commutation_board.step
docs/v13/the60_v13/boards/connect_board.step
docs/v13/the60_v13/boards/encoder_board.step
docs/v13/the60_v13/boards/jack_board.step
docs/v13/the60_v13/boards/light_board.step
docs/v13/the60_v13/boards/motion_board.step
docs/v13/the60_v13/boards/usbc_board.step
docs/v13/the60_v13/parts/base_plate_AL.step
docs/v13/the60_v13/parts/base_plate_AL.stl
docs/v13/the60_v13/parts/bush_0.step
docs/v13/the60_v13/parts/carriage.step
docs/v13/the60_v13/parts/carriage.stl
docs/v13/the60_v13/parts/closing_plate_AL.step
docs/v13/the60_v13/parts/closing_plate_AL.stl
docs/v13/the60_v13/parts/collar_0.step
docs/v13/the60_v13/parts/connect_bracket.step
docs/v13/the60_v13/parts/halo_diffuser.step
docs/v13/the60_v13/parts/internal_structure.step
docs/v13/the60_v13/parts/internal_structure.stl
docs/v13/the60_v13/parts/knob_body.step
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
