Ryan365Apps/spotify-knob/docs/v7/00-assembly.pdf

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
A | A

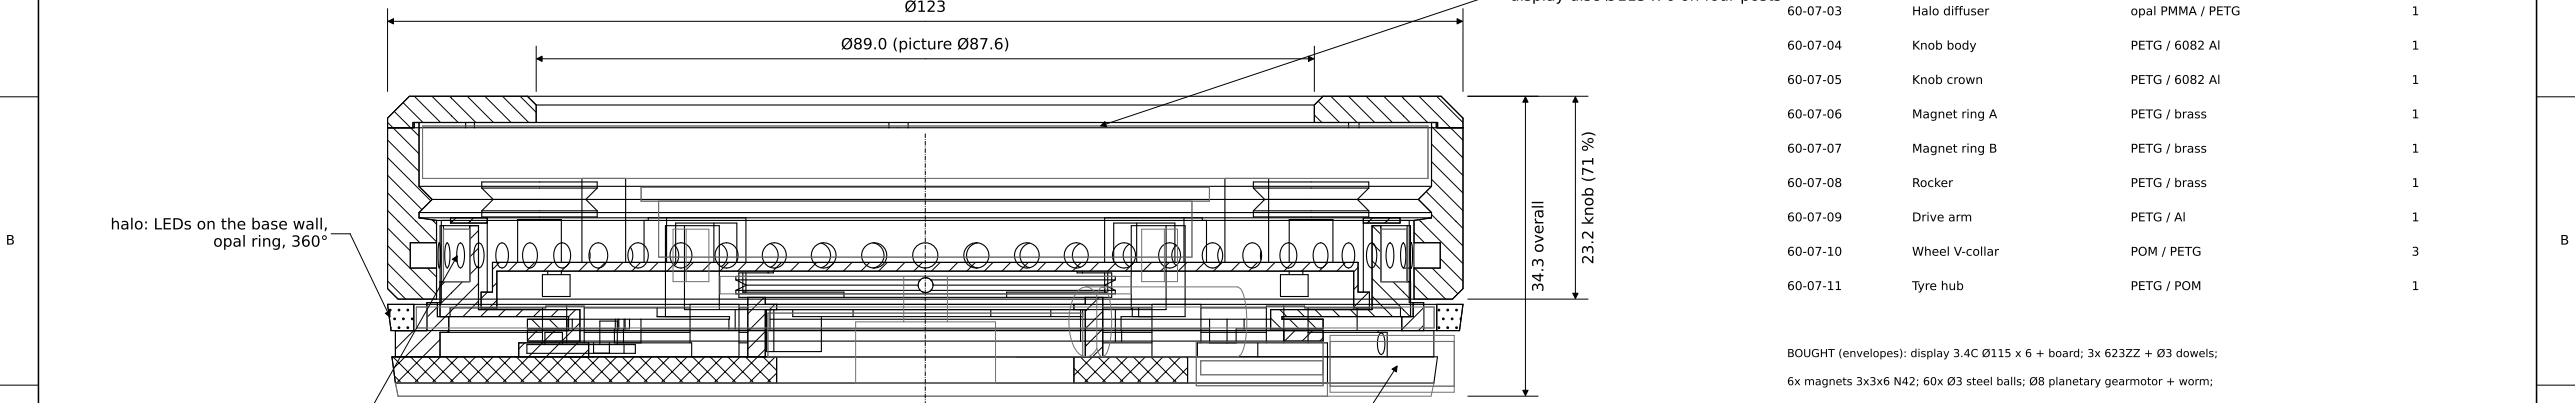
[picture p250: figure]
34.3 overall; 23.2 knob (71 %); Ø89.0 (picture Ø87.6); halo: LEDs on the base wall, opal ring, 360°; Halo diffuser; opal PMMA / PETG; Knob body; PETG / 6082 Al; Knob crown; Magnet ring A; PETG / brass; Magnet ring B; Rocker; Drive arm; PETG / Al; Wheel V-collar; POM / PETG; Tyre hub; PETG / POM

C | C

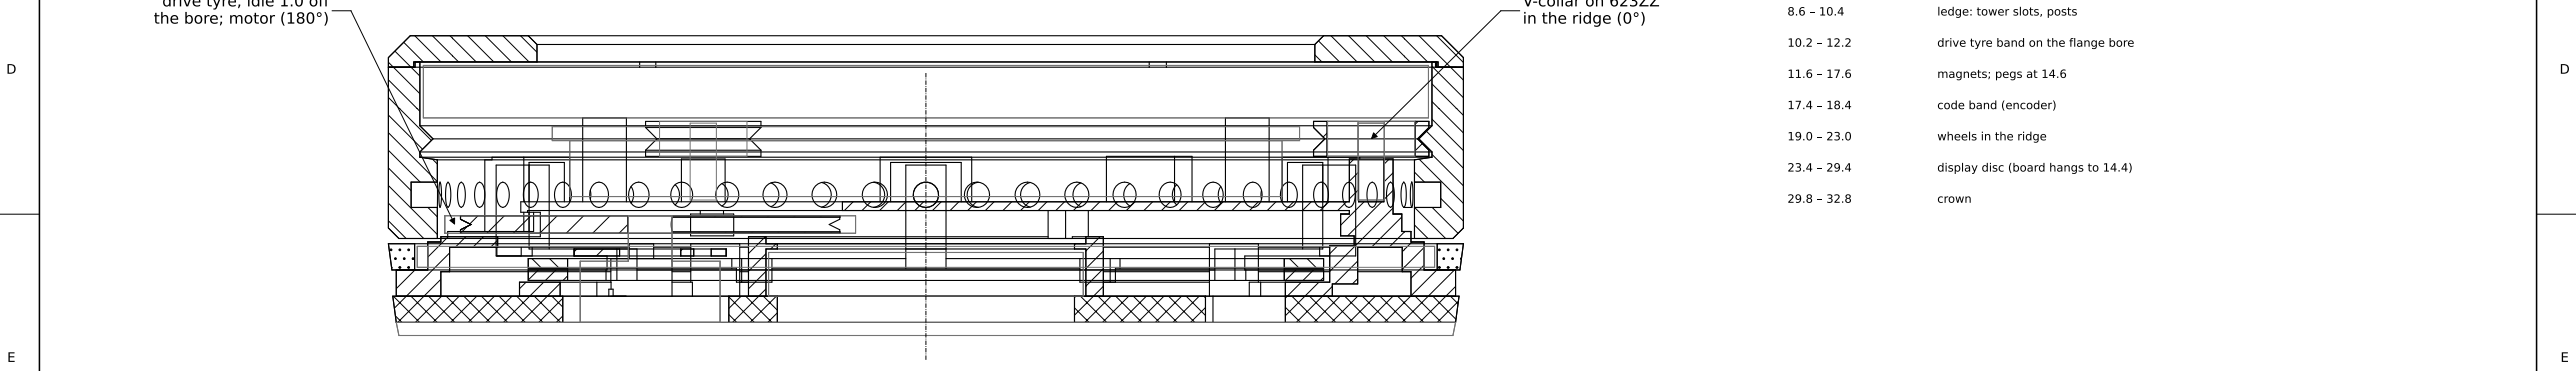
[picture p251: figure]
in the ridge (0°); the bore; motor (180°); ledge: tower slots, posts; magnets; pegs at 14.6; code band (encoder); wheels in the ridge; crown
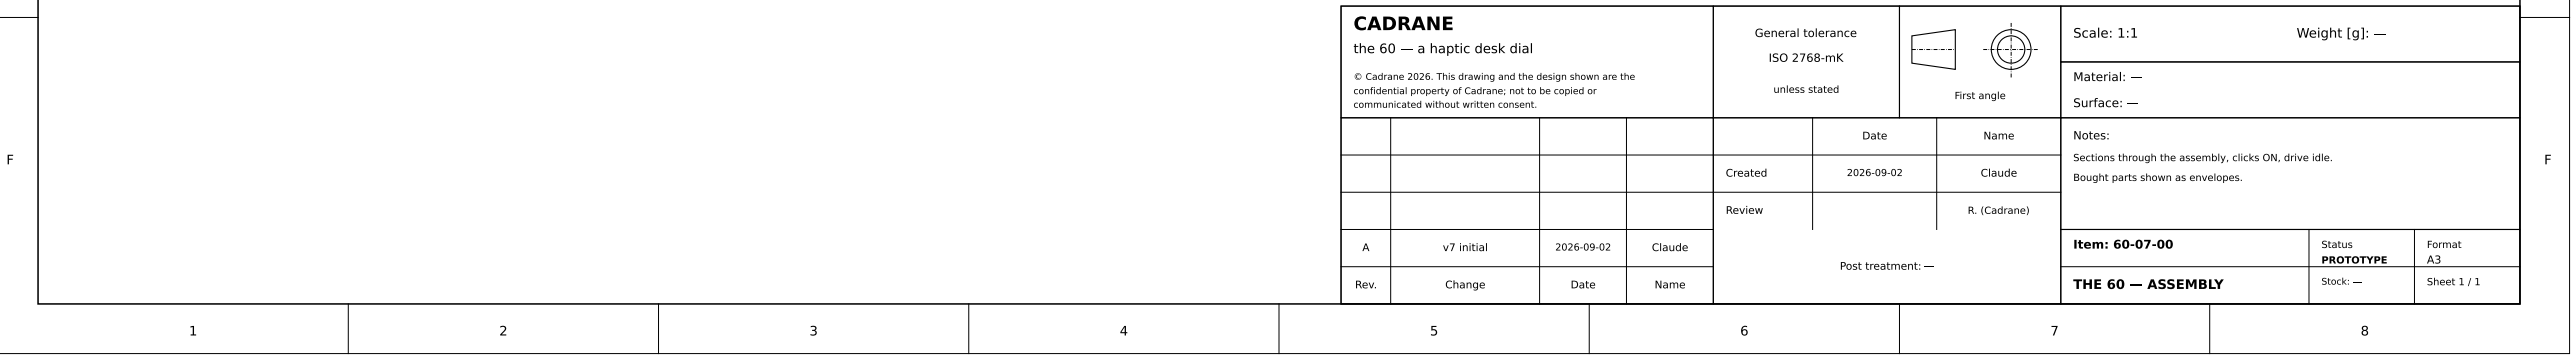
[picture p252: figure]
CADRANE; the 60; a haptic desk dial; communicated without written consent.; General tolerance; ISO 2768-mK; unless stated; First angle; Scale: 1:1; Weight [g]:; Material:; Surface:; Rev.; Change; Date; Name; v7 initial; Claude; Created; Review; R. (Cadrane); Post treatment:; Notes:; Bought parts shown as envelopes.; Item: 60-07-00; THE 60; ASSEMBLY; Status PROTOTYPE; Stock:; Format A3; Sheet 1 / 1

© Cadrane 2026. This drawing and the design shown are the confidential property of Cadrane; not to be copied or

Sections through the assembly, clicks ON, drive idle.

Ø123

## cable tunnel, USB-C and 3.5 mm plugs

## magnet tower (ring A) and the Ø3 pegs

## display disc Ø115 x 6 on four posts

# A-A (plane 90°-270°)

## V-collar on 623ZZ

## drive tyre, idle 1.0 off

# B-B (plane 0°-180°)

PARTS LIST | made
60-07-01 | Base plate | laser-cut steel 3 mm | 1
60-07-02 | Base shell | PETG / PA12 | 1

BOUGHT (envelopes): display 3.4C Ø115 x 6 + board; 3x 623ZZ + Ø3 dowels;

6x magnets 3x3x6 N42; 60x Ø3 steel balls; Ø8 planetary gearmotor + worm;

flat gimbal motor Ø16 x 7; O-ring tyre; solenoid Ø6; AEDR-8300 encoder;

LRA; speaker Ø36; port board (USB-C, hub, CS43131, jack); 2x supercaps Ø8 x 16;

90-LED ring board; rubber pad; screws 4x M3 csk, 4x M2.5 x 16, 6x M2 x 22.

# HEIGHT STACK (z from the plate underside)

-1.5 | 0 | rubber pad
0 | 3 | steel plate; port board and motors on the pad in pockets
3 | 6 | plinth band; cable tunnel at 90°
6 | 9 | halo ring (360°)
4.8 | 7.3 | magnet rings A and B under the ledge; legs to 8.4
9.6 | knob skirt bottom (0.6 shadow gap)
10.2 | 12.2 | drive tyre band on the flange bore
23.4 | 29.4 | display disc (board hangs to 14.4)
