Ryan365Apps/spotify-knob/design/artwork/_thumbs/examples_the60_exploded_test.png

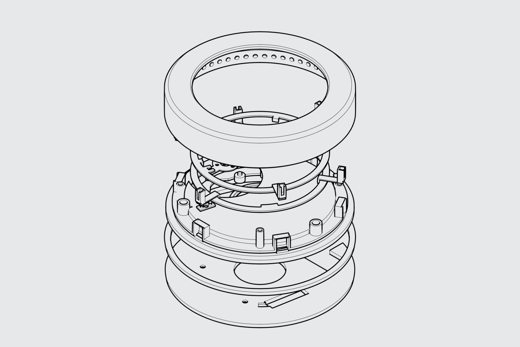
design/artwork/_thumbs/examples_the60_exploded_test.png
