Ryan365Apps/spotify-knob/docs/v11/the60_v11/the60_v11/the60_v11_A3_drawings.pdf

the 60 | v11 | sheet 0: the ASSUMED numbers (every one of these must be verified on the real part before the drawing is trusted)

2026-09-05. Stack: plate 8.0, deck 19.48-20.98, seat 30.4, glass 30.90-32.88, lens to 35.38, knob top 38.78, overall 40.28 with the pad. Ø175.

1. cover lens: Ø140.0 x 2.5 | specified separately; carrier rim and lip overlap designed to it
2. bonding tape: 0.5 | double-sided foam tape between the seat and the glass edge (RULING 5 Sep: glue allowed for the display)
3. panel back component area: 60.0 x 68.36 x 1.5 at -14.0 | position from the drawing's back view
4. Active Cooler position: from Pi x 2.5, fan from x 43.0 | no CAD body; footprint and fan position from photographs
5. cooler base above the board: 2.8 | SoC 2.4 + thermal pad
6. fan intake plenum: 8.0 | minimum free height above the blower
7. micro-HDMI receptacles: x 26.0/39.5 | not in the vendor STEP; drawn as envelopes
8. HDMI ribbon plugs: 12x8x5 micro end, 21x12x6 A end | flat FPC HDMI cable, 200 mm
9. adapter board: 65.0 x 64.0 x 1.6, parts 6.5 | DM-ADTTR-014 outline PUBLISHED; socket position and height assumed
10. audio / motion / touch / converter boards: envelopes | electrical layout not done
11. barrel jack body: 14.4 x 9.0 x 11.0 on a vertical board | PJ-063AH; CAD body to fetch
12. right-angle barrel plug: Ø8.5 body | measure the brick's plug
13. MOTOR_BASE_OD / MOTOR_BASE_H: 30.0 / 4.3 | carried from v9
14. MOTOR_BAND_T: 0.6 | carried from v9
15. servo pushrod: 3 mm bridge to the tab | carried from v9; servo now on the deck
16. LED strip: 5.0 wide x 1.6 thick | any 5 mm addressable strip; a wider strip raises the halo band

Build-time changes against V11-SPECIFICATION.md are listed in V11.md. Sheets 1-11 follow: one per made part.

the 60 | v11 | Knob

Cadrane · sheet 1 of 13 · 2026-09-05 · drawn from src/params.py + model.py (build123d)

Material: PETG (prototype) / CNC 6082-T6, hard anodised (production)

Process: print top face down, 0.16 mm; no supports

mm. Tolerance ±0.1 unless stated; clearances: running 0.30,

static 0.15, knob 0.40. Printed as-built; CNC knob Ra 0.8 on the chamfers.

Part: knob_body

Overall 175.4 x 175.4 x 23.9

Volume 80.16 cm³

Scale: see each view (fit)

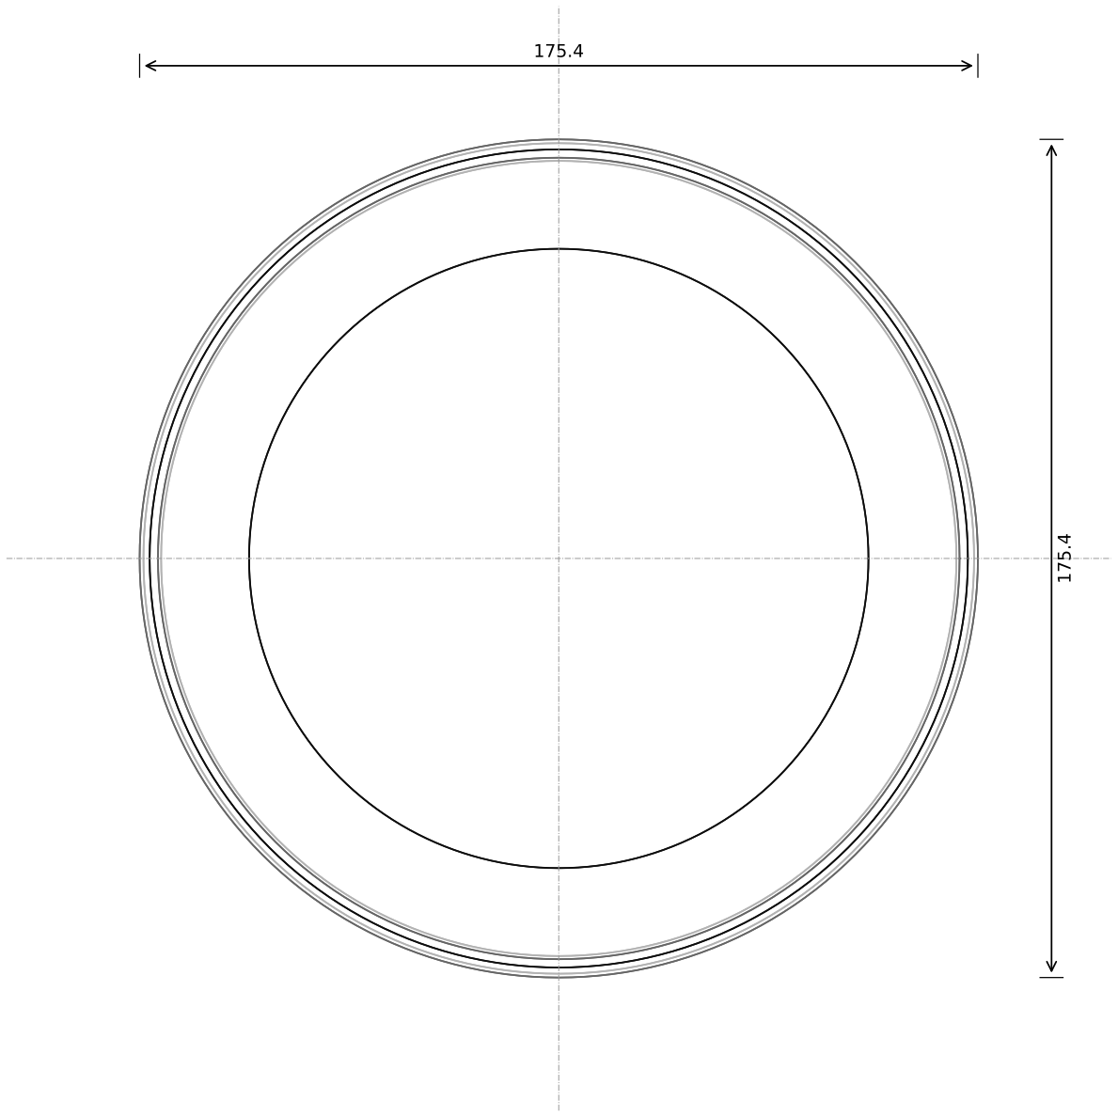
[picture p265: figure]

Key dimensions (from the parameter block):

1. outside Ø175.4, bore Ø166.4 (0.45 to the panel's chin corners); wall 4.5
2. top rim: lip inner edge Ø128.4, 1.0 inner chamfer, 20 flat, 2.5 outer chamfer (RULING 6 Sep: rim >= 20); lip 3.0 thick, top at z 38.78
3. outer chamfer 2.5 x 45° smooth; inner chamfer 1.0; skirt chamfer 1.2
4. V-groove 90°, root r 84.50399999999999, z 24.3-27.5
5. code-band recess 0.15 deep, z 18.5-22.7
6. diamond knurl 78 starts x 2, 1.0 deep, helix 37.3°, 4 whole rows z 16.9-35.5; skirt bottom z 14.9
7. wall under the knurl root 3.5

### PLAN (from above): sections at three heights bottom (light), middle, top (dark)

23.88

### SECTION A-A (front, plane y = 0; x across, z up)

### SECTION B-B (side, plane x = 0; y across, z up)

### DETAIL C (section A-A, x 58 to 90, enlarged)

the 60 | v11 | Internal structure

Cadrane · sheet 2 of 13 · 2026-09-05 · drawn from src/params.py + model.py (build123d)

Material: PETG (prototype) / PA12 (production)

Process: print upright on the wall foot, 0.20 mm; supports ONLY under the seat flange (inside) and the diffuser lip (outside)

Part: internal_structure

Overall 173.4 x 173.4 x 24.6

Volume 40.97 cm³

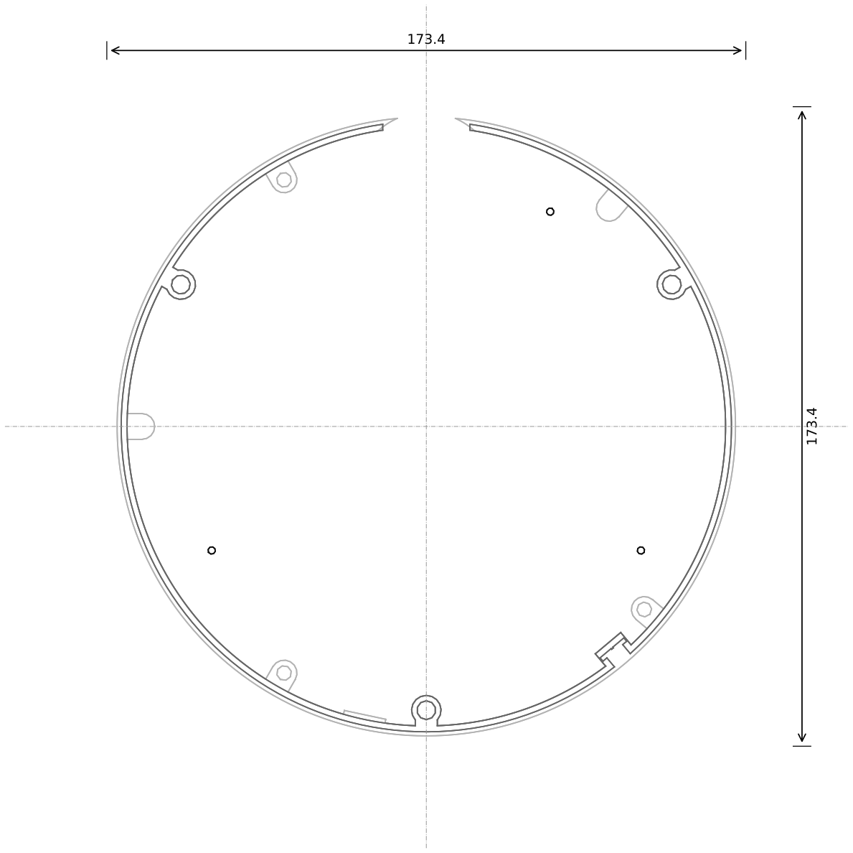
[picture p266: figure]

Key dimensions (from the parameter block):

1. wall r 81.204-82.80399999999999, z 8.0-30.4
2. seat flange r 62.0-82.80399999999999, z 28.4-30.4; three Ø2 locating nubs at [60, 210, 330]°
3. LED-strip band r 82.80399999999999-83.90399999999998, z 8.0-13.5 (strip r 84.00399999999998-85.60399999999997); diffuser lip r 82.80399999999999-86.704, z 13.5-14.3
4. wheel posts Ø8.0 at r 76.93, az [30, 150, 270], to z 23.3; bush bores Ø5.1; wall windows 15.2 wide, open to the top from z 23.0; the seat flange is cut away above each wheel
5. pillars Ø7 at r 77.204, az [50, 120, 180, 240, 320], to z 19.48; M3 inserts top (all) and bottom ([120, 240, 320])
6. encoder tower at 310.0° to z 25.1, board slot open to the top, window through the wall at the code band; motor window open to the seat; LRA pad at 258.0°
7. flex slot 32 x 2.5 through the seat at 0°, offset -4; 89 vent slits 1.0 x 3.5 at z 14.7-18.2, 2.5° grid
8. motor relief at 90°

24.59

### SECTION A-A (front, plane y = 0; x across, z up)

### SECTION B-B (side, plane x = 0; y across, z up)

### DETAIL C (section A-A, x 57 to 89, enlarged)

the 60 | v11 | Mezzanine deck

Cadrane · sheet 3 of 13 · 2026-09-05 · drawn from src/params.py + model.py (build123d)

Material: PETG

Process: print upside down (flat top face on the bed, legs up), 0.20 mm; no supports; 14 x M2.5 nuts pressed into the top pockets

Part: deck

Overall 161.4 x 161.4 x 18.2

Volume 30.81 cm³

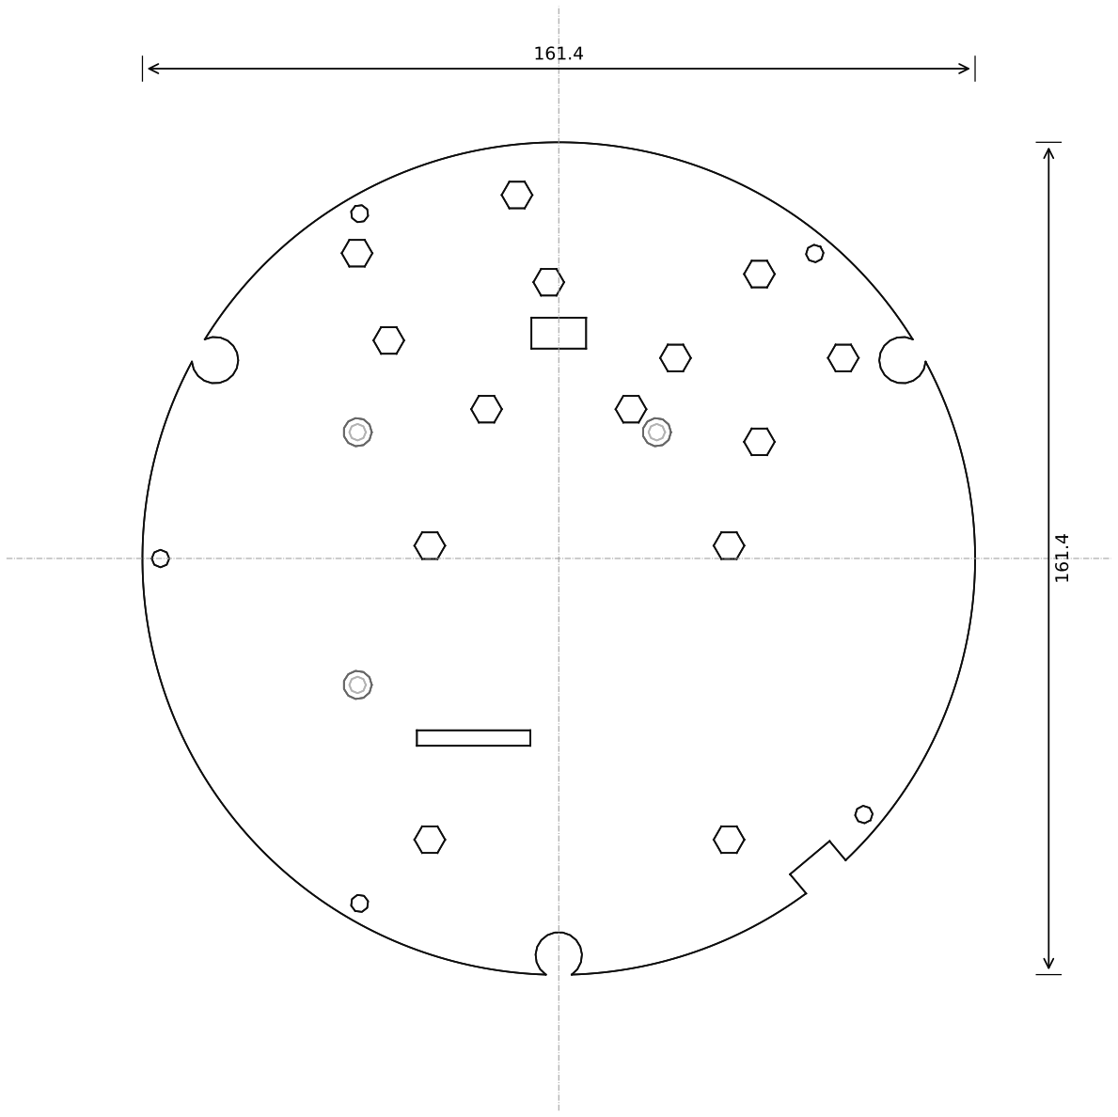
[picture p267: figure]

Key dimensions (from the parameter block):

1. disc Ø161 x 1.5, z 19.48-20.98; 14 hex pockets 5.15 across flats x 1.0 deep in the top face for M2.5 nuts (the boards sit on the nuts, 1.0 proud)
2. three legs Ø5.5 down to the Pi's board top (z 2.7800000000000002), M2.5 inserts
3. tab slot 6.0 x 10.6 at 90°; ribbon slot 22 x 3 at (-16.5, -34.5)
4. Ø3.4 holes at the pillars; notches at the wheel posts and the encoder tower
5. M2.5 insert bosses for the adapter, audio, motion boards and the servo tray

18.20

### SECTION A-A (front, plane y = 0; x across, z up)

### SECTION B-B (side, plane x = 0; y across, z up)

### DETAIL C (section A-A, x 51 to 83, enlarged)

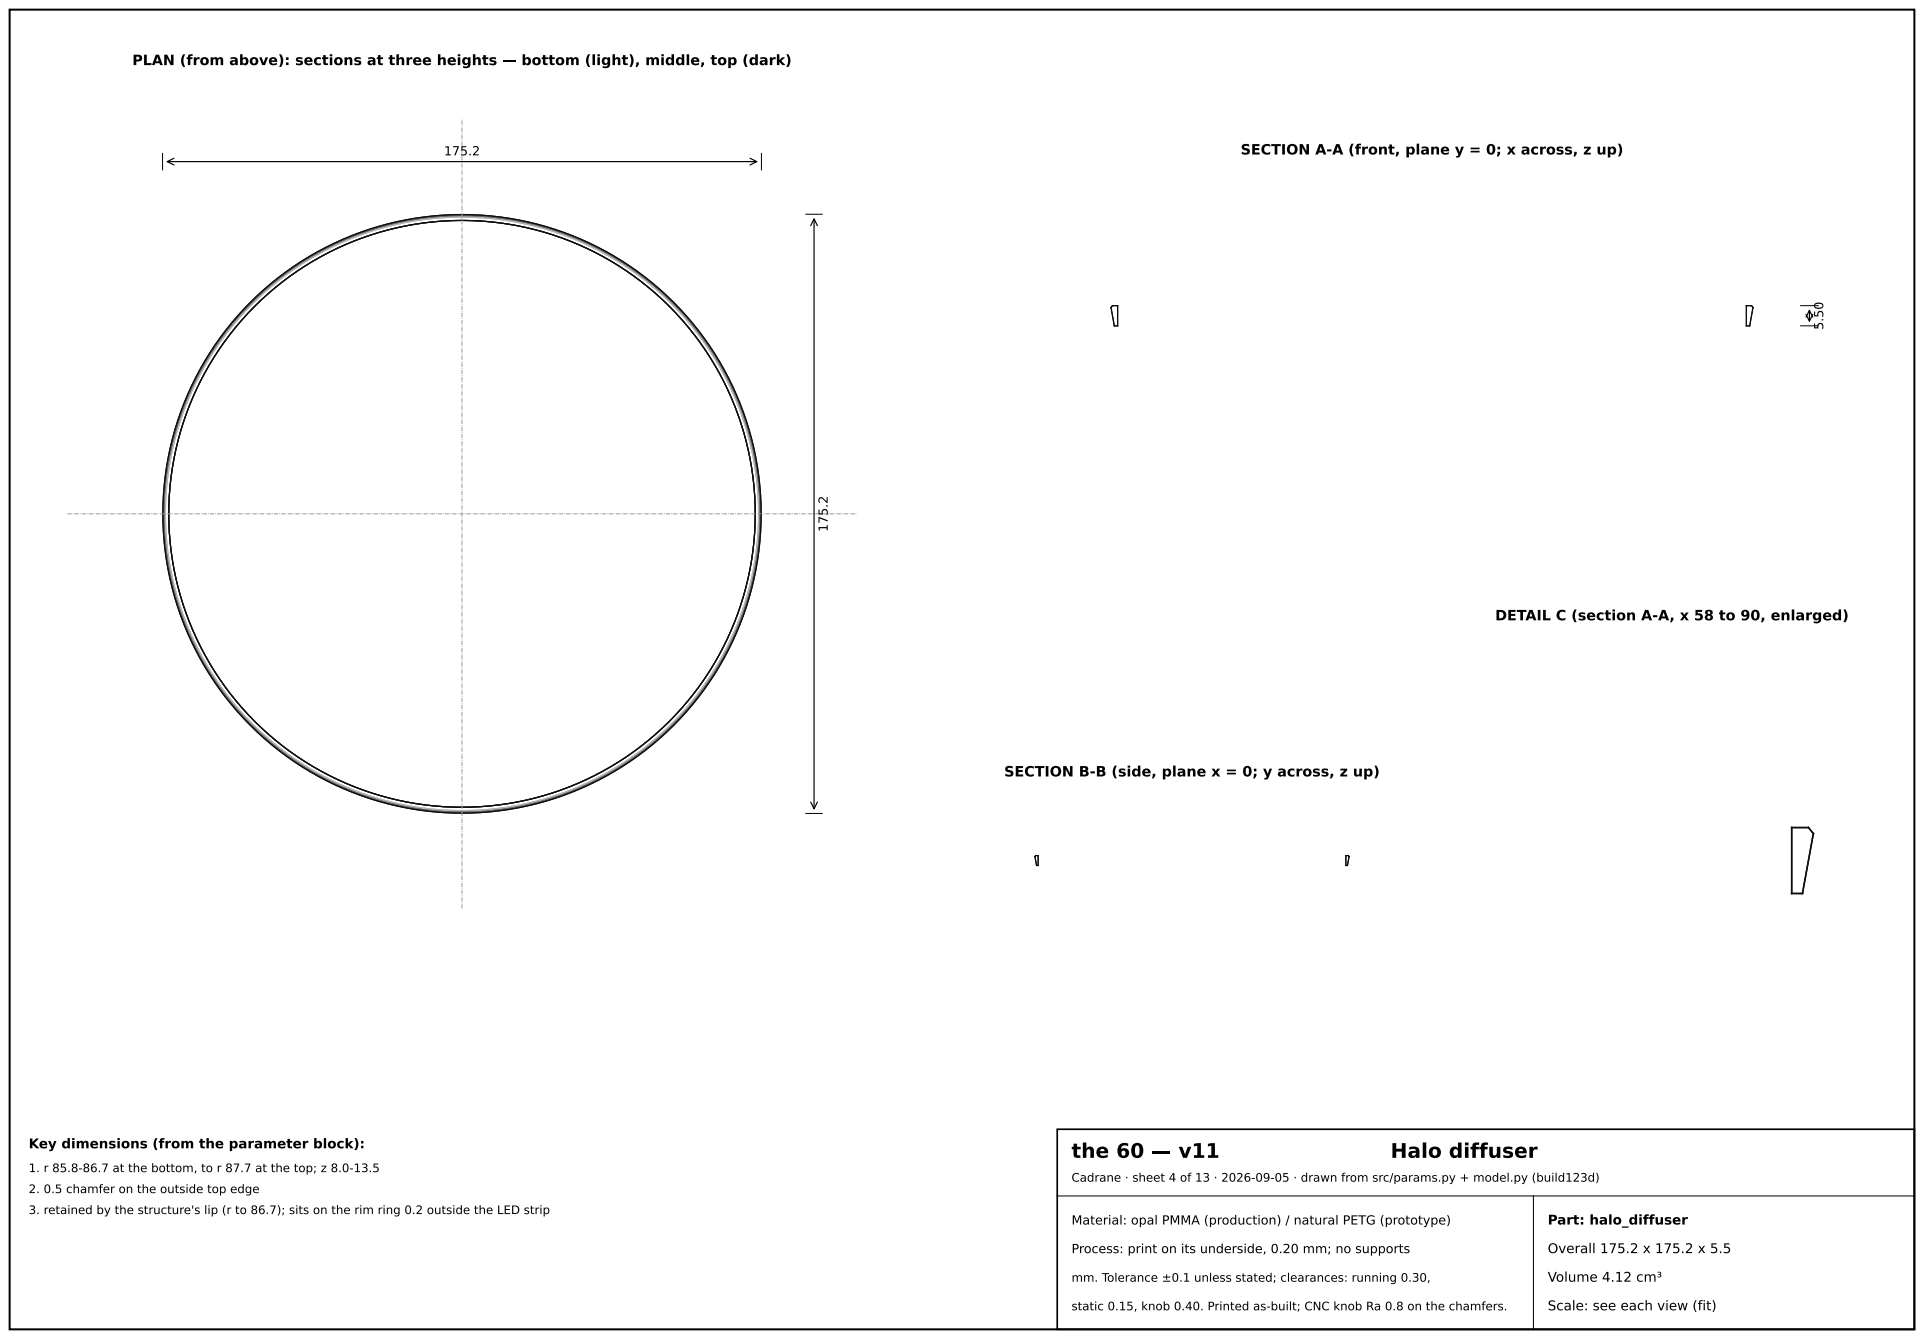
[picture p268: page 5]
the 60; Halo diffuser; Part: halo_diffuser; Overall 175.2 x 175.2 x 5.5; Volume 4.12 cm³

SECTION A-A (front, plane y = 0; x across, z up)

DETAIL C (section A-A, x 58 to 90, enlarged)

SECTION B-B (side, plane x = 0; y across, z up)

Key dimensions (from the parameter block):

1. r 85.8-86.7 at the bottom, to r 87.7 at the top; z 8.0-13.5

Cadrane · sheet 4 of 13 · 2026-09-05 · drawn from src/params.py + model.py (build123d)

2. 0.5 chamfer on the outside top edge

3. retained by the structure's lip (r to 86.7); sits on the rim ring 0.2 outside the LED strip

Material: opal PMMA (production) / natural PETG (prototype)

Process: print on its underside, 0.20 mm; no supports

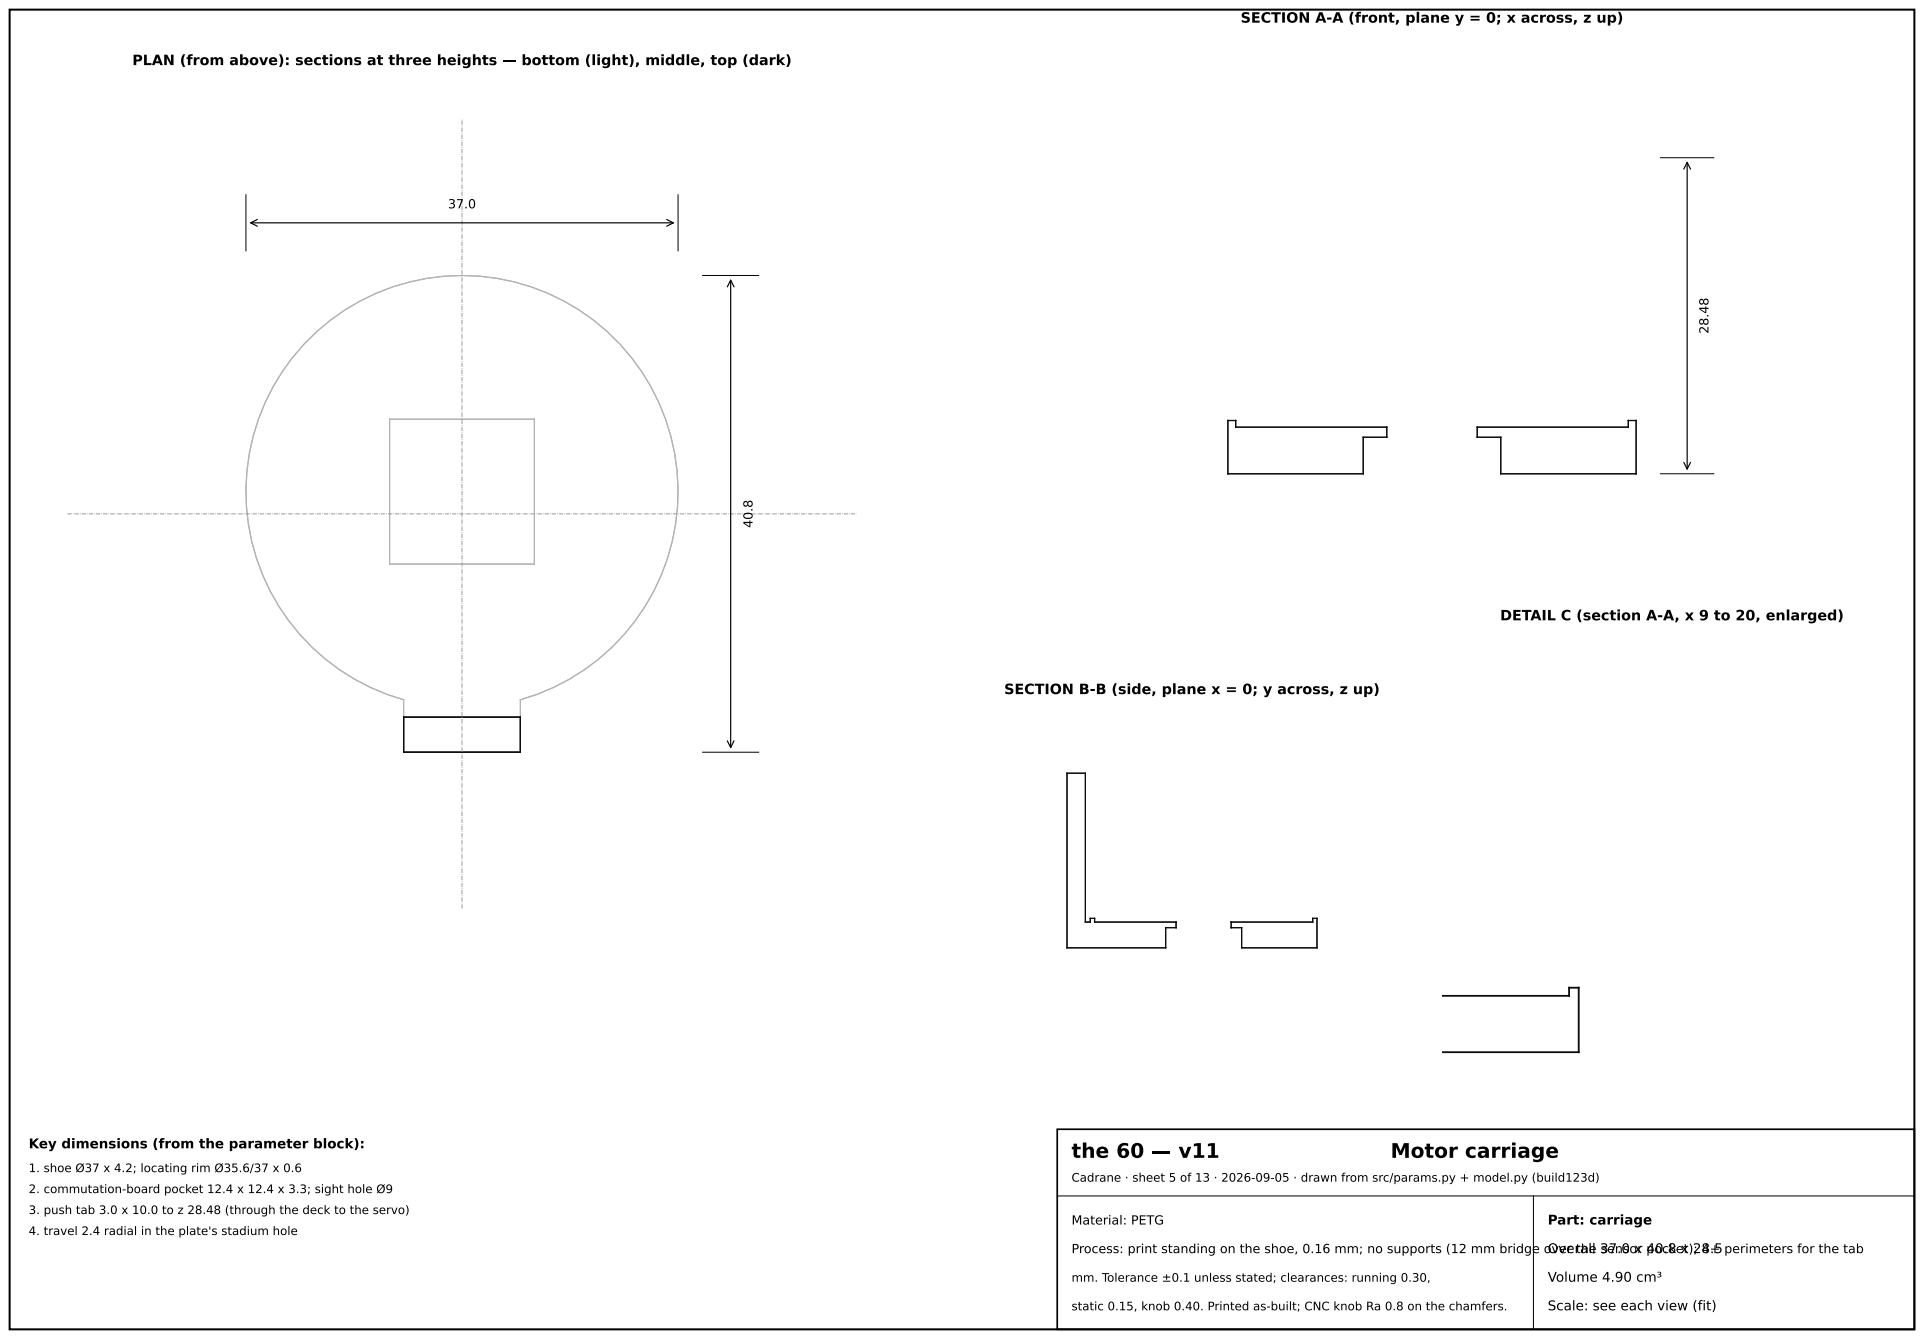
[picture p269: page 6]
the 60; Motor carriage; Material: PETG; Part: carriage; Overall 37.0 x 40.8 x 28.5; Volume 4.90 cm³

SECTION A-A (front, plane y = 0; x across, z up)

DETAIL C (section A-A, x 9 to 20, enlarged)

SECTION B-B (side, plane x = 0; y across, z up)

Key dimensions (from the parameter block):

1. shoe Ø37 x 4.2; locating rim Ø35.6/37 x 0.6

Cadrane · sheet 5 of 13 · 2026-09-05 · drawn from src/params.py + model.py (build123d)

2. commutation-board pocket 12.4 x 12.4 x 3.3; sight hole Ø9

3. push tab 3.0 x 10.0 to z 28.48 (through the deck to the servo)

4. travel 2.4 radial in the plate's stadium hole

Process: print standing on the shoe, 0.16 mm; no supports (12 mm bridge over the sensor pocket); 4+ perimeters for the tab

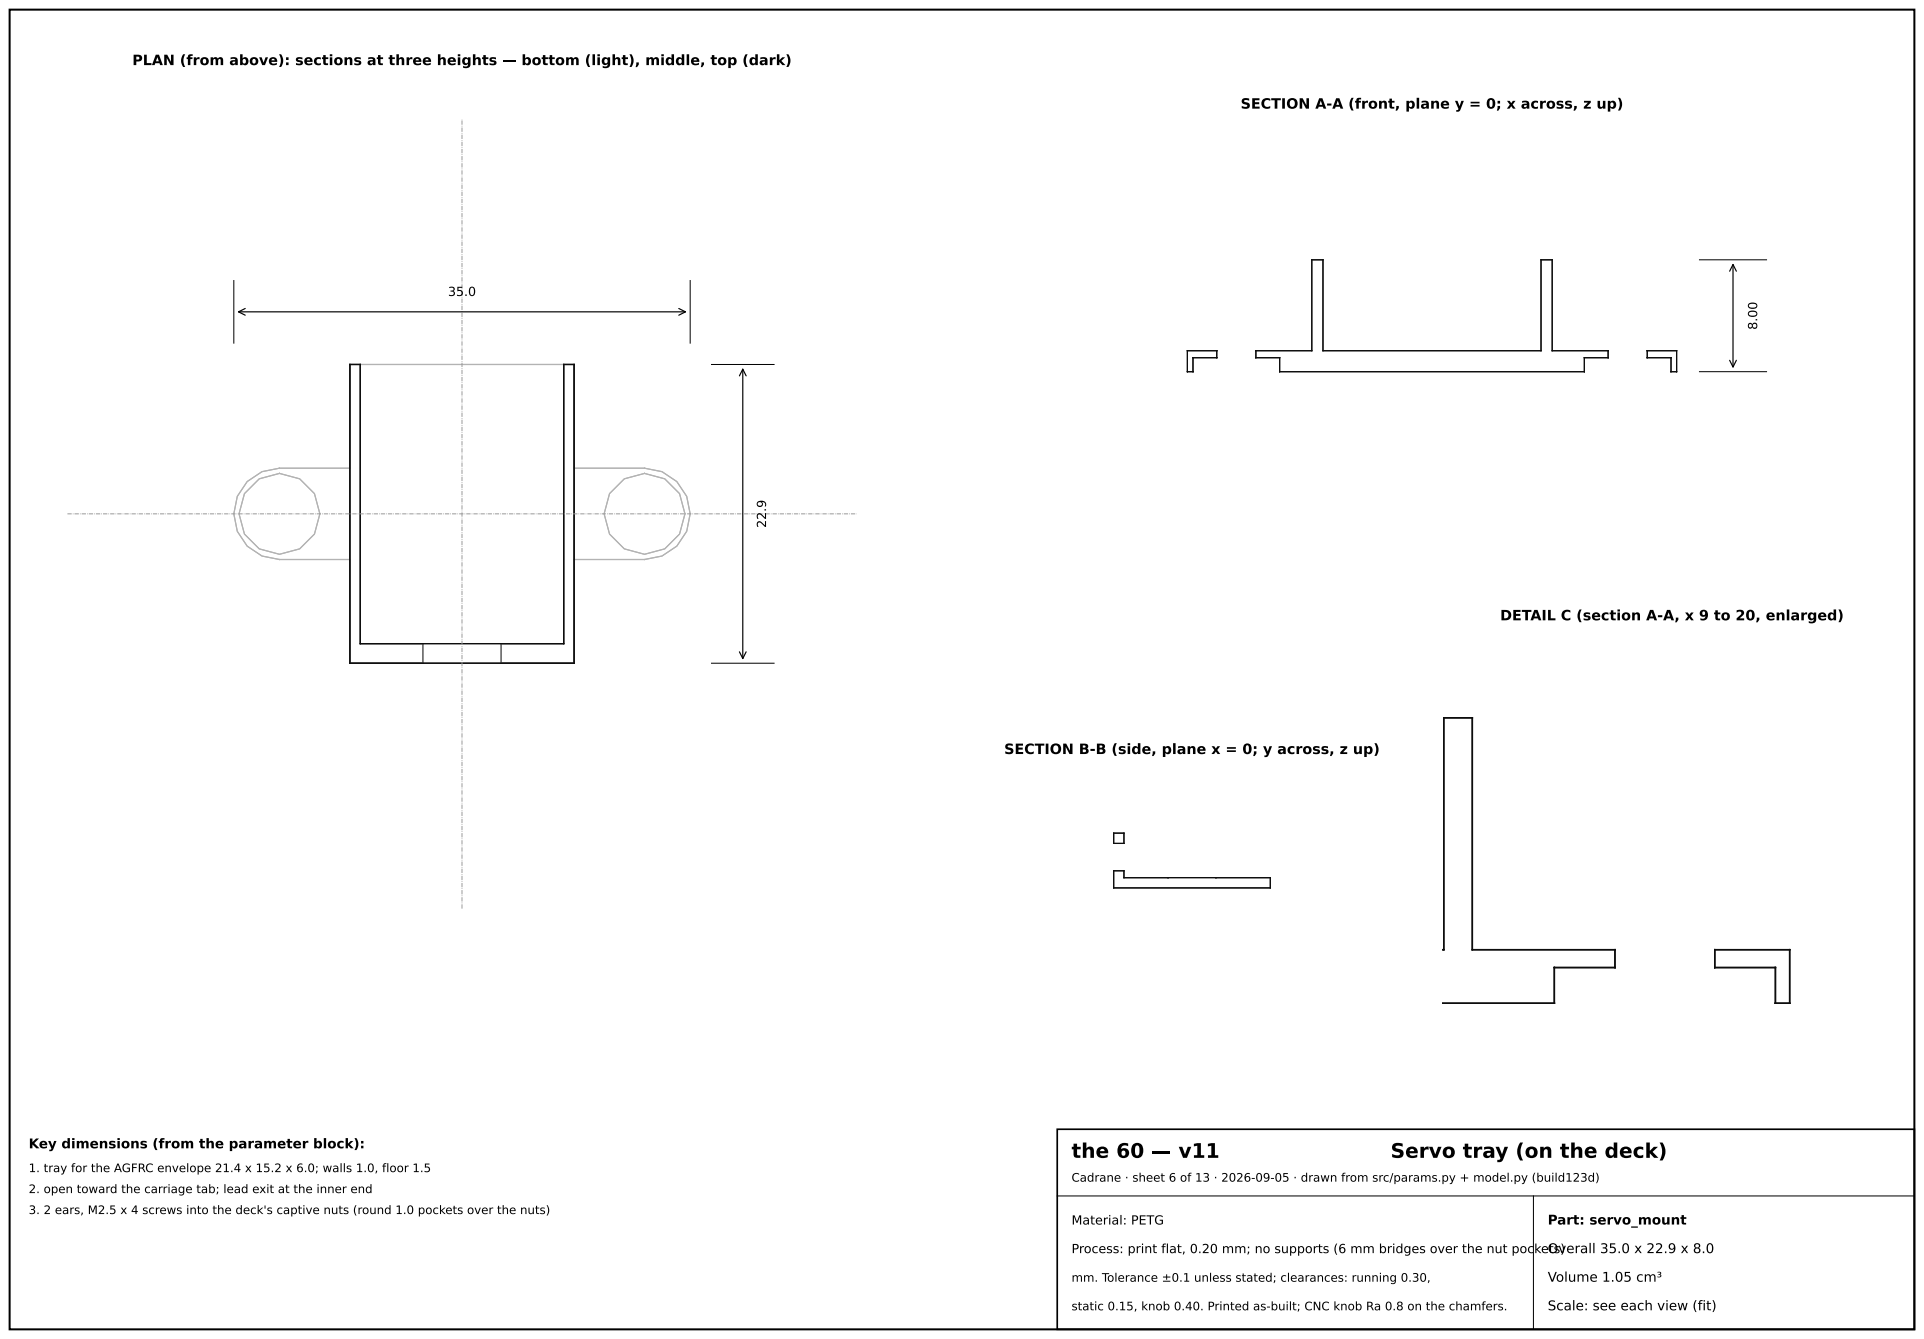
[picture p270: page 7]
the 60; Servo tray (on the deck); Material: PETG; Part: servo_mount; Overall 35.0 x 22.9 x 8.0; Volume 1.05 cm³

SECTION A-A (front, plane y = 0; x across, z up)

DETAIL C (section A-A, x 9 to 20, enlarged)

SECTION B-B (side, plane x = 0; y across, z up)

Key dimensions (from the parameter block):

1. tray for the AGFRC envelope 21.4 x 15.2 x 6.0; walls 1.0, floor 1.5

Cadrane · sheet 6 of 13 · 2026-09-05 · drawn from src/params.py + model.py (build123d)

2. open toward the carriage tab; lead exit at the inner end

3. 2 ears, M2.5 x 4 screws into the deck's captive nuts (round 1.0 pockets over the nuts)

Process: print flat, 0.20 mm; no supports (6 mm bridges over the nut pockets)

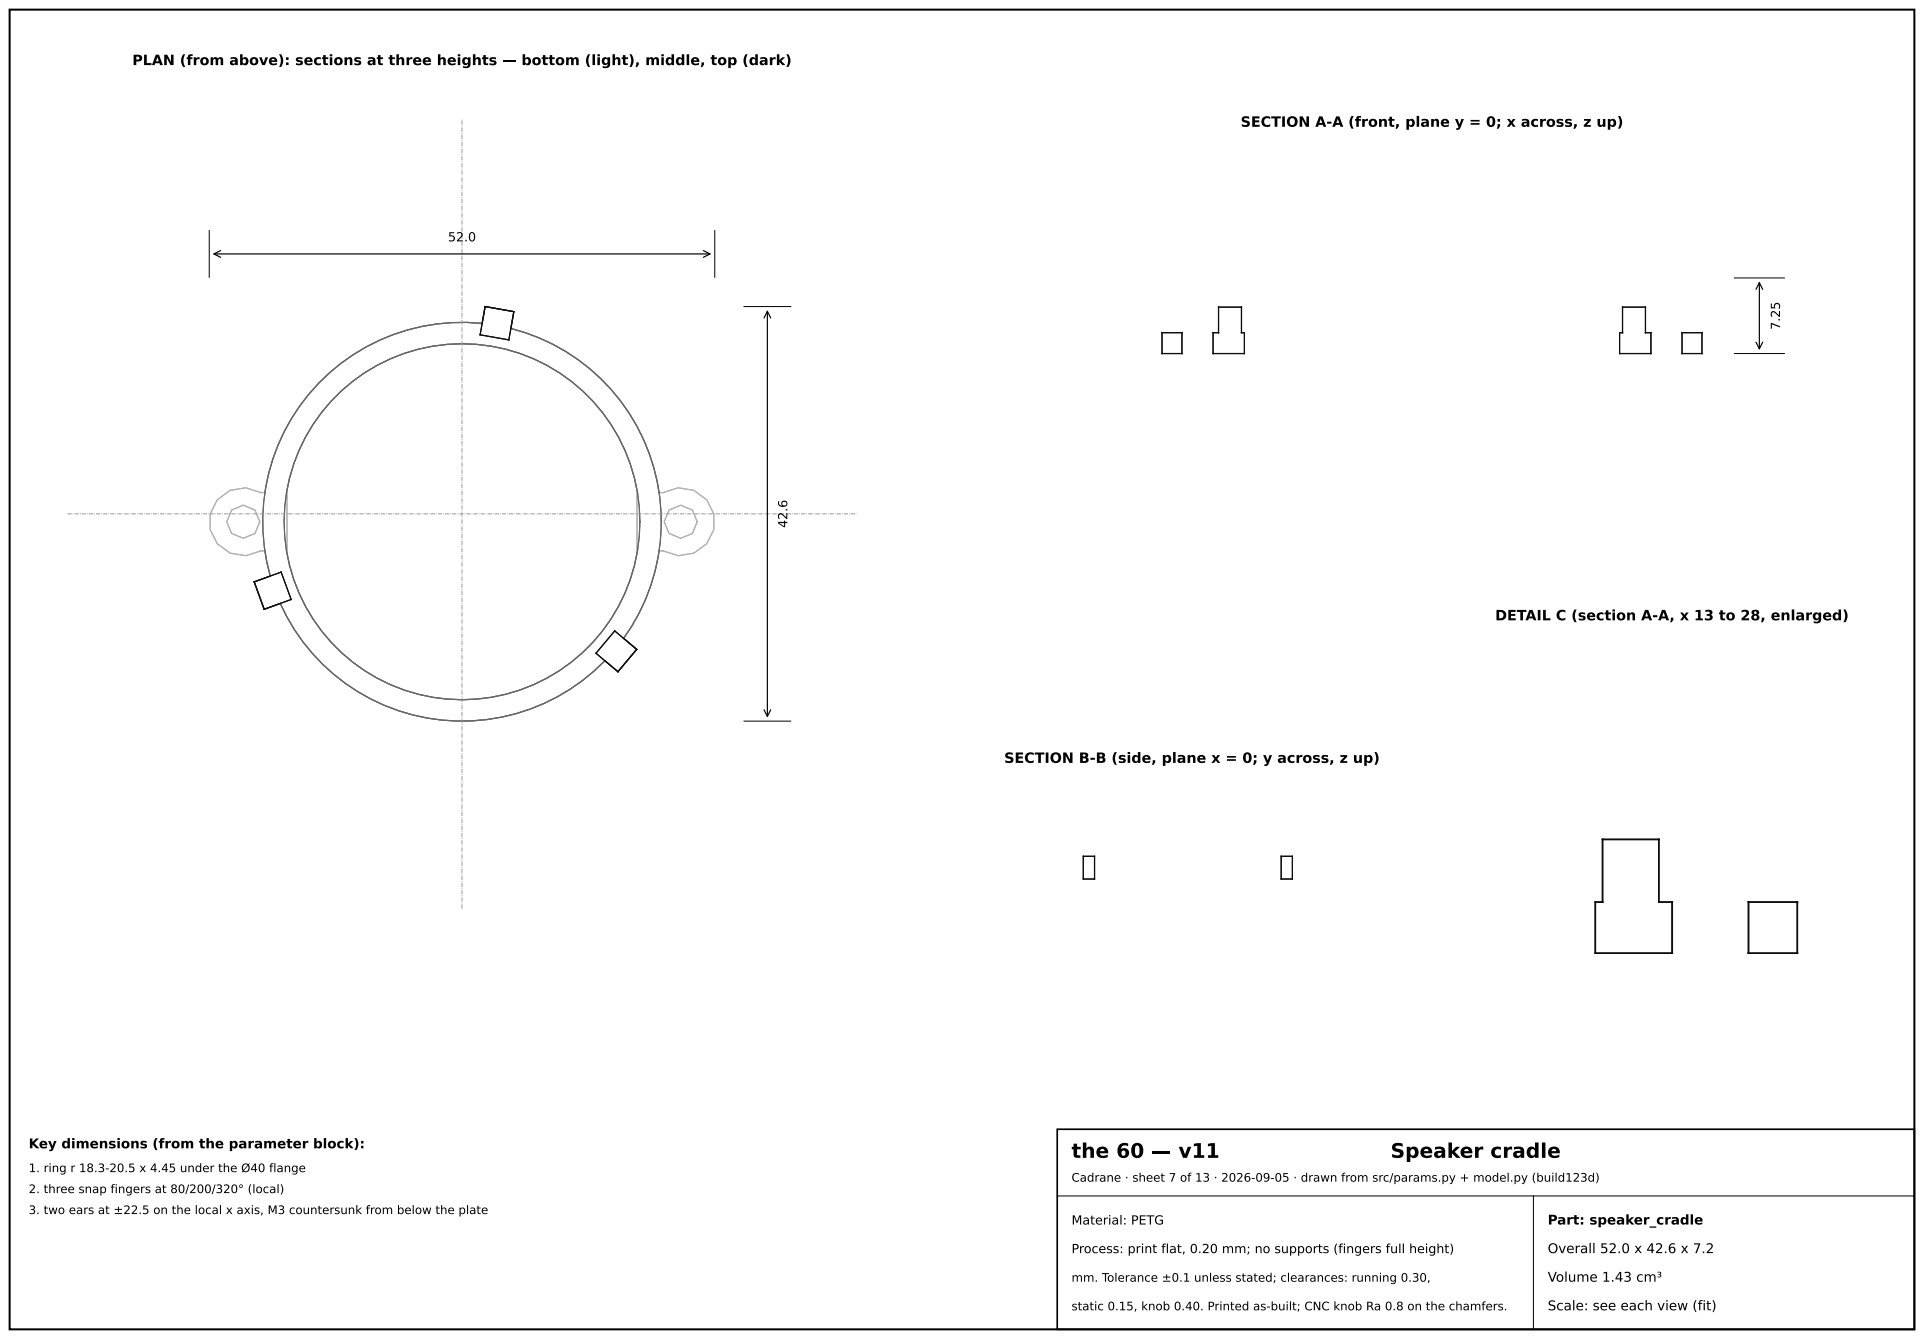
[picture p271: page 8]
the 60; Speaker cradle; Material: PETG; Part: speaker_cradle; Overall 52.0 x 42.6 x 7.2; Volume 1.43 cm³

SECTION A-A (front, plane y = 0; x across, z up)

DETAIL C (section A-A, x 13 to 28, enlarged)

SECTION B-B (side, plane x = 0; y across, z up)

Key dimensions (from the parameter block):

1. ring r 18.3-20.5 x 4.45 under the Ø40 flange

Cadrane · sheet 7 of 13 · 2026-09-05 · drawn from src/params.py + model.py (build123d)

2. three snap fingers at 80/200/320° (local)

3. two ears at ±22.5 on the local x axis, M3 countersunk from below the plate

Process: print flat, 0.20 mm; no supports (fingers full height)

the 60 | v11 | Rear port face

Cadrane · sheet 8 of 13 · 2026-09-05 · drawn from src/params.py + model.py (build123d)

Material: PETG

Process: print lying on its outer face, 0.16 mm; no supports (the socket holes print vertical)

Part: port_face

Overall 11.3 x 58.0 x 11.0

Volume 1.01 cm³

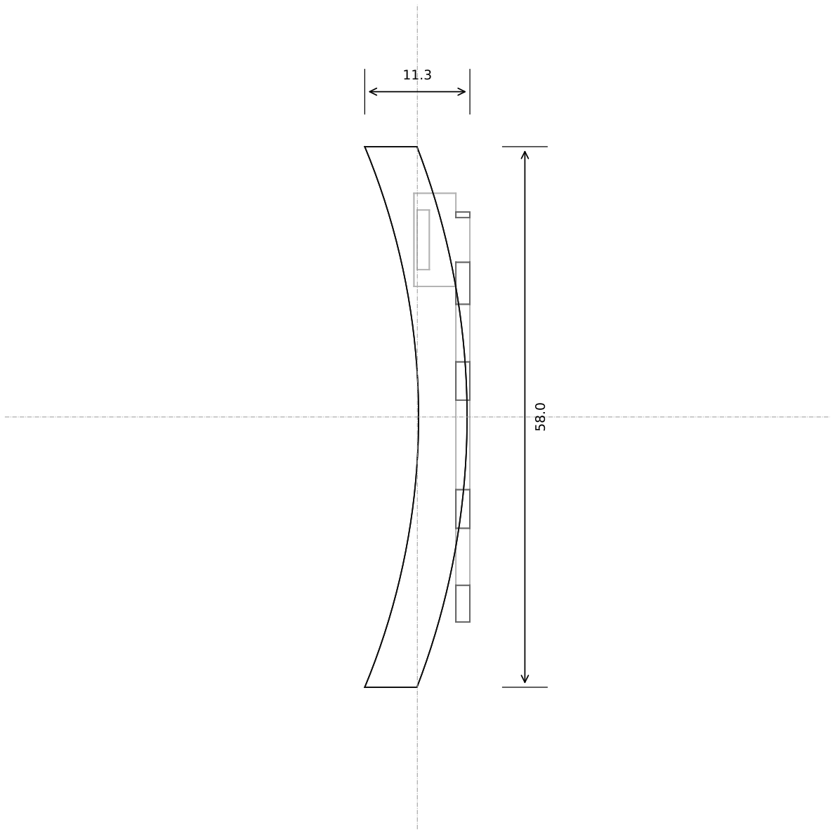
[picture p272: figure]

Key dimensions (from the parameter block):

1. 44.0 wide x 1.5 thick at r 79.704, z -1.5-8.0
2. barrel nose Ø6.2 at t -15.0, z 3.5; USB-C opening at t -3.0, z 4.5; jack Ø6.3 at t 9.0, z 4.6; light aperture Ø4.8 at t 19.0
3. shelf for the USB-C board; foot for the light-sensor board; rail along the top on the plate (1.5 tall, 58 wide, inner edge r 75.7, flat front in the face's plane, corners cut 45° to stay inside the diffuser) with two Ø2.2 holes at r 78.2, t ±26: M2 screws into the plate

11.00

### SECTION A-A (front, plane y = 0; x across, z up)

### SECTION B-B (side, plane x = 0; y across, z up)

### DETAIL C (section A-A, x 3 to 8, enlarged)

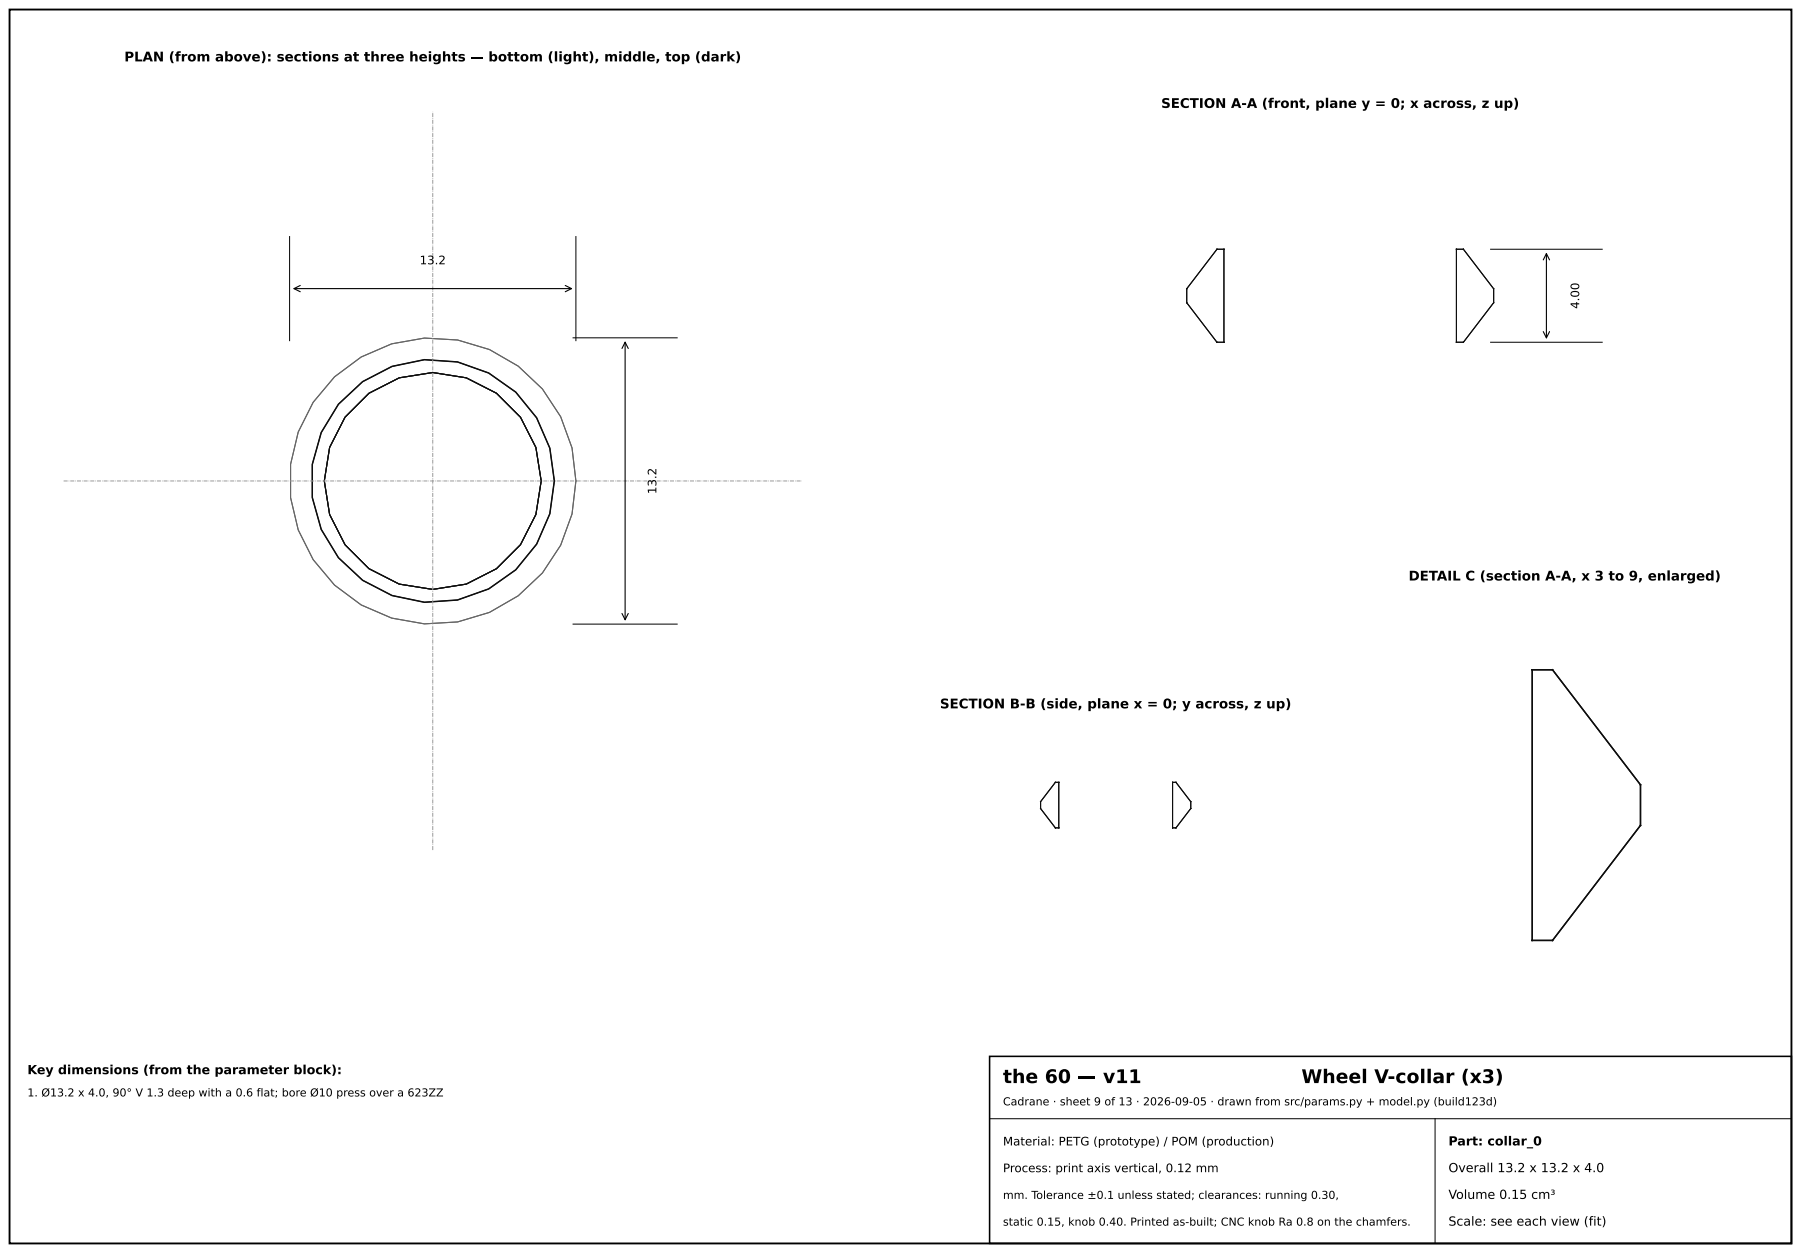
[picture p273: page 10]
the 60; Wheel V-collar (x3); Part: collar_0; Overall 13.2 x 13.2 x 4.0; Volume 0.15 cm³

SECTION A-A (front, plane y = 0; x across, z up)

DETAIL C (section A-A, x 3 to 9, enlarged)

SECTION B-B (side, plane x = 0; y across, z up)

Key dimensions (from the parameter block):

1. Ø13.2 x 4.0, 90° V 1.3 deep with a 0.6 flat; bore Ø10 press over a 623ZZ

Cadrane · sheet 9 of 13 · 2026-09-05 · drawn from src/params.py + model.py (build123d)

Material: PETG (prototype) / POM (production)

Process: print axis vertical, 0.12 mm

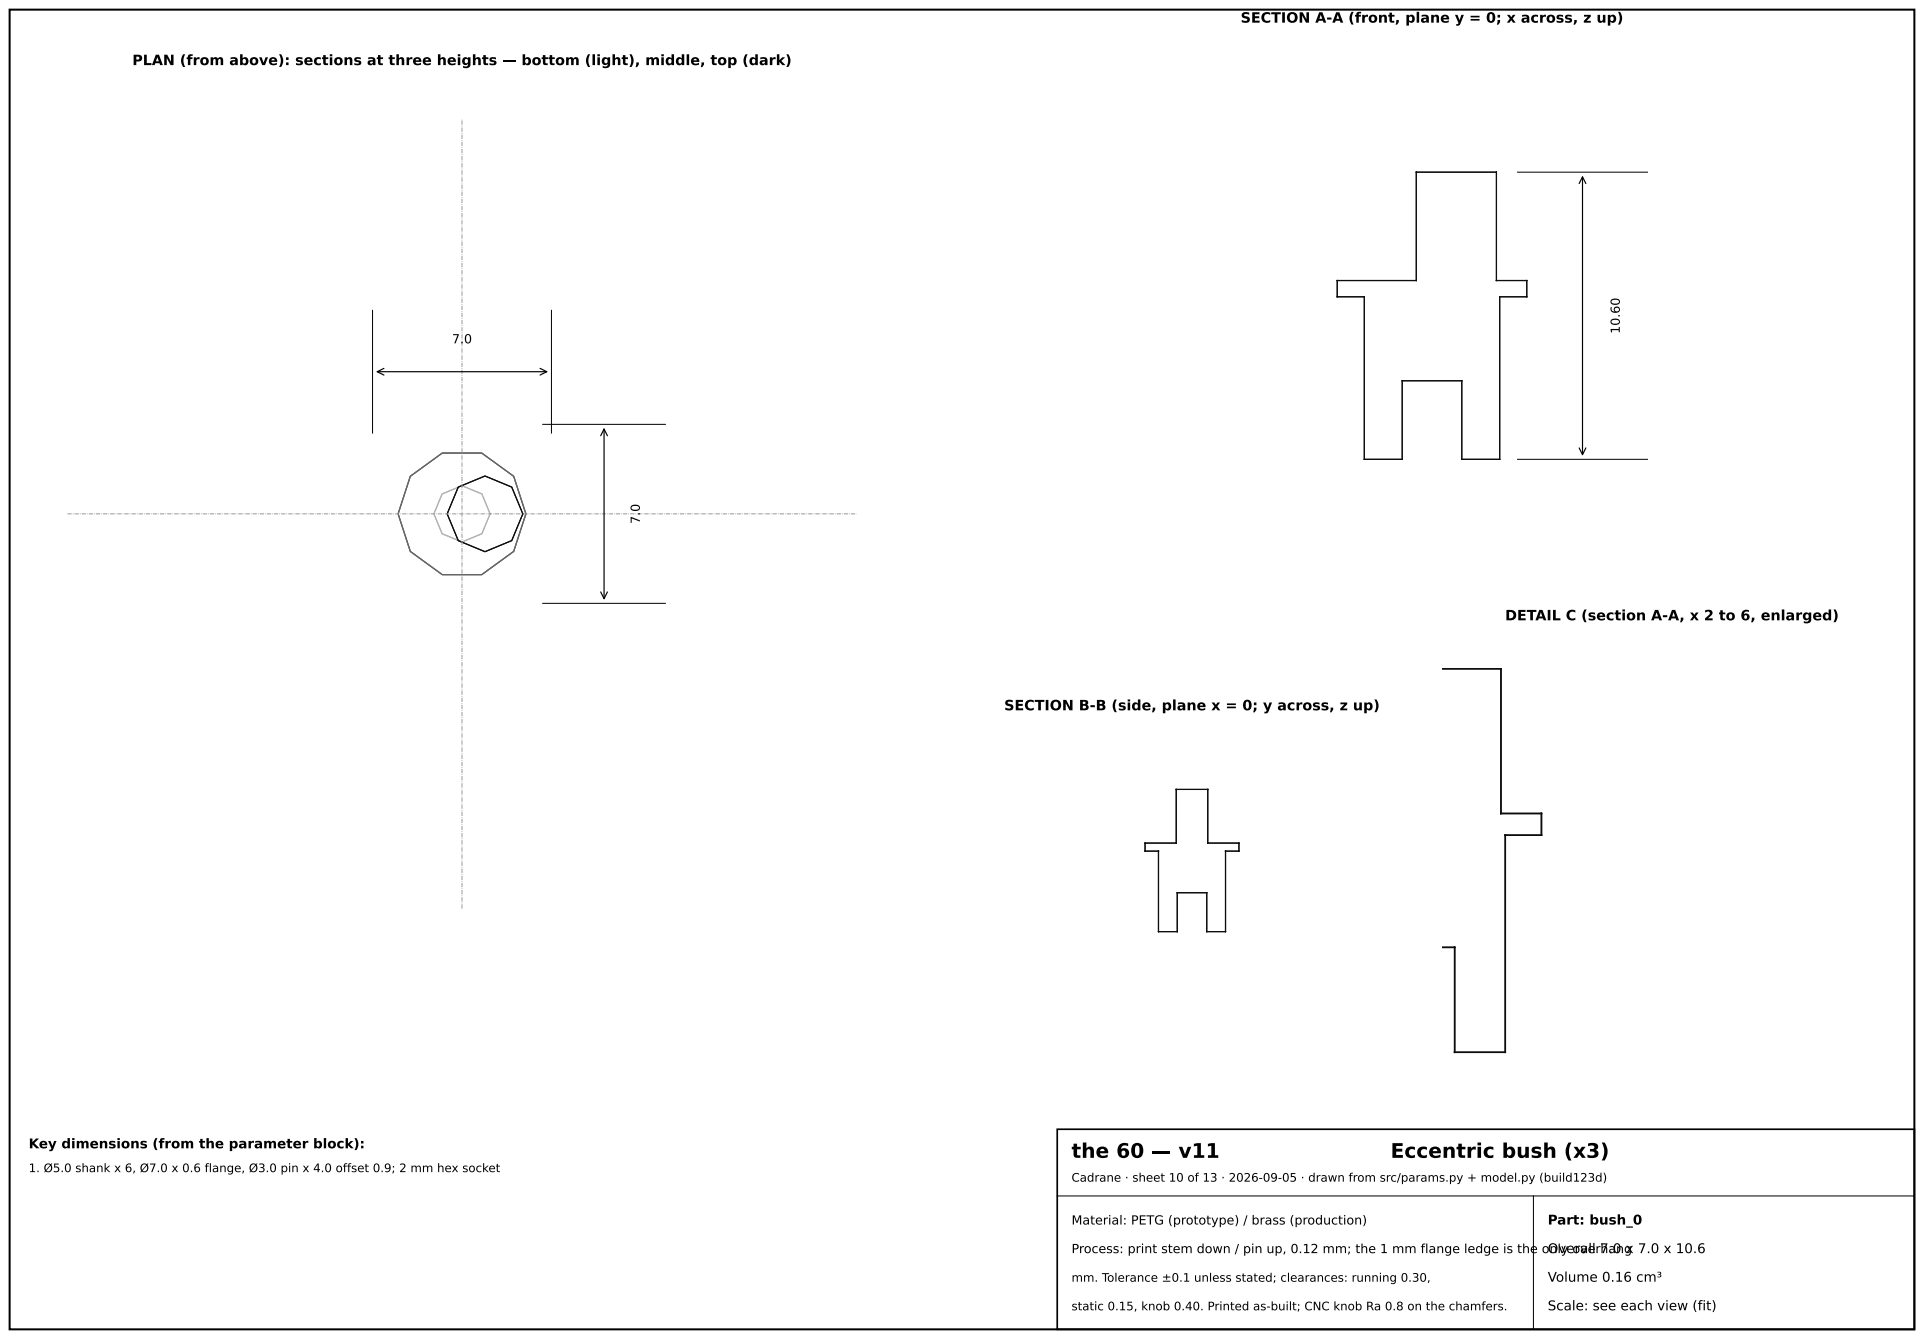
[picture p274: page 11]
the 60; Eccentric bush (x3); Part: bush_0; Overall 7.0 x 7.0 x 10.6; Volume 0.16 cm³

SECTION A-A (front, plane y = 0; x across, z up)

DETAIL C (section A-A, x 2 to 6, enlarged)

SECTION B-B (side, plane x = 0; y across, z up)

Key dimensions (from the parameter block):

1. Ø5.0 shank x 6, Ø7.0 x 0.6 flange, Ø3.0 pin x 4.0 offset 0.9; 2 mm hex socket

Cadrane · sheet 10 of 13 · 2026-09-05 · drawn from src/params.py + model.py (build123d)

Material: PETG (prototype) / brass (production)

Process: print stem down / pin up, 0.12 mm; the 1 mm flange ledge is the only overhang

the 60 | v11 | Base plate - aluminium core (the heatsink)

Cadrane · sheet 11 of 13 · 2026-09-05 · drawn from src/params.py + model.py (build123d)

Material: 6082 aluminium, CNC two-sided, black hard anodised on every face (masked bare pads at the ground bond and under the converter)

Process: machined, not printed (print a PETG stand-in without the duct for the fit check)

| Part: base_plate
| Overall 147.1 x 148.3 x 14.0
| Volume 53.13 cm³

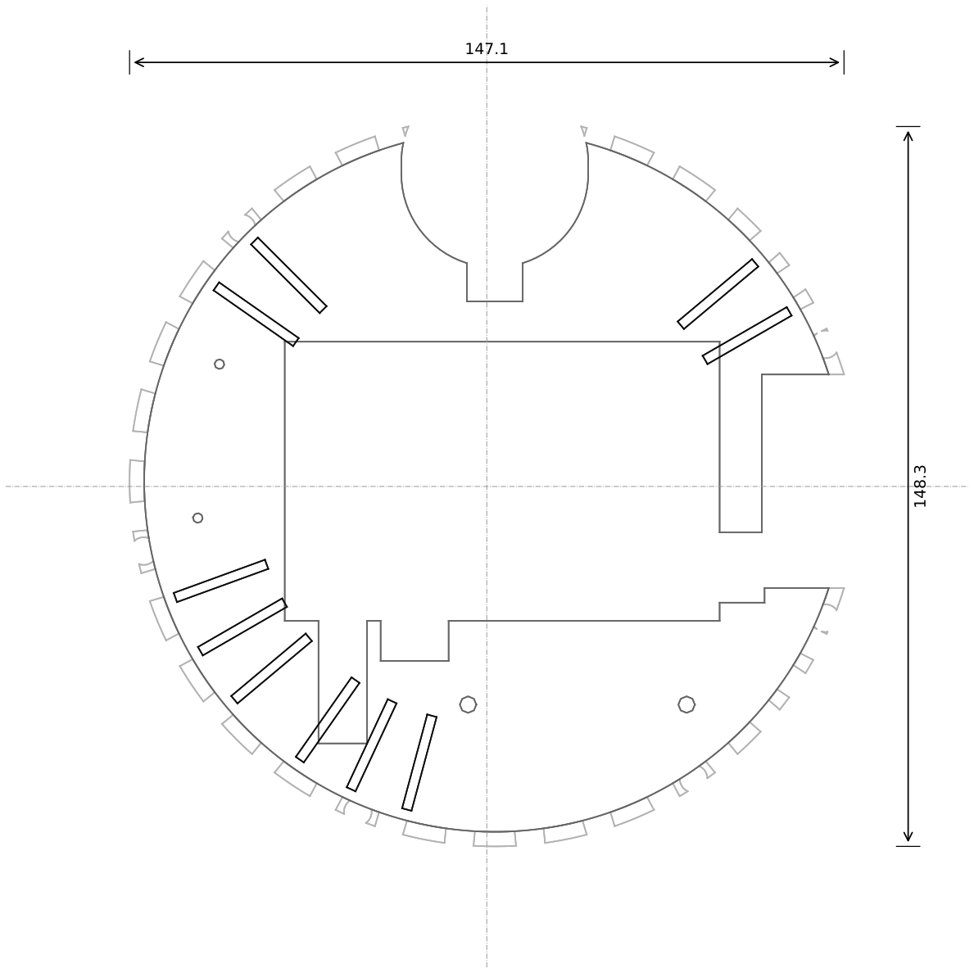
[picture p275: figure]

Key dimensions (from the parameter block):

1. r < 75.2 x 8.0: 4 web (z 4-8), 3 duct (z 1-4) closed by a 1 mm plate in a recess; rebate r 72.2-75.2, z 4-8 for the ring's flange, 7 x M3 csk from below at r 73.7
2. duct: collector r 66-70.2 (front and sides), straight channels 3 wide on a 4 pitch beside the Pi window, rear plenum r 55+, blower envelope 28 x 18 x 5 at az 277 (not fitted); 2.5 walls round every through-cut
3. Pi window, carriage hole, port slot; 2 x M3 csk for the speaker cradle; ground-bond hole; 2 x M2.5 tapped for the converter at az 172, r 59.5, t ±16; 6 x M2.5 tapped for the closing plate
4. 10 ribs 2.0 x 6.0 tall on the top face at r 50-70, az [135, 145, 200, 210, 220, 235, 245, 255, 30, 40]

14.00

### SECTION A-A (front, plane y = 0; x across, z up)

### SECTION B-B (side, plane x = 0; y across, z up)

### DETAIL C (section A-A, x 44 to 76, enlarged)

the 60 | v11 | Rim ring (steel)

Cadrane · sheet 12 of 13 · 2026-09-05 · drawn from src/params.py + model.py (build123d)

Material: mild steel, machined, black (RULING 6 Sep: steel for mass)

Process: machined, not printed

Part: rim_ring_STEEL

Overall 171.6 x 175.4 x 8.0

Volume 42.47 cm³

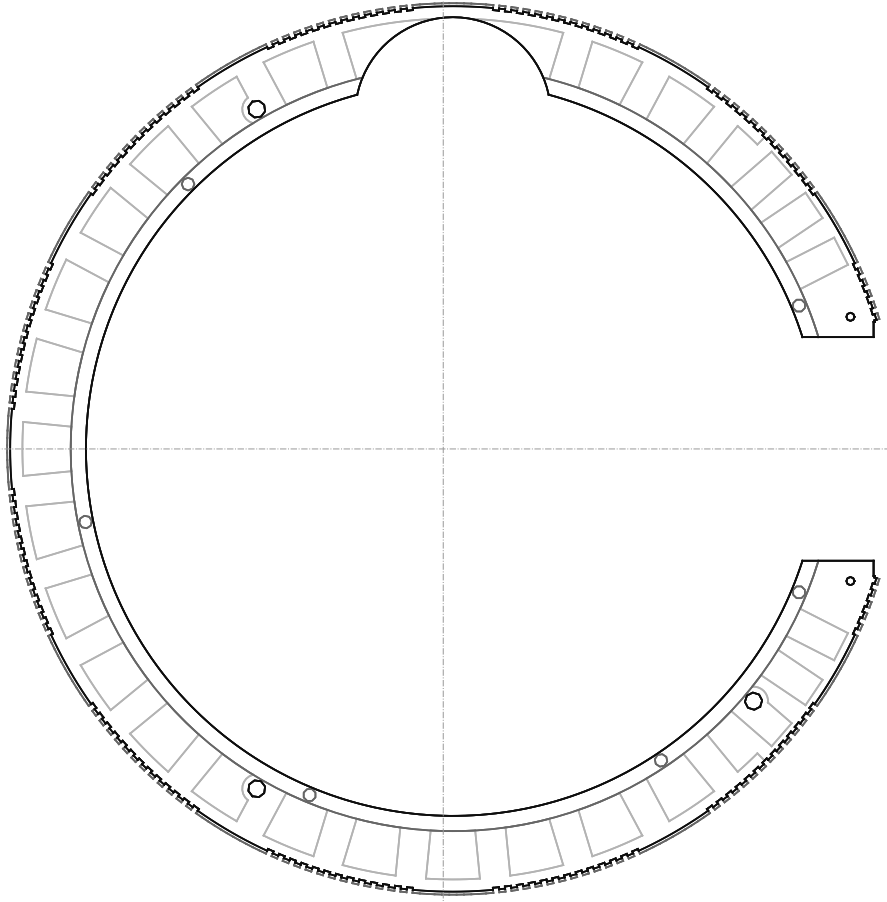
[picture p276: figure]

Key dimensions (from the parameter block):

1. r 75.2-87.7 x 8.0; engine-turned edge: 12 plain blocks 8° wide at 0/30/60..., 156 square grooves 1.2 x 1.0 at 2.4 pitch between them; 1.0 chamfer top and bottom outer edges
2. inward flange r 72.2-75.2, z 4-8, 7 x M3 tapped blind from below at r 73.7, az [22.5, 78.75, 135, 191.25, 247.5, 303.75, 337.5]
3. intake: 1.2 undercut on the bottom outer edge outside r 84.7 over az 45-315, feeding 22 radial grooves 6.0 x 2.0 in the underside (the pad closes them); exhaust: 6 grooves at az [27.0, 34.0, 41.0, 319.0, 326.0, 333.0], opening downward where the pad is cut away
4. 3 x M3 csk from below at r 77.2, az [120, 240, 320] (the structure's pillars); 2 x Ø1.6 tapped M2 at r 78.2, t ±26 (the port face's rail); port slot 44.0 wide

171.6

175.4

8.00

### SECTION A-A (front, plane y = 0; x across, z up)

### SECTION B-B (side, plane x = 0; y across, z up)

### DETAIL C (section A-A, x 56 to 88, enlarged)

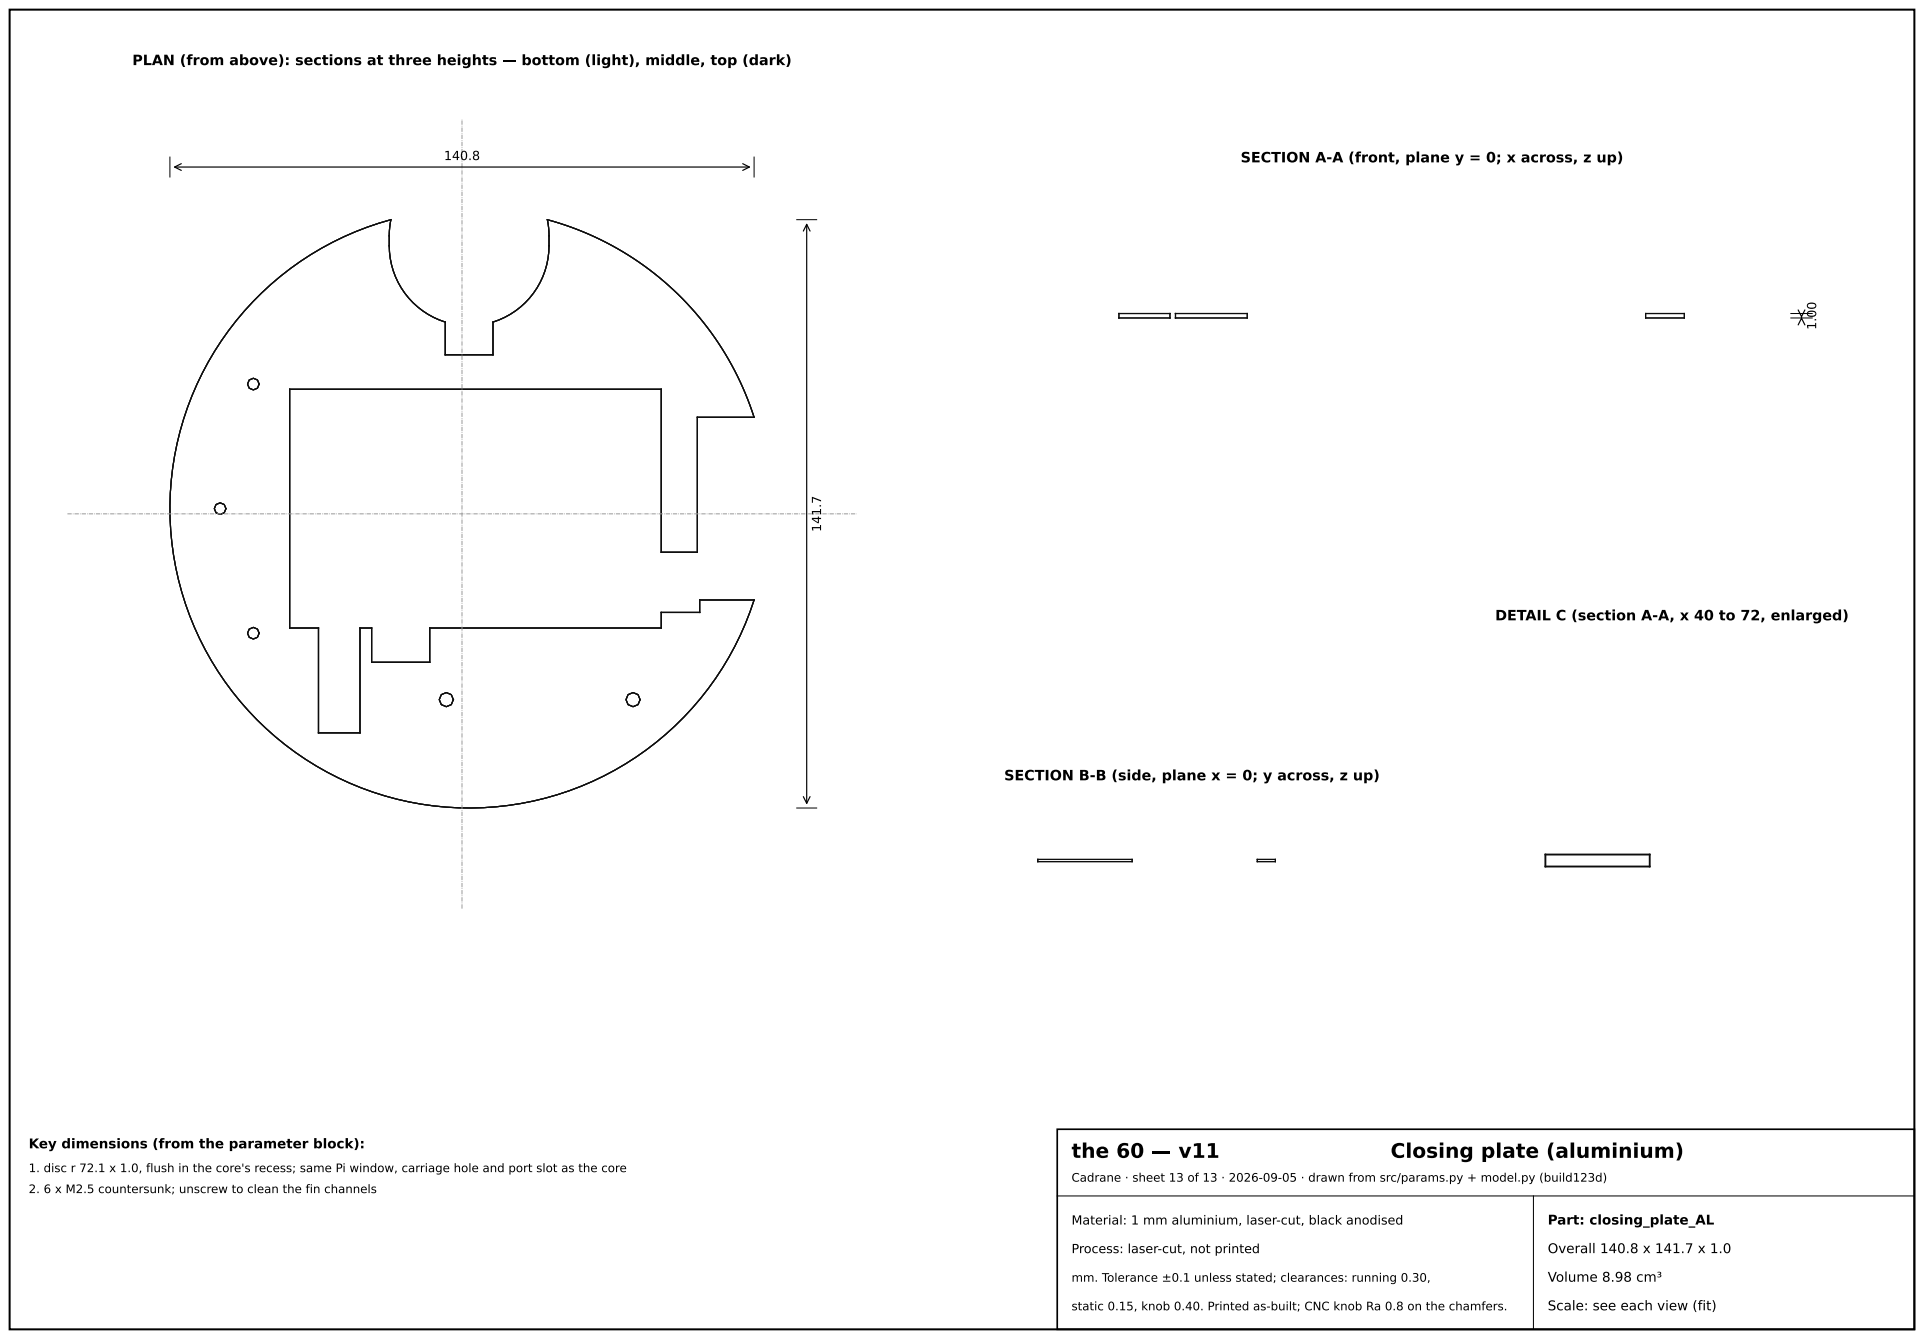
[picture p277: page 14]
the 60; Closing plate (aluminium); Part: closing_plate_AL; Overall 140.8 x 141.7 x 1.0; Volume 8.98 cm³

SECTION A-A (front, plane y = 0; x across, z up)

DETAIL C (section A-A, x 40 to 72, enlarged)

SECTION B-B (side, plane x = 0; y across, z up)

Key dimensions (from the parameter block):

1. disc r 72.1 x 1.0, flush in the core's recess; same Pi window, carriage hole and port slot as the core

Cadrane · sheet 13 of 13 · 2026-09-05 · drawn from src/params.py + model.py (build123d)

2. 6 x M2.5 countersunk; unscrew to clean the fin channels

Material: 1 mm aluminium, laser-cut, black anodised

Process: laser-cut, not printed
