Ryan365Apps/spotify-knob/docs/v16/the60_v16/src/printcheck.py

"""printability check for every printed part, in its print orientation (printorient.PRINT)

For each part it reports, against the usual FDM (fused-filament) design rules:
  - OVERHANG  faces that look downward within 45 deg of straight down and are not on the bed: they need support
              (a face steeper than 45 deg from horizontal supports itself).  Reported per B-rep face, so each
              item is one geometric feature, with its height above the bed and where it is.
  - BRIDGE    a horizontal downward face whose two ends rest on material below it - printable as a bridge up to
              about 20 mm; listed separately from unsupported overhangs where it can be told apart (the face's
              extent is small in one direction and material exists below both ends).
  - SIDE HOLE round holes with a horizontal axis (they print as a sagging roof unless teardropped / small).
  - THIN      walls under 0.8 mm (two 0.4 mm perimeters) and features under 1.2 mm.
  - SMALL TOP a downward face on an island that starts in mid-air (nothing at all below it).
Every figure is from the STEP geometry itself.  Run after export (the knob comes from the knurl cache)."""
import os, sys, math, time
sys.path.insert(0, os.path.dirname(os.path.abspath(__file__)))
from model import *
from printorient import PRINT
from build123d import Face, Solid, Compound, Location, Vector, GeomType

OVERHANG_DEG = 45.0        # a downward face at or under this angle from horizontal needs support
MIN_AREA     = 1.0         # mm2 - ignore smaller downward faces (chamfer tips, tessellation crumbs)
BRIDGE_MAX   = 20.0        # mm - a horizontal face spanning up to this much between supports prints as a bridge

def load_parts():
    knurled = None
    try:
        from knurl import CACHE
        if os.path.exists(CACHE): knurled = import_step(CACHE).solids()[0]
    except Exception: pass
    made = made_parts(knurl=False)
    if knurled is not None: made["knob_body"] = knurled
    out = {}
    for n, (fn, layer, note) in PRINT.items():
        base = board_spacer() if n == "board_spacer" else made[n]
        out[n] = (fn(base), layer, note)
    return out
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
