Ryan365Apps/spotify-knob/docs/v16/the60_v16/src/review_probe.py

"""7 Sep review probes against the v15 model: (1) servo frame clearances (design-changes item 5),
(2) horizontal slices of everything above the plate top, saved as polygons for the free-area map (item 6)."""
import sys, os, time, pickle, math
sys.path.insert(0, os.path.dirname(os.path.abspath(__file__)))
from model import *
from shapely.geometry import Polygon, MultiPolygon
from shapely.ops import unary_union

T0 = time.time()
made = made_parts(knurl=False, engaged=True); bought = bought_parts(True)
allb = {**made, **bought}
print(f"bodies: {len(allb)}  ({time.time()-T0:.0f}s)", flush=True)

# ---------------------------------------------------------------- 1. servo clearances
L = SERVO_L + 1.5
frame_x0, frame_x1 = -1.5, L - 1.5          # local x extent of the frame (end wall to the open end)
frame_y = SERVO_W/2 + 1.0                   # side walls' outer faces
frame_z1 = Z_PLATE_TOP + SERVO_H + 0.5      # frame top
place = polar(MOTOR_AZ, SERVO_R0, 0)
skip = lambda n: n.startswith("servo_") or n == "servo_mount" or n == "base_plate"
def probe_dir(name, mk):
    """mk(s) -> a box in the servo's local frame reaching s beyond the frame's face; report the first hit"""
    for s in [x * 0.25 for x in range(1, 41)]:
        box = place * mk(s)
        hits = []
        for n, b in allb.items():
            if skip(n): continue
            bb = b.bounding_box(); pb = box.bounding_box()
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
