Ryan365Apps/spotify-knob/(commit log)

2026-08-31 Wave 0 results, interaction redesign, design mockups, and tooling
    - BUILD.md: record Wave 0 volume-control findings (phone refuses volume,
    desktop accepts), make the second dial mode a runtime choice, rework the
    interaction model around dial-as-volume with a CONTROLS screen, add R8
    (transfer playback to PC)
    - Move spotify_auth.py into tools/, add tools/check_devices.py
    - Add design/ HTML mockups (screens, dial feedback, idle patterns)
    - Add board schematic PNGs and notes.md
2026-08-31 Firmware skeleton project and BUILD.md decisions
    - Add firmware/knob/: a no-hardware build check that pulls every component
    the real firmware needs, runnable before the board arrives
    - BUILD.md: pin component versions against the registry (2026-08-31),
    drop espressif/button (no push switch on this board), settle play/pause
    as the centre button on CONTROLS, update the risk table
    [partitions.csv]
2026-08-31 Dependency check passed: record known-good component set
    - Restore espressif/button — esp_lvgl_port's knob support includes
    iot_button.h unconditionally, so it is a compile-time dependency even
    with no button on the board
    - BUILD.md: record the resolved component versions from a clean build on
    ESP-IDF v5.5.5, close the version-clash risk, mark Wave 1 complete
2026-08-31 Rename to Radial, endpoint pre-flight, simulator, and commercial docs
    - Rename the project Radial across BUILD.md, design mockups and firmware
    - BUILD.md: add R9 (app shell), R10 (on-device settings), R11 (QR setup),
    record the endpoint pre-flight result — all endpoints this build needs
    pass under Spotify's post-Feb-2026 Client ID restrictions
    - Add tools/preflight_endpoints.py and tools/serve_sim.py
    - Add design/simulator.html: browser simulator with a live Spotify mode
    - Add docs/: commercial feasibility study, brief, premium BOM, and build
    recommendations
2026-09-01 Vision doc, moodboard, and design iteration
    - Add docs/VISION.md: form, halo ring, DAC front-end positioning, and
    roadmap for the productised dial
    - Add docs/moodboard/ reference images (knurling, KEF, Totem, Saab, watch)
    - Iterate design/screens.html and design/simulator.html
    - BUILD.md and PREMIUM-BOM.md updates alongside
2026-09-02 Wave 2 bring-up firmware, the 60 doc set, research, and artwork
    - firmware/knob: display/touch/encoder bring-up code (bidi_knob,
    Waveshare LCD init), plus a stock hello_world reference project
    - Add WAVE-2.md: the board bring-up runbook, moved out of BUILD.md
    - Add CLAUDE.md: repo guidance covering the two tracks (standard build
    vs the 60) and hard rules
    - docs/: the 60 doc set — DECISIONS, CAD-BRIEF, MECHANICAL-REQUIREMENTS,
    RING-MOTOR, DRIVE-MOTOR, SOURCING-BOM, V6C proposal, v7/v7.1 CAD packs,
    SOFTWARE-CONTEXTS and shared-core plan, and the Research/ reports
    (detent haptics, DAC audio, industrial design, UI light/sound, power)
    - design/: artwork pipeline (blender, scripts, exa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
    [the60_lineart.blend]
2026-09-03 Wave 3 network/auth, Wave 4 app shell start, and artwork styles
    - Close Wave 2: WAVE-2.md deleted, findings folded into BUILD.md
    - Add WAVE-3.md (Wi-Fi, NVS-seeded credentials, token refresh, QR
    de-risk) and WAVE-4.md (app shell started early during the Spotify
    rate-limit penalty)
    - firmware/knob: app_shell.h contract, spotify_app.c/.h provider and
    NOW PLAYING skeleton, main.c reshaped into the shell
    - docs: SOFTWARE-HID-CONTRACT.md, SOFTWARE-INTERACTION-CORE.md, and
    shared-core plan updates
    - design: artwork STYLES.md, style examples, new renders excluded via
    .gitignore, moodboard additions
    - Ignore design/artwork/renders/
    [the60_lineart.blend]
2026-09-03 Wave 7 clock/selector/settings apps, Wave 4 progress, mechanism artwork
    - firmware/knob: clock_app, settings_app and the radial selector written
    against knob_app_t; shell, spotify_app and app_shell.h updated to carry
    them; sdkconfig tuning
    - WAVE-7.md: the Clock, timer and selector wave, taken out of order while
    Spotify sits out a rate-limit penalty
    - WAVE-4.md: checkpoint results and the memory investigation
    - HANDOFF-FIRMWARE.md and HANDOFF-SCREENS-REV-X.md for fresh sessions
    - design/artwork: MECHANISMS.html plus the mechanism render set
    - docs/Claude outputs: bought-parts dimensions and layout figures
    [the60_lineart.blend]
2026-09-04 Wave 8 robustness, album art and HID apps, v9 CAD and drawings
    - Close Waves 3, 4 and 7: their docs deleted, results folded into BUILD.md
    - Add WAVE-8.md: live-on-the-desk robustness (reconnect, backoff, soaks)
    - firmware/knob: albumart JPEG decode, bloom renderer, ring widget,
    launcher_app, wispr_app, and the BLE HID layer (enum-only action API,
    no free text ever reaching a keystroke)
    - docs/v9: the60 v9 specification, questions, CAD pack and GA render
    - design/cad: bought-parts STEP library and vendor models
    - design/artwork: v9 mechanism sections, dimensioned drawings D01-D04,
    teaser renders, and the scripts that build them
    - docs: USER-JOURNEY.md, bought-part dimensions, mechanical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
    [623ZZ_bearing_3x10x4.step, AGFRC_C1p5CLS_PRO_linear_servo.step, Abracon_AHCR-S04R0SA206Q_supercap_20F.step, Broadcom_AEDR-8300-1K2_encoder.step, ESS_ES9219Q_WQFN40_5x5.step, GCT_USB4520-03-0-A_usbc_midmount.step, JD-Power_MY-3514C_2804_gimbal_motor.step, MT6701CT-STD_SOP8.step]
2026-09-06 the 60 v10, v11 and v12 CAD and docs: 20 mm rim, heatsink plate, deck-less layout
    v12: no mezzanine deck, every board on the plate, adapter driver board on the Pi's
    standoffs (its holes are the Pi's 58 x 49 pattern), display connect board on a bracket
    over the port slot, code band and wheels dropped to the bell band's limit, seat 28.0,
    height 37.9 (v11 40.7). Adapter datasheet added to the vendor folder. CLAUDE.md index
    updated: v12 is the mechanical authority.
    Claude-Session: https://claude.ai/code/session_01Xpq7ypjVrz1XAcEoAt6M2Q
    [adapter_board.step, audio_board.step, barrel_board.step, base_plate_AL.step, base_plate_AL.stl, base_plate_STEEL.step, base_plate_STEEL.stl, bush_0.step]
2026-09-06 the 60 v13: encoder faces up at a code ring under the crown; seat 26.0, height 35.9
    No code band on the bore, no encoder tower: the AEDR-8300 lies on a boss on the seat
    flange at 310 deg and reads a 0.15 recess in the crown's underside (r 72.5-79.5) at its
    2 mm gap. Bell band back to 9.0-17.8, wheels straight above it; the seat is set by the
    adapter's HDMI socket. CLAUDE.md index: v13 is the mechanical authority.
    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
    [adapter_board.step, audio_board.step, barrel_board.step, base_plate_AL.step, base_plate_AL.stl, base_plate_STEEL.step, base_plate_STEEL.stl, bush_0.step]
2026-09-06 the 60 v14: the design-changes list built - connectors, bare internal faces, grounding, halo current, plain rim edge, pogo board, sensor loop
    Pico-Lock 2.0 mm on every board; core internal faces chromate/bare (no masked pads); one
    chassis bond at (48, 27); the rim ring's dedicated bond screw at az 56.25 with a star washer;
    motor frame bond lead; the knob's 1 MOhm bleed leaf on the seat flange at 200 deg bearing on
    the crown at r 71.5; USB-C shell wire; halo 53 LEDs = 2.54 A computed from the strip; engine
    turning removed, intake grooves 7 x 3.5 = 514 mm2 on a 5 mm shoulder; LRA pogo-pin board in a
    clip; rotor sensor lead with a 12 mm service loop. Height unchanged at 35.9. DESIGN-CHANGES.md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
    [adapter_board.step, audio_board.step, barrel_board.step, base_plate_AL.step, base_plate_AL.stl, base_plate_STEEL.step, base_plate_STEEL.stl, bush_0.step]
2026-09-06 docs: v15 brief - re-proportion the plate, fix the exhaust, settle the rim edge
    The plate's cooling path was costed properly for the first time and it does not
    work: about 70 Pa at 1.0 L/s against a reserved blower good for 10-20. Two
    thirds of that is the 3 mm fin channels and a 147 mm2 exhaust that is a quarter
    of the intake and points at the desk.
    DESIGN-CHANGES.md rewritten as the v15 working list:
    - web 4 -> 2 mm, duct 3 -> 5 mm, total still 8 mm; local thickening downward
    only, and report the plate's deflection rather than assert it
    - fins 3 -> 5 mm tall, direction unchanged (already front-to-rear and correct),
    finned only over the compute module and converter footprints
    - one uni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
2026-09-06 docs: track the four reference documents that were never committed
    CONNECTORS, GROUNDING, HALO-BRIGHTNESS and SYSTEM-REVIEW existed on disk and are
    indexed in CLAUDE.md, but git had never seen them - so a clone had the document
    map without the documents. THERMAL-PLAN.md was in the same state and went in
    with the v15 brief.
    Claude-Session: https://claude.ai/code/session_01X9cGfMd5iMXVK2s3ksvSPw
2026-09-07 the 60 v15: plate 2/5/1 on piers, stainless ring with 108 openings into an underside groove, the blower fitted (Delta BFB0305HA-C on the plate, motion board on its saddle, hood + trench), structure p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
    Also: DESIGN-CHANGES.md edited down to the converter rating and the assumptions; THERMAL-PLAN.md rules 12 and 15 corrected with the v15 report-back; the blower datasheet in the vendor folder; CLAUDE.md index (v15 = mechanical authority).
    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
    [adapter_board.step, audio_board.step, barrel_board.step, base_plate_AL.step, base_plate_STEEL.step, blower_saddle.step, bush_0.step, carriage.step]
2026-09-07 docs/v15: parts, boards and the two assemblies at the top of the folder (Ryan); two stale part files removed
    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
    [adapter_board.step, audio_board.step, barrel_board.step, base_plate_AL.step, base_plate_STEEL.step, blower_saddle.step, bush_0.step, carriage.step]
2026-09-07 the 60 v15 review: no reeding on the ring; openings 2.0 wide and none over the carriage hole (or its mirror); the groove walled off from the hole; lands round the plate screws; fan lead on the Pi's r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
    [adapter_board.step, audio_board.step, barrel_board.step, base_plate_AL.step, base_plate_STEEL.step, blower_saddle.step, bush_0.step, carriage.step]
2026-09-07 the 60 v15 review 2: the halo strip's tail (notch in the wall at az 64, three wires to the motion board), the audio USB-A plug into the USB 3.0 stack (it was in the Ethernet jack), the bracket ear an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
    [adapter_board.step, audio_board.step, barrel_board.step, base_plate_AL.step, blower_saddle.step, bush_0.step, carriage.step, closing_plate_AL.step]
2026-09-07 Design changes: eccentric bush driver access; BOM opens up servo and motor sourcing; order of work in CLAUDE.md
    Claude-Session: https://claude.ai/code/session_01QqUxD3q45ngqMBQYUGeiB3
2026-09-07 Handoff prompt: source a ready-made board for the motion functions
    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
2026-09-07 Index the motion board sourcing prompt
    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
2026-09-07 Rewrite the sourcing prompt: one prototype, device functions not board jobs, ranked preference
    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
2026-09-07 Carrier board sourcing prompt; note that the carrier brief is superseded by the Pi 5
    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
2026-09-07 Sourcing prompt for the small boards, power inlet and harness
    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
2026-09-07 Design changes 4-6: motor hollow shaft dropped, servo not committed, board envelopes in flux
    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
2026-09-08 Layout study: every movable part at Ø175.4 and Ø185.4 with the bought boards, fixings and cables; wheel-preload concept (two fixed wheels, one sprung in a slot); halo section figure
    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
    [review_probe.py]
2026-09-08 the 60 v16: the extra 5 mm of radius, the layout study built in, bought V-groove bearings on a bore ridge with a sprung block, the halo as HALO-OPTICS, the drive collar
    Object 185.4 (189.4 at the halo band), height unchanged at 35.9. Three findings: the wall could only grow 3.6 mm (the halo channel takes the rest); the motor bell would have crossed the halo channel, so a printed drive collar on the bell meets the bore above the ledge (ratio 4.48); the sprung block cannot be released from above, so a captive M2 x 18 screw is reached with an L-key from the display opening (the checker walks the lane).
    Built: three V623ZZ-class V-groove bearings on Ø3 dowel pins riding a male ridge on the bor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
    [adapter_board.step, audio_board.step, barrel_board.step, base_plate_AL.step, base_plate_AL.stl, blower_saddle.step, blower_saddle.stl, board_spacer.step]
2026-09-08 the 60 v16: every M3 fixing becomes M2.5 (Ryan, 8 Sep)
    One screw size above M2, matching the Pi and the other boards. The three plate-to-pillar screws are DIN 7991 M2.5 x 8 into Ø3.5 x 4.0 heat-set inserts (the Ø7 pillars keep 1.75 of wall); the seven rim-ring screws DIN 7991 M2.5 x 8 into M2.5 tapped blind in the ring's flange; the ring bond a DIN 7985 M2.5 x 8 pan through a Ø2.8 clearance into M2.5 tapped 3.0 in the core; the chassis bond M2.5 x 6 tapped blind in its pier; both under DIN 6798 M2.5 star washers. Countersinks Ø4.7 -> 2.7 over 1.0 in place of Ø6.5 -> 3.4 over 1.6. The Ø3 wheel dowels and their washers are not screws and stay. Nothing moved: the ring screws beside the po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
    [base_plate_AL.step, base_plate_AL.stl, internal_structure.step, internal_structure.stl, rim_ring_STEEL.step, rim_ring_STEEL.stl]
2026-09-08 BLE HID transport, halo optics and small-parts sourcing, v15 drawings
    - firmware/knob: BLE HID transport behind hid_transport.h (hid_ble.c),
    boot animation, and shell/app updates around them
    - docs: HALO-OPTICS.md, FUNCTION-ALLOCATION.md, PROTO1-BRIEF.md,
    Outstanding.md, SOFTWARE-PROFILES.md, small-parts sourcing and order
    list, the three board briefs under docs/boards/, halo-optics research
    - docs: VISION, SOURCING-BOM, USER-JOURNEY and BUILD.md rewritten in place
    - design/artwork: v15 drawing set D01-D05, cooling figures, teaser renders
    for v9 through v15, sheet5 and gpu_init scripts
    - design: boot-sequence.html, Pi 5 and panel vendor CAD and datasheets
    - docs/v9: flatten the doubl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
    [base_plate_AL.step, base_plate_STEEL.step, base_plate_STEEL.stl, bush_0.step, bush_0.stl, carriage.step, carriage.stl, collar_0.step]
